3351666087/solar-vest/research/toolchain-survey.md

# Survey of 3D Model Sources and Command-Line PCB Toolchains

> **Date** 2026-10-08 · **Based on** the delivered-items list (CSV) + architecture v3 (6 V / 6 W rigid panel)
> **Markers** ✅ = I actually downloaded or ran it on this machine; 🔎 = documentation found only, not tested; 📏 = needs a dimension from you (calipers or nameplate)

---

## 0. Conclusions

| Question | Conclusion |
|---|---|
| Which 3D models can be found online directly? | **All chips and connectors can be found**, e.g. CN3791, INA226, LM66100, LM74700, AO3401, YJL3404A, SS34, JST-PH/XH. **The XIAO nRF52840 Sense has an official Seeed STEP** ✅. The AEM10941 chip has manufacturer CAD ✅ |
| Which must be built ourselves? | **None of the "module boards" or "complete items" have reliable official models**: panel, battery, supercapacitors, CN3791 module, INA226 module, EVK10941, the BITalino and its enclosure, electrodes, plus the backplate, enclosures and vest. Their shapes are simple; **given dimensions, they can be built in code**, and I have already verified this route on this machine ✅ |
| Can the PCB be developed on a command-line platform? | **Yes.** Recommended: **KiCad 10 + code-described circuit + Freerouting autorouting + kicad-cli to output every file**. Apart from "installing KiCad" and "sending the files for fabrication", everything else can be done by me from the command line |
| Can we get 3D of the PCB? | **Yes, and automatically.** `kicad-cli pcb export step/glb` exports the board together with the 3D of every component on it; the component models come from the two categories above |

**4 things you need to do** (details in Section 9):

1. Install KiCad 10 once (the sandbox blocks brew; you need to run it in a terminal).
2. Tell me the model of the lab's PCB-making machine.
3. Measure a few things with calipers (list in Section 2).
4. Choose a PCB toolchain.

---

## 1. Item-by-item list: where the 3D models come from

### 1.1 Delivered

| Item | Role in the system | 3D source | Status |
|---|---|---|---|
| **6 V / 6 W rigid solar panel** | Main energy source (back) | No generic model; outlines vary widely, so it must be built from the physical item | 📏 Nameplate and outline dimensions, thickness, junction box position, weight. Reference: the Voltaic/Adafruit 6 W panel is 220×175×5 mm, 225 g |
| 395×460 mm 18 V 30 W panel | Not used (bench spare) | Not modelled | — |
| **EVK10941** (AEM10941 evaluation board) | Low-light comparison branch | No 3D for the board; **the AEM10941 chip has manufacturer CAD** (Altium library + Eagle library + schematic snippets) ✅ downloaded. Evaluation board size 76×50 mm (e-peas/Mouser documentation); screw terminals from the official KiCad library | Can be built semi-automatically: board outline + terminals + chip |
| **523450 1000 mAh Li-ion battery** | Main energy storage | No official models for pouch cells | ✅ Built in code (5.2×34×50 mm + protection board), 📏 confirm against the physical item |
| **YJL3404A** | **Confirmed to be an N-channel MOSFET**: 30 V, 5.6 A, SOT-23 (Yangjie). Suitable as the level-shifting transistor for the P-MOS gate | Official KiCad SOT-23 model; LCSC has the same-series YJL3404AQ (C2942683) | 🔎 |
| **2.7 V 10 F supercapacitor ×3** | Hold-up during power loss in the chest unit | Radial electrolytic-capacitor outline, commonly 10×30 or 12.5×20 mm | ✅ Built in code, 📏 measure diameter, height, lead pitch |
| **BITalino ×2 + HeartBIT kit** | ECG acquisition / reference instrument | **No official 3D of the (r)evolution.** PLUX only gives outlines: (r)evolution Plugged about 100×65×6 mm, 3D-printed enclosure 111×69×18 mm. **The Eagle board layout and schematics of the older BITalino V3 are open source** ✅ (PIA-Group/schematics-bitalino); KiCad can import them, but it is not the (r)evolution you have | **Update (same day)**: BITalino officially published the (r)evolution Plugged enclosure STL on Thingiverse; I have built an LOD1 model of the Core board from Figure 8 of the manual. See [modeling/component-modeling-tutorial.md](../modeling/component-modeling-tutorial.md) |
| ECG sensor, PulseSensor and 700 mAh battery in the HeartBIT kit | Included with the kit | Simple geometry | 📏 |
| Disposable ECG electrodes | Attached to the chest | Disc + snap | 📏 Diameter |
| **TEUCER HP600 thermal silicone pad** | Thermal interface between the panel and the electronics (must not go between the panel and the skin) | A thin sheet | 📏 Thickness |
| K-type surface thermocouple ×2 | Thermal safety testing | Small probe; can be simplified to a small block | Optional |
| PH2.0 cables, Dupont wires, heat-shrink tubing and other consumables | Wiring | Cables generated by sweeping along the routing path | Not needed |
| Soldering station, multimeter, thermometer, wire strippers, USB tester, breadboard, board clamp | Tools | Not part of the system model | Not needed |

### 1.2 To be purchased (v3 §7)

| Item | 3D source | Status |
|---|---|---|
| **XIAO nRF52840 Sense ×3** | **Official Seeed STEP** ✅ downloaded (8.8 MB archive, `XIAO-nRF52840 v15.step`). KiCad symbol and footprint in Seeed's official GitHub library ✅. ⚠ The official STEP is Y-up and must be rotated 90° for assembly; I have handled this in the sample | Use directly |
| **CN3791 "6 V version" module ×3** | No reliable model for the module. **The CN3791 chip** (LCSC C154992, SSOP-10) has 3D on EasyEDA | Board outline from measurement, real model for the chip, 📏 measure the module. The 9 V version found online is 45×20×9.5 mm; the 6 V version may differ |
| **INA226 module ×4** | No reliable model for the module. **INA226 chip** (LCSC C49851) ✅ STEP downloaded | Same as above, 📏 |
| 1S 2500 mAh Li-ion battery | Build from the model's dimensions | 📏 Measure once bought |
| AO3401 / AO3400 | Official KiCad SOT-23; LCSC C15127 etc. | 🔎 |
| LM66100 (battery side) | LCSC C2869734, SC-70-6 | 🔎 |
| SS34, SMAJ8.5A | Official KiCad SMA footprint | 🔎 |
| LM74700 + N-MOS (Rev B) | LCSC C2941042, SOT-23-6 | 🔎 |
| PPTC / fuse, NTC | Official KiCad library | 🔎 |
| JST-XH / JST-PH connectors | Official KiCad library; JST-XH 2P (LCSC C158012) ✅ downloaded | Use directly |
| Reference cell ×2 | Small cells, build from dimensions | 📏 |
| Magnetic connector (J6 pull-out protection) | Find manufacturer CAD once the part number is chosen; major manufacturers usually provide STEP | Part number not yet chosen |
| ADS1292R / MAX86150 evaluation boards | 🔎 No downloadable 3D found (TI/ADI usually only provide schematics and Gerbers); build an envelope from the user guide's dimensions | 📏 |
| Vest, backplate, standoff feet, two enclosures | **Custom parts; must be designed ourselves.** Your body scan can be used as a dress form to fit the curved surface (last time we measured a panel bow height of 42 mm and standoffs of 18–28 mm) | Modelled in code by me |

### 1.3 Already verified for you

| Item verified | Result |
|---|---|
| Downloading the official Seeed XIAO STEP | ✅ Succeeded, imported into the assembly |
| `easyeda2kicad` fetching models by LCSC part number | ✅ INA226 (C49851) and JST-XH (C158012) succeeded. Downloads for the other part numbers were cut off by the sandbox network (IncompleteRead) and later rate-limited by the API (403). **The tool itself works**; it will not have this problem on your own computer |
| e-peas AEM10941 CAD package | ✅ Downloaded: Altium integrated library, PcbLib, Eagle library, schematic snippets, BOM |
| Building parametric models in code | ✅ Generated STEP files for the battery, supercapacitor, panel and the two modules with build123d 0.13 |
| Combining official and self-built models into an assembly | ✅ The "panel + battery + CN3791 module + XIAO" assembly exported to STEP and GLB (GLB can go straight into a web 3D viewer) |

Sample files are in [toolchain-samples/](toolchain-samples/). Every dimension in `parametric-models/parts.py` is a named parameter; once the physical item is measured, change one number.

---

## 2. Things we model ourselves: please measure these dimensions

| Item | Dimensions needed |
|---|---|
| 6 V 6 W panel | Length, width, thickness; whether it has a frame; junction box position and size; mounting holes; weight |
| 523450 battery (and later the 2500 mAh) | Length, width, thickness; length of the protection-board section; lead exit position |
| Supercapacitor | Diameter, height, lead pitch |
| CN3791 module, INA226 module | Board length and width; height of the tallest component; hole and terminal positions (one top-down photo with a ruler is enough) |
| EVK10941 | Check 76×50 mm, terminal orientation |
| BITalino (with enclosure) | Enclosure length, width, height; connector cut-out positions |
| Electrodes, reference cells, thermal pad | Diameter / length and width, thickness |

> For dimensions I am unsure of, I will use documented values first and flag them in the model; they will be replaced once the physical items are measured.

---

## 3. Which PCBs to make

Following the v3 split topology (ADR-007), there are 2 boards, plus 1 optional small board:

| Board | Location | Function | Complexity |
|---|---|---|---|
| **PMB-H** | Back | Panel input protection (fuse, TVS, diode) → CN3791 module; dual-battery switching; 4× INA226 (addresses 0x40 panel, 0x41 battery, 0x42 load, 0x44 reference cell); XIAO Sense; Q0 charge switch (on by default, to avoid a cold-start deadlock); NTC; J6 cable port | Moderate. **Rev A is built as a "module carrier board"**: CN3791, INA226 and XIAO all plug in as off-the-shelf modules, and the board itself only has connectors, MOSFETs and a few resistors and capacitors |
| **LIB** | Chest | Supercapacitor hold-up, load switch, sync-pulse injection into BITalino I1, ESD, JST-PH to the BITalino | Simple, about 25×20 mm |
| REF (optional) | Panel frame | Sense resistor and wiring for the reference cell | Minimal; can also be merged directly into the PMB-H |

All are 2-layer boards with low-speed signals; the finest parts are SOT-23 and 0603 passives, so **both the lab's PCB machine and JLCPCB can make them**.

---

## 4. Command-line PCB toolchains: findings

| Tool | What it does | Fully command-line? | Tested on this machine | Caveats |
|---|---|---|---|---|
| **KiCad 10** (released 2026-03-20) + `kicad-cli` | Industry-standard open-source EDA | **Output generation is fully command-line**: ERC, DRC, Gerber, drill, placement, BOM, plus **STEP / GLB / STL / VRML 3D export**, ray-traced rendering, jobset batch processing | ❌ Not installed on this machine | `kicad-cli` has **no** "update PCB from netlist" and **no** "export DSN / autoroute". These two steps need KiCad's built-in Python interface: the SWIG interface still works in 10 and will be removed in 11; the new IPC interface uses `kicad-python` 0.8 |
| **SKiDL** 2.3 | Write circuits in Python; generates the netlist and initial PCB | ✅ | Not tested | Fully offline, no account needed; auto-generated schematic layout is mediocre |
| **atopile** 0.15.9 | Declarative circuit language with automatic part selection; compiles to a KiCad PCB | ✅ `ato build` | ✅ **Compiled successfully and produced a `.kicad_pcb`**; but **automatic part selection requires login** (`ato auth login`), and newer versions are moving to app.atopile.io | Requires registering an account; **I cannot register for you** |
| **tscircuit** | Write circuits in TypeScript/React; **built-in autorouting**; exports Gerber, BOM, pick-and-place, GLB/STEP and KiCad files; can import parts by JLCPCB part number | ✅ `tsci` | ❌ **Could not be installed on this machine**: it requires **Node 24** (this machine has 22), and its image library dependency sharp downloads a binary from GitHub during installation, which the sandbox network blocks. It should work once Node 24 is installed on your own computer, but this is untested | Still at version 0.x and evolving quickly; risky for a switch-mode power board; well suited to a small board like the LIB |
| **Freerouting** v2.5.0 (2026-10-05) | Autorouter | ✅ `java -jar freerouting.jar -de x.dsn -do x.ses`; there is also an MCP server | Not tested | Java on this machine is 17; if that is not enough, use its macOS installer with the bundled runtime |
| **KiBot** 1.9 | Describes all outputs (Gerber, 3D, BOM, interactive BOM, renders) in a single config and rebuilds them with one command | ✅ | Not tested | Well suited to GitHub Actions, generating the full set of files on every commit |
| **easyeda2kicad** 1.0.1 / **JLC2KiCadLib** | Download symbols, footprints and **STEP/WRL 3D** by LCSC part number | ✅ | ✅ Downloaded successfully | The API is occasionally rate-limited |
| **KiCad MCP servers** (e.g. mixelpixx/KiCAD-MCP-Server) | Wrap KiCad as 100+ AI tools: place parts, route, DRC, export | ✅ | Not tested | Community projects of mixed quality; usable as a fallback, not required |
| **build123d** 0.13 / CadQuery | Write mechanical 3D in Python: panel, enclosures, backplate | ✅ | ✅ Generated STEP/GLB | — |
| JLCPCB EDA (EasyEDA), Flux.ai, Altium | GUI or browser tools | ❌ No command line | — | Not suitable for me to drive |
| JLCPCB ordering API | Upload Gerbers, get quotes, place orders | Has an API, but **only available to approved business customers** | — | Individuals still upload Gerbers on the website; you click this step |

---

## 5. Recommended pipeline

```
Circuit description (code, under Git)
   │  SKiDL (offline) or atopile (needs an account)
   ▼
Netlist + initial .kicad_pcb (all parts off-board, ratsnest only)
   │  Python placement script: mechanical constraints (board outline, holes, connector orientation) written as coordinates
   │  Switching loops (CN3791 periphery, shunt-resistor Kelvin traces) routed precisely by hand / script
   ▼
Freerouting autoroutes the remaining signal traces (DSN → SES)
   ▼
kicad-cli: if ERC / DRC fails, go back one step
   ▼
kicad-cli / KiBot outputs the full set:
   ├─ Gerber + drill → lab PCB machine or JLCPCB
   ├─ BOM + pick-and-place (if using contract assembly)
   ├─ PDF schematics, assembly drawings (for the supervisor and the lab)
   ├─ Rendered PNGs (which I use to self-check the layout)
   └─ STEP / GLB 3D (component models from Section 1)
   ▼
build123d final assembly: panel + backplate + PMB-H enclosure + cables + LIB enclosure + BITalino
   ▼
GLB → the existing 3D vest web page (replacing the current placeholder blocks)
```

**What I can and cannot do:**

- ✅ **I can**: write the circuit code; write placement and routing scripts; run autorouting and ERC/DRC; export all manufacturing files and 3D; produce renders for self-checking; do 3D modelling of all custom parts; do the final assembly and the web 3D.
- ❌ **You need to**: install KiCad; register an account (if choosing atopile); operate the lab's PCB machine; place and pay for the JLCPCB order; solder.
- ⚠ **Where quality will suffer**: the autorouter does not understand switch-mode power supplies. So the CN3791 power loop and the shunt-resistor Kelvin traces **must be routed precisely by script according to rules**, not left to Freerouting. After generating outputs I will attach renders, and you or the lab supervisor can take another look in the KiCad GUI.

---

## 6. Fabrication: lab machine vs. JLCPCB

| | Lab PCB machine | JLCPCB |
|---|---|---|
| Input | Depends on the machine type: a **CNC engraver** needs Gerber converted to G-code (pcb2gcode / FlatCAM, open source, not tested this time); **exposure / laser** needs a mirrored PDF or SVG (`kicad-cli pcb export pdf/svg` produces it directly) | Gerber zip archive, uploaded on the website |
| Capability | Unknown ❓. Without plated through-holes or solder mask, rules must be relaxed (trace width and clearance ≥ 0.3 mm, rivets for vias) | 2-layer / 4-layer, ENIG, solder mask all available; assembly service available |
| Lead time | Same day | 3–7 days |
| Recommendation | **Make the Rev A carrier board in the lab**: all large pads, quick to modify | **Send Rev B and the small LIB board to JLCPCB**: the small board needs higher precision, and since it is worn against the body it also needs solder mask and ENIG to resist sweat |

> **Please confirm: the brand and model of the lab's PCB machine.** A CNC engraver and an exposure/etching line need completely different design rules; I will set trace width, clearance and via method according to the machine's capability.

---

## 7. Combining into a full-system 3D model

1. Each part becomes one STEP: official models (Section 1 ✅), self-built models (Section 2), PCB exports (Section 5).
2. Assemble with build123d at the measured positions: panel upper and lower edges at 156.5 / 139.5 cm, standoffs 18–28 mm, J6 cable route.
3. Export GLB to replace the placeholder blocks in the existing 3D vest web page.

⚠ **Body model**: your scan or an inferred body can be used to fit the curved surface of the backplate, but that is your body-shape data. **I will ask you before publishing it to a web page**; a generic dress form is used by default.

---

## 8. Things verified or corrected along the way in this survey

| Item | Before | Now | Source |
|---|---|---|---|
| AEM10941 input limit | ⚠ "about ≤ 5 V, from memory" | ✅ **Open-circuit voltage up to 5.0 V**, cold start at 3 µW / 380 mV. Limitation 5 in v3 can be closed | e-peas website |
| AEM10941 package | v1 said QFN-40 | **QFN28 5×5 mm** (does not change the conclusion: it still cannot be hand-soldered) | e-peas website |
| YJL3404A | ❓ only known to be a MOSFET | **N-channel, 30 V / 5.6 A, SOT-23**, R<sub>DS(on)</sub> < 40 mΩ @ 4.5 V | Datasheet |
| HeartBIT kit | Contents unverified | Core BT/BLE, ECG sensor (30 cm leads), PulseSensor, (r)evolution enclosure, **700 mAh Li-ion battery**, 25 electrodes, USB cable, Bluetooth adapter | PLUX website |
| Armpit height → J6 cable length | 117 / 83 cm | 102 / 64 cm (corrected last time); the conclusion to buy 1.2 m is unchanged | Body scan |

---

## 9. Next steps: decisions needed from you

| # | Question | My recommendation |
|---|---|---|
| 1 | Which circuit-description tool? | **KiCad 10 + SKiDL**: fully offline, no account, and the resulting standard KiCad project can be opened in the GUI by both the lab and the supervisor. tscircuit needs Node 24 installed first; once installed I will try it on the small LIB board and roll it out if it works well. Choose atopile only if you are willing to register an account |
| 2 | Install KiCad 10 | Run `brew install --cask kicad` in a terminal (the sandbox won't let me install it). Once installed I will first run `kicad-cli version` to confirm |
| 3 | Model of the lab's PCB machine | Take a photo of the machine's nameplate or model number |
| 4 | Dimensions from Section 2 | Measure whatever you can; for anything not measured I will use documented values and flag them |

---

## References

- Seeed XIAO nRF52840 wiki page (including 3D model, KiCad project): https://wiki.seeedstudio.com/XIAO_BLE/
- Seeed official KiCad library: https://github.com/Seeed-Studio/OPL_Kicad_Library
- e-peas AEM10941 (datasheet, EVK manual, CAD package): https://e-peas.com/product/aem10941/
- PLUX HeartBIT: https://www.pluxbiosignals.com/products/heartbit
- PLUX (r)evolution 3D-printed enclosure: https://pluxbiosignals.com/products/3d-printed-casing-for-revolution-board
- BITalino V3 open-source board files: https://github.com/PIA-Group/schematics-bitalino
- LCSC: CN3791 C154992 https://www.lcsc.com/product-image/C154992.html ; INA226AIDGSR C49851 https://www.lcsc.com/product-image/C49851.html ; LM66100DCKR C2869734 https://fat.lcsc.com/product-image/C2869734.html ; LM74700QDBVRQ1 C2941042 https://fat.lcsc.com/product-detail/C2941042.html
- YJL3404AQ (JLCPCB C2942683): https://jlcpcb.com/partdetail/3323357-YJL3404AQ/C2942683 ; YJL3404A datasheet: https://static.chipdip.ru/lib/076/DOC013076228.pdf
- Adafruit 6 V 6 W panel (dimension reference): https://www.adafruit.com/products/1525
- KiCad 10 release: https://www.kicad.org/blog/2026/03/Version-10.0.0-Released/
- kicad-cli documentation: https://docs.kicad.org/10.0/en/cli/cli.html
- KiCad Python / IPC interfaces: https://dev-docs.kicad.org/en/apis-and-binding/pcbnew/
- KiBot 3D export: https://kibot.readthedocs.io/en/latest/configuration/outputs/export_3d.html
- atopile: https://pypi.org/p/atopile
- tscircuit: https://github.com/tscircuit/tscircuit
- easyeda2kicad: https://github.com/uPesy/easyeda2kicad.py
- Freerouting: https://github.com/freerouting/freerouting
- KiCad MCP Server: https://github.com/MJP-Sys/kicad-mcp-server , https://mcpservers.org/ja/servers/mixelpixx/kicad-mcp-server
- JLCPCB API documentation: https://api.jlcpcb.com/help/article/jlcpcb-online-api-available-now
