3351666087/solar-vest/hardware/vest/pattern_accessories_A4-tiled.pdf

## P1 胸前仓口袋（B）袋面+风琴边

500D ×1（四角剪口后折成立体袋），附件：口袋 / 内袋 / 面板遮挡罩

布纹线与布边平行，实线=裁剪线，蓝虚线=净缝线，包边处无缝份

P1 胸前仓口袋（B）袋面+风琴边 第 A1 页 / 共 1×1 ，灰虚线内 10 mm 为重叠区，对齐后粘贴，附件：口袋 / 内袋 / 面板遮挡罩

校验 50 × 50 mm（打印时选'实际大小'）

## P1 袋盖

500D ×2（正反合缝）+ 魔术贴 75×20，附件：口袋 / 内袋 / 面板遮挡罩

布纹线与布边平行，实线=裁剪线，蓝虚线=净缝线，包边处无缝份

P1 袋盖 第 A1 页 / 共 1×1 ，灰虚线内 10 mm 为重叠区，对齐后粘贴，附件：口袋 / 内袋 / 面板遮挡罩

校验 50 × 50 mm（打印时选'实际大小'）

## P2 HeartBIT 袋（A）袋面+风琴边

500D ×1，附件：口袋 / 内袋 / 面板遮挡罩

布纹线与布边平行，实线=裁剪线，蓝虚线=净缝线，包边处无缝份

P2 HeartBIT 袋（A）袋面+风琴边 第 A1 页 / 共 1×1 ，灰虚线内 10 mm 为重叠区，对齐后粘贴，附件：口袋 / 内袋 / 面板遮挡罩

校验 50 × 50 mm（打印时选'实际大小'）

## P2 袋盖

500D ×2 + 魔术贴，附件：口袋 / 内袋 / 面板遮挡罩

布纹线与布边平行，实线=裁剪线，蓝虚线=净缝线，包边处无缝份

P2 袋盖 第 A1 页 / 共 1×1 ，灰虚线内 10 mm 为重叠区，对齐后粘贴，附件：口袋 / 内袋 / 面板遮挡罩

校验 50 × 50 mm（打印时选'实际大小'）

## P3 Board 袋（C）袋面+风琴边

500D ×1，附件：口袋 / 内袋 / 面板遮挡罩

布纹线与布边平行，实线=裁剪线，蓝虚线=净缝线，包边处无缝份

P3 Board 袋（C）袋面+风琴边 第 A1 页 / 共 2×1 ，灰虚线内 10 mm 为重叠区，对齐后粘贴，附件：口袋 / 内袋 / 面板遮挡罩

校验 50 × 50 mm（打印时选'实际大小'）

布纹线与布边平行，实线=裁剪线，蓝虚线=净缝线，包边处无缝份

P3 Board 袋（C）袋面+风琴边 第 A2 页 / 共 2×1 ，灰虚线内 10 mm 为重叠区，对齐后粘贴，附件：口袋 / 内袋 / 面板遮挡罩

## P3 袋盖

500D ×2 + 魔术贴，附件：口袋 / 内袋 / 面板遮挡罩

布纹线与布边平行，实线=裁剪线，蓝虚线=净缝线，包边处无缝份

P3 袋盖 第 A1 页 / 共 1×1 ，灰虚线内 10 mm 为重叠区，对齐后粘贴，附件：口袋 / 内袋 / 面板遮挡罩

校验 50 × 50 mm（打印时选'实际大小'）

## P4 手机袋 袋面+风琴边

500D ×1，附件：口袋 / 内袋 / 面板遮挡罩

布纹线与布边平行，实线=裁剪线，蓝虚线=净缝线，包边处无缝份

P4 手机袋 袋面+风琴边 第 A1 页 / 共 1×1 ，灰虚线内 10 mm 为重叠区，对齐后粘贴，附件：口袋 / 内袋 / 面板遮挡罩

校验 50 × 50 mm（打印时选'实际大小'）

## P4 袋盖

500D ×2 + 魔术贴，附件：口袋 / 内袋 / 面板遮挡罩

布纹线与布边平行，实线=裁剪线，蓝虚线=净缝线，包边处无缝份

P4 袋盖 第 A1 页 / 共 1×1 ，灰虚线内 10 mm 为重叠区，对齐后粘贴，附件：口袋 / 内袋 / 面板遮挡罩

校验 50 × 50 mm（打印时选'实际大小'）

## P5 热电偶插头袋

500D ×1，附件：口袋 / 内袋 / 面板遮挡罩

布纹线与布边平行，实线=裁剪线，蓝虚线=净缝线，包边处无缝份

P5 热电偶插头袋 第 A1 页 / 共 1×1 ，灰虚线内 10 mm 为重叠区，对齐后粘贴，附件：口袋 / 内袋 / 面板遮挡罩

校验 50 × 50 mm（打印时选'实际大小'）

## P5 袋盖

500D ×2 + 魔术贴，附件：口袋 / 内袋 / 面板遮挡罩

布纹线与布边平行，实线=裁剪线，蓝虚线=净缝线，包边处无缝份

P5 袋盖 第 A1 页 / 共 1×1 ，灰虚线内 10 mm 为重叠区，对齐后粘贴，附件：口袋 / 内袋 / 面板遮挡罩

校验 50 × 50 mm（打印时选'实际大小'）

## P6 ECG 传感器内袋（里布侧）

弹力网布 ×1，三边车缝，开口朝上，附件：口袋 / 内袋 / 面板遮挡罩

布纹线与布边平行，实线=裁剪线，蓝虚线=净缝线，包边处无缝份

P6 ECG 传感器内袋（里布侧） 第 A1 页 / 共 1×1 ，灰虚线内 10 mm 为重叠区，对齐后粘贴，附件：口袋 / 内袋 / 面板遮挡罩

校验 50 × 50 mm（打印时选'实际大小'）

## 面板遮挡罩（TC-24 遮光 / TC-03b ND 网 / TC-21 面料）

每种面料各 ×1；四角车成盒角，边缘穿 3 mm 松紧绳，附件：口袋 / 内袋 / 面板遮挡罩

布纹线与布边平行，实线=裁剪线，蓝虚线=净缝线，包边处无缝份

面板遮挡罩（TC-24 遮光 / TC-03b ND 网 / TC-21 面料） 第 A1 页 / 共 3×2 ，灰虚线内 10 mm 为重叠区，对齐后粘贴，附件：口袋 / 内袋 / 面板遮挡罩

校验 50 × 50 mm（打印时选'实际大小'）

## 面板遮挡罩（TC-24 遮光 / TC-03b ND 网 / TC-21 面料）

每种面料各 ×1；四角车成盒角，边缘穿 3 mm 松紧绳，附件：口袋 / 内袋 / 面板遮挡罩

布纹线与布边平行，实线=裁剪线，蓝虚线=净缝线，包边处无缝份

面板遮挡罩（TC-24 遮光 / TC-03b ND 网 / TC-21 面料） 第 A2 页 / 共 3×2 ，灰虚线内 10 mm 为重叠区，对齐后粘贴，附件：口袋 / 内袋 / 面板遮挡罩

面板遮挡罩（TC-24 遮光 / TC-03b ND 网 / TC-21 面料） 第 A3 页 / 共 3×2 ，灰虚线内 10 mm 为重叠区，对齐后粘贴，附件：口袋 / 内袋 / 面板遮挡罩

面板遮挡罩（TC-24 遮光 / TC-03b ND 网 / TC-21 面料） 第 B1 页 / 共 3×2 ，灰虚线内 10 mm 为重叠区，对齐后粘贴，附件：口袋 / 内袋 / 面板遮挡罩

面板遮挡罩（TC-24 遮光 / TC-03b ND 网 / TC-21 面料） 第 B2 页 / 共 3×2 ，灰虚线内 10 mm 为重叠区，对齐后粘贴，附件：口袋 / 内袋 / 面板遮挡罩

面板遮挡罩（TC-24 遮光 / TC-03b ND 网 / TC-21 面料） 第 B3 页 / 共 3×2 ，灰虚线内 10 mm 为重叠区，对齐后粘贴，附件：口袋 / 内袋 / 面板遮挡罩
