3351666087/solar-vest/body/cross-sections_122_113_95.png

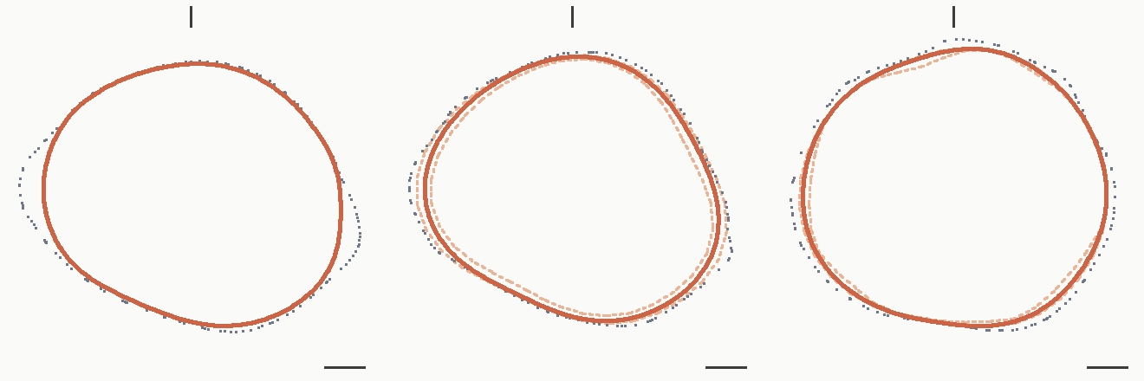
body/cross-sections_122_113_95.png
