3351666087/solar-vest/body/dressed-vs-bare_three-views.png

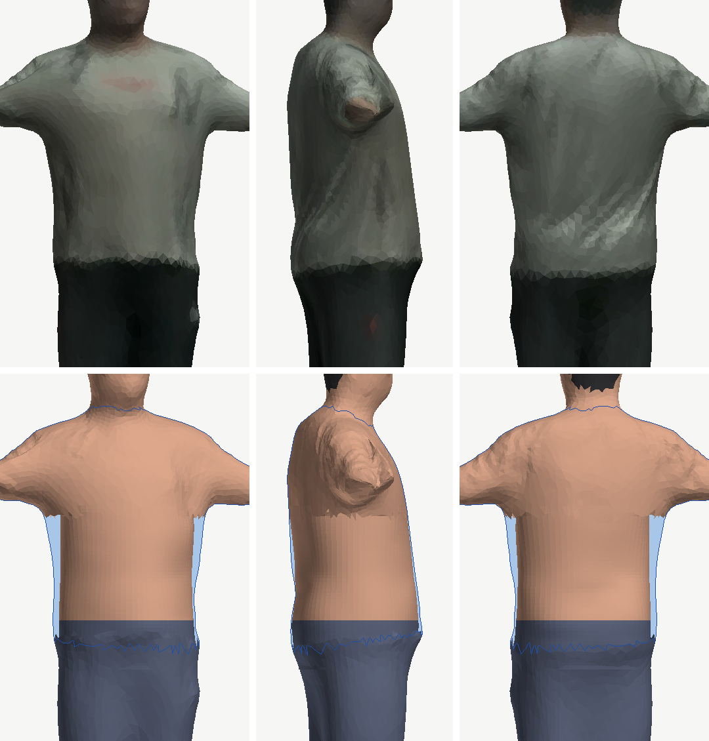
body/dressed-vs-bare_three-views.png
