3351666087/solar-vest/hardware/pcb/LIB_JLCPCB-final-placement_SMT2610130082.jpg

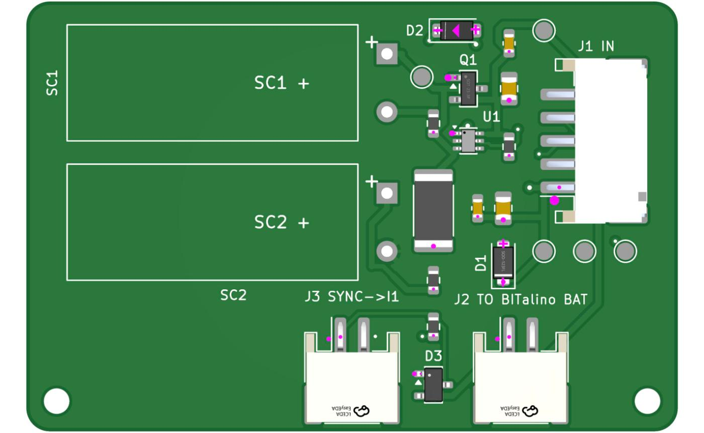
hardware/pcb/LIB_JLCPCB-final-placement_SMT2610130082.jpg
