3351666087/solar-vest/hardware/pcb/libb/libb_render_iso.png

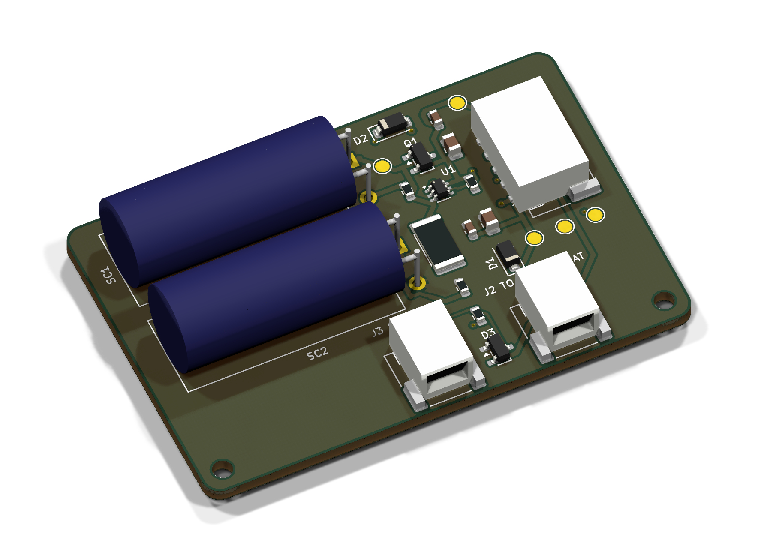
hardware/pcb/libb/libb_render_iso.png
