3351666087/solar-vest/hardware/pcb/libb/libb_render_top.png

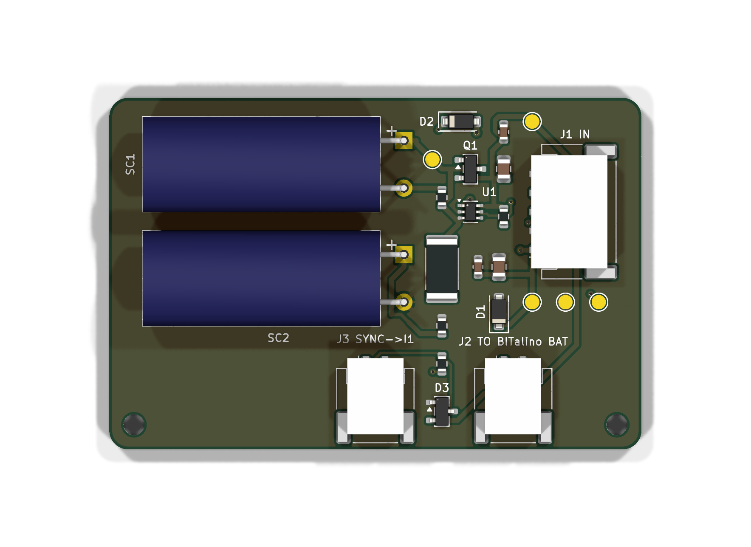
hardware/pcb/libb/libb_render_top.png
