3351666087/solar-vest/hardware/pcb/PMB-H_JLCPCB-final-placement_SMT2610130032.jpg

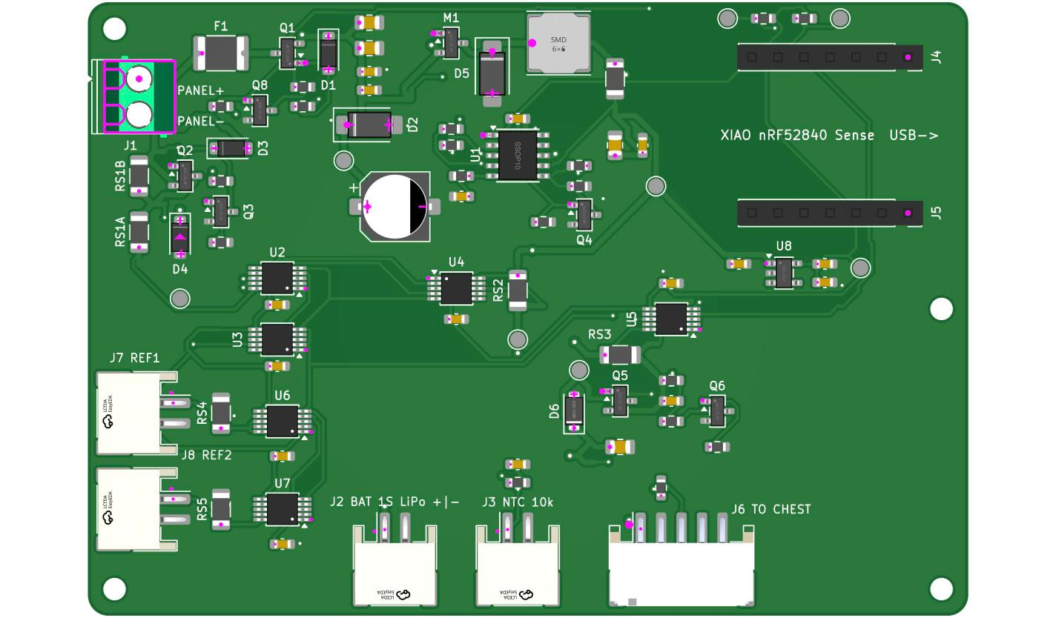
hardware/pcb/PMB-H_JLCPCB-final-placement_SMT2610130032.jpg
