3351666087/solar-vest/hardware/pcb/pmbh/pmbh_render_bottom.png

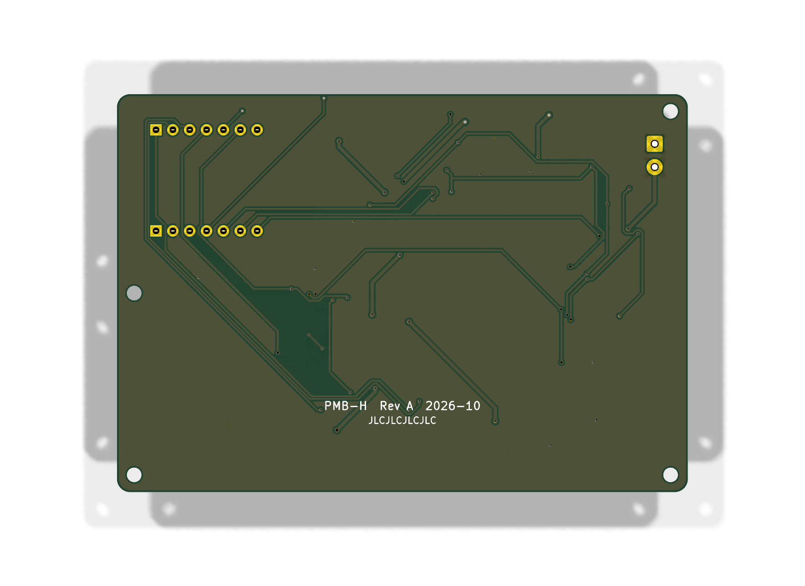
hardware/pcb/pmbh/pmbh_render_bottom.png
