3351666087/solar-vest/hardware/pcb/libb/libb_BOM_JLC.csv

Comment | Designator | Footprint | LCSC Part # | Qty | JLC library
22u 25V | C1,C3 | C_0805_2012Metric | C45783 | 2 | Basic
100n | C2,C4 | C_0603_1608Metric | C14663 | 2 | Basic
SMF5.0A | D1 | D_SOD-123F | C193402 | 1 | Extended
B5819W | D2 | D_SOD-123 | C8598 | 1 | Basic
BAT54S | D3 | SOT-23 | C47546 | 1 | Extended
PH2.0 5P | J1 | JST_PH_S5B-PH-SM4-TB_1x05-1MP_P2.00mm_Horizontal | C265104 | 1 | Extended
PH2.0 2P | J2,J3 | JST_PH_S2B-PH-SM4-TB_1x02-1MP_P2.00mm_Horizontal | C295747 | 2 | Extended
AO3401A | Q1 | SOT-23 | C15127 | 1 | Basic
100k | R1,R3,R4 | R_0603_1608Metric | C25803 | 3 | Basic
33 1W | R2 | R_2512_6332Metric | C53728 | 1 | Extended
1k | R5 | R_0603_1608Metric | C21190 | 1 | Basic
LM66100DCKR | U1 | SOT-363_SC-70-6 | C2869734 | 1 | Extended
