3351666087/solar-vest/hardware/pcb/pmbh/pmbh_BOM_JLC.csv

Comment | Designator | Footprint | LCSC Part # | Qty | JLC library
22u 25V | C1,C2,C7,C11 | C_0805_2012Metric | C45783 | 4 | Basic
1u 50V | C3,C10,C12,C13 | C_0603_1608Metric | C15849 | 4 | Basic
100n | C4,C5,C8,C9,C20,C30,C40,C50,C60,C70 | C_0603_1608Metric | C14663 | 10 | Basic
220n | C6 | C_0603_1608Metric | C21120 | 1 | Basic
10u 10V | C14 | C_0603_1608Metric | C19702 | 1 | Basic
100u 35V | C15 | CP_Elec_6.3x7.7 | C2836437 | 1 | Extended
BZT52C10 | D1,D3 | D_SOD-123 | C173431 | 2 | Extended
SMAJ10A | D2 | D_SMA | C134939 | 1 | Extended
B5819W | D4 | D_SOD-123 | C8598 | 1 | Basic
SS34 | D5 | D_SMA | C8678 | 1 | Basic
SMF5.0A | D6 | D_SOD-123F | C193402 | 1 | Extended
1.5A 16V | F1 | Fuse_1812_4532Metric | C883152 | 1 | Extended
KF350-3.5-2P | J1 | TerminalBlock_Phoenix_PT-1,5-2-3.5-H_1x02_P3.50mm_Horizontal | C474892 | 1 | Extended
PH2.0 2P | J2,J3,J7,J8 | JST_PH_S2B-PH-SM4-TB_1x02-1MP_P2.00mm_Horizontal | C295747 | 4 | Extended
PM254-1-07-Z-8.5 | J4,J5 | PinSocket_1x07_P2.54mm_Vertical | C2897370 | 2 | Extended
PH2.0 5P | J6 | JST_PH_S5B-PH-SM4-TB_1x05-1MP_P2.00mm_Horizontal | C265104 | 1 | Extended
22uH 1.8A | L1 | L_Sunlord_SWPA6045S | C83454 | 1 | Extended
AO3401A | M1,Q1,Q5 | SOT-23 | C15127 | 3 | Basic
AO3400A | Q2,Q3,Q4,Q6,Q8 | SOT-23 | C20917 | 5 | Basic
22k | R1 | R_0603_1608Metric | C31850 | 1 | Basic
100k | R2,R3,R7,R9,R10,R12,R14,R20 | R_0603_1608Metric | C25803 | 8 | Basic
120 | R4 | R_0603_1608Metric | C22787 | 1 | Basic
200k | R5 | R_0603_1608Metric | C25811 | 1 | Basic
51k | R6 | R_0603_1608Metric | C23196 | 1 | Basic
0.1 1W 1% | R8,RS3 | R_1206_3216Metric | C2903496 | 2 | Extended
10k | R11,R13 | R_0603_1608Metric | C25804 | 2 | Basic
1k | R15 | R_0603_1608Metric | C21190 | 1 | Basic
4.7k | R17,R18 | R_0603_1608Metric | C23162 | 2 | Basic
1M | R19 | R_0603_1608Metric | C22935 | 1 | Basic
0.05 1W 1% | RS2,RS1A | R_1206_3216Metric | C2904224 | 2 | Extended
0.47 1% | RS4,RS5 | R_1206_3216Metric | C28320 | 2 | Extended
0.22 1W 1% | RS1B | R_1206_3216Metric | C6627428 | 1 | Extended
CN3791 | U1 | SSOP-10_3.9x4.9mm_P1.00mm | C154992 | 1 | Extended
INA226AIDGSR | U2,U3,U4,U5,U6,U7 | MSOP-10_3x3mm_P0.5mm | C49851 | 6 | Extended
ME6211C33M5G-N | U8 | SOT-23-5 | C82942 | 1 | Extended
