3351666087/solar-vest/pdf/parts-en.txt

en-cover.xhtml en-part0P.xhtml en-part1L.xhtml en-part2P.xhtml
