3351666087/solar-vest/hardware/enclosures/c_case_base.step

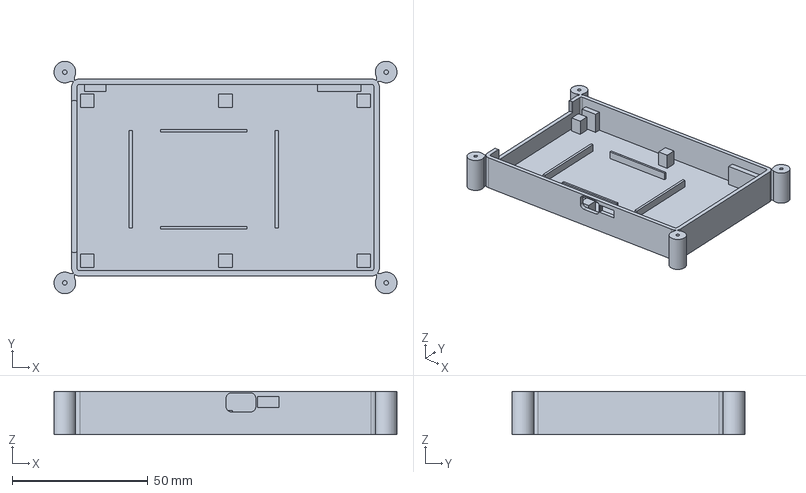
[picture p21: CAD file, 2026-10-21]
hardware/enclosures/c_case_base.step
126.5 x 85.7 x 16.0 mm
