3351666087/solar-vest/hardware/pcb/libb/libb.step

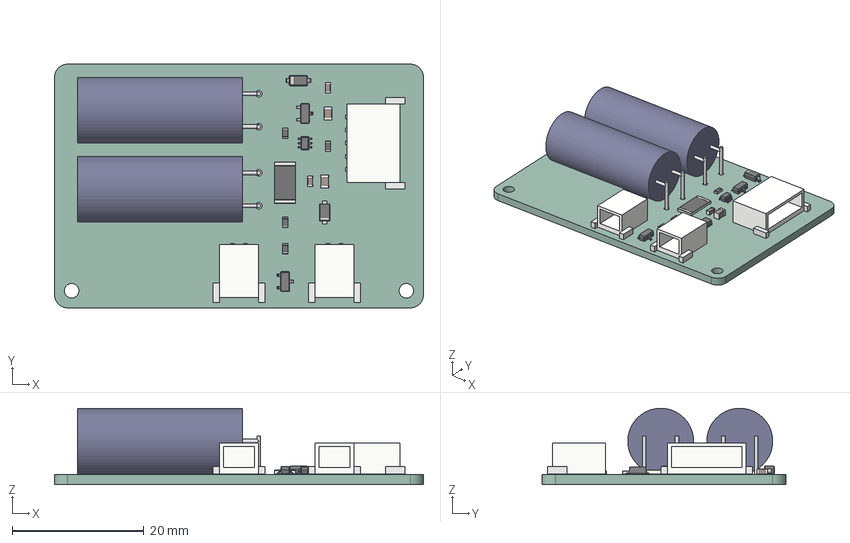
[picture p22: CAD file, 2026-10-21]
hardware/pcb/libb/libb.step
56.0 x 37.0 x 11.6 mm
C_0805_2012Metric x 2
R_0603_1608Metric x 4
C_0603_1608Metric x 2
SOT-23 x 2
D_SOD-123
R_2512_6332Metric
SOT-363_SC-70-6
D_SOD_123F
libb_PCB
