3351666087/solar-vest/hardware/pcb/pmbh/pmbh.step

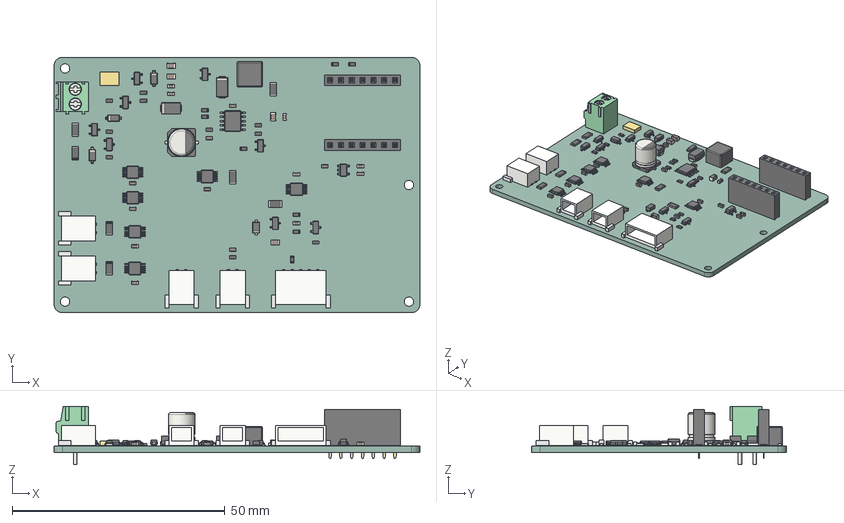
[picture p23: CAD file, 2026-10-21]
hardware/pcb/pmbh/pmbh.step
86.0 x 60.0 x 13.7 mm
R_0603_1608Metric x 18
C_0603_1608Metric x 16
D_SOD_123F
R_1206_3216Metric x 7
MSOP-10_3x3mm_P0.5mm x 6
D_SMA x 2
C_0805_2012Metric x 4
SOT-23 x 8
SSOP-10_3.9x4.9mm_P1.00mm
D_SOD-123 x 3
PinSocket_1x07_P2.54mm_Vertical x 2
CP_Elec_63x77
a6c163e6-8551-11ed-a139-00155d22e2d7_part
a6c16512-8551-11ed-a139-00155d22e2d7_part
a6c16594-8551-11ed-a139-00155d22e2d7_part
TerminalBlock_Phoenix_PT-1,5-2-3.5-H_1x02_P3.50mm_Horizontal
SOT-23-5
pmbh_PCB
