3351666087/solar-vest/hardware/vest/pattern_lining.dxf

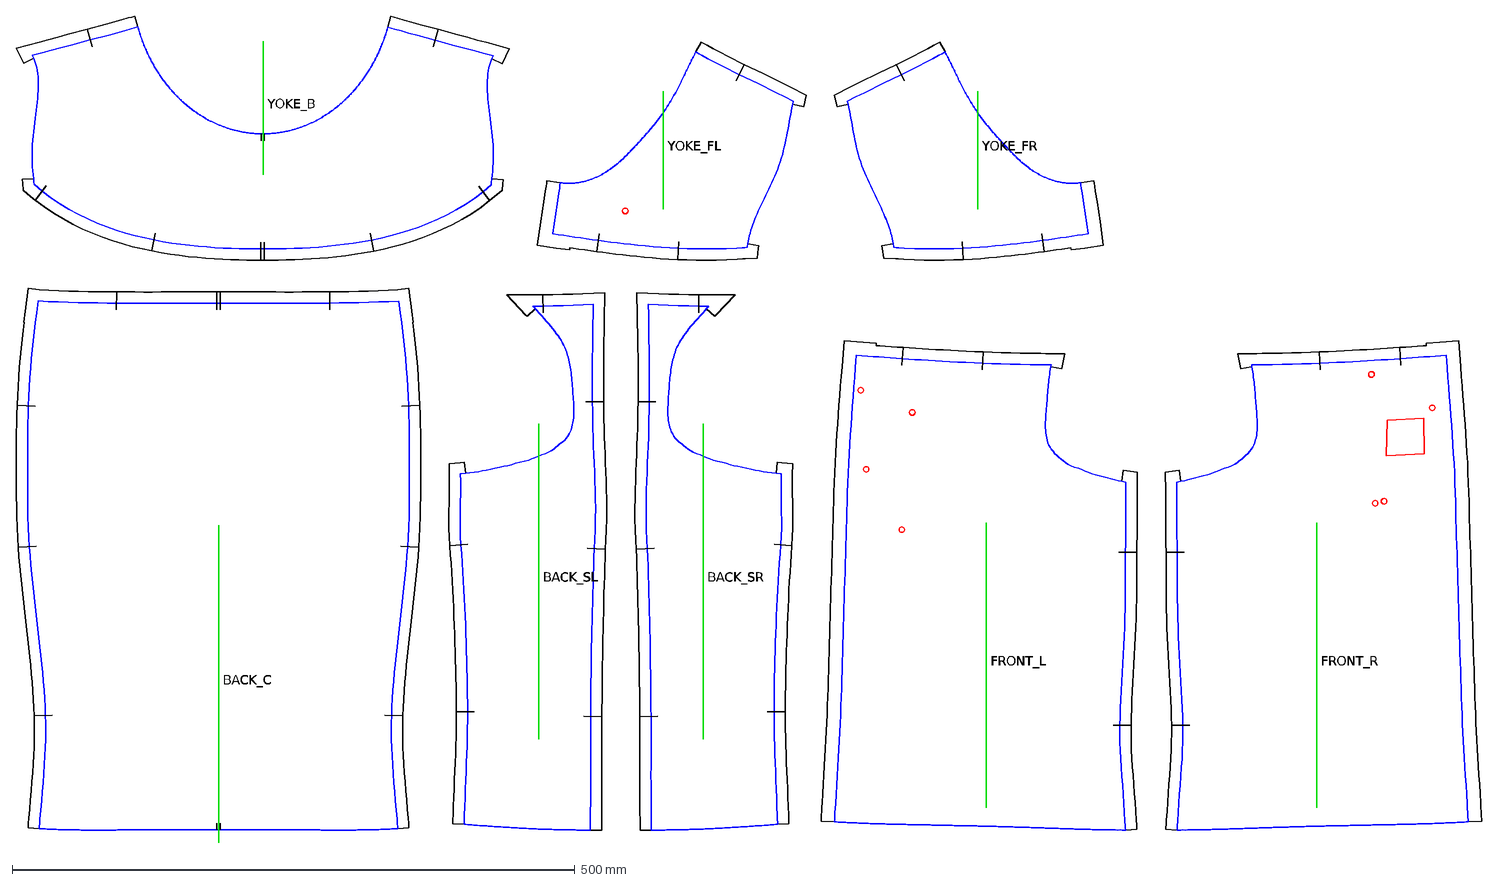
[picture p24: CAD file, 2026-10-21]
hardware/vest/pattern_lining.dxf
YOKE_B
BACK_C
BACK_SL
FRONT_L
YOKE_FL
BACK_SR
FRONT_R
YOKE_FR
