3351666087/solar-vest/modeling/bitalino-case_thingiverse-2286560/2_Plugged_Top_v1.2.stl

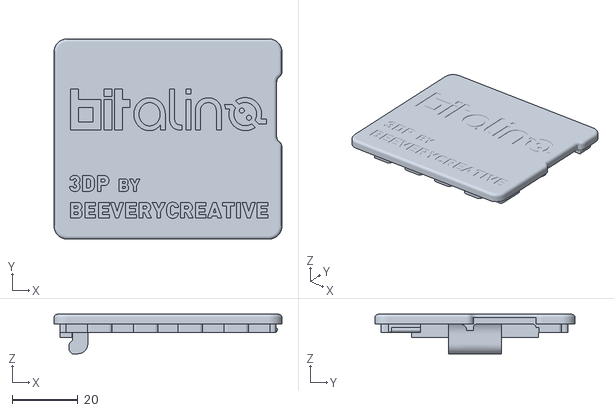
[picture p25: CAD file, 2026-10-21]
modeling/bitalino-case_thingiverse-2286560/2_Plugged_Top_v1.2.stl
69.2 x 60.8 x 12.0
