3351666087/solar-vest/modeling/heartbit-kit-models/official-stl/ecg_sensor_bot.stl

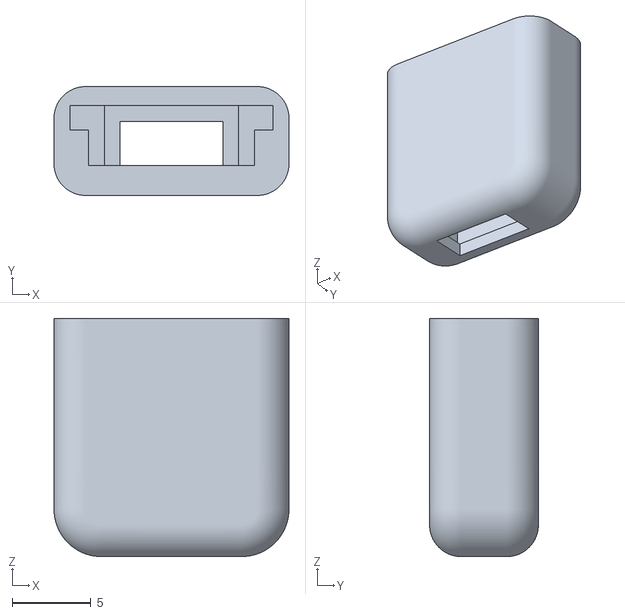
[picture p26: CAD file, 2026-10-21]
modeling/heartbit-kit-models/official-stl/ecg_sensor_bot.stl
14.9 x 6.90 x 15.1
