3351666087/solar-vest/modeling/panel_6V6W_photo.step

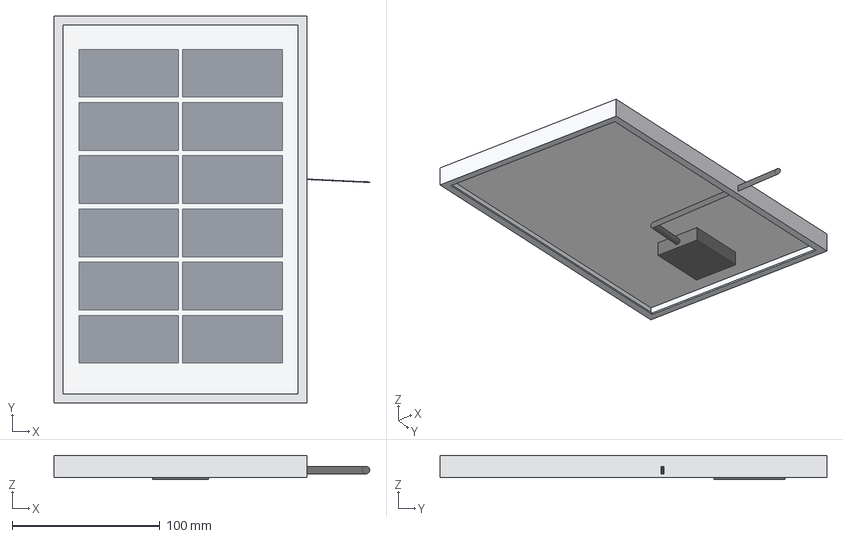
[picture p27: CAD file, 2026-10-21]
modeling/panel_6V6W_photo.step
213.5 x 261.8 x 16.4 mm
frame
backsheet
glass
junction_box
cable
