3351666087/solar-vest/research/toolchain-samples/parametric-models/panel_6V6W.step

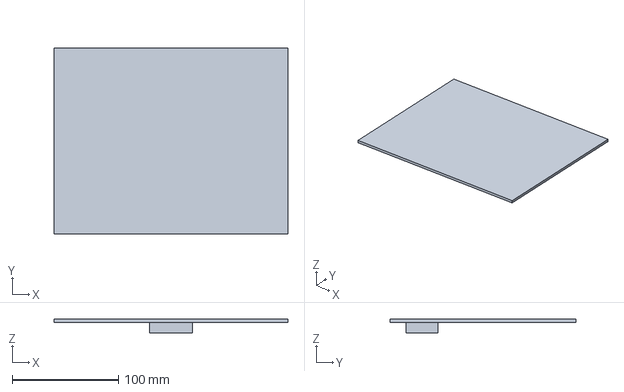
[picture p28: CAD file, 2026-10-21]
research/toolchain-samples/parametric-models/panel_6V6W.step
220.0 x 175.0 x 13.0 mm
