3351666087/solar-vest/hardware/enclosures/webbing_hook.step

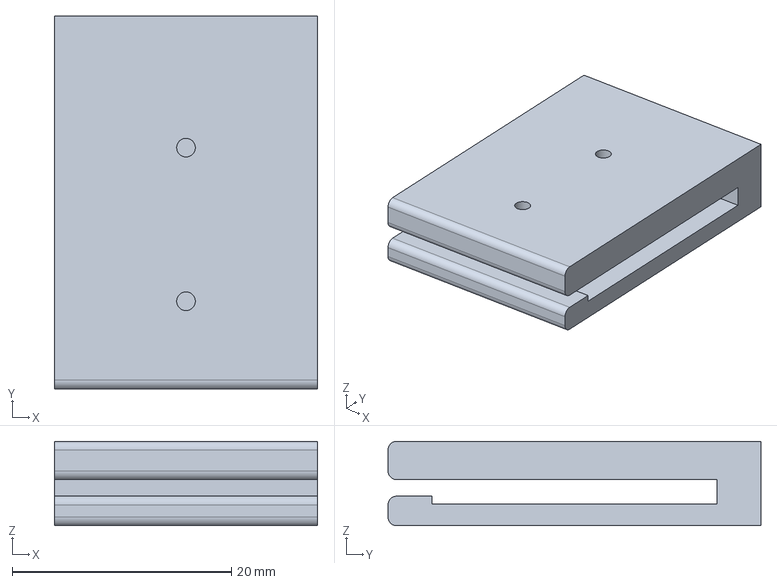
[picture p29: CAD file, 2026-10-21]
hardware/enclosures/webbing_hook.step
24.0 x 34.0 x 7.70 mm
