3351666087/solar-vest/hardware/vest/pattern_accessories.dxf

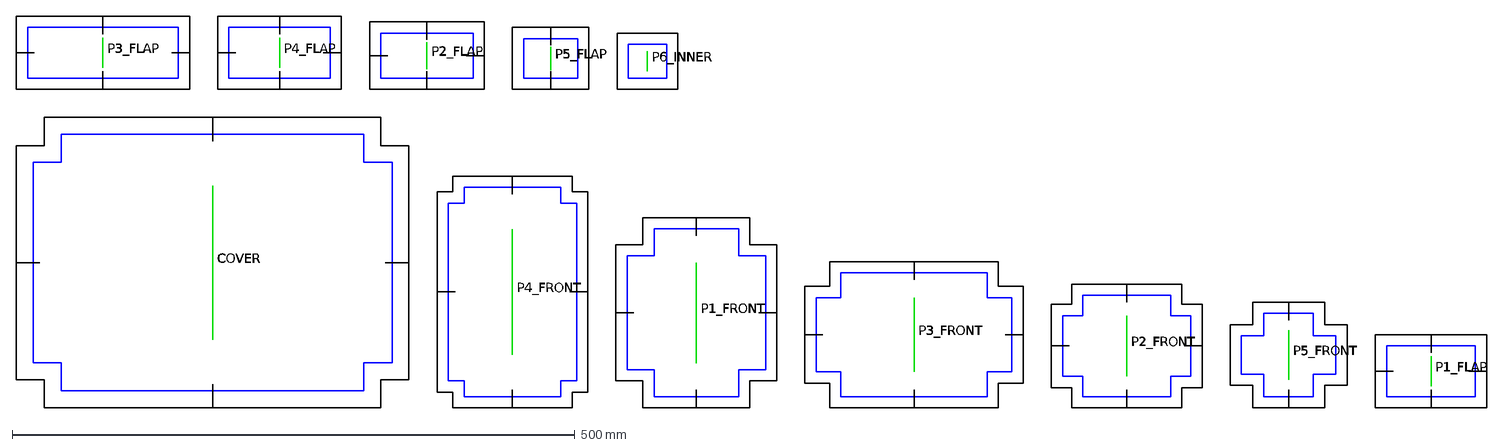
[picture p30: CAD file, 2026-10-21]
hardware/vest/pattern_accessories.dxf
P1_FRONT
P1_FLAP
P2_FRONT
P2_FLAP
P3_FRONT
P3_FLAP
P4_FRONT
P4_FLAP
P5_FRONT
P5_FLAP
P6_INNER
COVER
