3351666087/solar-vest/modeling/bitalino-case_thingiverse-2286560/1_Plugged_Bot_4.0.stl

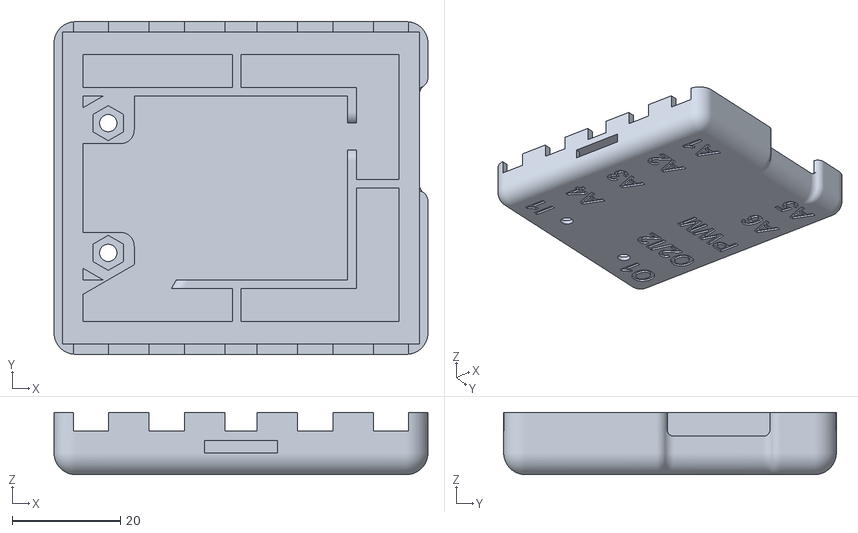
[picture p31: CAD file, 2026-10-21]
modeling/bitalino-case_thingiverse-2286560/1_Plugged_Bot_4.0.stl
69.2 x 61.6 x 11.5
