3351666087/solar-vest/modeling/heartbit-kit-models/official-stl/PulseSensor_Housing.stl

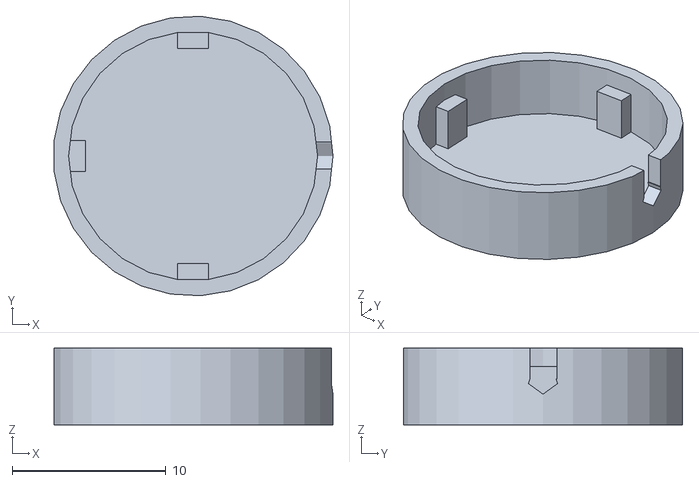
[picture p32: CAD file, 2026-10-21]
modeling/heartbit-kit-models/official-stl/PulseSensor_Housing.stl
18.1 x 18.2 x 5.00
