3351666087/solar-vest/modeling/supercap_10F_10x25.step

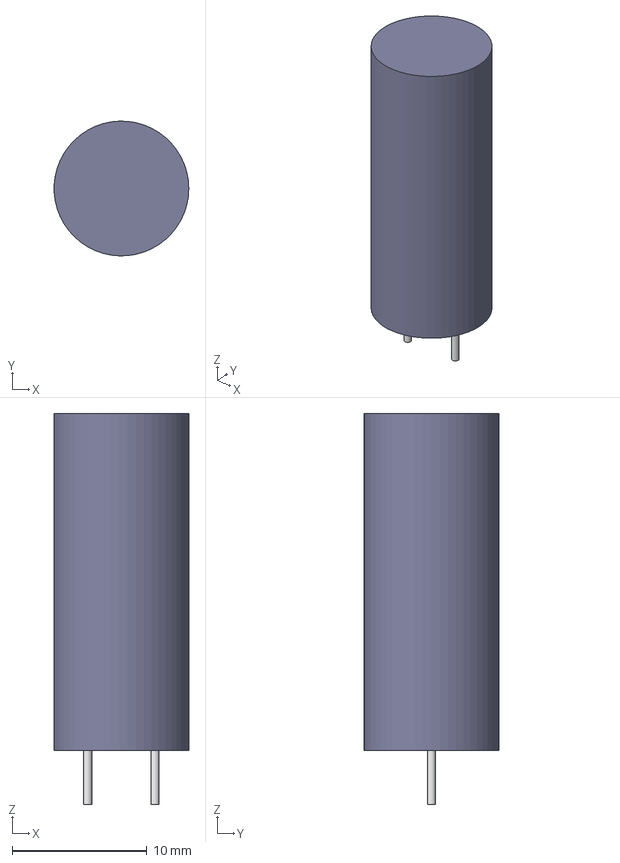
[picture p33: CAD file, 2026-10-21]
modeling/supercap_10F_10x25.step
9.99 x 10.00 x 29.0 mm
supercap_body
lead_neg
lead_pos
