3351666087/solar-vest/research/toolchain-samples/parametric-models/ina226_module.step

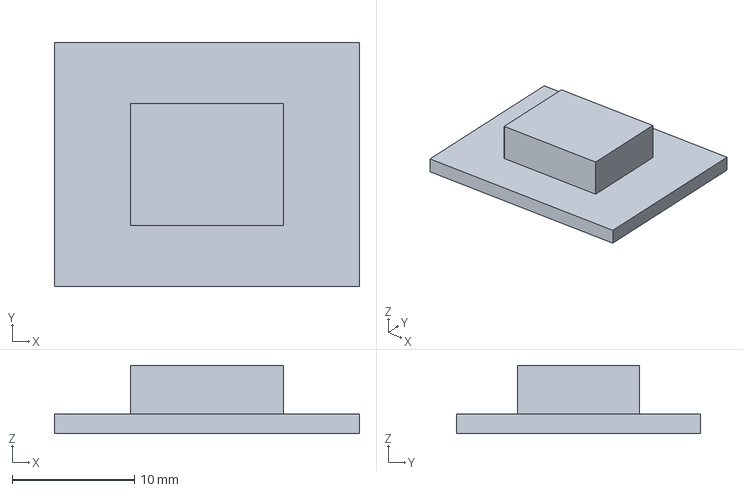
[picture p34: CAD file, 2026-10-21]
research/toolchain-samples/parametric-models/ina226_module.step
25.0 x 20.0 x 5.60 mm
