3351666087/solar-vest/hardware/enclosures/c_case_lid.step

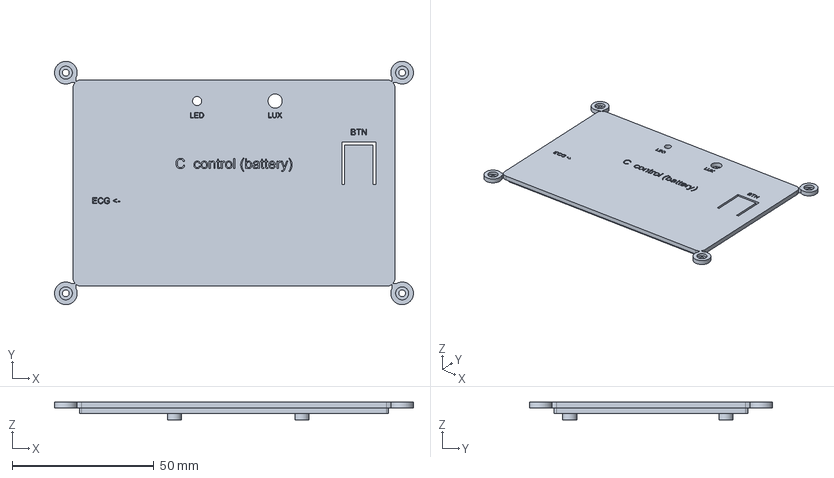
[picture p35: CAD file, 2026-10-21]
hardware/enclosures/c_case_lid.step
126.5 x 85.7 x 6.20 mm
