3351666087/solar-vest/hardware/vest/pattern_shell.dxf

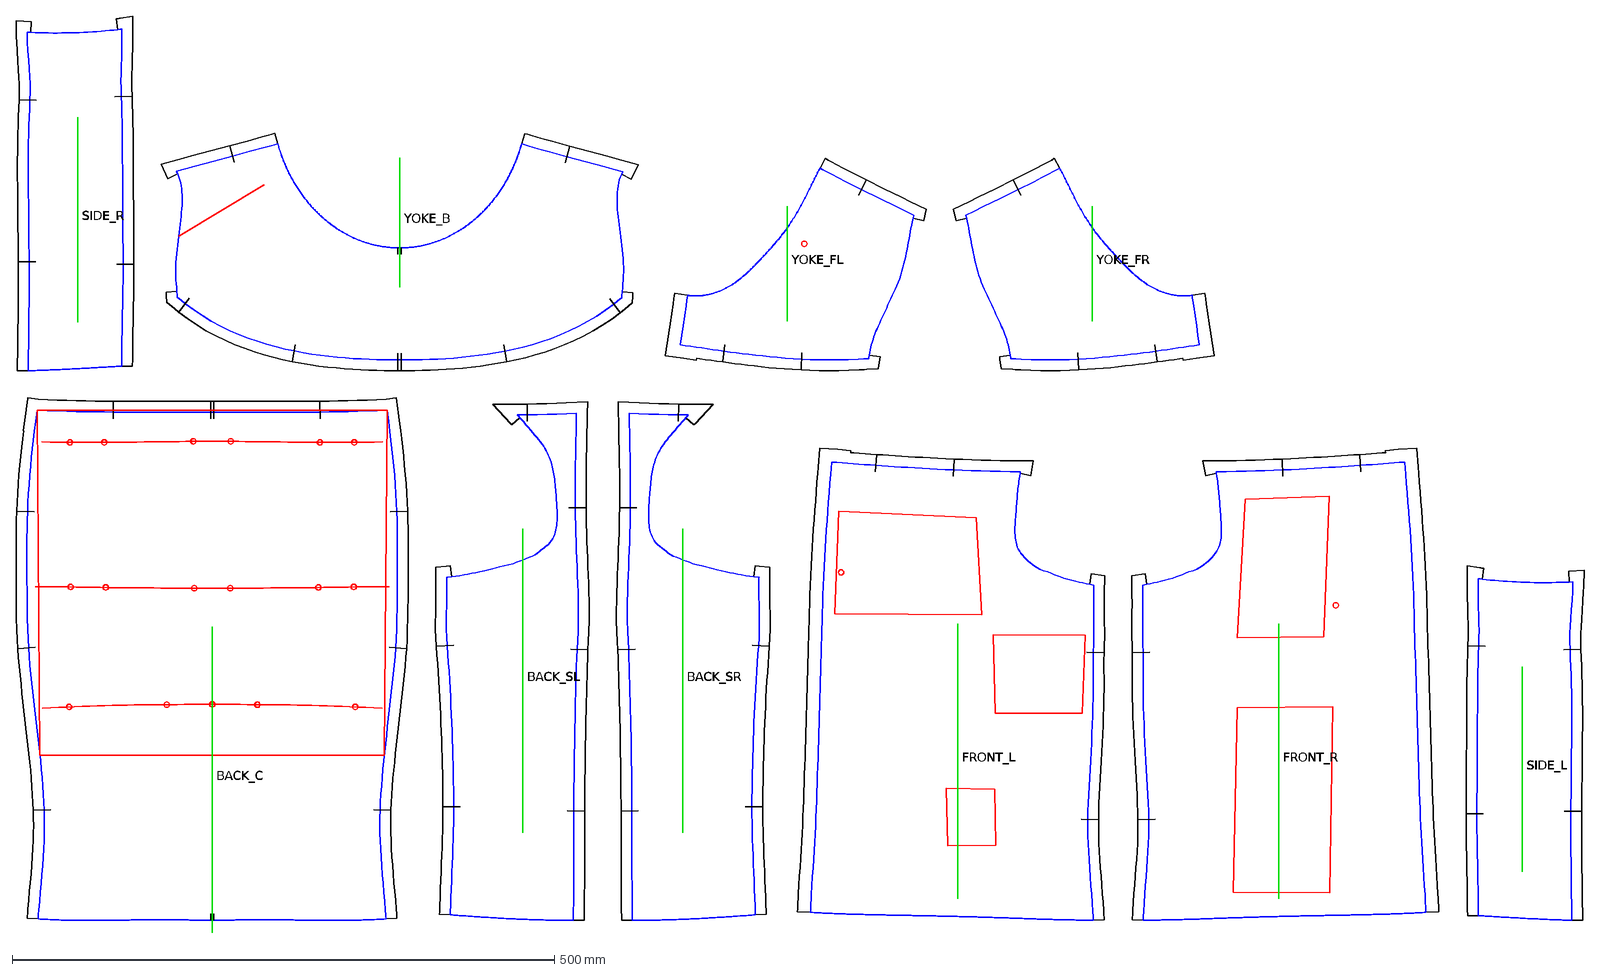
[picture p36: CAD file, 2026-10-21]
hardware/vest/pattern_shell.dxf
YOKE_B
BACK_C
BACK_SL
FRONT_L
YOKE_FL
SIDE_L
BACK_SR
FRONT_R
YOKE_FR
SIDE_R
