3351666087/solar-vest/modeling/bitalino-case_thingiverse-2286560/1_Plugged_Bot_v1.0_offset_0375.stl

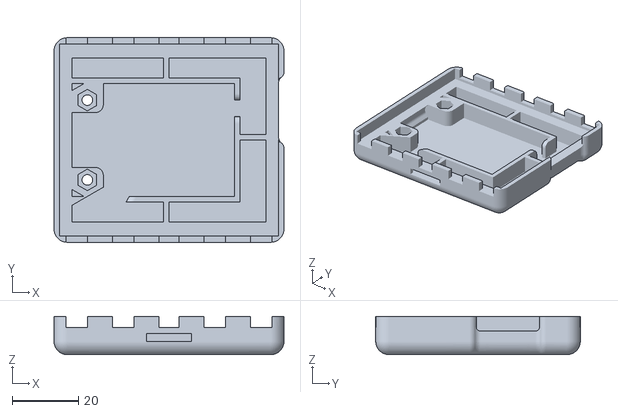
[picture p37: CAD file, 2026-10-21]
modeling/bitalino-case_thingiverse-2286560/1_Plugged_Bot_v1.0_offset_0375.stl
69.2 x 61.6 x 11.5
