3351666087/solar-vest/modeling/bitalino_core_LOD1.step

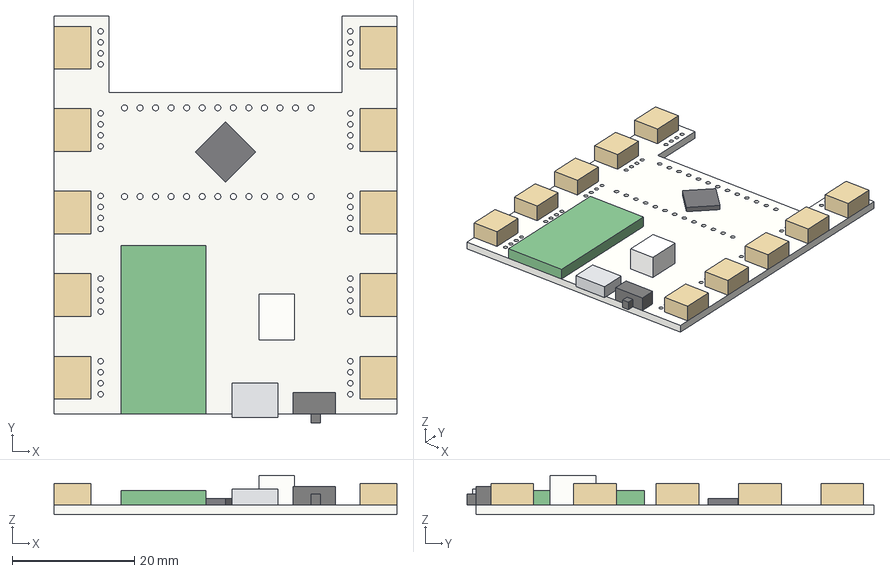
[picture p38: CAD file, 2026-10-21]
modeling/bitalino_core_LOD1.step
56.0 x 66.5 x 6.40 mm
pcb
bt_module
mcu
micro_usb
switch
bat_jst
