3351666087/solar-vest/research/toolchain-samples/parametric-models/cn3791_module.step

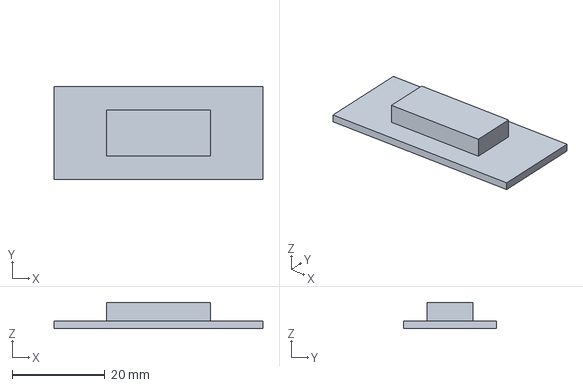
[picture p39: CAD file, 2026-10-21]
research/toolchain-samples/parametric-models/cn3791_module.step
45.0 x 20.0 x 5.60 mm
