3351666087/solar-vest/hardware/enclosures/chest_pod_lid.step

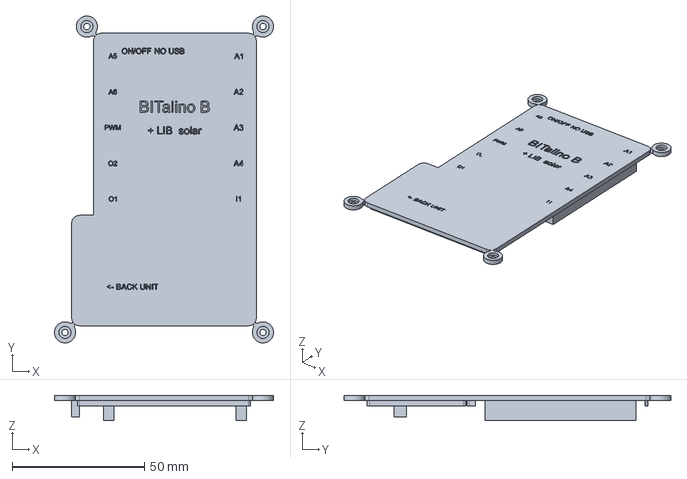
[picture p40: CAD file, 2026-10-21]
hardware/enclosures/chest_pod_lid.step
82.7 x 123.5 x 9.50 mm
