3351666087/solar-vest/research/toolchain-samples/parametric-models/supercap_10F.step

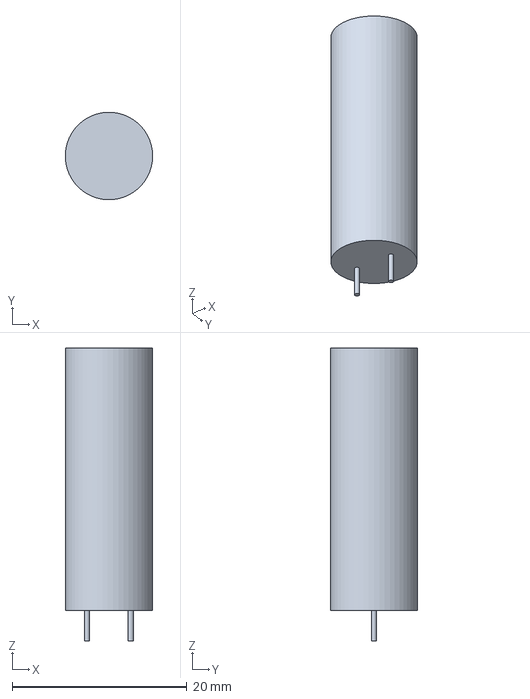
[picture p41: CAD file, 2026-10-21]
research/toolchain-samples/parametric-models/supercap_10F.step
9.99 x 10.00 x 33.5 mm
