3351666087/solar-vest/hardware/enclosures/back_pod_lid.step

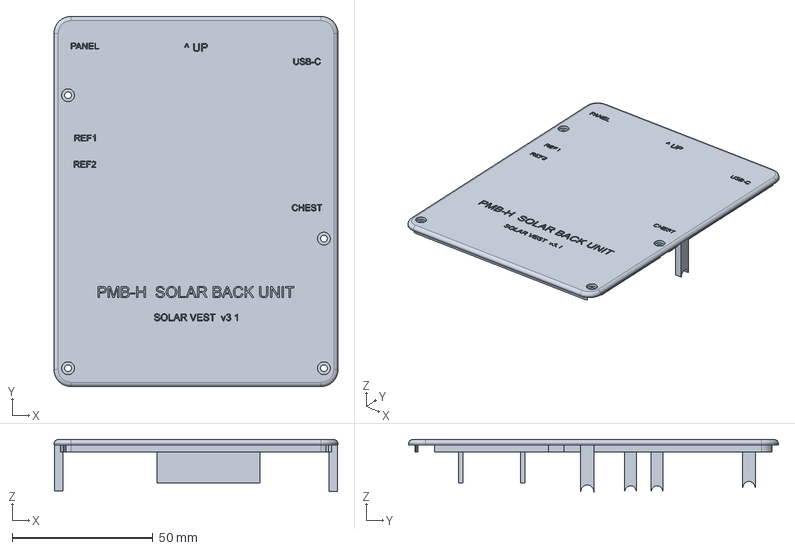
[picture p42: CAD file, 2026-10-21]
hardware/enclosures/back_pod_lid.step
101.0 x 131.6 x 18.5 mm
