3351666087/solar-vest/research/toolchain-samples/parametric-models/lipo_523450.step

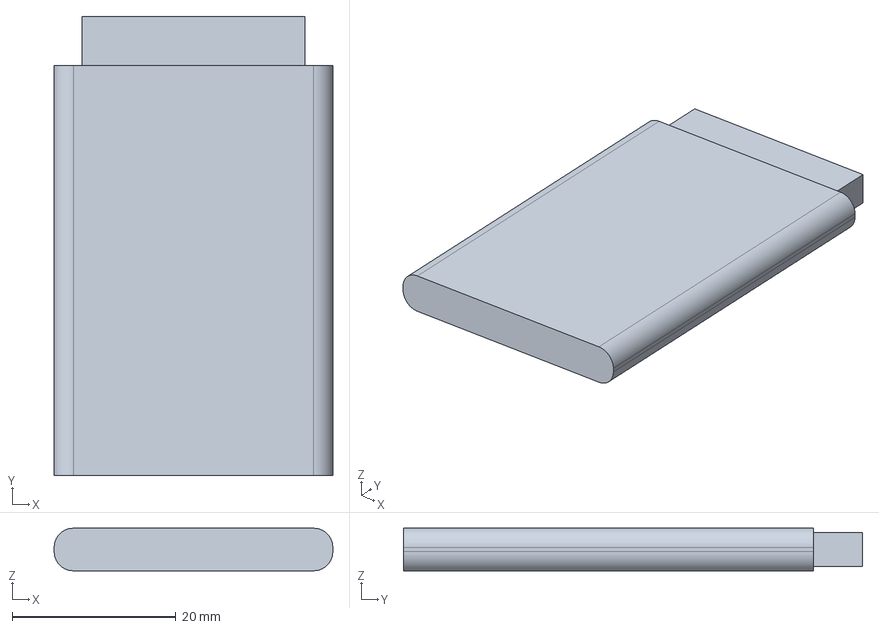
[picture p43: CAD file, 2026-10-21]
research/toolchain-samples/parametric-models/lipo_523450.step
34.0 x 56.0 x 5.20 mm
