3351666087/solar-vest/hardware/enclosures/panel_shoe_TL.step

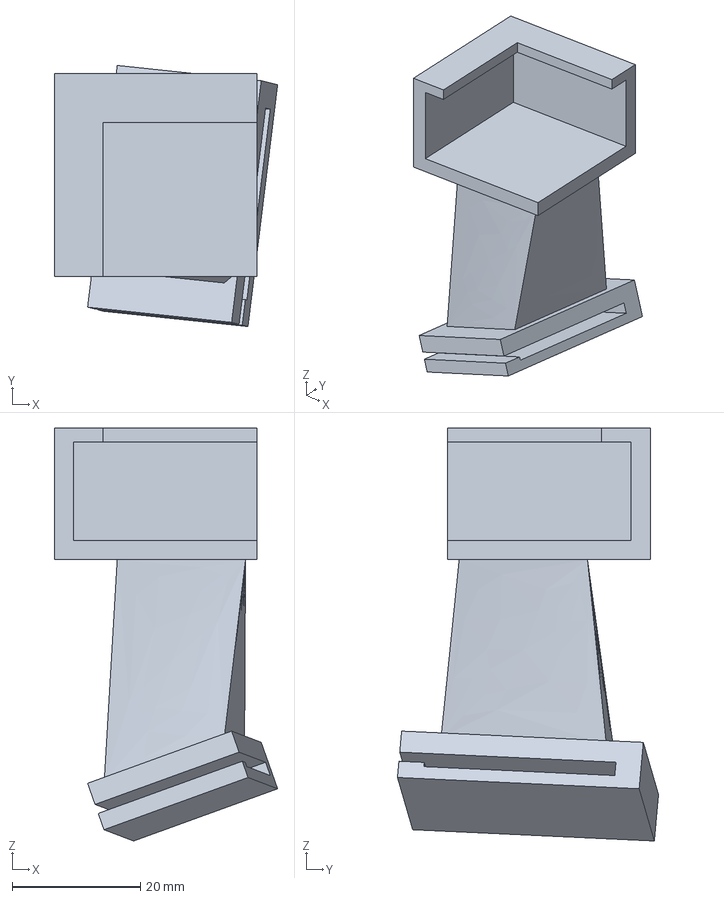
[picture p44: CAD file, 2026-10-21]
hardware/enclosures/panel_shoe_TL.step
34.8 x 40.7 x 64.4 mm
