3351666087/solar-vest/hardware/enclosures/stand_cradle.step

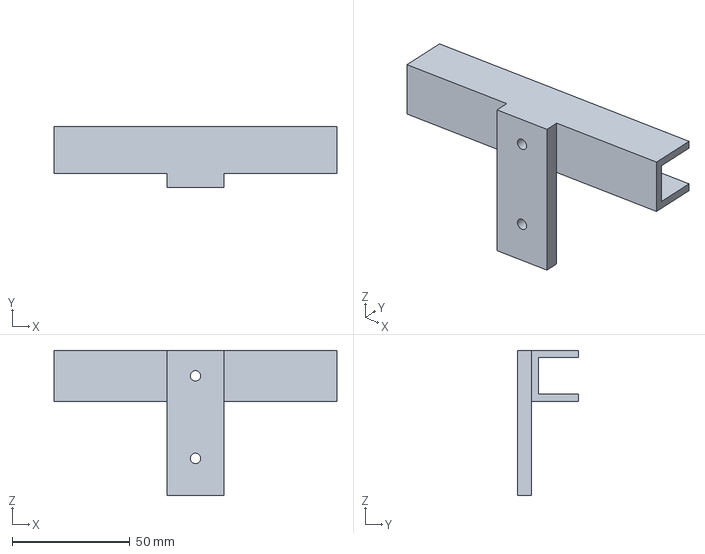
[picture p45: CAD file, 2026-10-21]
hardware/enclosures/stand_cradle.step
120.0 x 26.0 x 61.6 mm
