3351666087/solar-vest/hardware/enclosures/stand_base.step

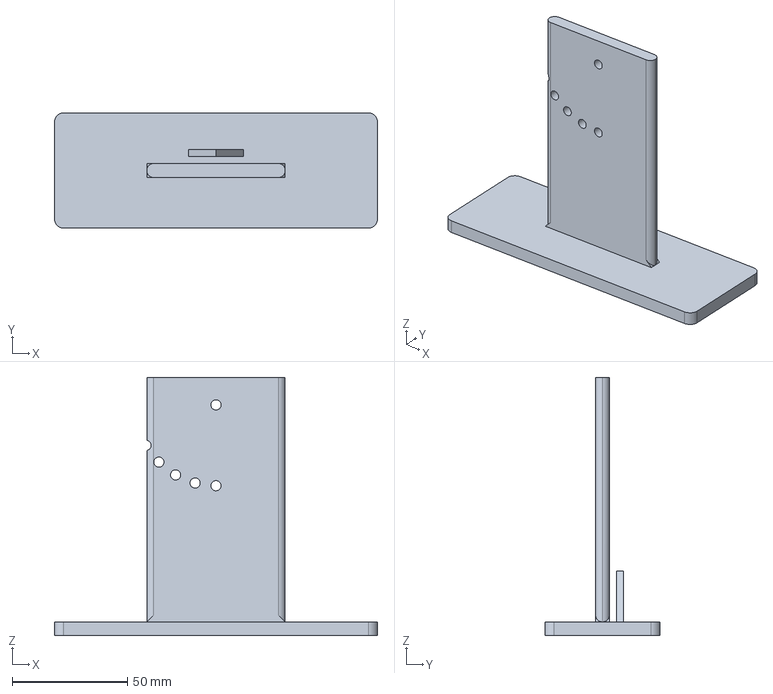
[picture p46: CAD file, 2026-10-21]
hardware/enclosures/stand_base.step
140.0 x 50.0 x 112.0 mm
