3351666087/solar-vest/hardware/enclosures/chest_pod_base.step

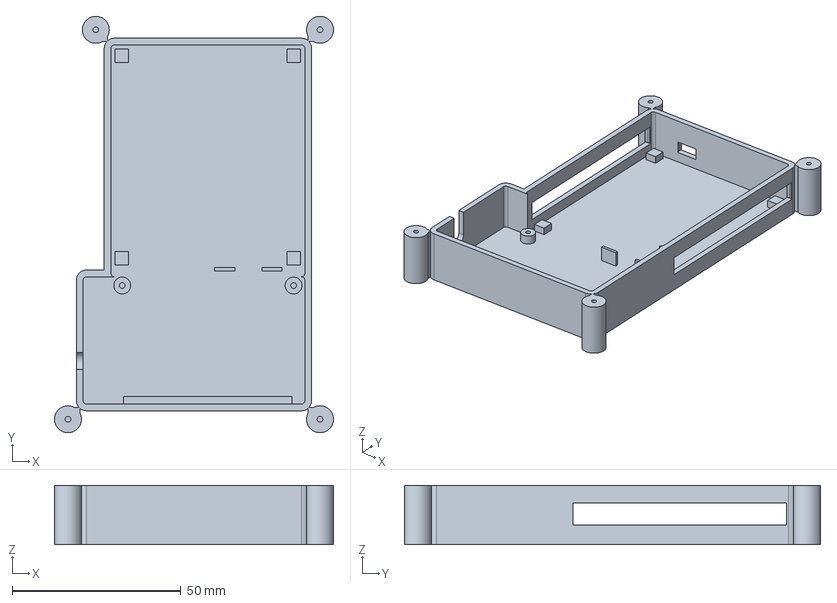
[picture p47: CAD file, 2026-10-21]
hardware/enclosures/chest_pod_base.step
82.7 x 123.5 x 17.6 mm
