3351666087/solar-vest/hardware/enclosures/back_pod_base.step

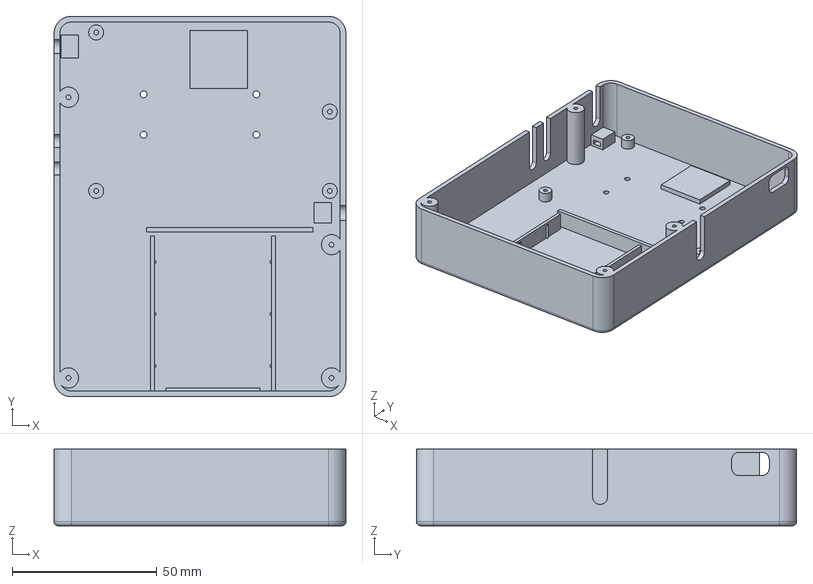
[picture p48: CAD file, 2026-10-21]
hardware/enclosures/back_pod_base.step
101.0 x 131.6 x 26.5 mm
