3351666087/solar-vest/hardware/enclosures/ref1_holder.step

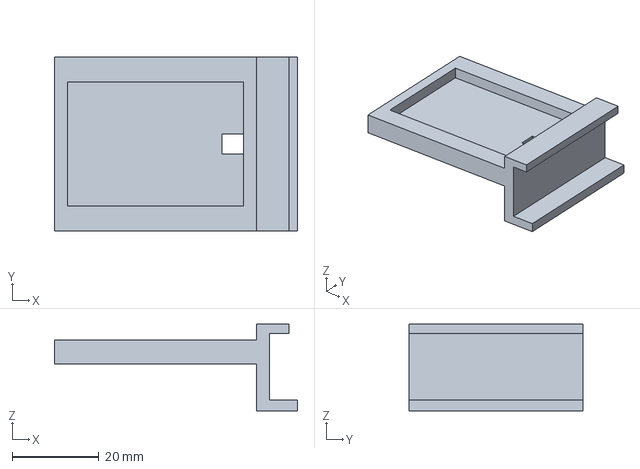
[picture p49: CAD file, 2026-10-21]
hardware/enclosures/ref1_holder.step
56.0 x 40.0 x 20.0 mm
