3351666087/solar-vest/hardware/enclosures/ref2_holder.step

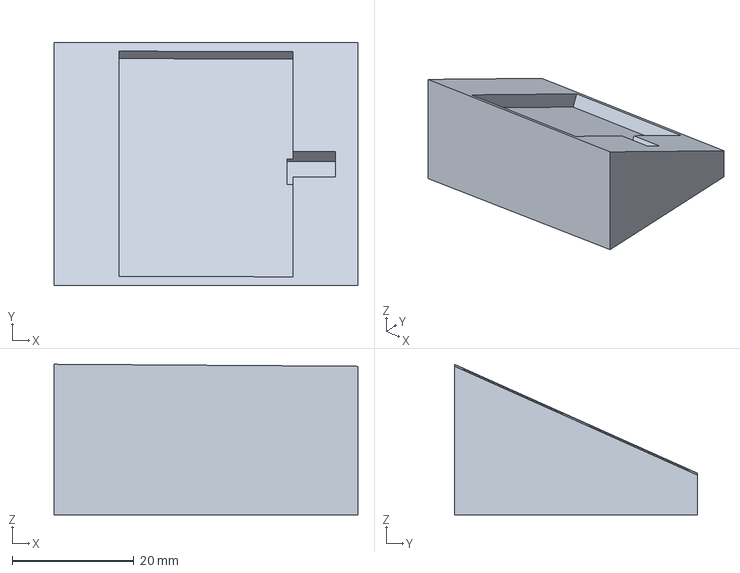
[picture p50: CAD file, 2026-10-21]
hardware/enclosures/ref2_holder.step
50.0 x 40.0 x 24.8 mm
