3351666087/solar-vest/hardware/enclosures/panel_shoe_BL.step

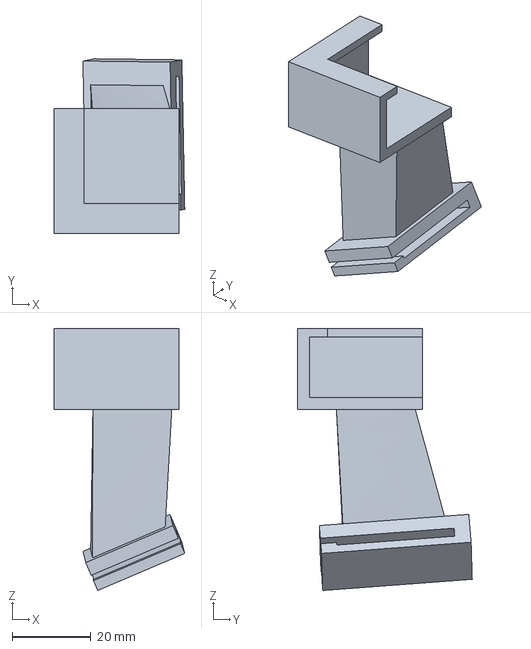
[picture p51: CAD file, 2026-10-21]
hardware/enclosures/panel_shoe_BL.step
33.1 x 44.2 x 66.4 mm
