3351666087/solar-vest/hardware/enclosures/ear_clip_pulsesensor.step

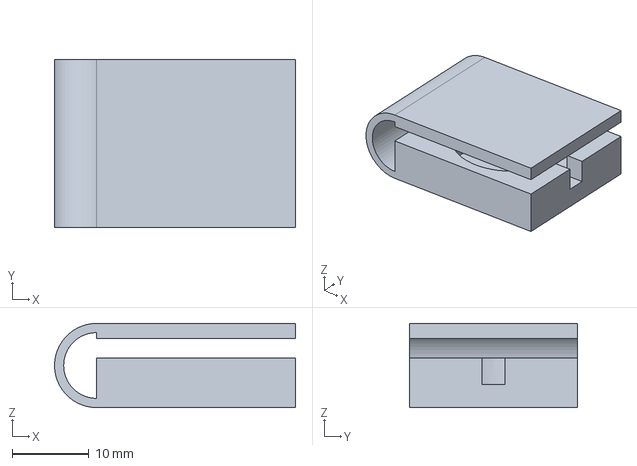
[picture p52: CAD file, 2026-10-21]
hardware/enclosures/ear_clip_pulsesensor.step
31.5 x 22.0 x 11.0 mm
