3351666087/solar-vest/hardware/enclosures/panel_shoe_TM.step

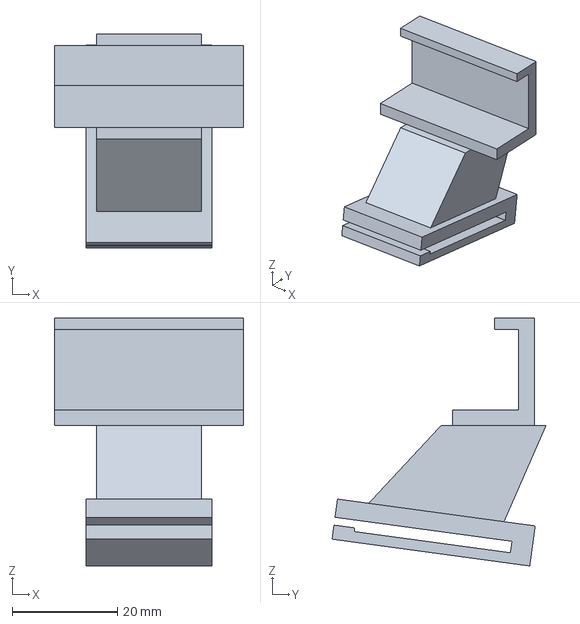
[picture p53: CAD file, 2026-10-21]
hardware/enclosures/panel_shoe_TM.step
36.0 x 40.7 x 47.2 mm
