3351666087/solar-vest/hardware/enclosures/panel_shoe_BM.step

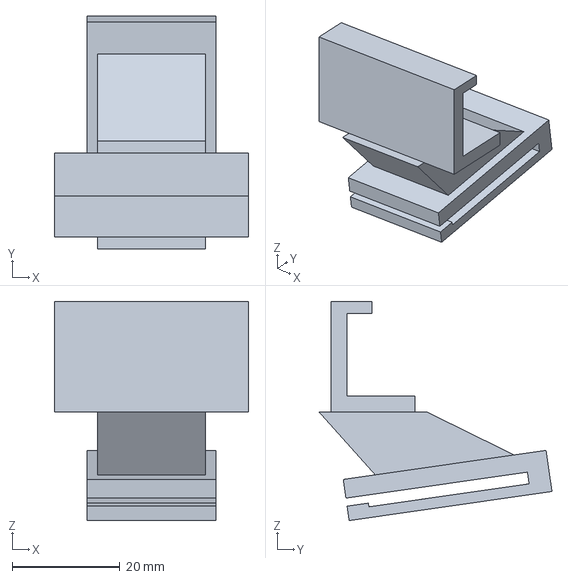
[picture p54: CAD file, 2026-10-21]
hardware/enclosures/panel_shoe_BM.step
36.0 x 43.2 x 40.6 mm
