3351666087/solar-vest/(list of files, cad)

Other CAD files:
modeling/heartbit-kit-models/official-stl/ecg_top.stl
hardware/enclosures/panel_shoe_TR.step
hardware/enclosures/panel_shoe_BR.step
hardware/enclosures/back_pod_base.3mf
hardware/enclosures/back_pod_base.stl
hardware/enclosures/back_pod_lid.3mf
hardware/enclosures/back_pod_lid.stl
hardware/enclosures/c_case_base.3mf
hardware/enclosures/c_case_base.stl
hardware/enclosures/c_case_lid.3mf
hardware/enclosures/c_case_lid.stl
hardware/enclosures/chest_pod_base.3mf
hardware/enclosures/chest_pod_base.stl
hardware/enclosures/chest_pod_lid.3mf
hardware/enclosures/chest_pod_lid.stl
hardware/enclosures/ear_clip_pulsesensor.3mf
hardware/enclosures/ear_clip_pulsesensor.stl
hardware/enclosures/panel_shoe_BL.3mf
hardware/enclosures/panel_shoe_BL.stl
hardware/enclosures/panel_shoe_BM.3mf
hardware/enclosures/panel_shoe_BM.stl
hardware/enclosures/panel_shoe_BR.3mf
hardware/enclosures/panel_shoe_BR.stl
hardware/enclosures/panel_shoe_TL.3mf
hardware/enclosures/panel_shoe_TL.stl
hardware/enclosures/panel_shoe_TM.3mf
hardware/enclosures/panel_shoe_TM.stl
hardware/enclosures/panel_shoe_TR.3mf
hardware/enclosures/panel_shoe_TR.stl
hardware/enclosures/ref1_holder.3mf
hardware/enclosures/ref1_holder.stl
hardware/enclosures/ref2_holder.3mf
hardware/enclosures/ref2_holder.stl
hardware/enclosures/stand_base.3mf
hardware/enclosures/stand_base.stl
hardware/enclosures/stand_cradle.3mf
hardware/enclosures/stand_cradle.stl
hardware/enclosures/webbing_hook.3mf
hardware/enclosures/webbing_hook.stl
