3351666087/solar-vest/hardware/wiring/wiring-guide.html

# SolarVest Wiring Guide

For bench bring-up: without wearing the vest, connect the back pod, chest pod, C and A together on the desk. Every wire is specified down to the pin. Socket positions and pin numbers on PMB-H and LIB are taken from the two boards’ KiCad files, positions inside the enclosures from the printed-part source code, and wire colours from the wiring table. Click any wire in the diagram and the panel on the right shows how to connect it.

1Three polarised connections have no reverse-polarity protection: battery into J2, W07 into Core B, W12 into C. Before plugging in, confirm polarity using the method on the wire’s card.

2The W06 5-core cable must be pin 1 to pin 1. Check it once with the continuity (beep) range before powering up; a reversed cable shorts the load output straight to ground.

3While electrodes are on a person, do not plug USB into the XIAO. With the Mac on its charger, the body would be connected to mains earth through USB.

## Overview

The system has 4 units and 14 wire groups (the W08 sync wire has been dropped in favour of software synchronisation). This diagram only shows what connects to what; block positions are schematic. For the real socket positions on the boards, see the three millimetre-scale drawings that follow.

## Back pod: PMB-H and battery

Top view with the lid removed — what you see when you open the grey box (PMB-H is not rotated in the pod, so the silkscreen reads upright). Scale 1 unit = 1 mm. Pads outlined in red are pin 1.

### PMB-H connector pinout

Connector | 1 | 2 | 3 | 4 | 5 | Wire
J1 screw terminal | PV_IN+ | PV_IN− | | | | W01
J2 PH2.0 | BAT+ | GND | | | | W02
J3 PH2.0 | NTC_ADC | GND | | | | W03
J7 PH2.0 | REF1+ | GND | | | | W04
J8 PH2.0 | REF2+ | GND | | | | W05
J6 PH2.0 5P | VLOAD | GND | SYNC | NC | GND | W06

### XIAO socket (plug-in, no wiring needed)

XIAO pin | Net | Function / power-up default
D0 / A0 | NTC_ADC | Battery temperature
D1 | NTC_EN | High powers the NTC divider
D2 | SYNC_OUT | Sync pulse, via 1 kΩ to J6-3
D3 | LOAD_EN | High = power the chest unit; default off (pull-down)
D4 / D5 | SDA / SCL | 6 × INA226
D6 | CHG_INH | High = inhibit charging; default charging
D7 | RANGE_LO | High = indoor range for panel current; default high range
D8 / D9 | CHRG_N / DONE_N | Low = charging / fully charged
D10 | PV_EN | Low = disconnect panel at night; default on (pull-up)
3V3 / GND | 3V3 / GND | Supplied by on-board ME6211
5V | Not connected

### Test points

TP1 VPV · TP2 VSYS · TP3 BAT+ · TP4 VLOAD · TP5 3V3 · TP6 GND · TP7 SDA · TP8 SCL. When measuring voltages, always clip the black probe to TP6.

## Chest pod: LIB and Core B

Top view with the lid removed. LIB is rotated 180° in the pod, so its silkscreen reads upside down, and the drawing shows it upside down as well. Core B’s port positions match the lid engraving: right side, bottom to top, I1 / A4 / A3 / A2 / A1. It is fitted correctly when the switch and micro-USB are at the end away from LIB, next to the O1–A5 row (PLUX manual Fig. 12).

### LIB connector pinout

Connector | 1 | 2 | 3 | 4 | 5 | Wire
J1 ← back | VLOAD | GND | SYNC_IN | spare | GND | W06
J2 → Core battery socket | VBIT | GND | | | | W07
J3 | SYNC_OUT | GND | | | | unused

### Test points

TP1 VLOAD · TP2 VBIT · TP3 VSC (supercap top) · TP4 GND · TP5 spare. When measuring voltages, clip the black probe to TP4.

### Core B ports used

Battery socket | W07, from LIB J2. B does not use its own LiPo and is not plugged into USB
I1 | Not connected (software sync instead)
A2 | W09, HeartBIT ECG sensor
Others | Not connected

Core B’s battery socket is at the PWR end (the white 2P socket next to the switch and micro-USB), the farthest point from LIB, so W07 has to cross over the top of the Core. The socket position in the drawing is estimated from your photo, accurate to a few millimetres.

## C and A

C is the Board Kit with its own battery, serving as the control for B. A is an unmodified stock HeartBIT with only the PulseSensor connected. Neither goes through PMB-H.

### C (Board Kit)

W12 | 523450 battery → battery socket on the Board power block. Red = +. Check polarity once per the W12 card before plugging in
W11 | 3-lead electrode cable → left-hand ECG port (lid engraved ECG ←). Red C_IN+, black C_IN−, white C_REF
Others | EEG / EDA / EMG not connected

### A (HeartBIT Core BT)

W13 | Original PulseSensor cable → A3, ear clip on the left earlobe
Power | Own 700 mAh battery, unchanged
Data | Classic Bluetooth, paired with an Android phone or the Mac

### Temperature (W14 / W15)

The plugs of the two type-K thermocouples go only into the thermometer, never into any circuit board. TC1 is taped with aluminium-foil tape to the centre of the panel backsheet; TC2 goes on the vest surface under the panel (during bench work, on the desk or on clothing).

## Electrode positions

Subject viewed from the front: the subject’s left is on the right of the drawing. During bench work there is no vest; disposable electrodes go directly on these 6 positions. B and C are both lead I, offset vertically by 5 cm, with left/right-symmetric reference electrodes.

Electrode | Position | Lead | Connects to
B_IN+ | On left clavicle, 8.5 cm from midline | red | B’s ECG sensor
B_IN− | On right clavicle, 8.5 cm from midline | black | Same as above
B_REF | Right lower ribs (lower costal margin), 10 cm from midline | white | Same as above
C_IN+ | 5 cm directly below B_IN+ | red | C’s 3-lead cable
C_IN− | 5 cm directly below B_IN− | black | Same as above
C_REF | Left lower ribs, mirror of B_REF | white | Same as above

Clean the skin with an alcohol swab and let it dry before applying. Lead colours are fixed: red = IN+, black = IN−, white = REF (PLUX manual Table 2).

## Wire by wire

Wires marked “Bench: required” are connected for this bring-up; “optional” wires can be left off and bring-up still completes; “On-body only” wires are connected once the vest is made.

## Bench bring-up: 11 steps

Work in order; move on only when the readings of each step are correct. Ticks are stored only in this device’s browser. The green text on the right is the expected reading. You need: multimeter, breadboard plus 1 PH2.0 straight-pin header, soldering station and heat-shrink, a Mac with Arduino IDE installed, an Android phone, disposable ECG electrodes.

0 / 0Clear ticks

## Test sketch

Used in step 5. It is for bring-up only: it scans the 6 INA226s, prints voltage, current and NTC temperature every second, and lets you toggle the load, panel, charging and sync pulse with serial commands. The load is off at power-up, matching the board’s hardware default. This is not the production firmware: no BLE and no thermal-protection logic.

Arduino IDE · board Seeed XIAO nRF52840 Sense · serial 115200Copy code

## Bench extra wiring (not on body)

These are temporary connections for experiments only; remove them afterwards.

ID | Purpose | How to connect | Notes
B01 | Lab supply replaces the panel | Red → J1-1 PV_IN+, black → J1-2 PV_IN− | 7.0 V, 1.0 A current limit, never above 9 V. Allows charging and firmware bring-up on cloudy days
B02 | TC-01 power consumption (A or C) | Battery + → breadboard → multimeter mA range in series → breadboard → device +; − straight through | Use 2 PH2mm straight-pin pre-wired leads + a straight-pin header. B need not be measured: INA226 0x42 measures it continuously
B03 | TC-02 panel I-V curve | Panel + → cement resistor → panel −; multimeter across the resistor reads voltage, I = V / R | Open circuit gives Voc; short circuit on the multimeter’s 10 A range gives Isc. Place REF1 coplanar with the panel to record irradiance
B04 | Charging and capacity | USB tester inserted in the A and C charging cables and the XIAO flashing cable | A and C are charged only when not worn

### How to make up the B03 resistances

What was bought is 10 each of 1 / 2.2 / 5 / 10 / 20 Ω (5 W); combine them in series to make the 9 planned steps:

Planned | Series | Actual
3.3 Ω | 1 + 2.2 | 3.2 Ω
4.7 Ω | 2.2 + 2.2 | 4.4 Ω
6.8 Ω | 2.2 + 2.2 + 2.2 | 6.6 Ω
10 Ω | 10 | 10 Ω
15 Ω | 10 + 5 | 15 Ω
22 Ω | 20 + 2.2 | 22.2 Ω
33 Ω | 20 + 10 + 2.2 + 1 | 33.2 Ω
68 Ω | 3 × 20 + 5 + 2.2 + 1 | 68.2 Ω
150 Ω | 7 × 20 + 10 | 150 Ω

When calculating current, use the series resistance measured with the multimeter, not the nominal value.

Data sources: hardware/wiring/wiring-table.md, harness.json; hardware/pcb/pmbh/pmbh.kicad_pcb, hardware/pcb/libb/libb.kicad_pcb; tools/cad/pmbh.py, libb.py, enclosures.py. The millimetre-scale parts of the drawings use board-file coordinates; for the Core B battery socket, the position of C’s power block and the actual wire colours, the physical hardware takes precedence.
