3351666087/solar-vest/hardware/vest/pattern_lining_A4-tiled.pdf

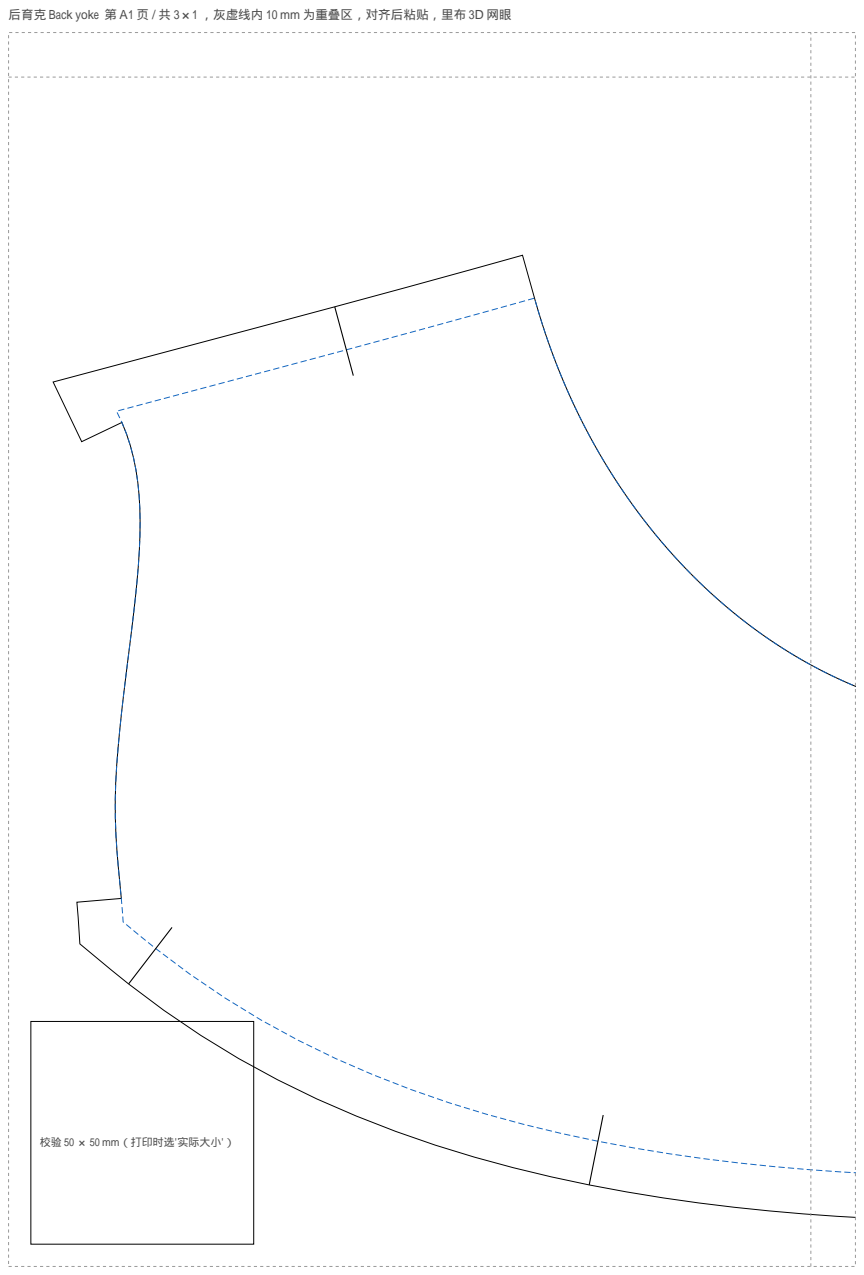
[picture p59: page 1]

后育克 Back yoke 第 A1 页 / 共 3×1 ，灰虚线内 10 mm 为重叠区，对齐后粘贴，里布 3D 网眼

校验 50 × 50 mm（打印时选'实际大小'）

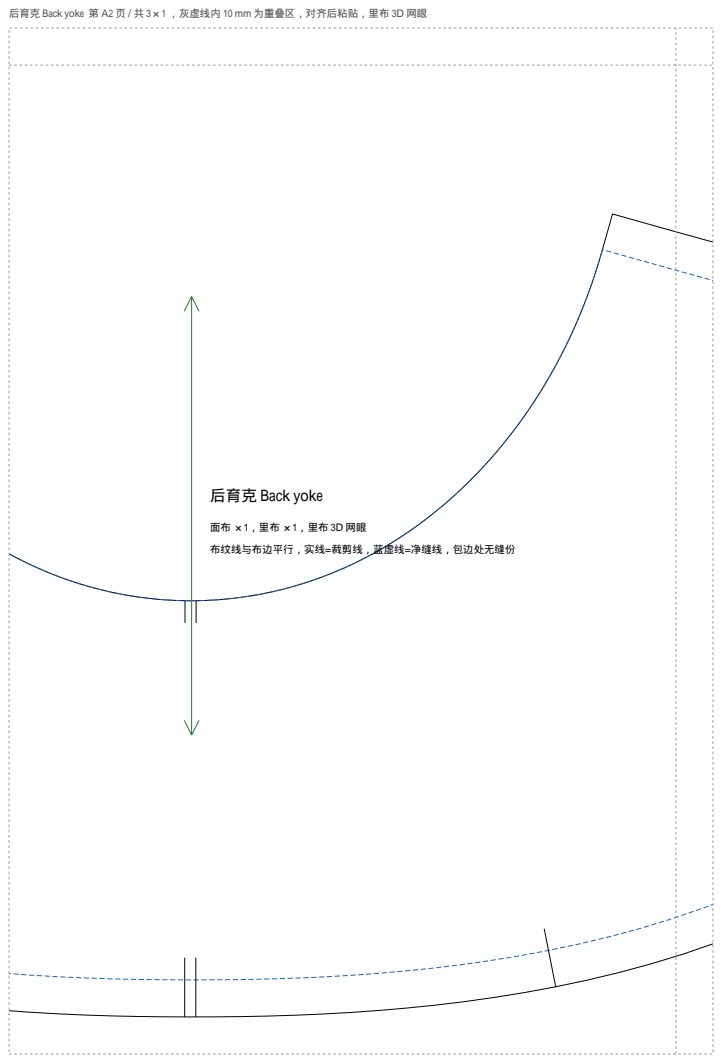
[picture p60: page 2]

后育克 Back yoke 第 A2 页 / 共 3×1 ，灰虚线内 10 mm 为重叠区，对齐后粘贴，里布 3D 网眼

后育克 Back yoke

布纹线与布边平行，实线=裁剪线，蓝虚线=净缝线，包边处无缝份

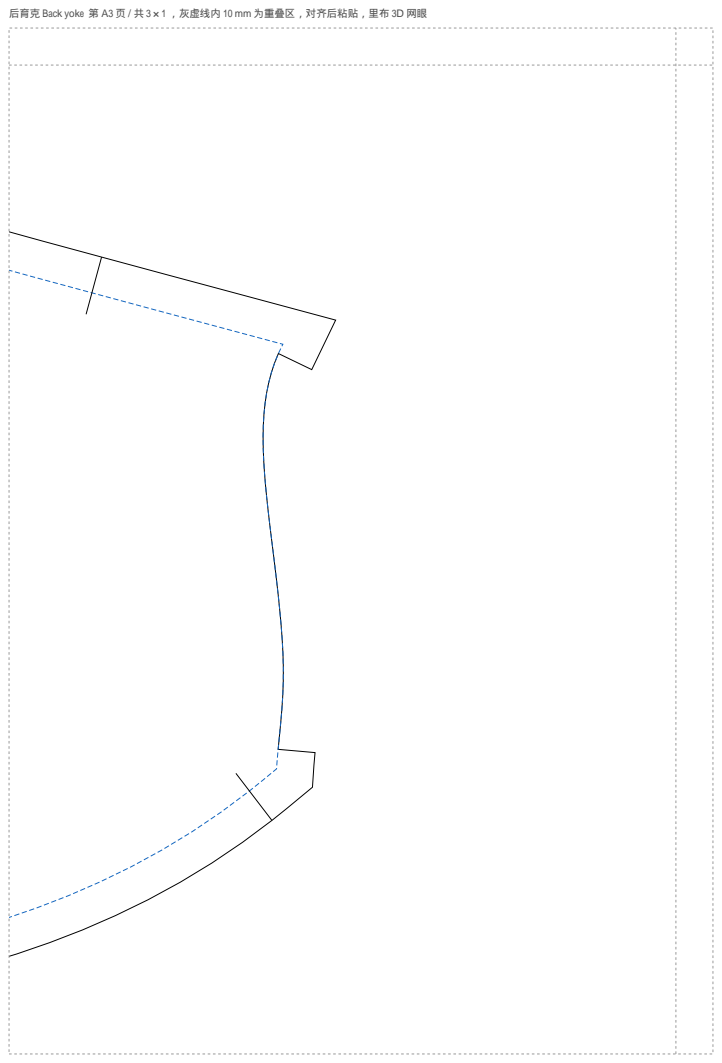
[picture p61: page 3]

后育克 Back yoke 第 A3 页 / 共 3×1 ，灰虚线内 10 mm 为重叠区，对齐后粘贴，里布 3D 网眼

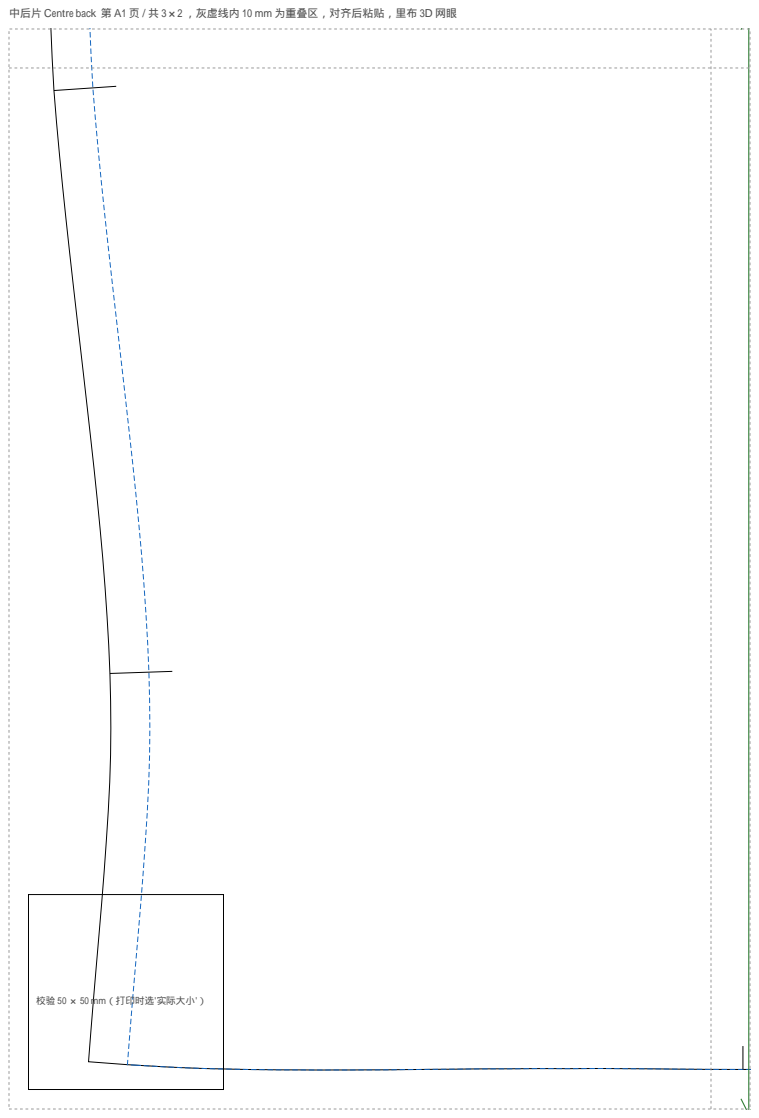
[picture p62: page 4]

中后片 Centre back 第 A1 页 / 共 3×2 ，灰虚线内 10 mm 为重叠区，对齐后粘贴，里布 3D 网眼

中后片 Centre back

布纹线与布边平行，实线=裁剪线，蓝虚线=净缝线，包边处无缝份

校验 50 × 50 mm（打印时选'实际大小'）

## 中后片 Centre back

面布 ×1，里布 ×1，里布 3D 网眼

布纹线与布边平行，实线=裁剪线，蓝虚线=净缝线，包边处无缝份

中后片 Centre back 第 A2 页 / 共 3×2 ，灰虚线内 10 mm 为重叠区，对齐后粘贴，里布 3D 网眼

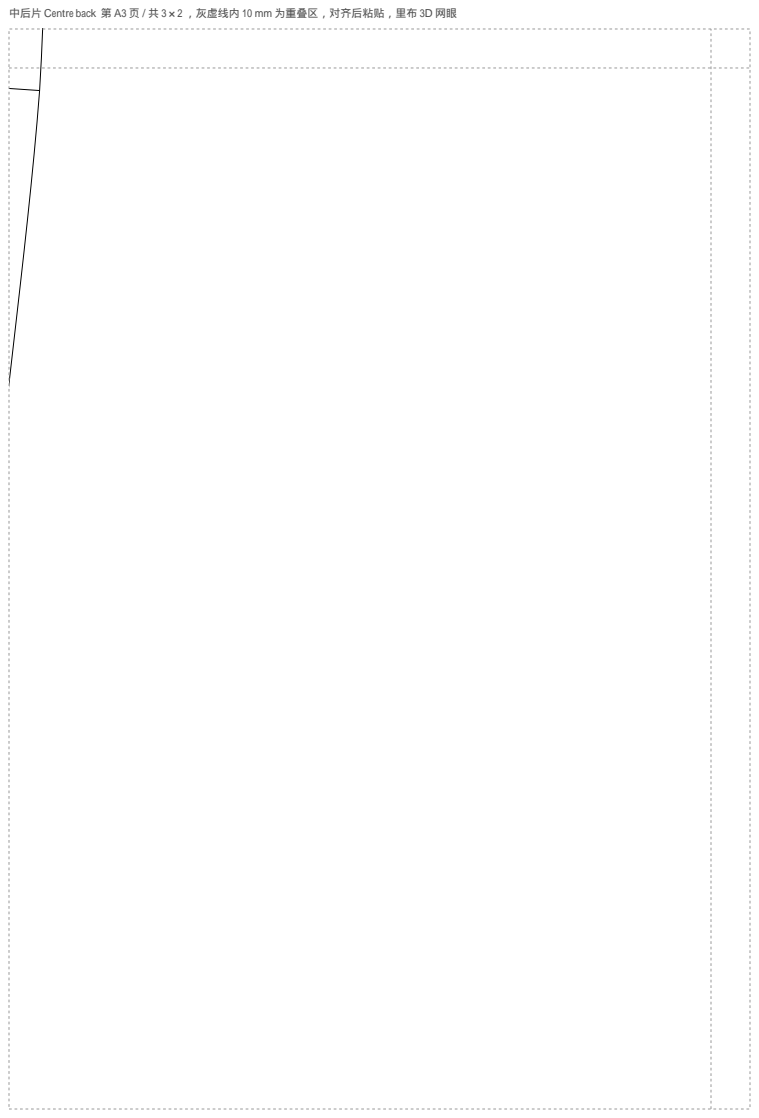
[picture p63: page 6]

中后片 Centre back 第 A3 页 / 共 3×2 ，灰虚线内 10 mm 为重叠区，对齐后粘贴，里布 3D 网眼

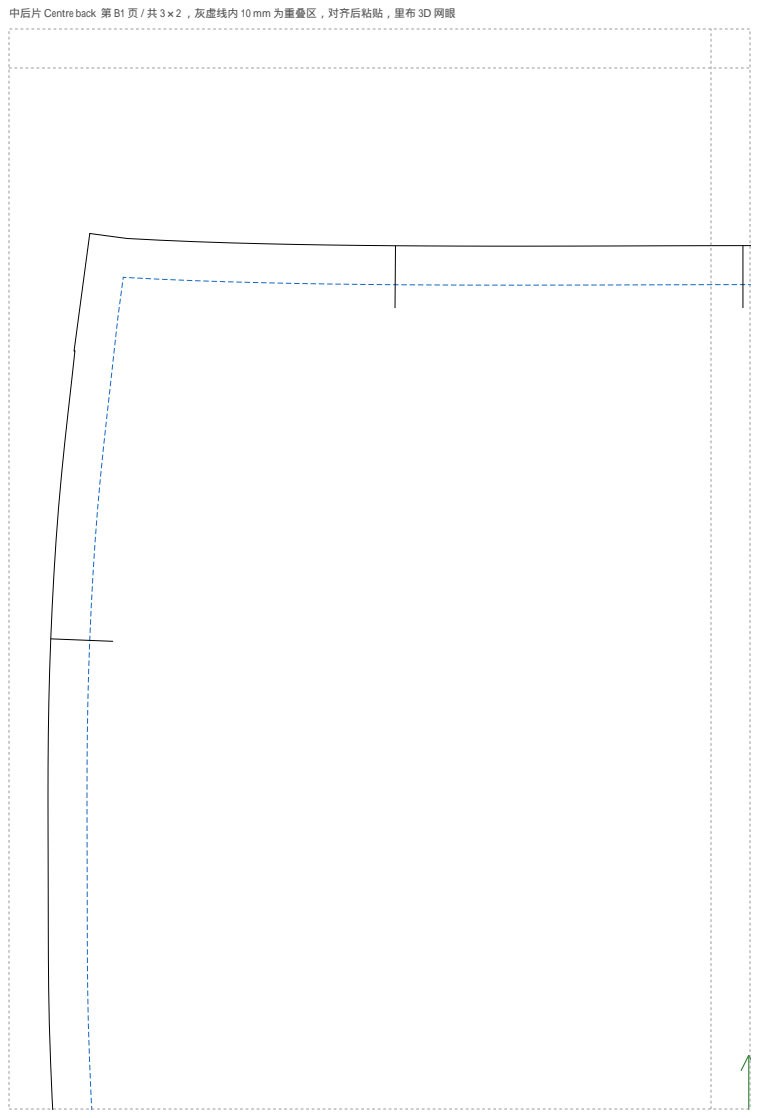
[picture p64: page 7]

中后片 Centre back 第 B1 页 / 共 3×2 ，灰虚线内 10 mm 为重叠区，对齐后粘贴，里布 3D 网眼

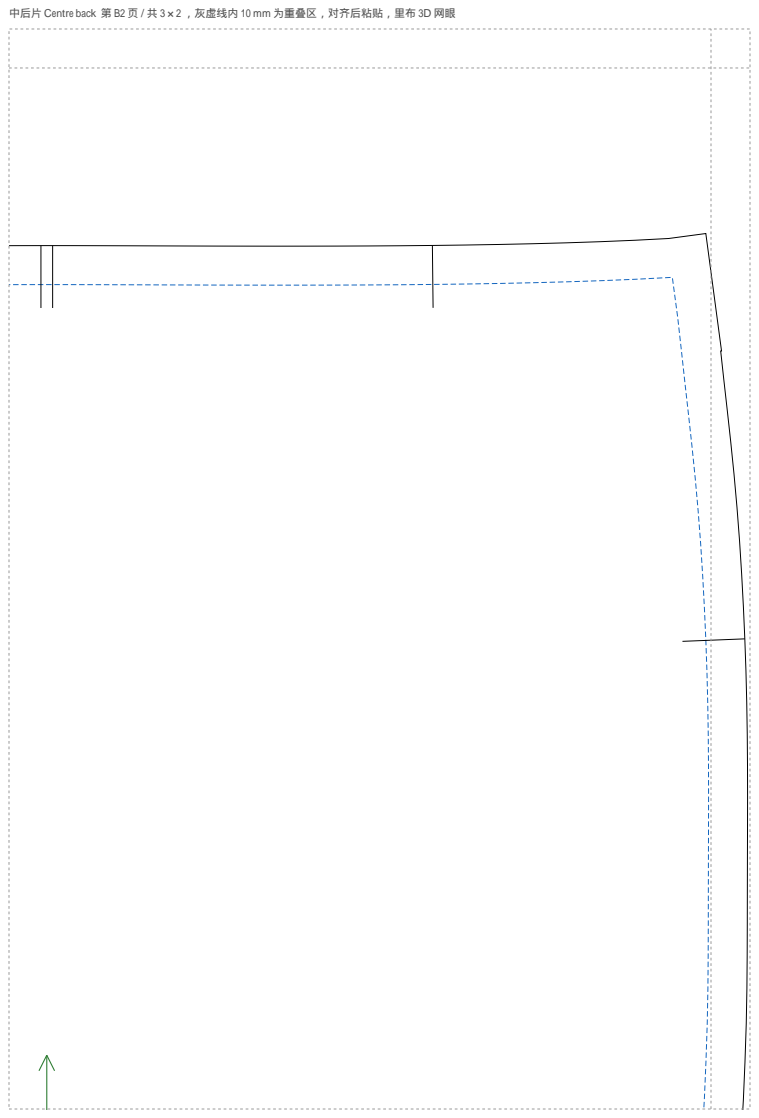
[picture p65: page 8]

中后片 Centre back 第 B2 页 / 共 3×2 ，灰虚线内 10 mm 为重叠区，对齐后粘贴，里布 3D 网眼

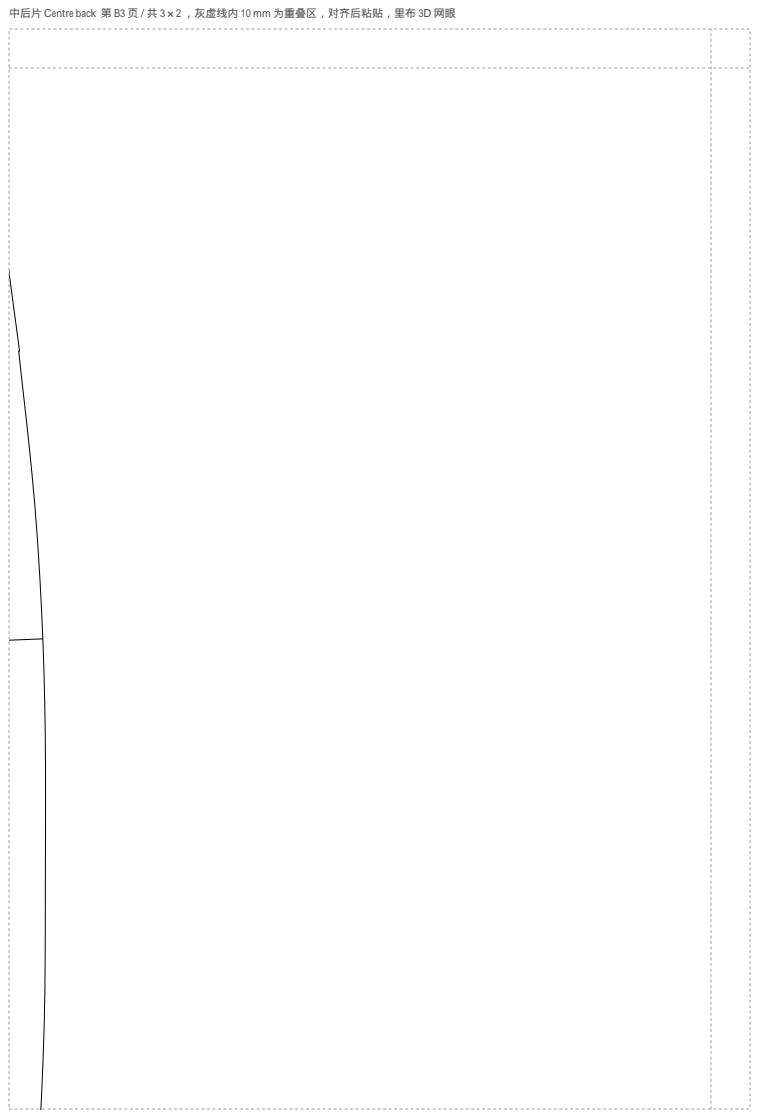
[picture p66: page 9]

中后片 Centre back 第 B3 页 / 共 3×2 ，灰虚线内 10 mm 为重叠区，对齐后粘贴，里布 3D 网眼

## 左侧后片 Side back L

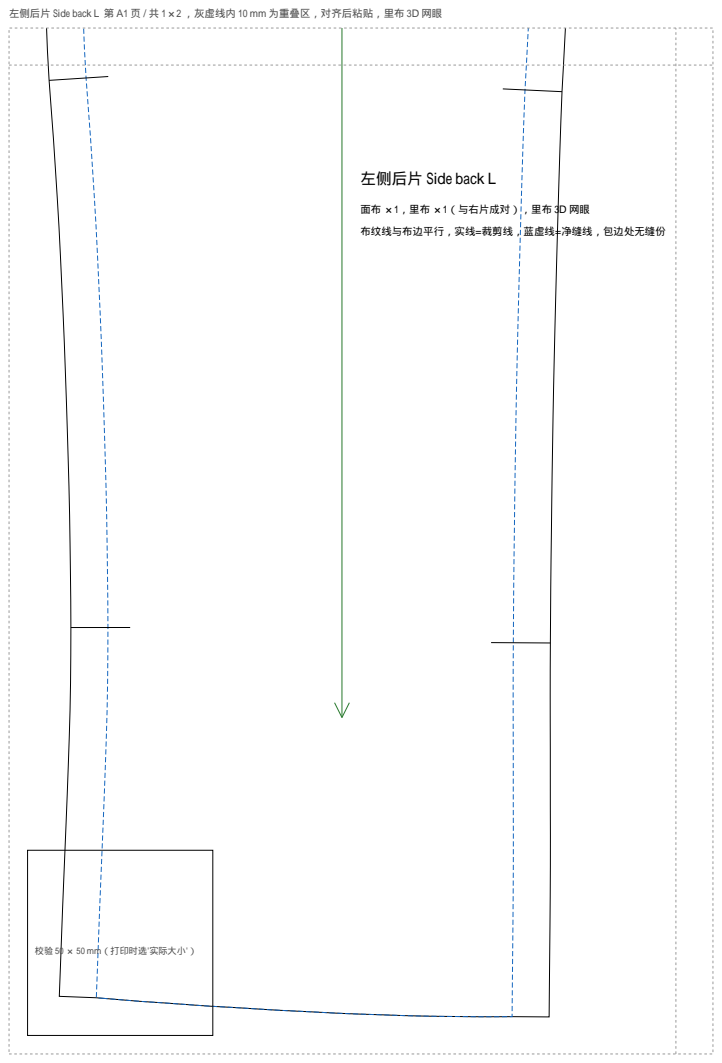
[picture p67: page 10]

左侧后片 Side back L 第 A1 页 / 共 1×2 ，灰虚线内 10 mm 为重叠区，对齐后粘贴，里布 3D 网眼

面布 ×1，里布 ×1（与右片成对），里布 3D 网眼

布纹线与布边平行，实线=裁剪线，蓝虚线=净缝线，包边处无缝份

校验 50 × 50 mm（打印时选'实际大小'）

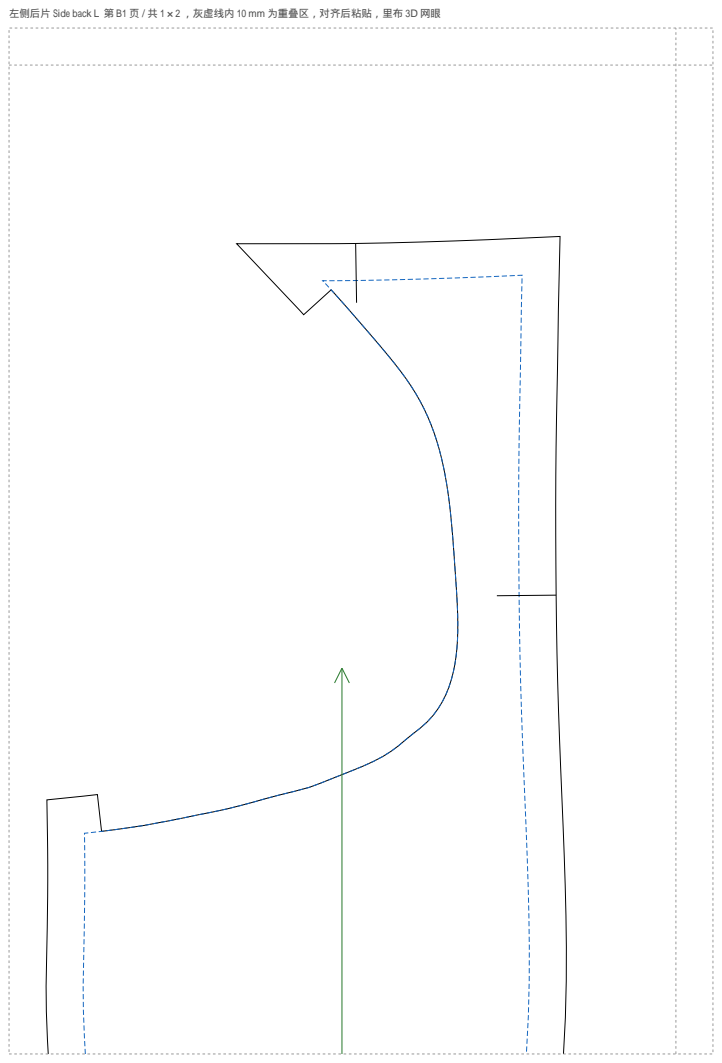
[picture p68: page 11]

左侧后片 Side back L 第 B1 页 / 共 1×2 ，灰虚线内 10 mm 为重叠区，对齐后粘贴，里布 3D 网眼

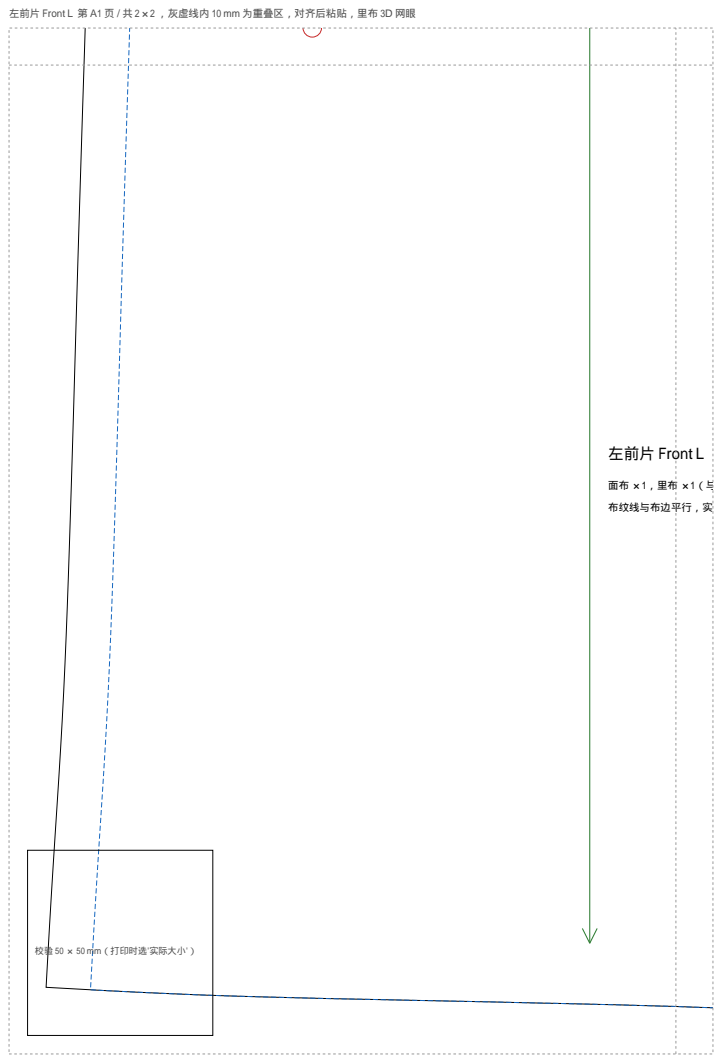
[picture p69: page 12]
左前片 Front L

左前片 Front L 第 A1 页 / 共 2×2 ，灰虚线内 10 mm 为重叠区，对齐后粘贴，里布 3D 网眼

面布 ×1，里布 ×1（与右片成对），里布 3D 网眼

布纹线与布边平行，实线=裁剪线，蓝虚线=净缝线，包边处无缝份

校验 50 × 50 mm（打印时选'实际大小'）

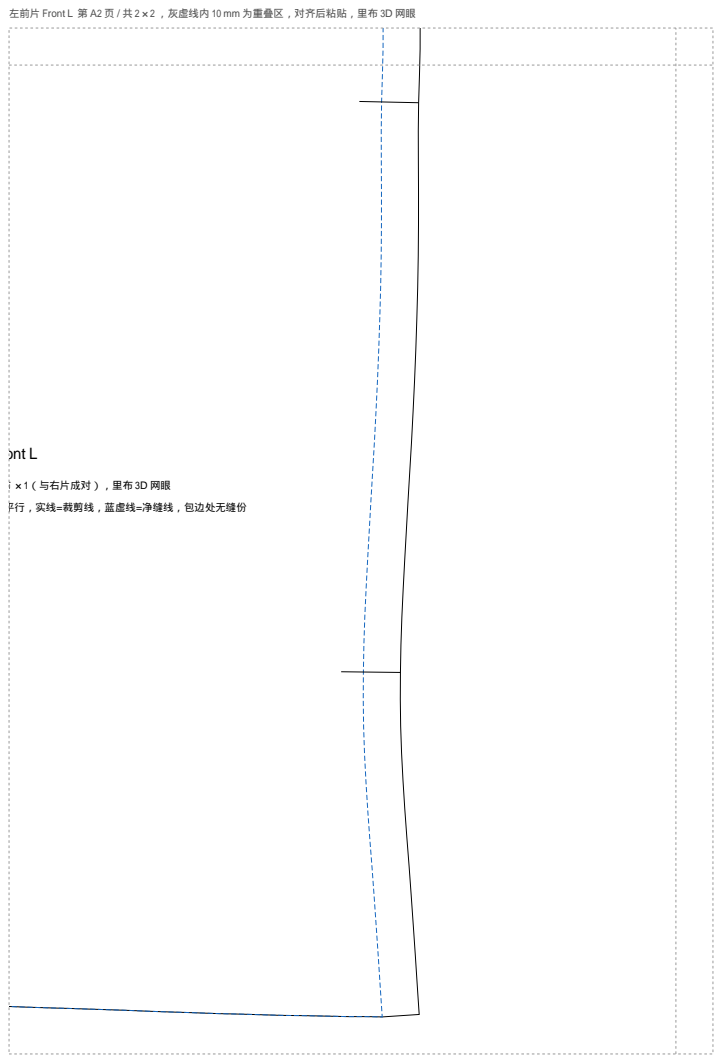
[picture p70: page 13]
左前片 Front L

左前片 Front L 第 A2 页 / 共 2×2 ，灰虚线内 10 mm 为重叠区，对齐后粘贴，里布 3D 网眼

面布 ×1，里布 ×1（与右片成对），里布 3D 网眼

布纹线与布边平行，实线=裁剪线，蓝虚线=净缝线，包边处无缝份

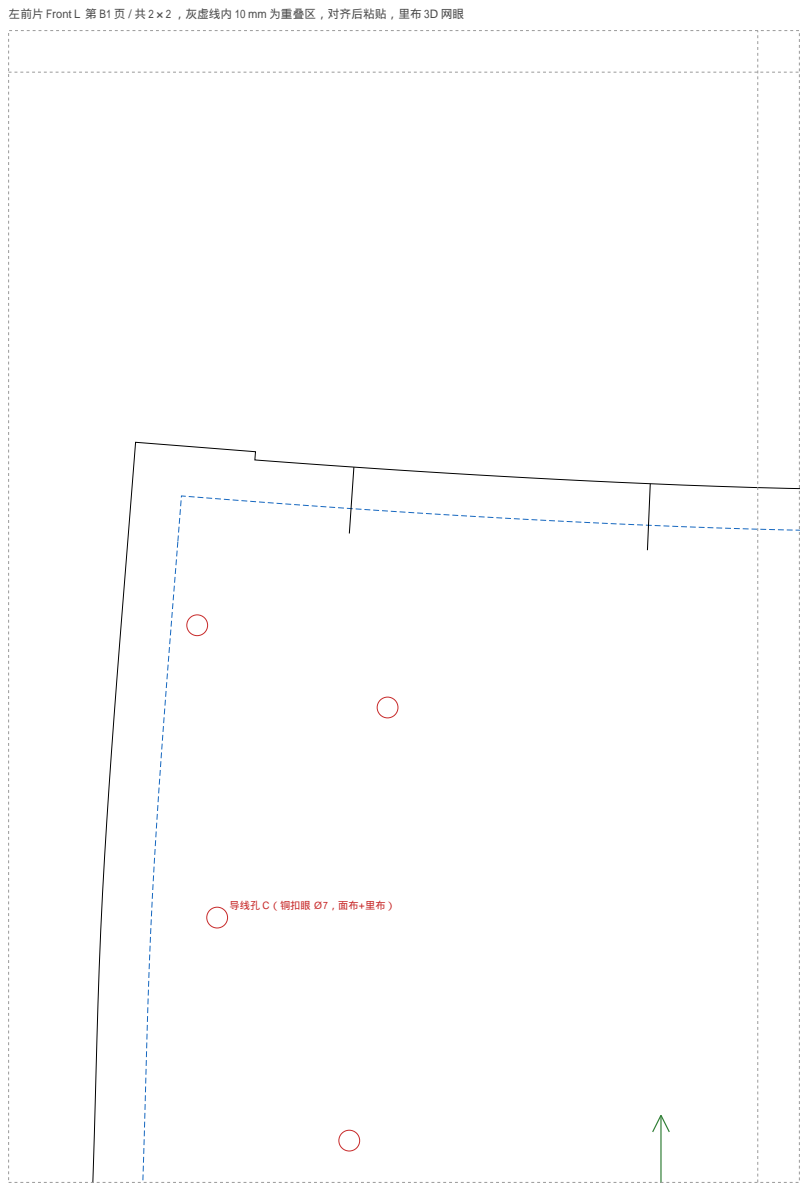
[picture p71: page 14]

左前片 Front L 第 B1 页 / 共 2×2 ，灰虚线内 10 mm 为重叠区，对齐后粘贴，里布 3D 网眼

导线孔 C（铜扣眼 Ø7，面布+里布）

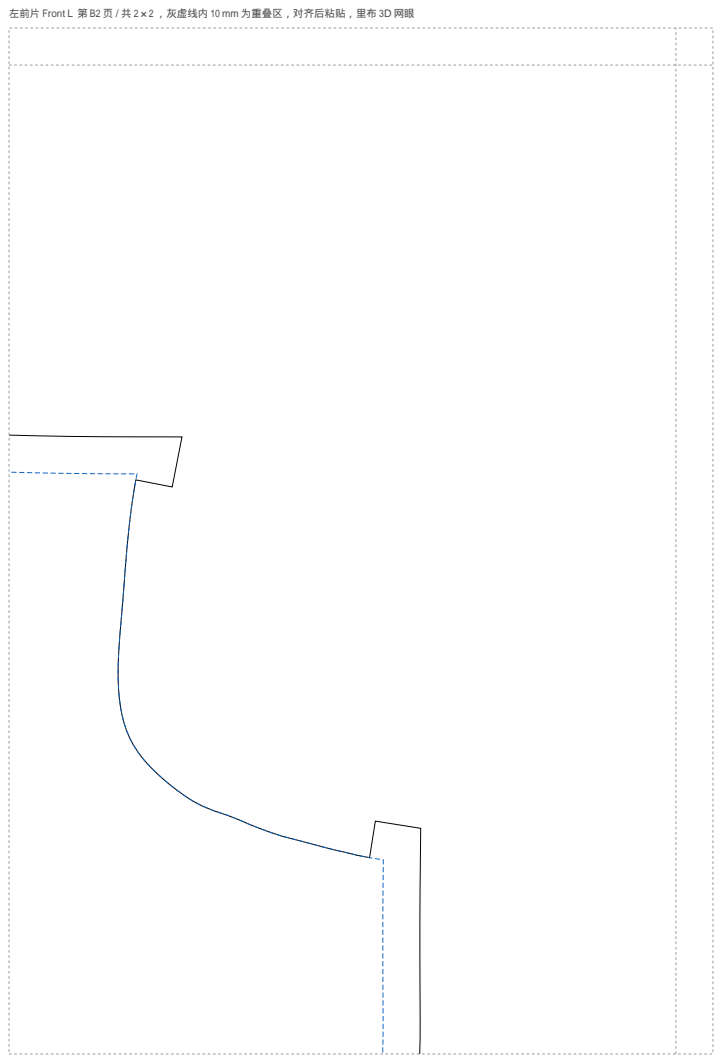
[picture p72: page 15]

左前片 Front L 第 B2 页 / 共 2×2 ，灰虚线内 10 mm 为重叠区，对齐后粘贴，里布 3D 网眼

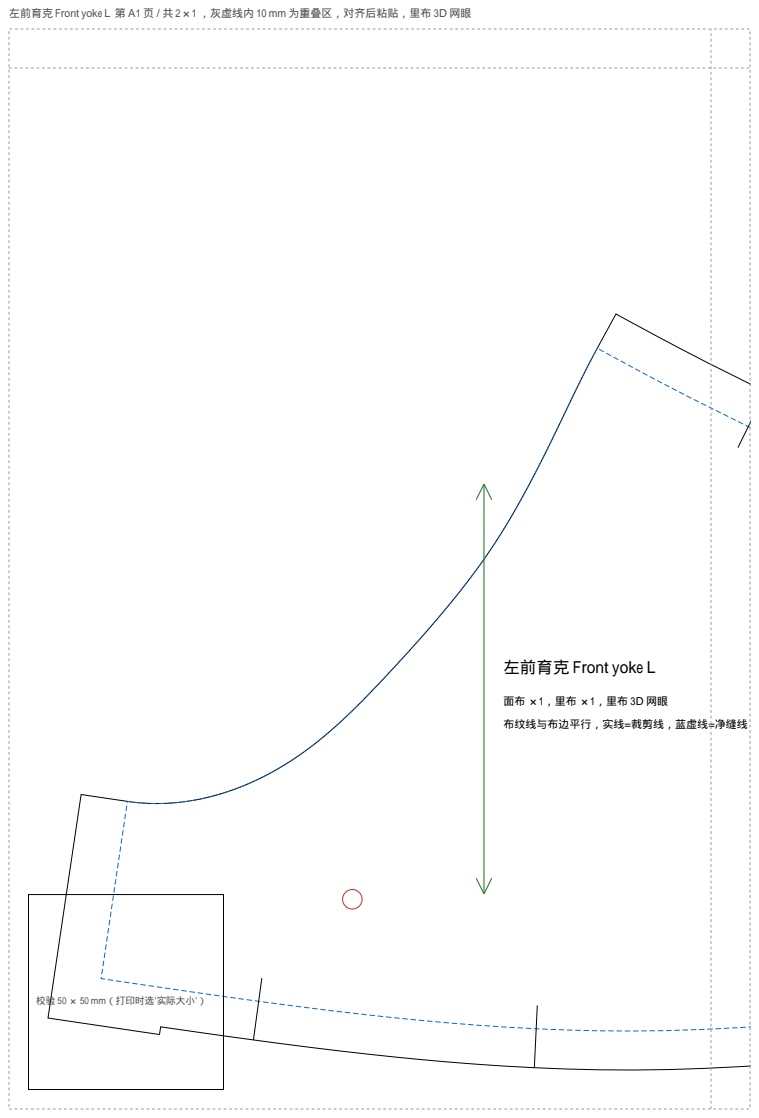
[picture p73: page 16]

左前育克 Front yoke L 第 A1 页 / 共 2×1 ，灰虚线内 10 mm 为重叠区，对齐后粘贴，里布 3D 网眼

左前育克 Front yoke L

布纹线与布边平行，实线=裁剪线，蓝虚线=净缝线，包边处无缝份

校验 50 × 50 mm（打印时选'实际大小'）

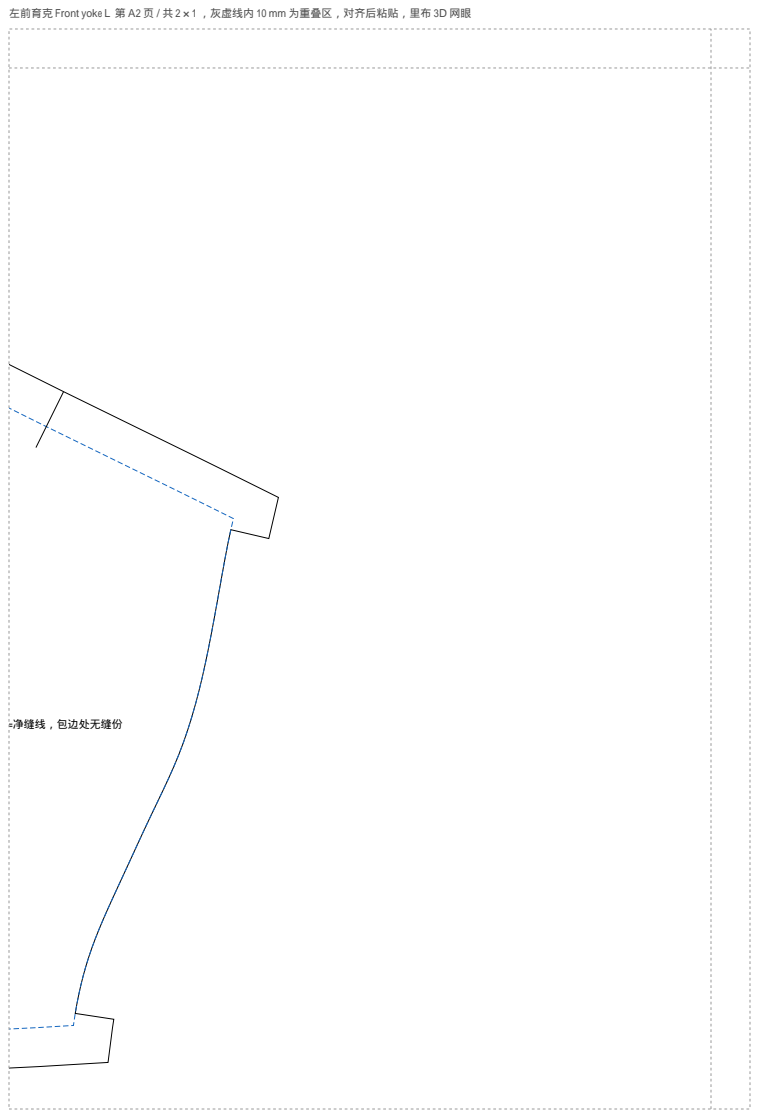
[picture p74: page 17]

左前育克 Front yoke L 第 A2 页 / 共 2×1 ，灰虚线内 10 mm 为重叠区，对齐后粘贴，里布 3D 网眼

布纹线与布边平行，实线=裁剪线，蓝虚线=净缝线，包边处无缝份

## 右侧后片 Side back R

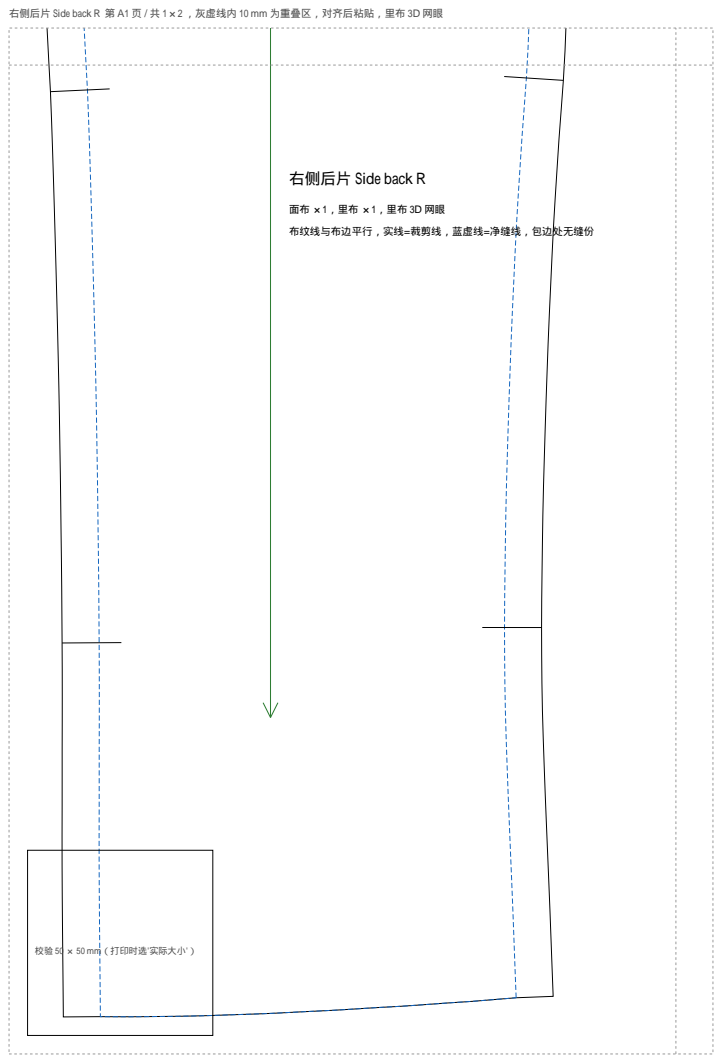
[picture p75: page 18]

右侧后片 Side back R 第 A1 页 / 共 1×2 ，灰虚线内 10 mm 为重叠区，对齐后粘贴，里布 3D 网眼

布纹线与布边平行，实线=裁剪线，蓝虚线=净缝线，包边处无缝份

校验 50 × 50 mm（打印时选'实际大小'）

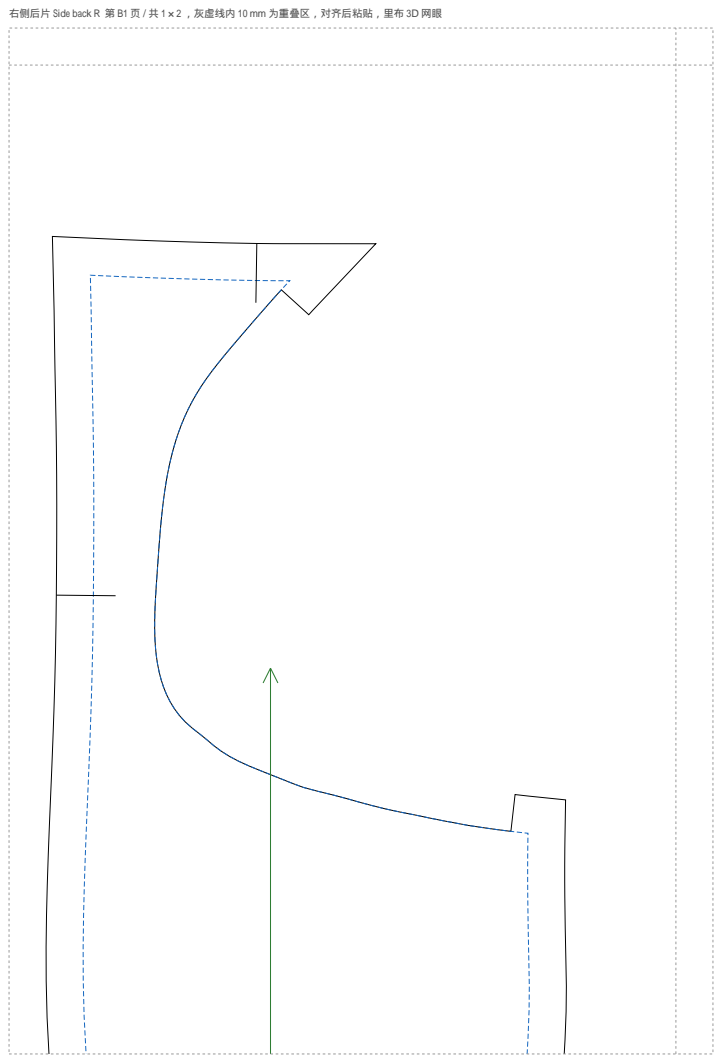
[picture p76: page 19]

右侧后片 Side back R 第 B1 页 / 共 1×2 ，灰虚线内 10 mm 为重叠区，对齐后粘贴，里布 3D 网眼

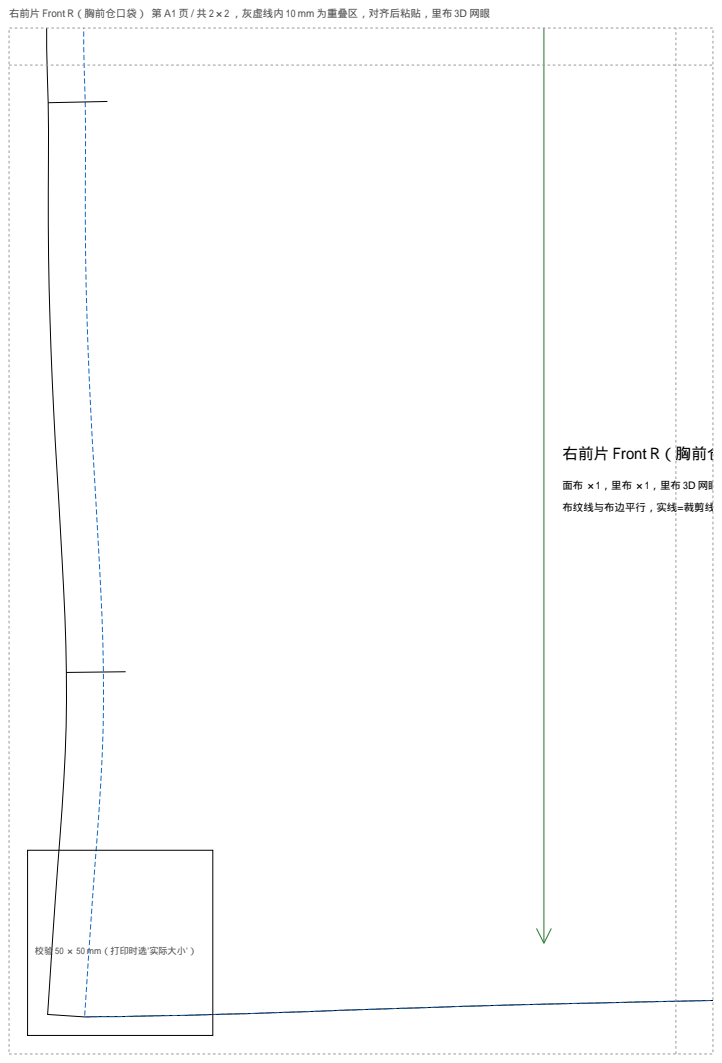
[picture p77: page 20]

右前片 Front R（胸前仓口袋） 第 A1 页 / 共 2×2 ，灰虚线内 10 mm 为重叠区，对齐后粘贴，里布 3D 网眼

右前片 Front R（胸前仓口袋）

布纹线与布边平行，实线=裁剪线，蓝虚线=净缝线，包边处无缝份

校验 50 × 50 mm（打印时选'实际大小'）

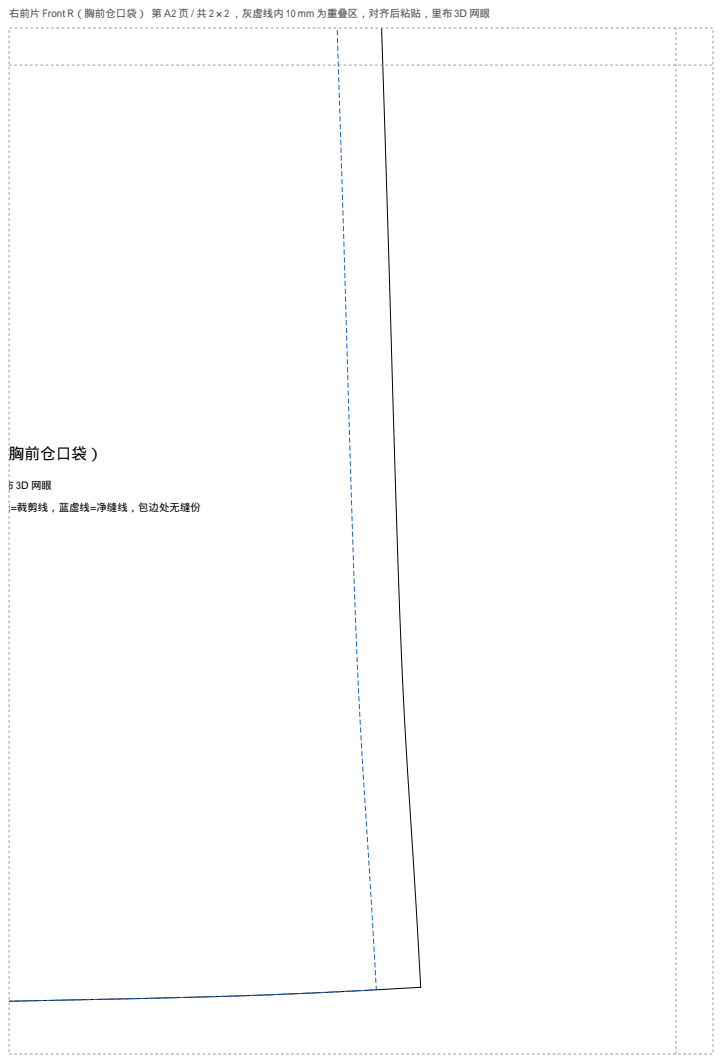
[picture p78: page 21]

右前片 Front R（胸前仓口袋） 第 A2 页 / 共 2×2 ，灰虚线内 10 mm 为重叠区，对齐后粘贴，里布 3D 网眼

右前片 Front R（胸前仓口袋）

布纹线与布边平行，实线=裁剪线，蓝虚线=净缝线，包边处无缝份

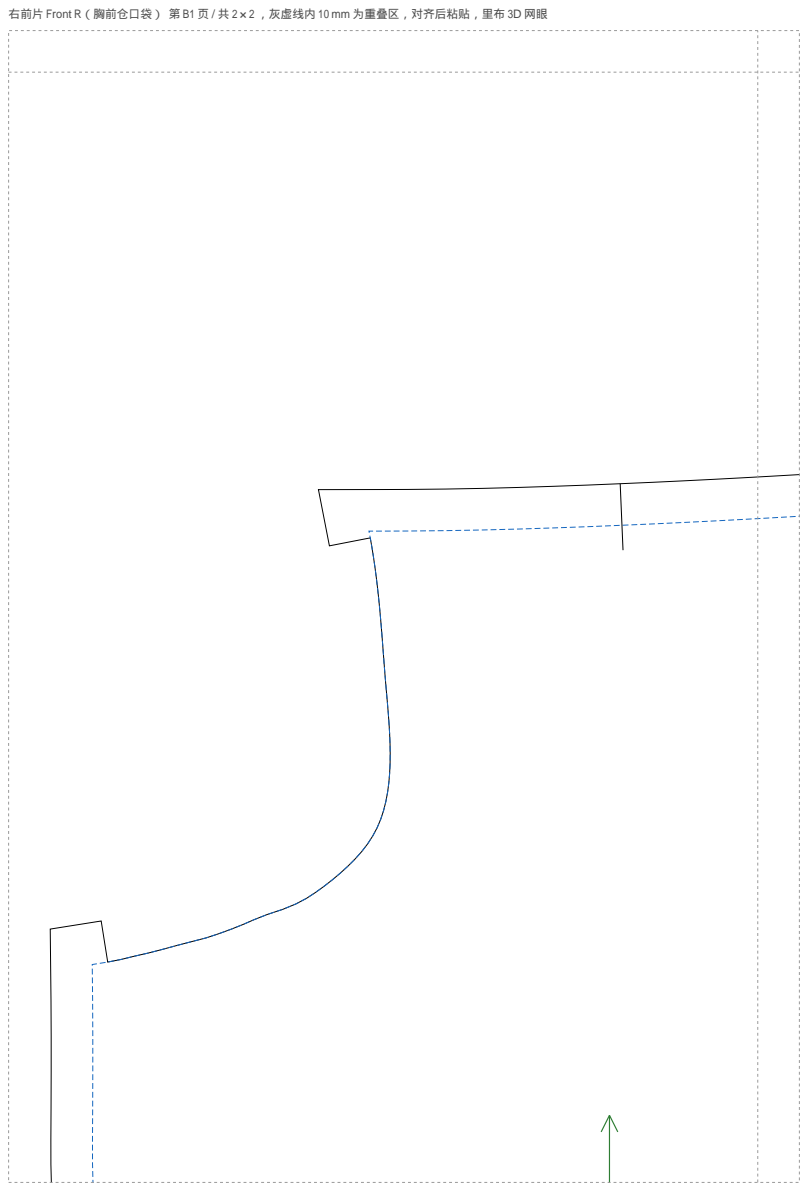
[picture p79: page 22]

右前片 Front R（胸前仓口袋） 第 B1 页 / 共 2×2 ，灰虚线内 10 mm 为重叠区，对齐后粘贴，里布 3D 网眼

导线孔 B（铜扣眼 Ø7，面布+里布）

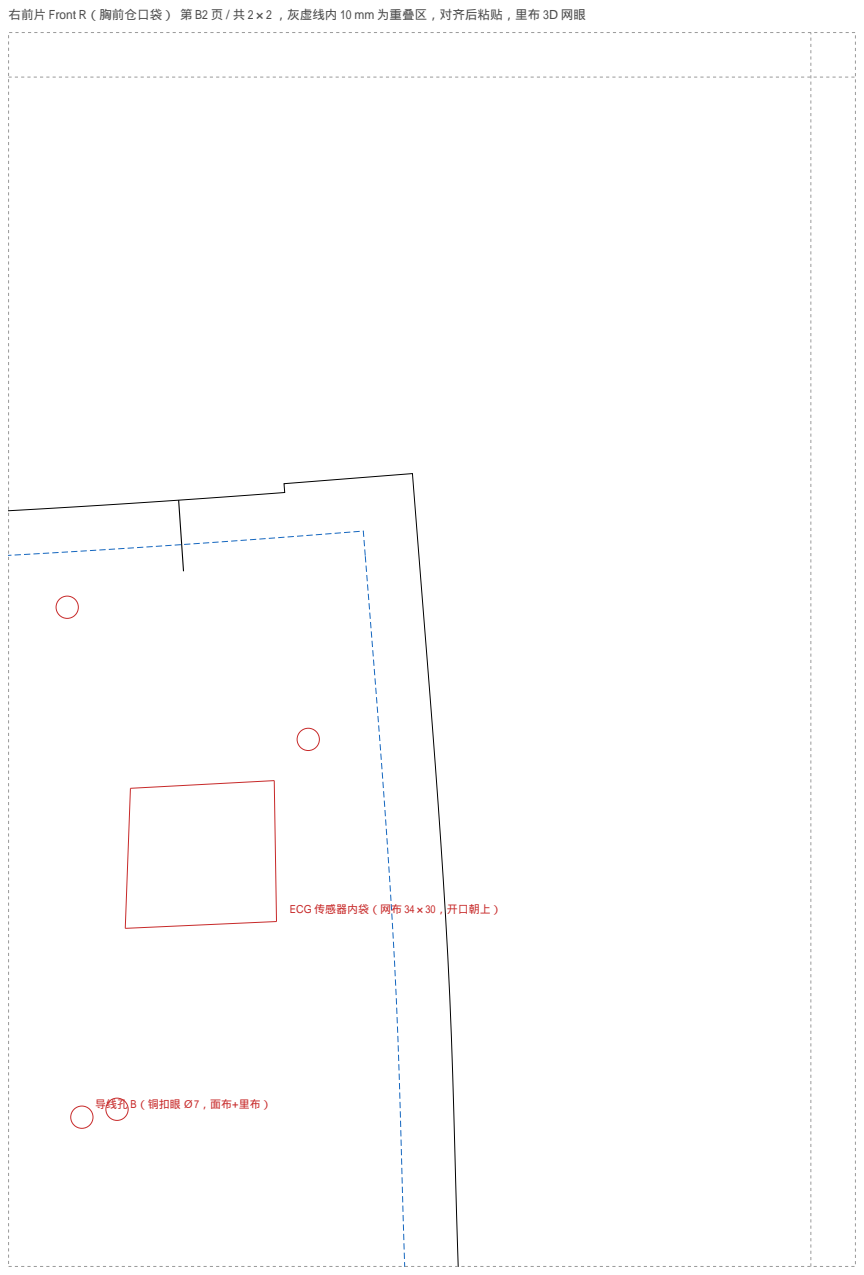
[picture p80: page 23]

右前片 Front R（胸前仓口袋） 第 B2 页 / 共 2×2 ，灰虚线内 10 mm 为重叠区，对齐后粘贴，里布 3D 网眼

ECG 传感器内袋（网布 34×30，开口朝上）

导线孔 B（铜扣眼 Ø7，面布+里布）

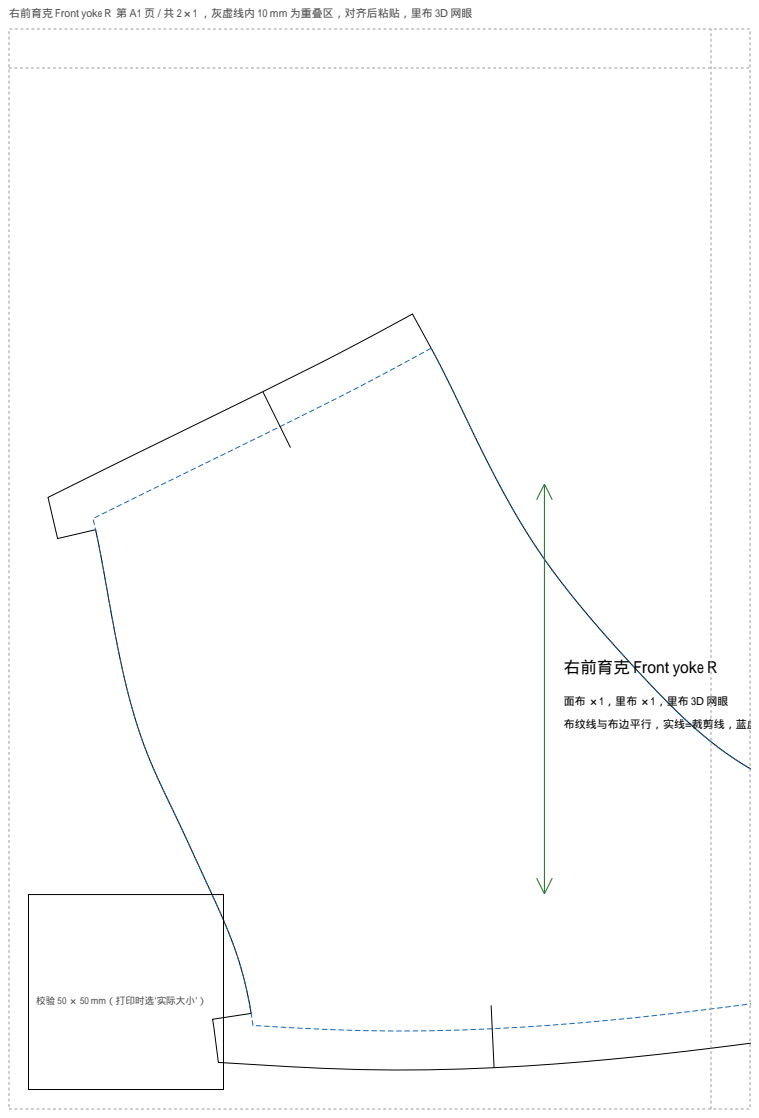
[picture p81: page 24]

右前育克 Front yoke R 第 A1 页 / 共 2×1 ，灰虚线内 10 mm 为重叠区，对齐后粘贴，里布 3D 网眼

右前育克 Front yoke R

布纹线与布边平行，实线=裁剪线，蓝虚线=净缝线，包边处无缝份

校验 50 × 50 mm（打印时选'实际大小'）

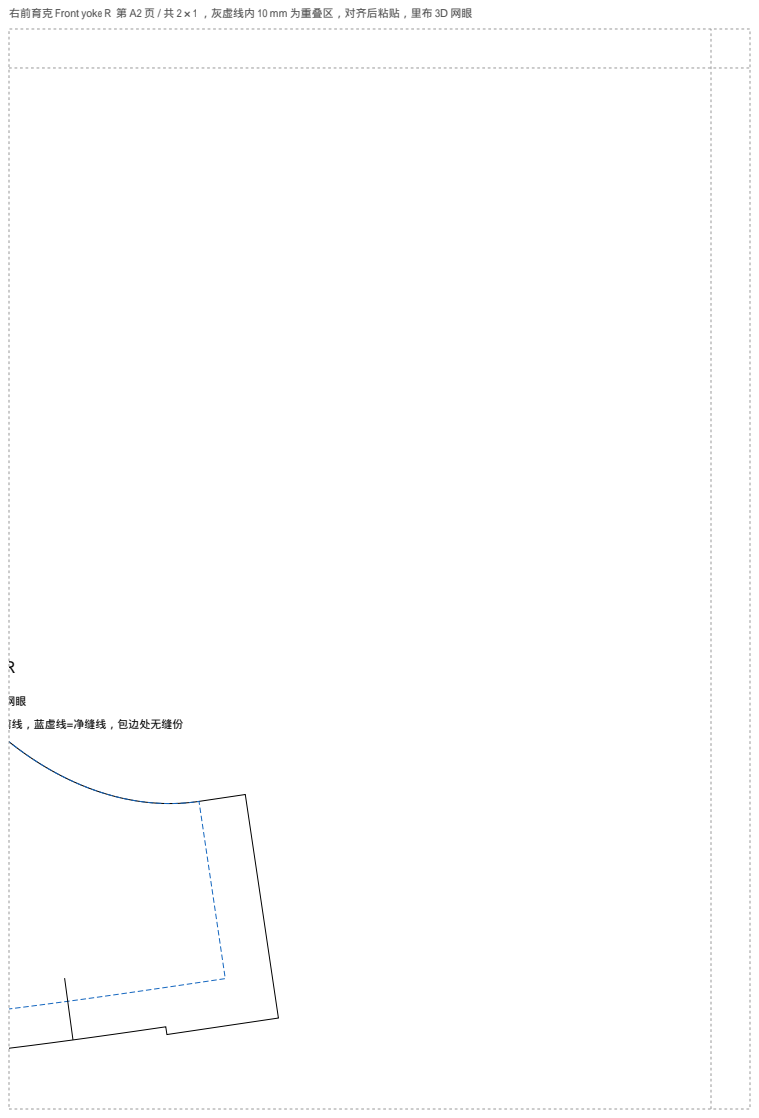
[picture p82: page 25]

右前育克 Front yoke R 第 A2 页 / 共 2×1 ，灰虚线内 10 mm 为重叠区，对齐后粘贴，里布 3D 网眼

右前育克 Front yoke R

布纹线与布边平行，实线=裁剪线，蓝虚线=净缝线，包边处无缝份
