3351666087/solar-vest/hardware/vest/pattern_lining_plotter-1to1.pdf

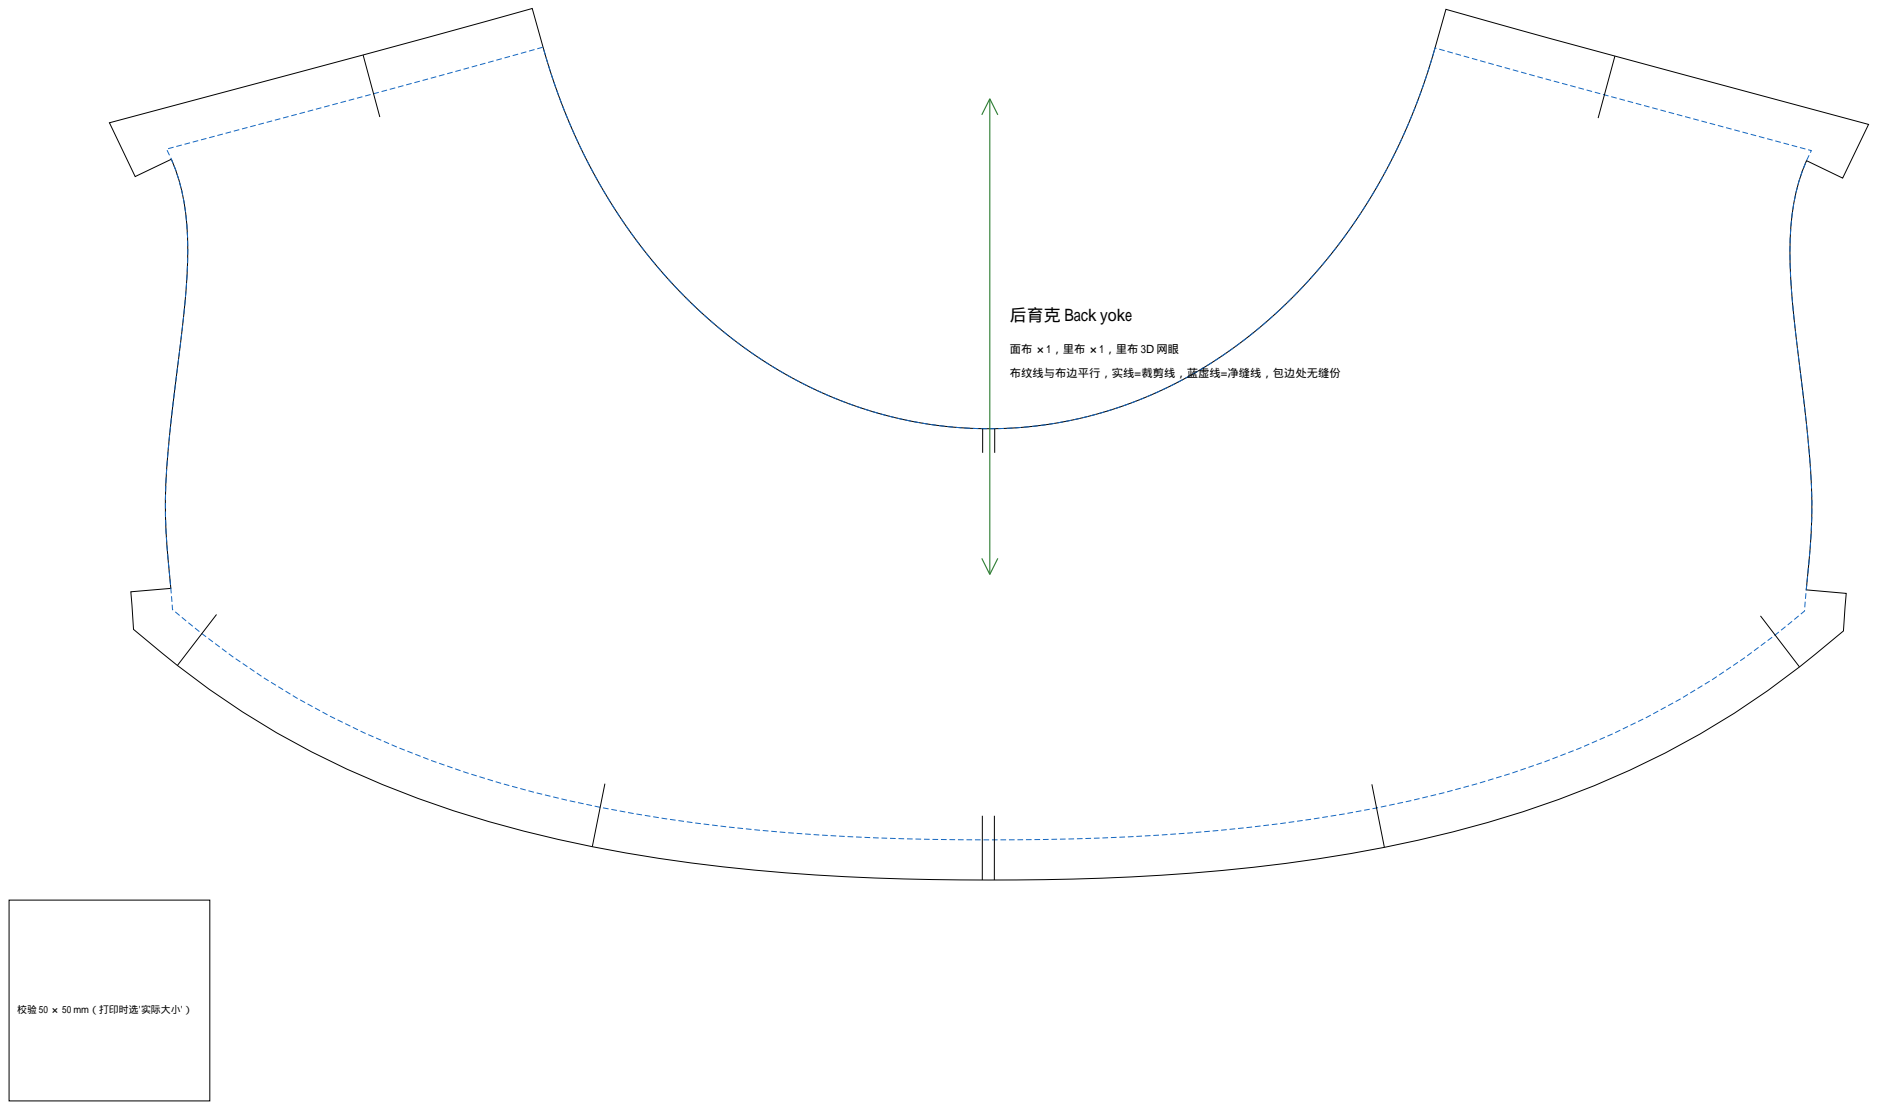
[picture p83: page 1]

后育克 Back yoke

布纹线与布边平行，实线=裁剪线，蓝虚线=净缝线，包边处无缝份

校验 50 × 50 mm（打印时选'实际大小'）

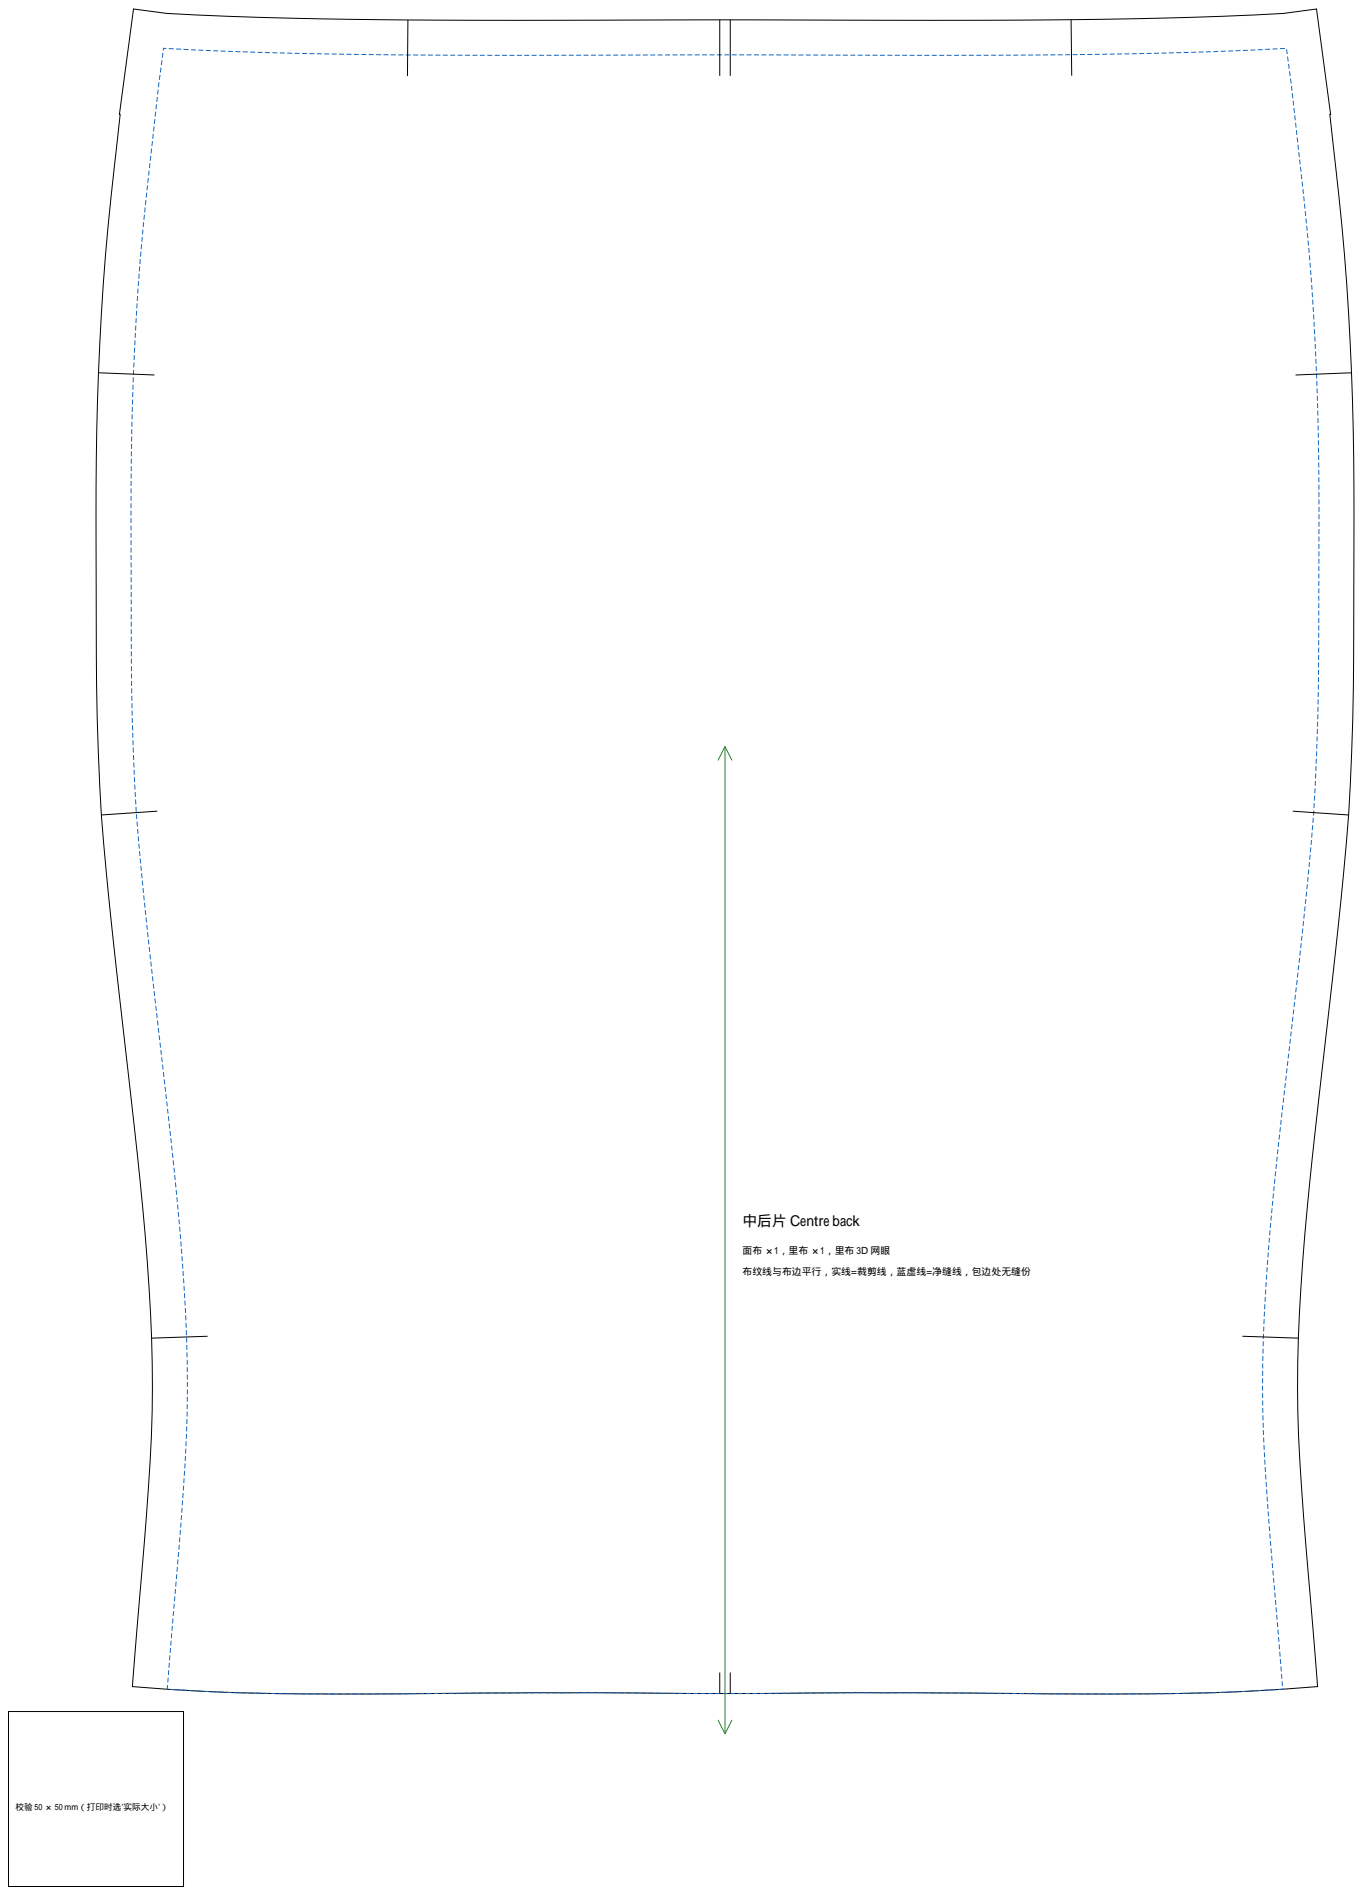
[picture p84: page 2]

中后片 Centre back

布纹线与布边平行，实线=裁剪线，蓝虚线=净缝线，包边处无缝份

校验 50 × 50 mm（打印时选'实际大小'）

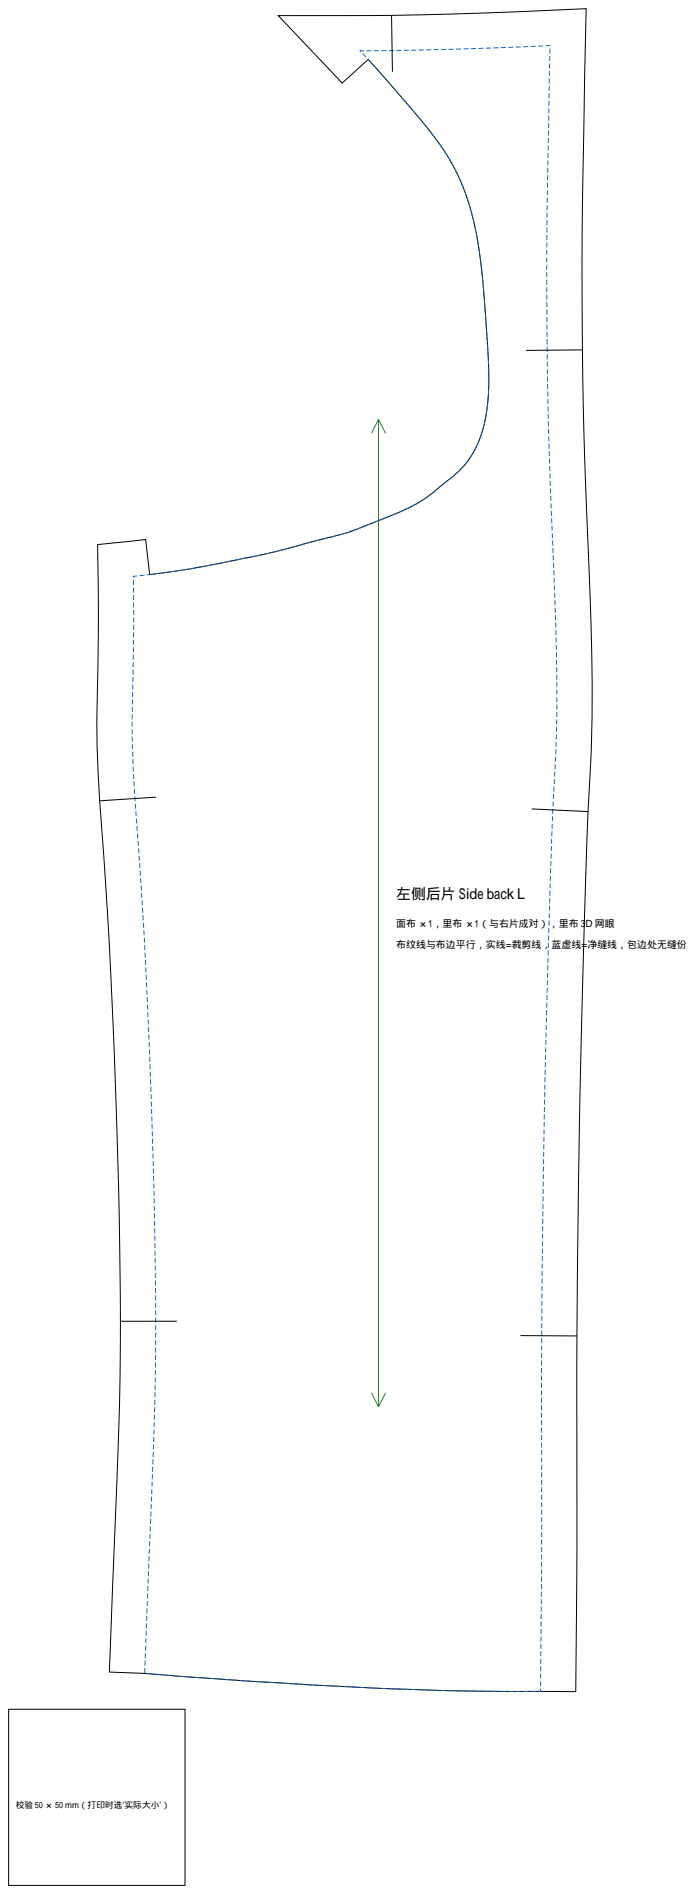
[picture p85: page 3]

左侧后片 Side back L

面布 ×1，里布 ×1（与右片成对），里布 3D 网眼

布纹线与布边平行，实线=裁剪线，蓝虚线=净缝线，包边处无缝份

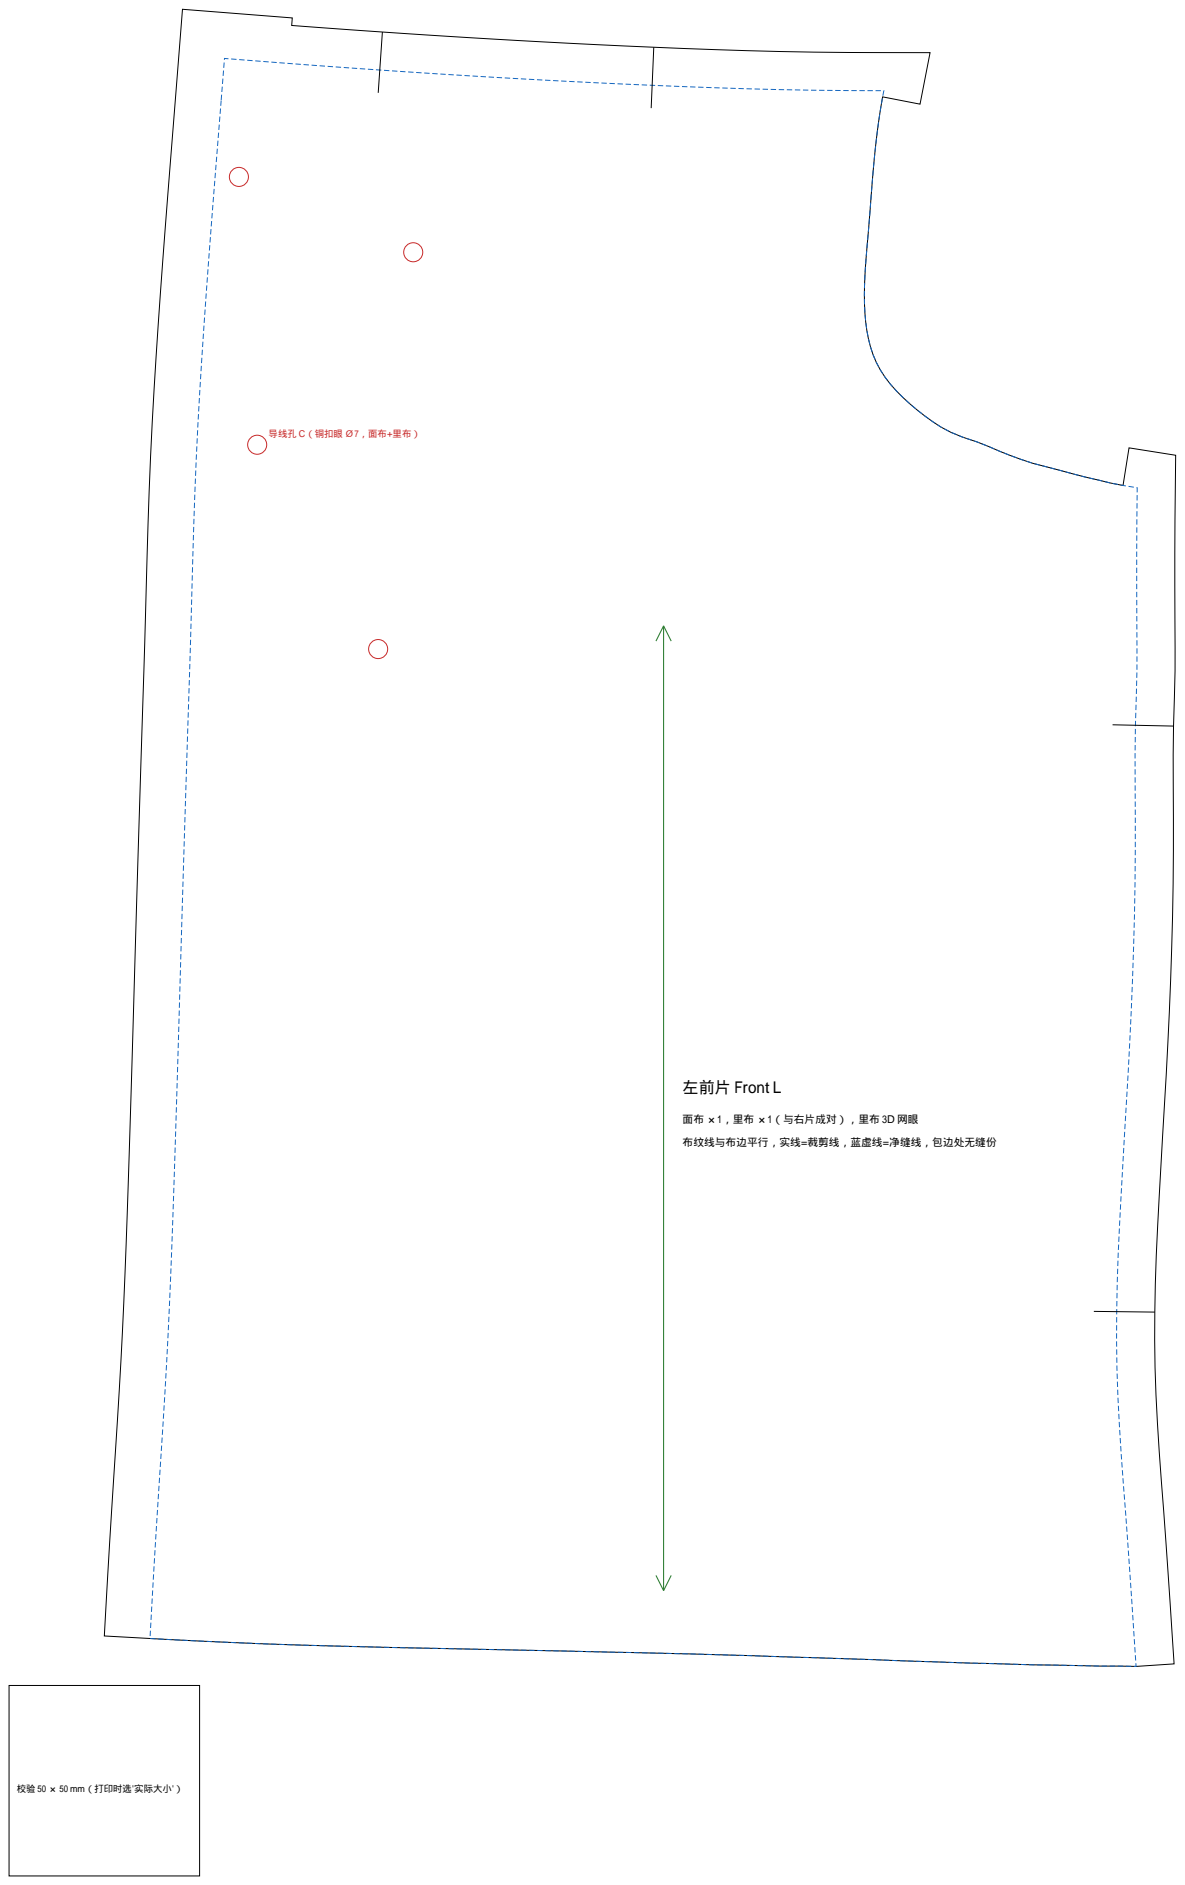
[picture p86: page 4]
左前片 Front L

导线孔 C（铜扣眼 Ø7，面布+里布）

面布 ×1，里布 ×1（与右片成对），里布 3D 网眼

布纹线与布边平行，实线=裁剪线，蓝虚线=净缝线，包边处无缝份

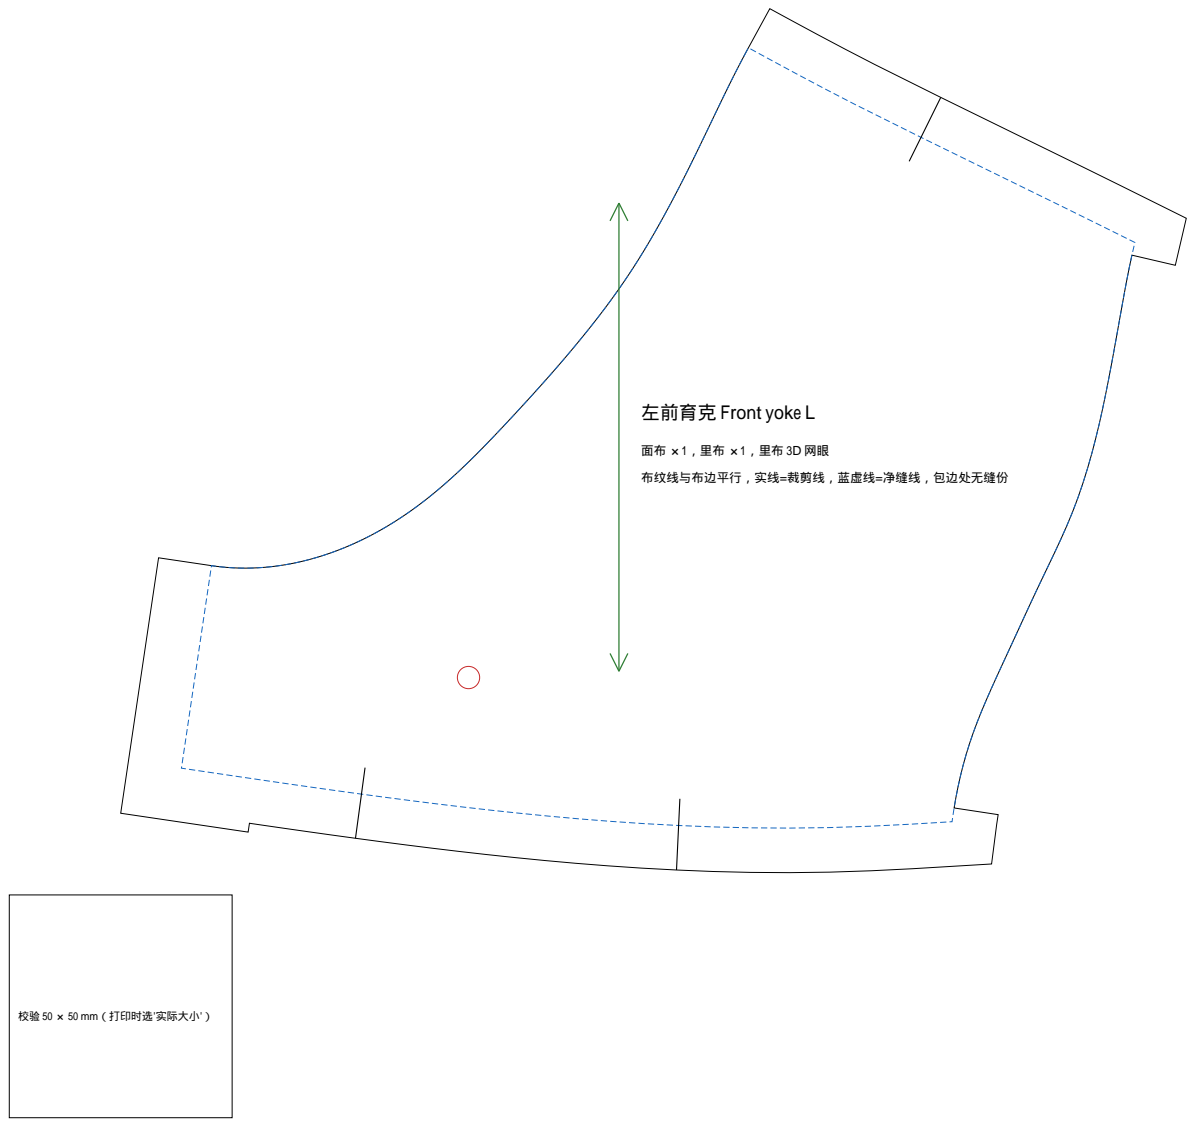
[picture p87: page 5]

左前育克 Front yoke L

布纹线与布边平行，实线=裁剪线，蓝虚线=净缝线，包边处无缝份

校验 50 × 50 mm（打印时选'实际大小'）

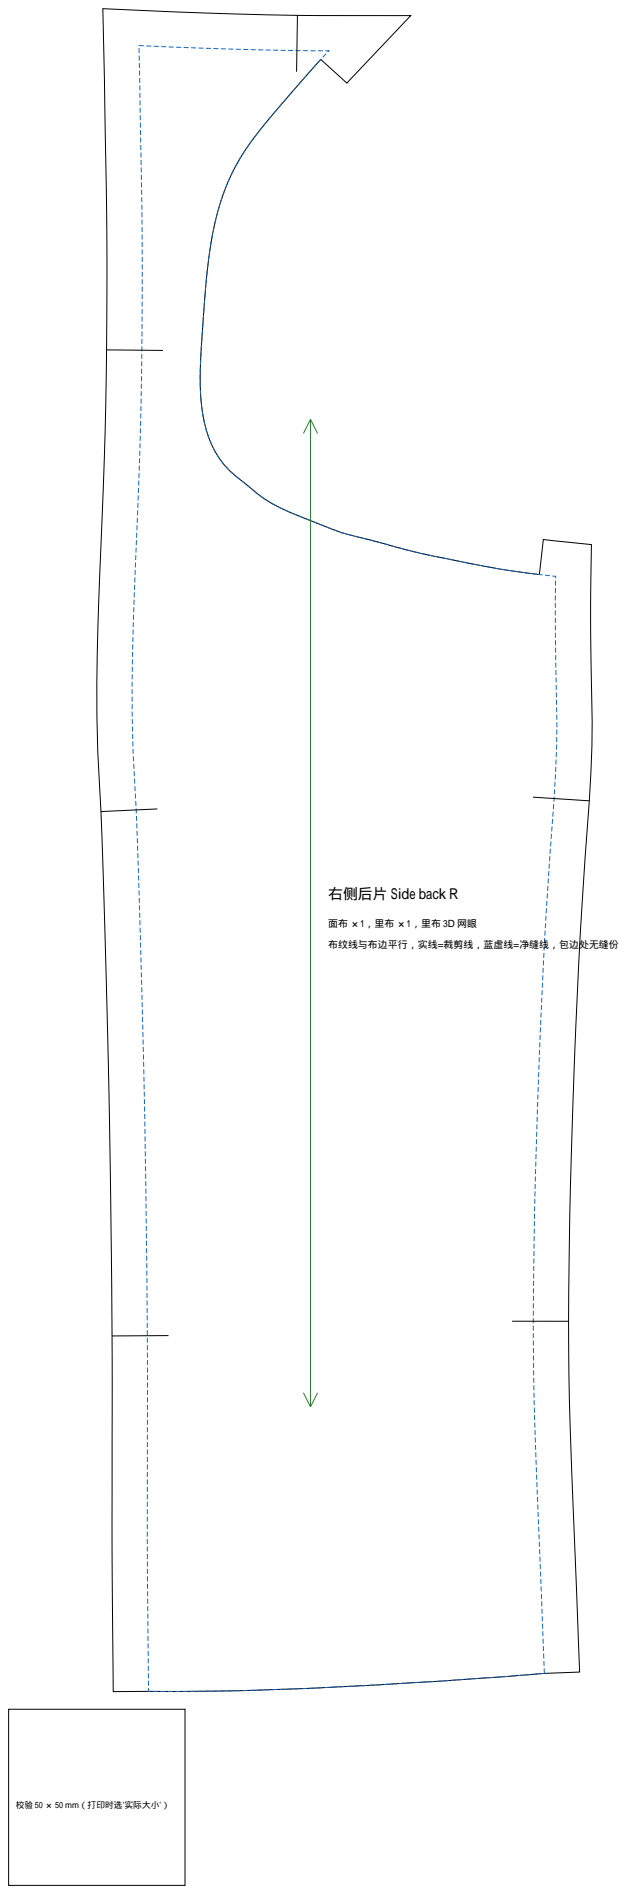
[picture p88: page 6]

右侧后片 Side back R

布纹线与布边平行，实线=裁剪线，蓝虚线=净缝线，包边处无缝份

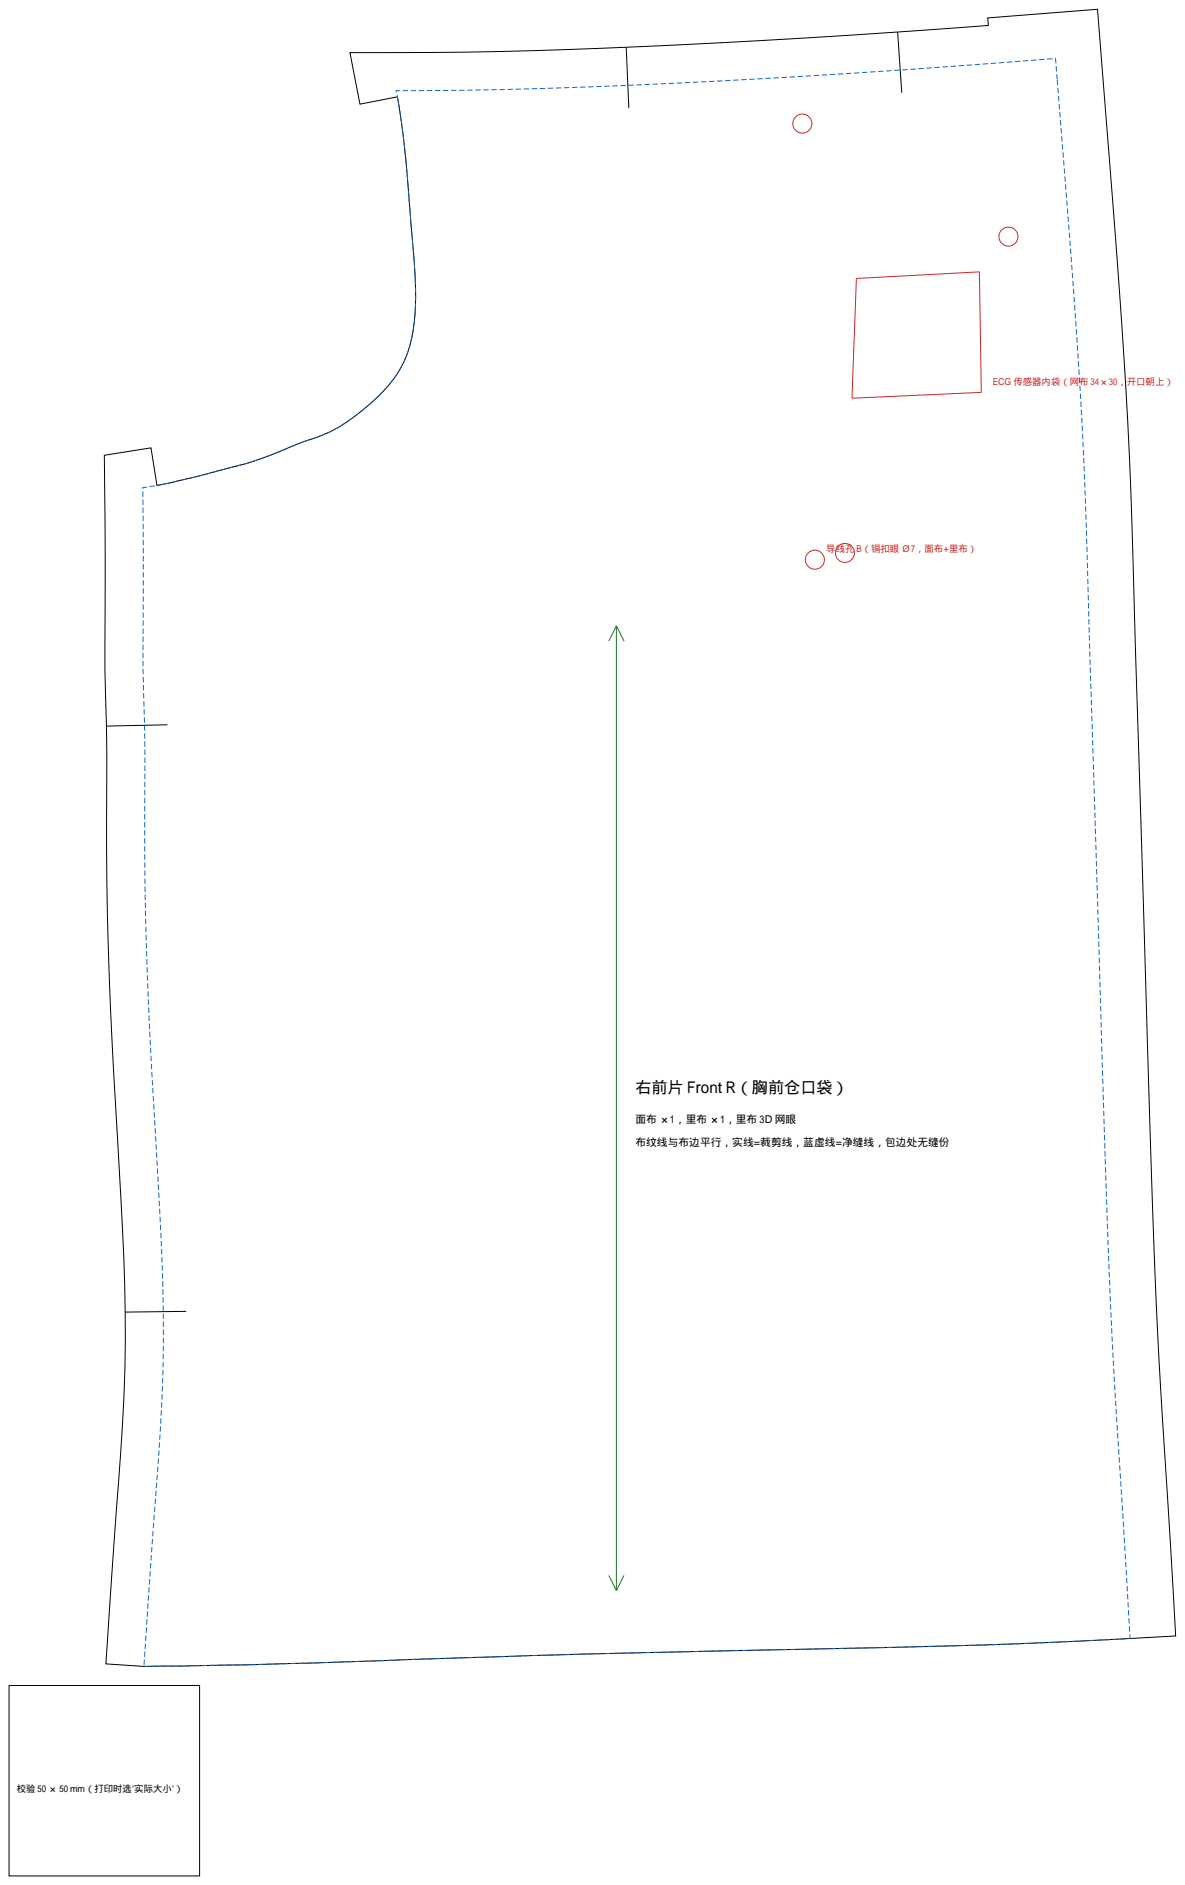
[picture p89: page 7]

ECG 传感器内袋（网布 34×30，开口朝上）

导线孔 B（铜扣眼 Ø7，面布+里布）

右前片 Front R（胸前仓口袋）

布纹线与布边平行，实线=裁剪线，蓝虚线=净缝线，包边处无缝份

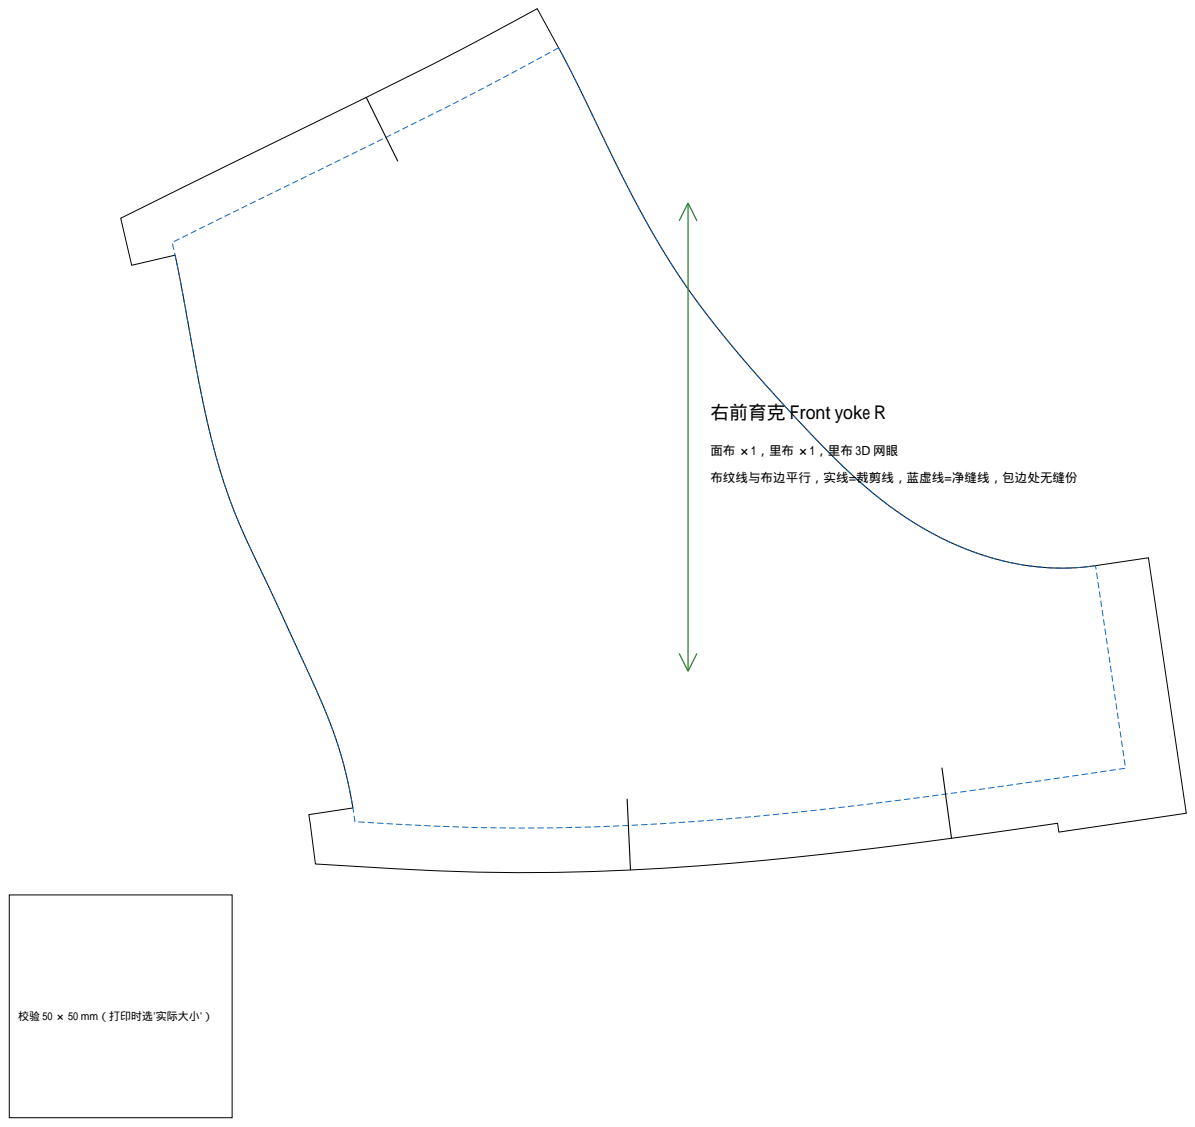
[picture p90: page 8]

右前育克 Front yoke R

布纹线与布边平行，实线=裁剪线，蓝虚线=净缝线，包边处无缝份

校验 50 × 50 mm（打印时选'实际大小'）
