3351666087/solar-vest/hardware/vest/pattern_shell_A4-tiled.pdf

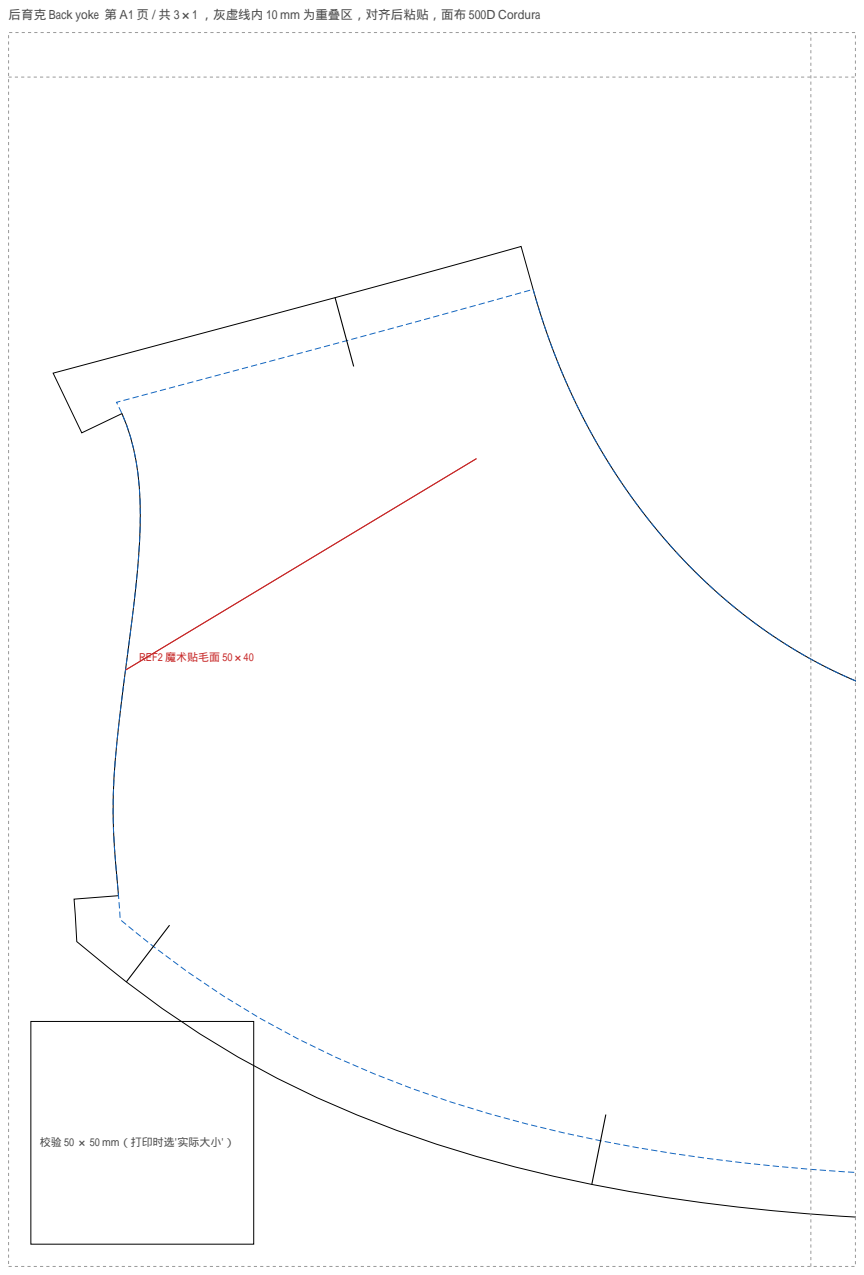
[picture p91: page 1]
REF2 魔术贴毛面 50×40

后育克 Back yoke 第 A1 页 / 共 3×1 ，灰虚线内 10 mm 为重叠区，对齐后粘贴，面布 500D Cordura

校验 50 × 50 mm（打印时选'实际大小'）

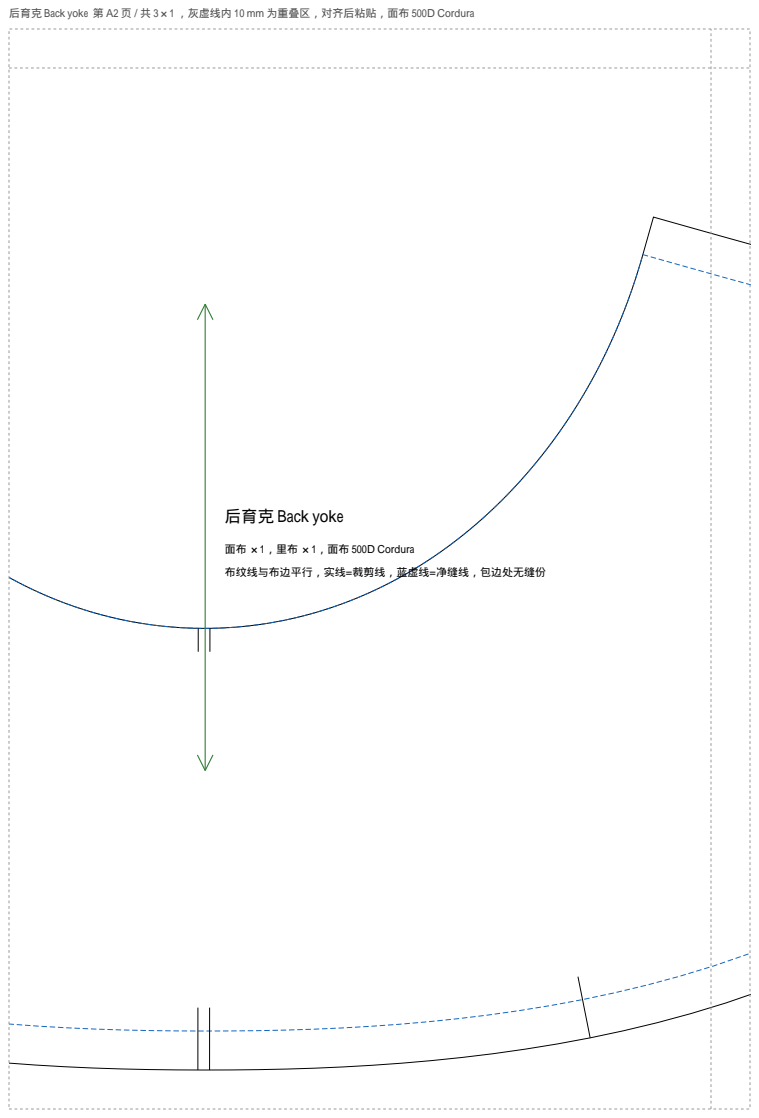
[picture p92: page 2]

后育克 Back yoke 第 A2 页 / 共 3×1 ，灰虚线内 10 mm 为重叠区，对齐后粘贴，面布 500D Cordura

后育克 Back yoke

面布 ×1，里布 ×1，面布 500D Cordura

布纹线与布边平行，实线=裁剪线，蓝虚线=净缝线，包边处无缝份

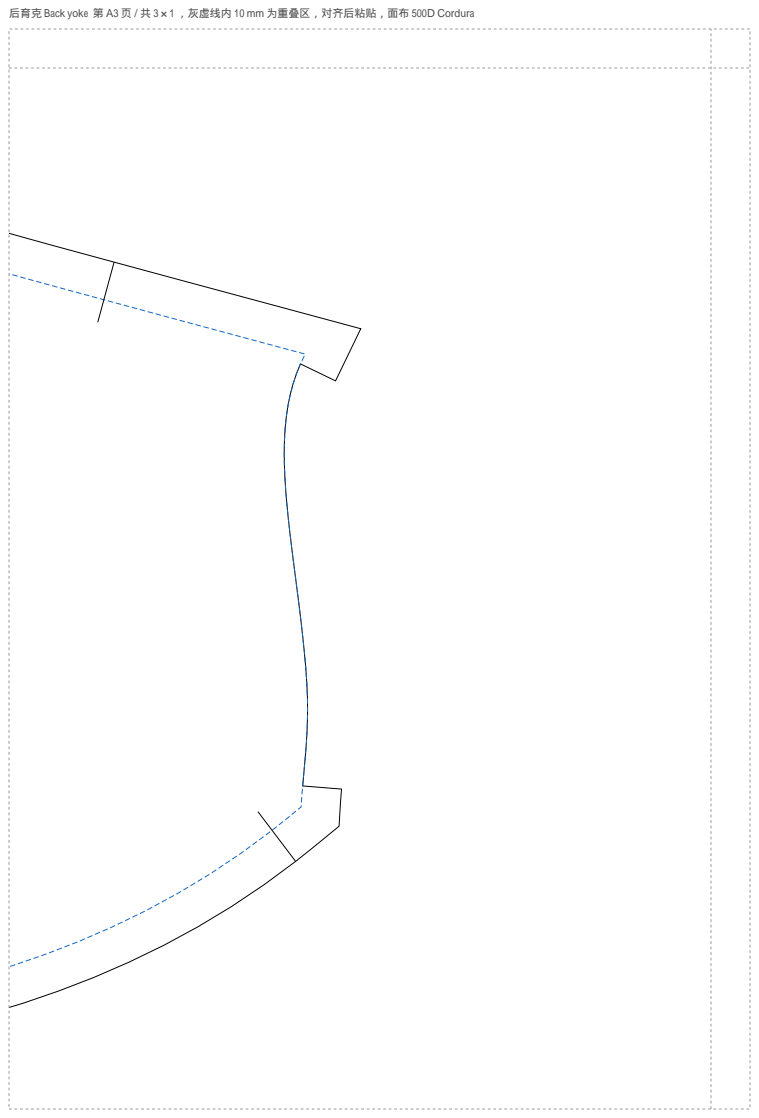
[picture p93: page 3]

后育克 Back yoke 第 A3 页 / 共 3×1 ，灰虚线内 10 mm 为重叠区，对齐后粘贴，面布 500D Cordura

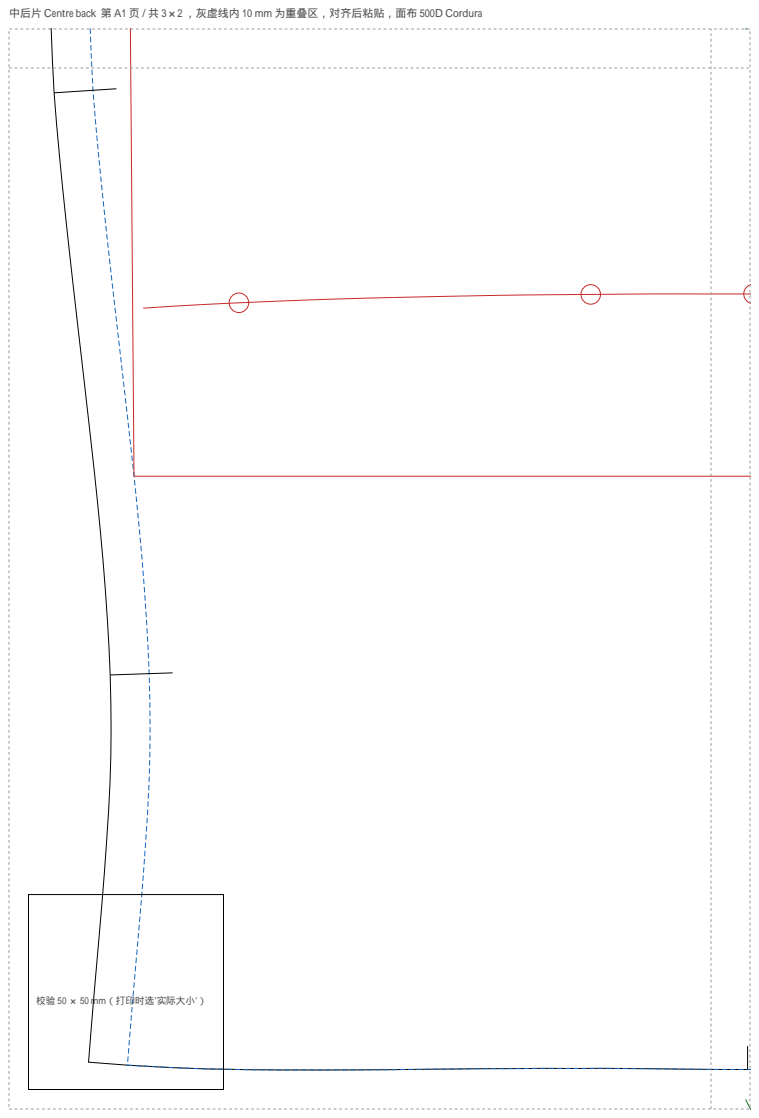
[picture p94: page 4]

中后片 Centre back 第 A1 页 / 共 3×2 ，灰虚线内 10 mm 为重叠区，对齐后粘贴，面布 500D Cordura

中后片 Centre back

面布 ×1，里布 ×1，面布 500D Cordura

布纹线与布边平行，实线=裁剪线，蓝虚线=净缝线，包边处无缝份

校验 50 × 50 mm（打印时选'实际大小'）

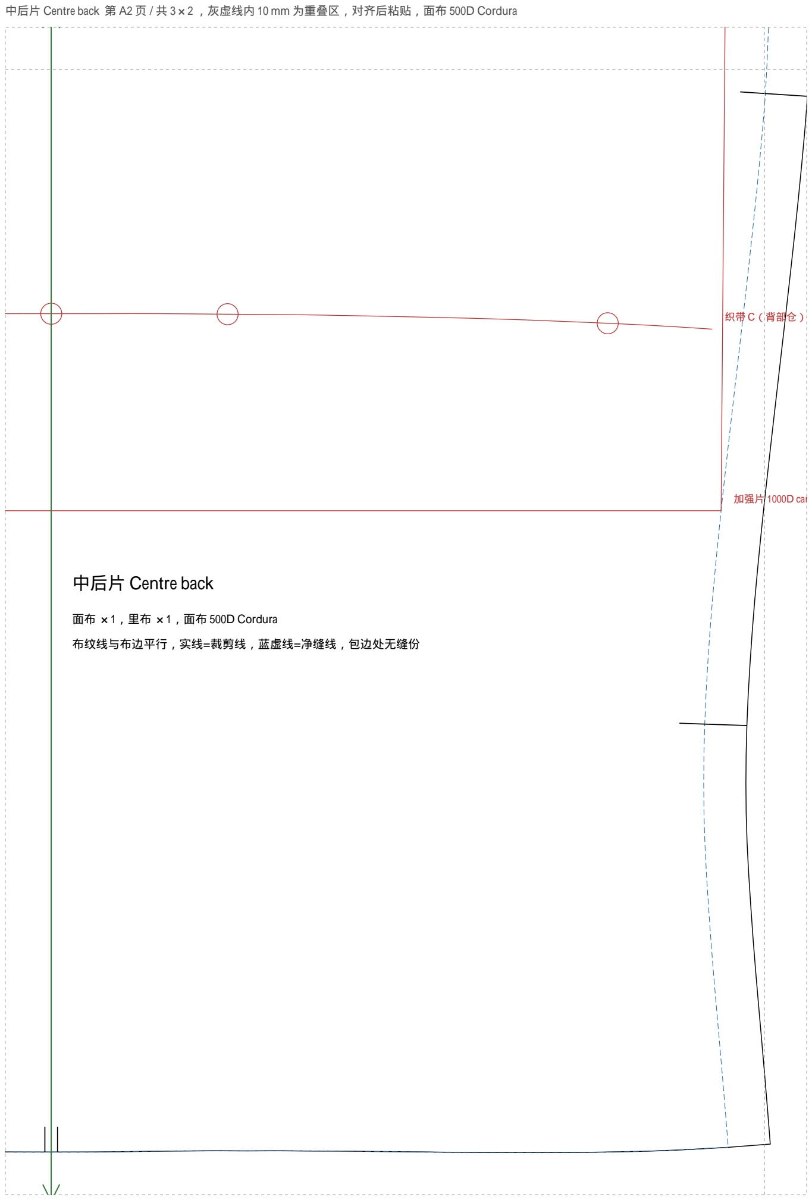
[picture p95: figure]
织带 C（背部仓）/ row C; 加强片 1000D carrier; 中后片 Centre back; 面布 ×1，里布 ×1，面布 500D Cordura; 布纹线与布边平行，实线=裁剪线，蓝虚线=净缝线，包边处无缝份

中后片 Centre back 第 A2 页 / 共 3×2 ，灰虚线内 10 mm 为重叠区，对齐后粘贴，面布 500D Cordura

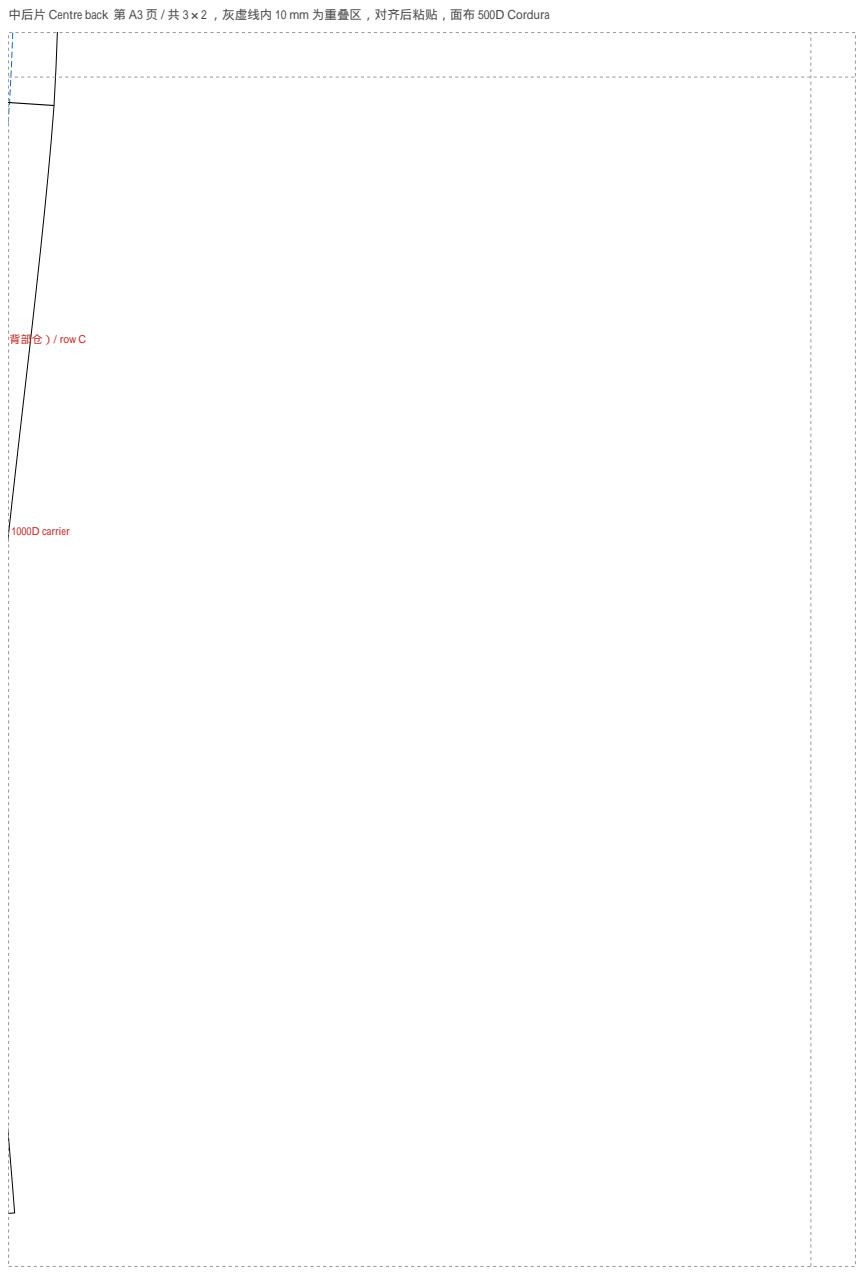
[picture p96: page 6]
加强片 1000D carrier

中后片 Centre back 第 A3 页 / 共 3×2 ，灰虚线内 10 mm 为重叠区，对齐后粘贴，面布 500D Cordura

织带 C（背部仓）/ row C

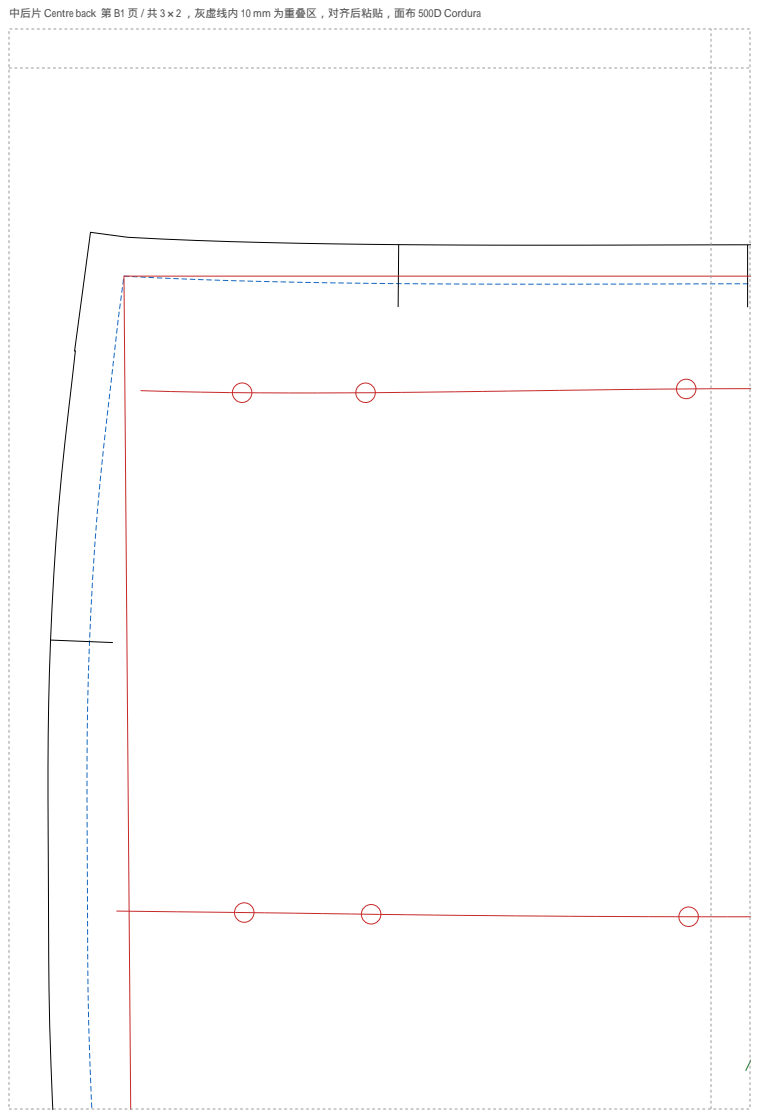
[picture p97: page 7]

中后片 Centre back 第 B1 页 / 共 3×2 ，灰虚线内 10 mm 为重叠区，对齐后粘贴，面布 500D Cordura

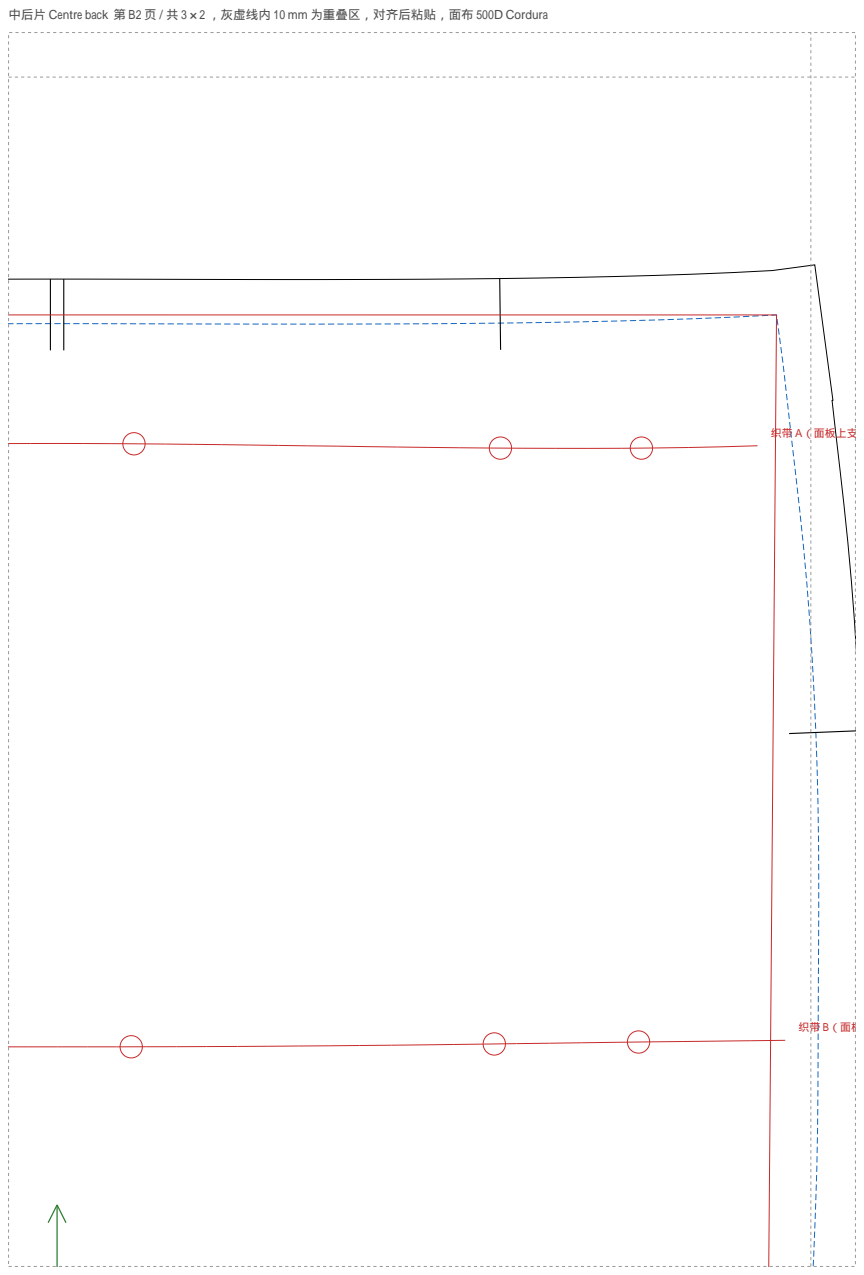
[picture p98: page 8]

中后片 Centre back 第 B2 页 / 共 3×2 ，灰虚线内 10 mm 为重叠区，对齐后粘贴，面布 500D Cordura

织带 A（面板上支脚）/ row A

织带 B（面板下支脚）/ row B

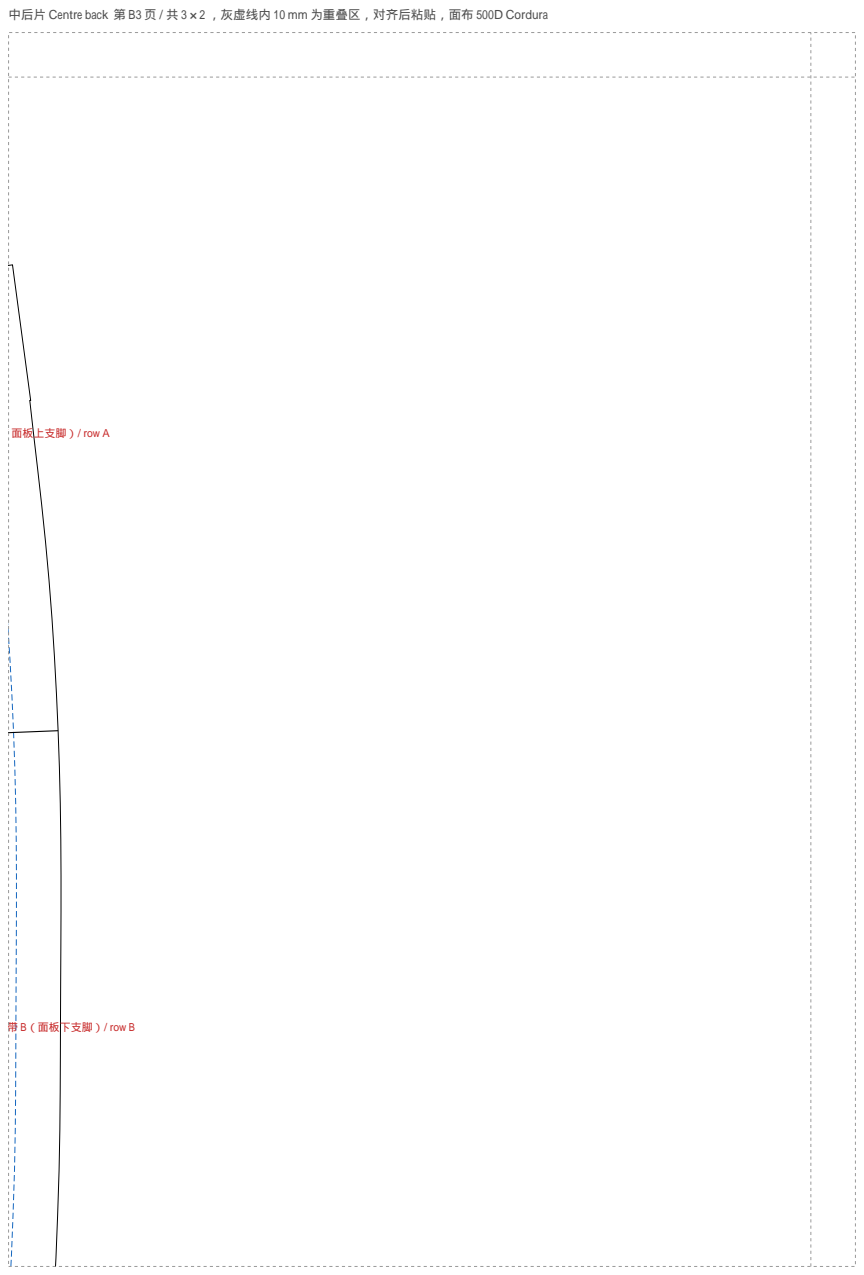
[picture p99: page 9]

中后片 Centre back 第 B3 页 / 共 3×2 ，灰虚线内 10 mm 为重叠区，对齐后粘贴，面布 500D Cordura

织带 A（面板上支脚）/ row A

织带 B（面板下支脚）/ row B

## 左侧后片 Side back L

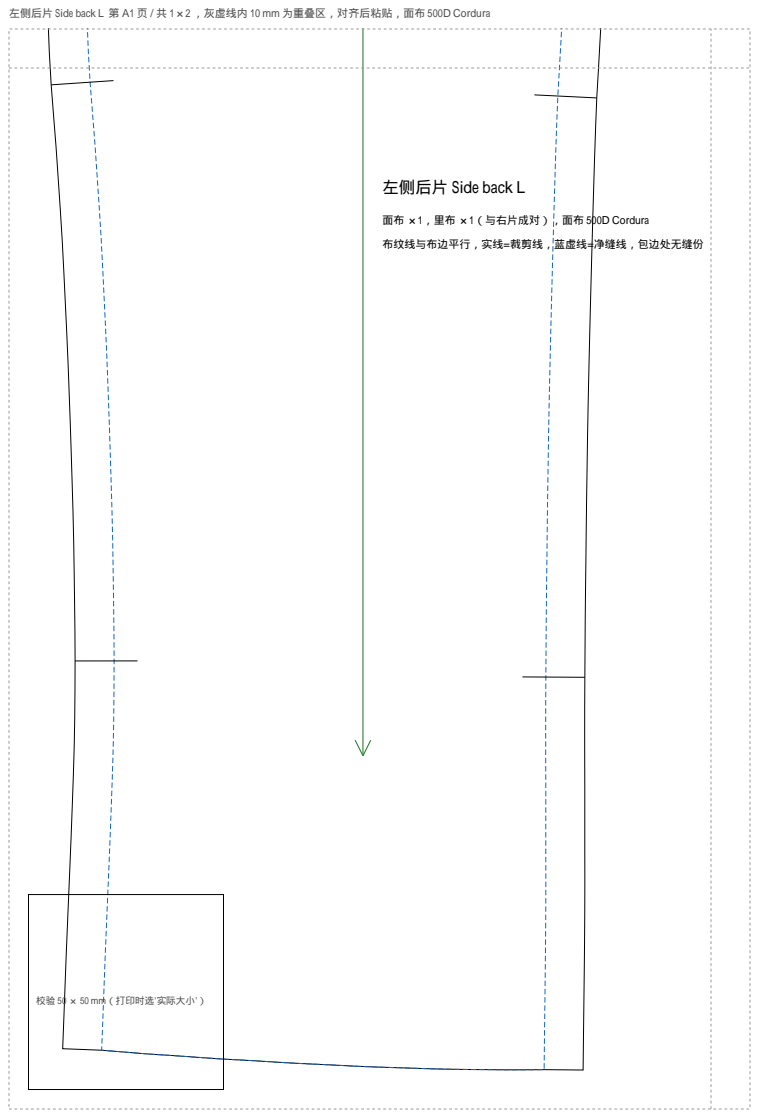
[picture p100: page 10]

左侧后片 Side back L 第 A1 页 / 共 1×2 ，灰虚线内 10 mm 为重叠区，对齐后粘贴，面布 500D Cordura

面布 ×1，里布 ×1（与右片成对），面布 500D Cordura

布纹线与布边平行，实线=裁剪线，蓝虚线=净缝线，包边处无缝份

校验 50 × 50 mm（打印时选'实际大小'）

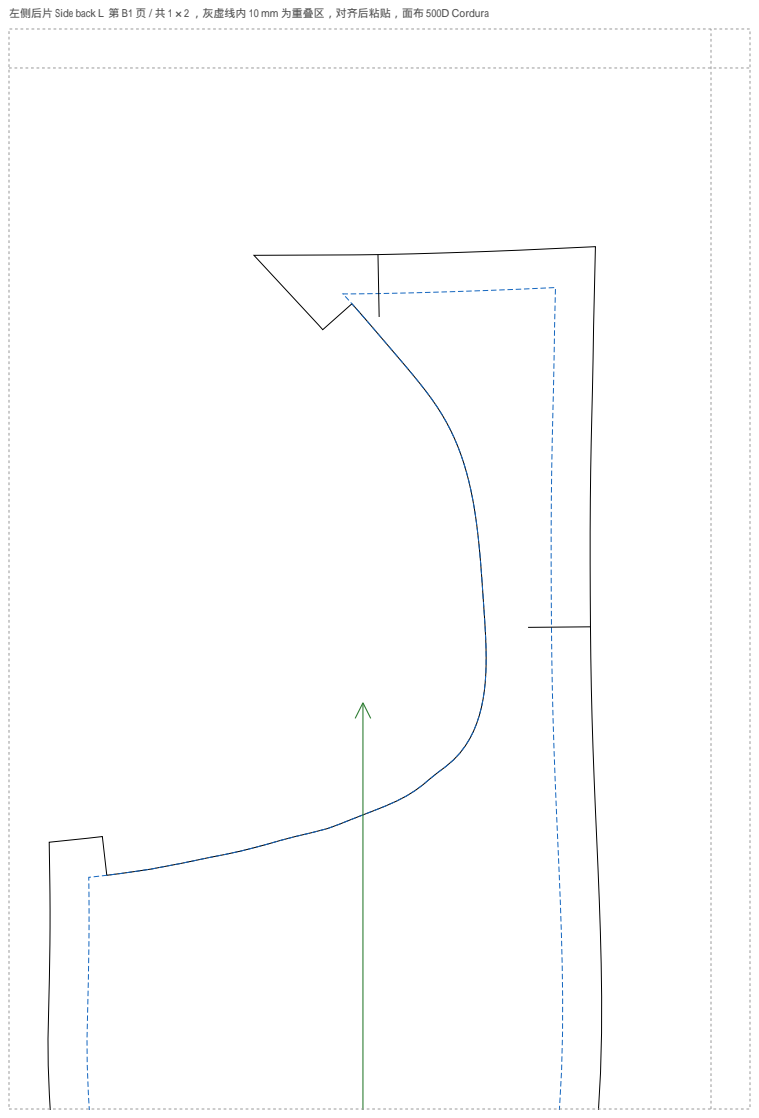
[picture p101: page 11]

左侧后片 Side back L 第 B1 页 / 共 1×2 ，灰虚线内 10 mm 为重叠区，对齐后粘贴，面布 500D Cordura

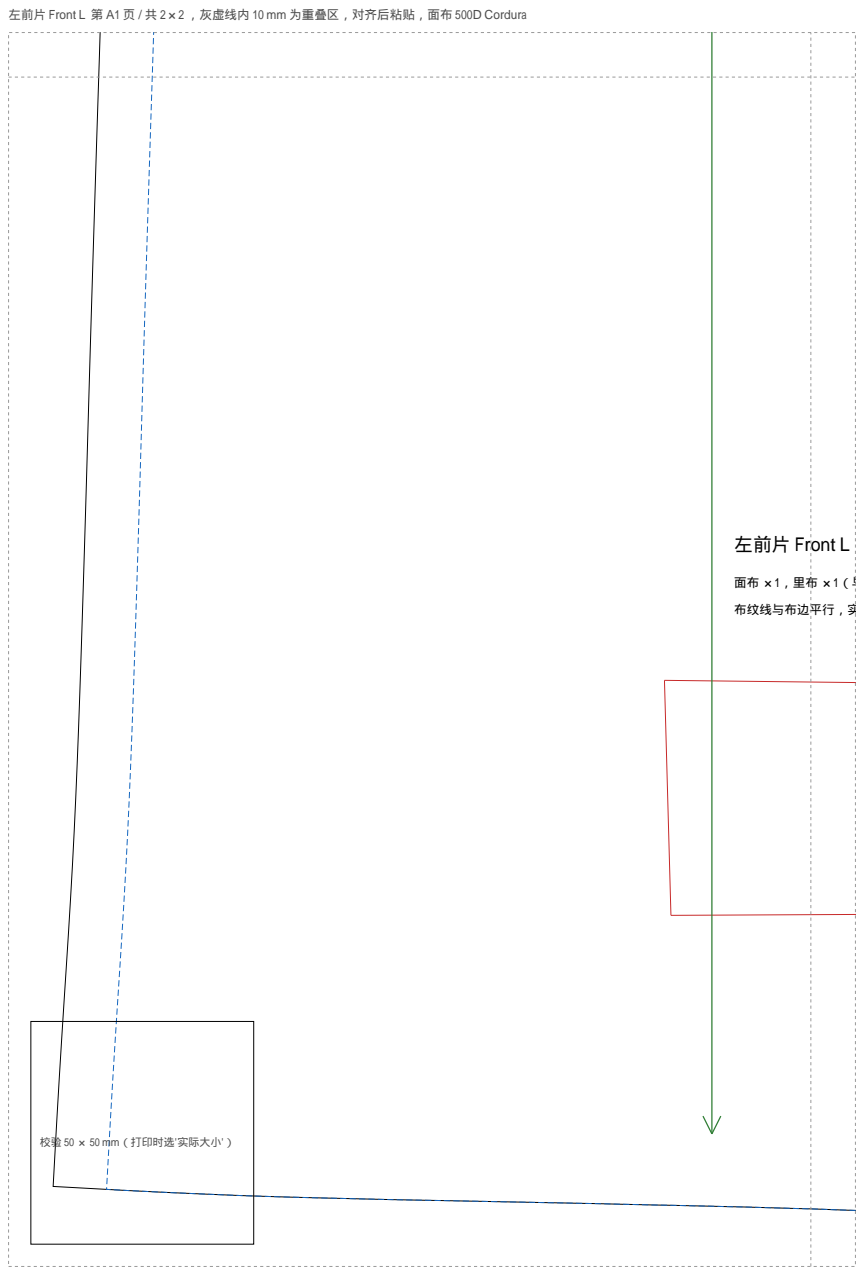
[picture p102: page 12]
热电偶插头袋（P5） 44×54; 左前片 Front L

左前片 Front L 第 A1 页 / 共 2×2 ，灰虚线内 10 mm 为重叠区，对齐后粘贴，面布 500D Cordura

面布 ×1，里布 ×1（与右片成对），面布 500D Cordura

布纹线与布边平行，实线=裁剪线，蓝虚线=净缝线，包边处无缝份

校验 50 × 50 mm（打印时选'实际大小'）

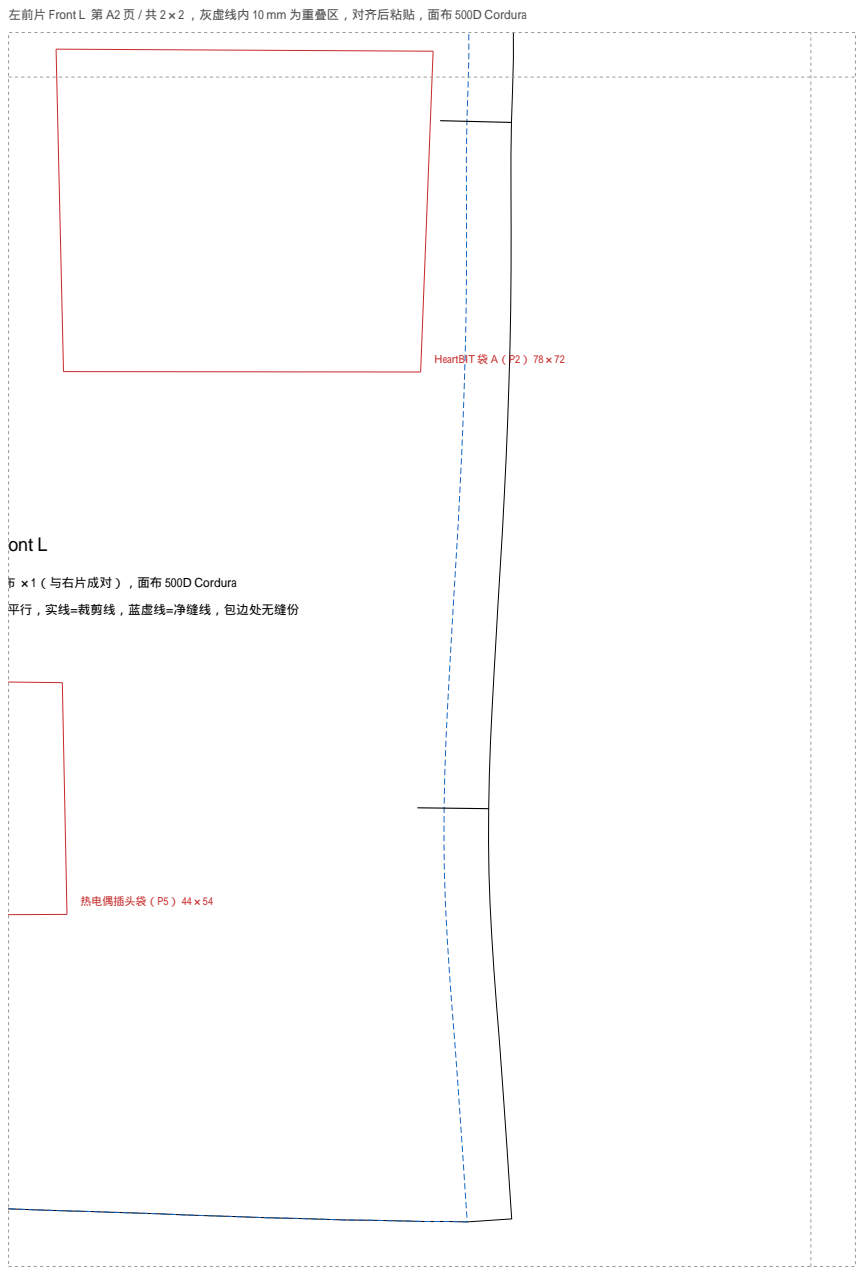
[picture p103: page 13]
HeartBIT 袋 A（P2） 78×72; 热电偶插头袋（P5） 44×54; 左前片 Front L

左前片 Front L 第 A2 页 / 共 2×2 ，灰虚线内 10 mm 为重叠区，对齐后粘贴，面布 500D Cordura

面布 ×1，里布 ×1（与右片成对），面布 500D Cordura

布纹线与布边平行，实线=裁剪线，蓝虚线=净缝线，包边处无缝份

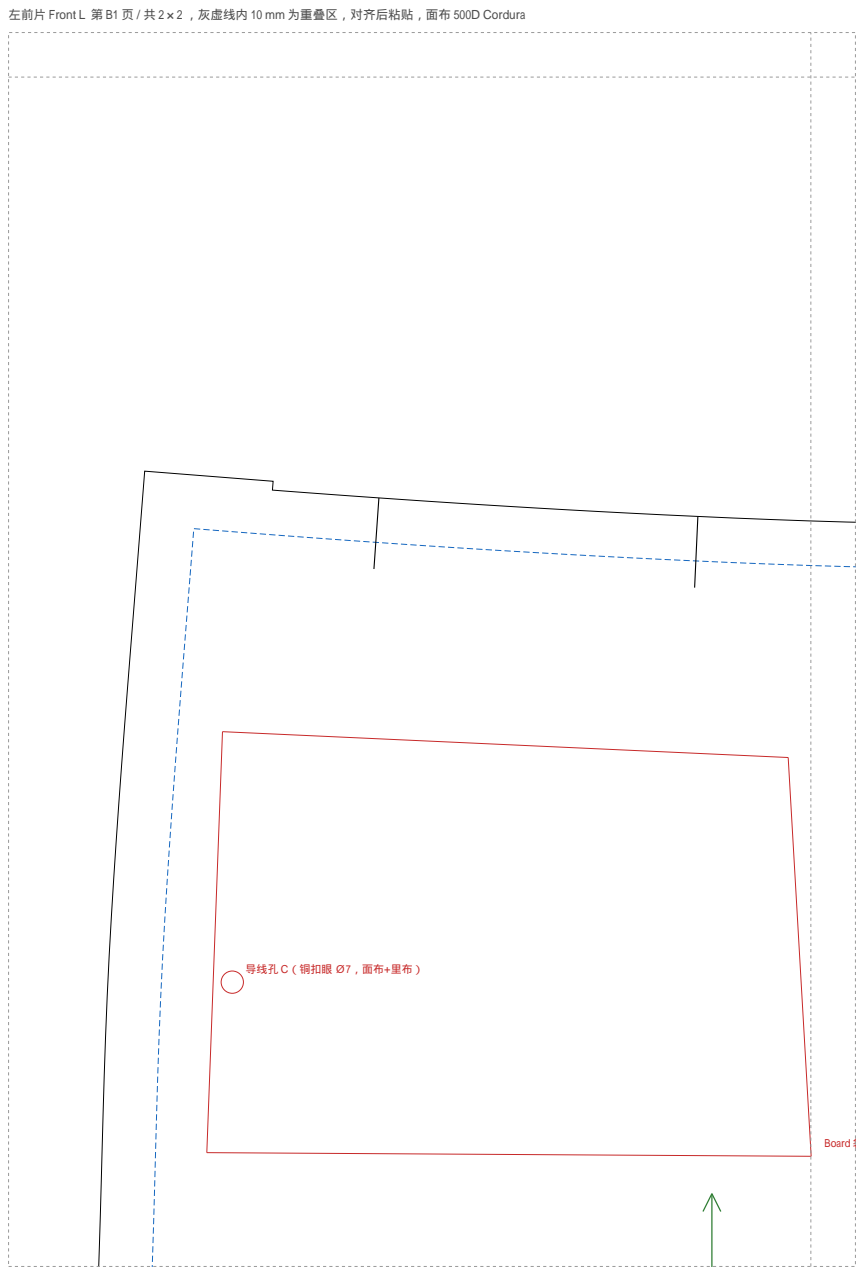
[picture p104: page 14]
Board 袋 C（P3） 130×88

左前片 Front L 第 B1 页 / 共 2×2 ，灰虚线内 10 mm 为重叠区，对齐后粘贴，面布 500D Cordura

导线孔 C（铜扣眼 Ø7，面布+里布）

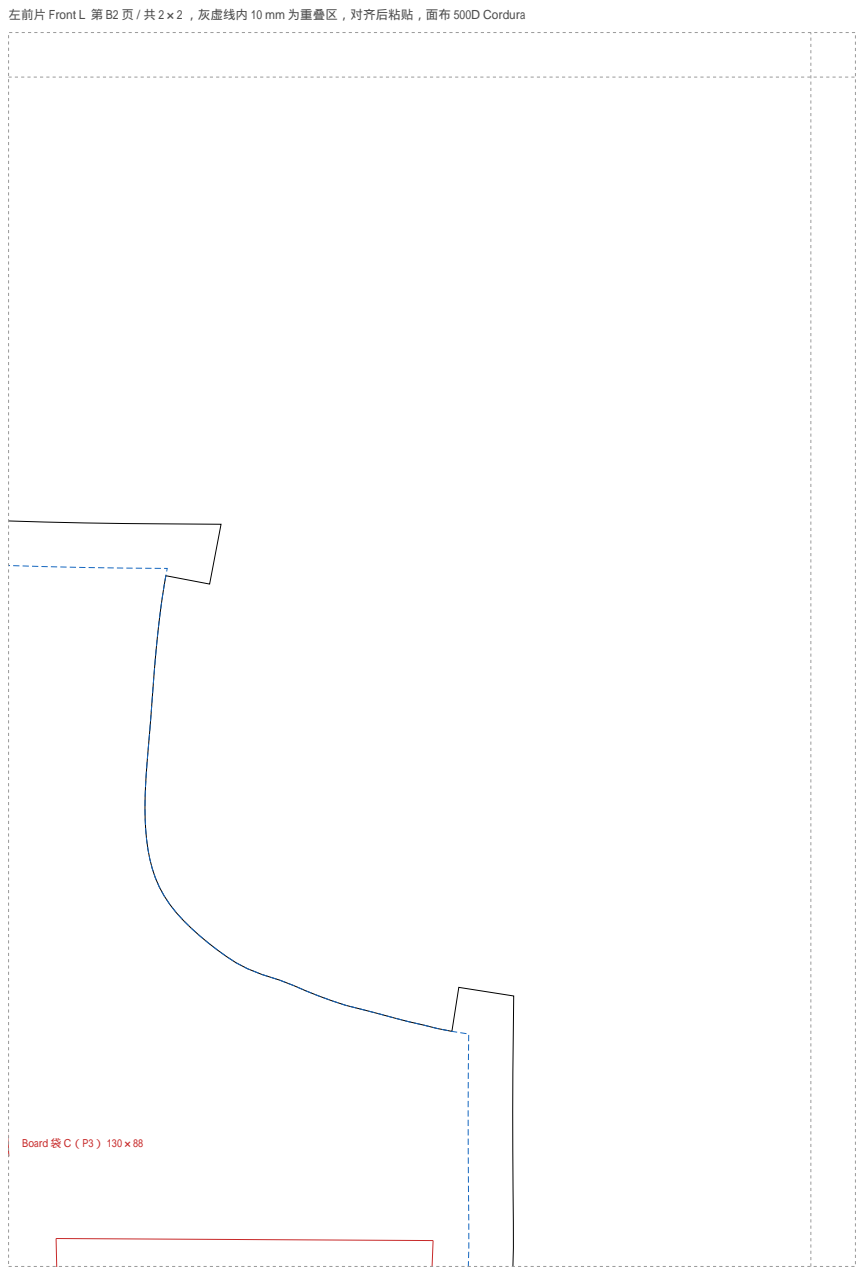
[picture p105: page 15]
Board 袋 C（P3） 130×88

左前片 Front L 第 B2 页 / 共 2×2 ，灰虚线内 10 mm 为重叠区，对齐后粘贴，面布 500D Cordura

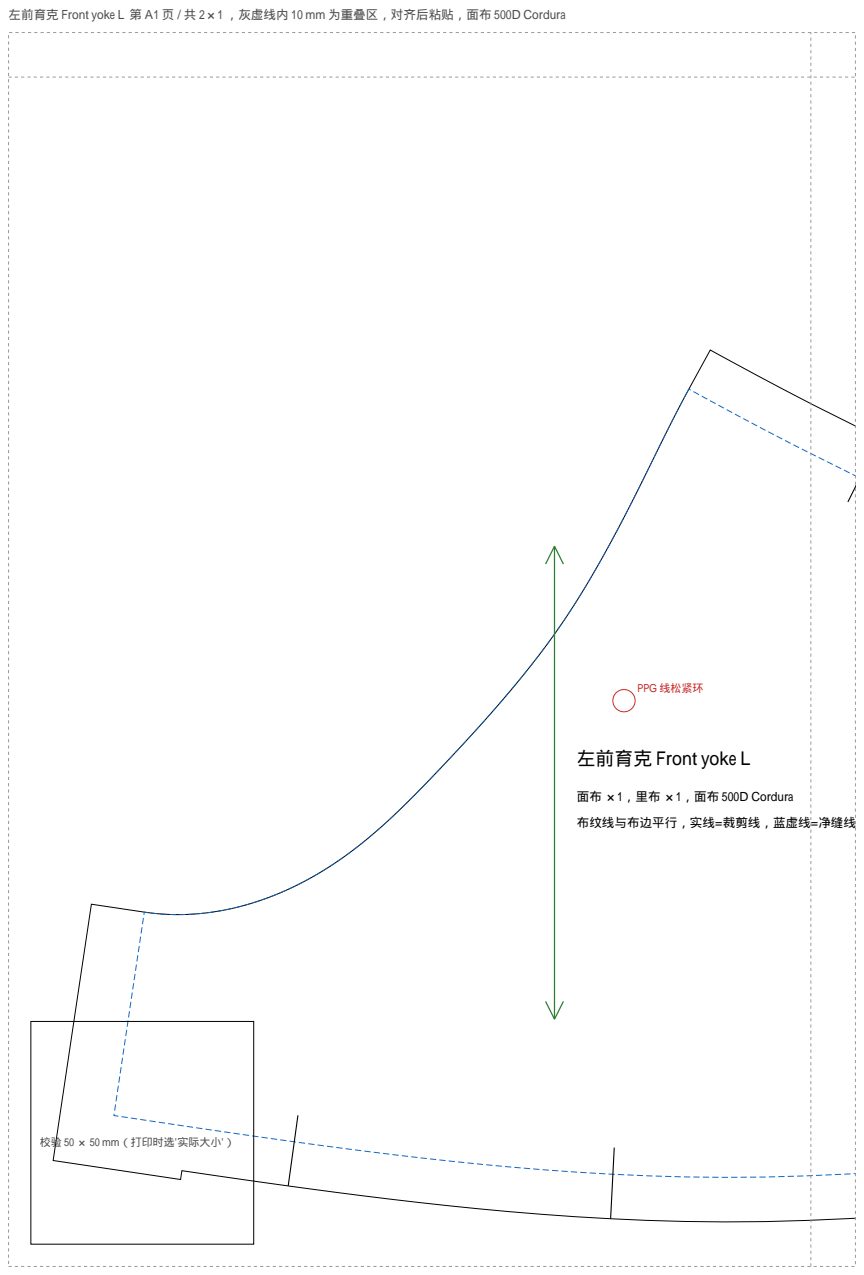
[picture p106: page 16]
PPG 线松紧环

左前育克 Front yoke L 第 A1 页 / 共 2×1 ，灰虚线内 10 mm 为重叠区，对齐后粘贴，面布 500D Cordura

左前育克 Front yoke L

面布 ×1，里布 ×1，面布 500D Cordura

布纹线与布边平行，实线=裁剪线，蓝虚线=净缝线，包边处无缝份

校验 50 × 50 mm（打印时选'实际大小'）

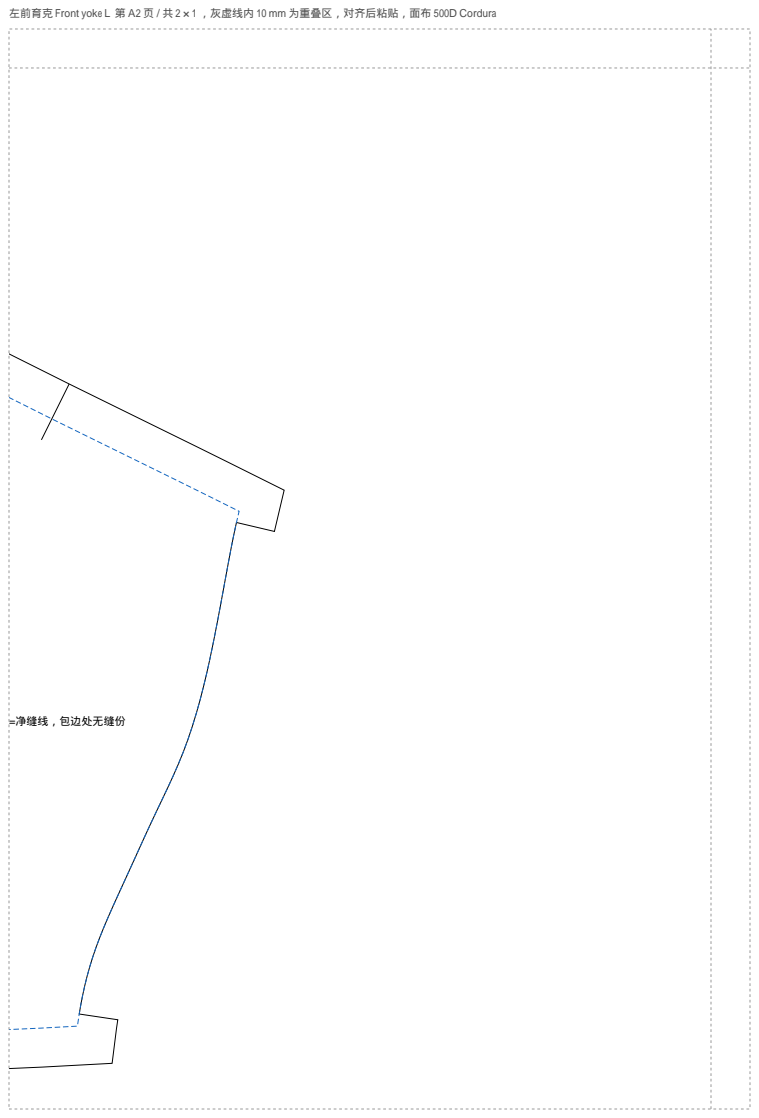
[picture p107: page 17]

左前育克 Front yoke L 第 A2 页 / 共 2×1 ，灰虚线内 10 mm 为重叠区，对齐后粘贴，面布 500D Cordura

面布 ×1，里布 ×1，面布 500D Cordura

布纹线与布边平行，实线=裁剪线，蓝虚线=净缝线，包边处无缝份

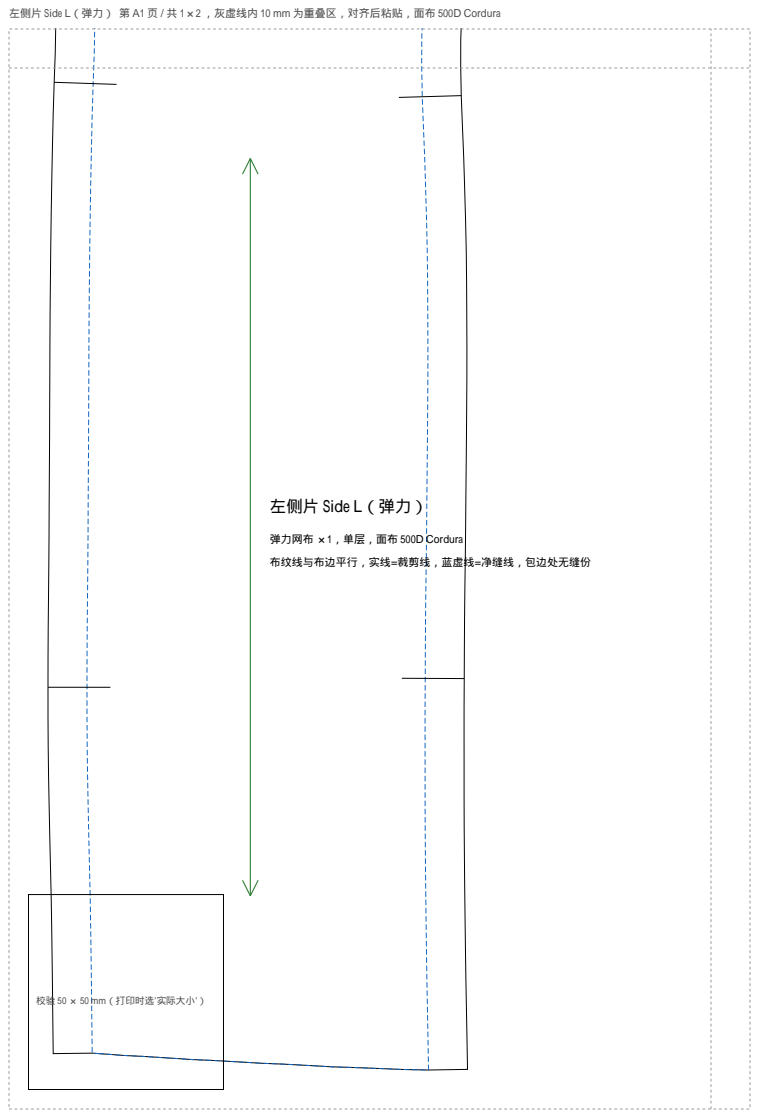
[picture p108: page 18]

左侧片 Side L（弹力） 第 A1 页 / 共 1×2 ，灰虚线内 10 mm 为重叠区，对齐后粘贴，面布 500D Cordura

左侧片 Side L（弹力）

弹力网布 ×1，单层，面布 500D Cordura

布纹线与布边平行，实线=裁剪线，蓝虚线=净缝线，包边处无缝份

校验 50 × 50 mm（打印时选'实际大小'）

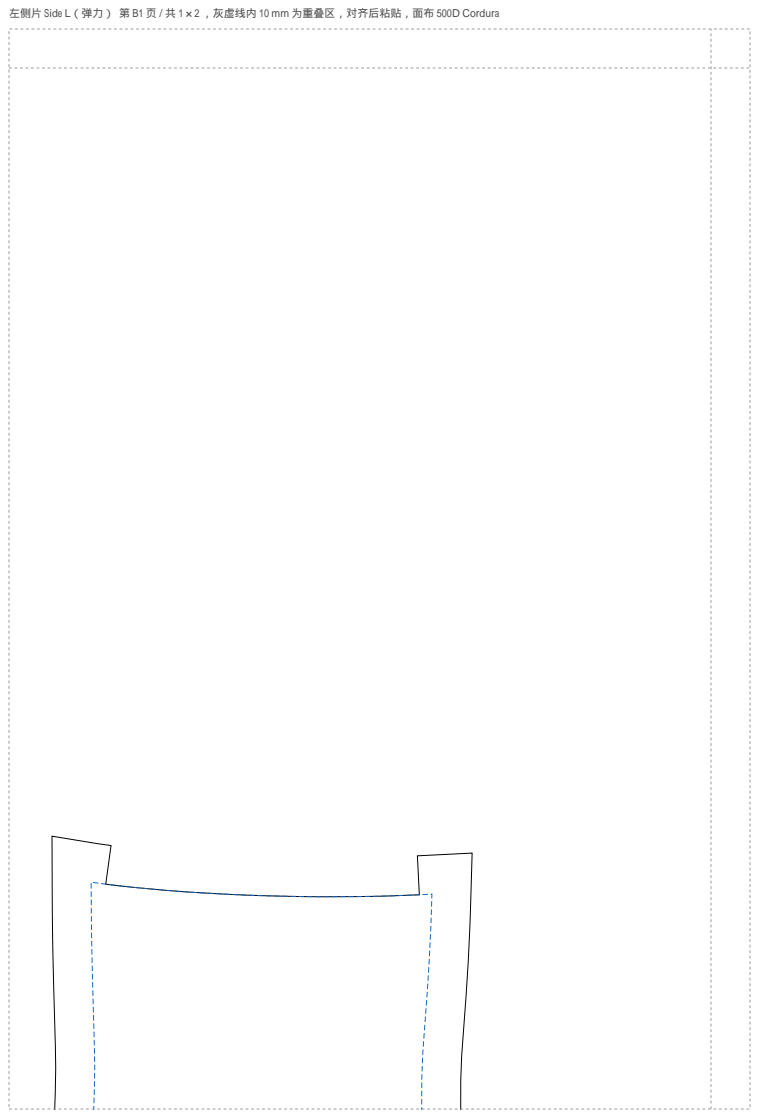
[picture p109: page 19]

左侧片 Side L（弹力） 第 B1 页 / 共 1×2 ，灰虚线内 10 mm 为重叠区，对齐后粘贴，面布 500D Cordura

## 右侧后片 Side back R

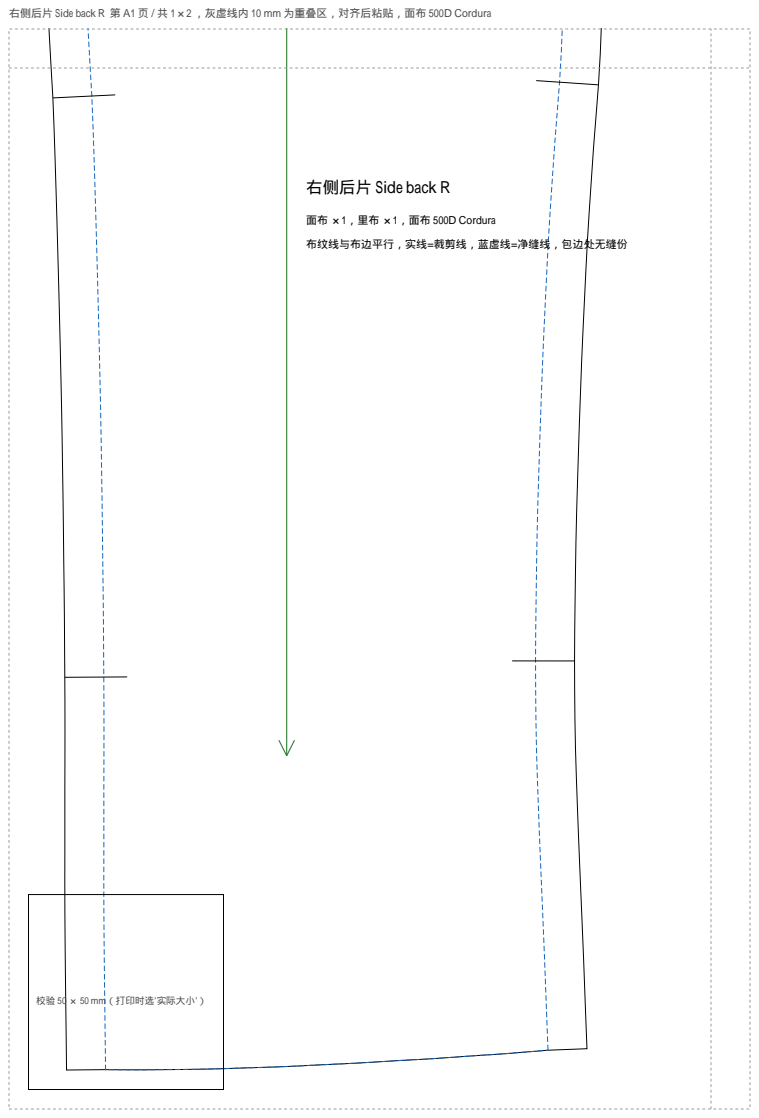
[picture p110: page 20]

右侧后片 Side back R 第 A1 页 / 共 1×2 ，灰虚线内 10 mm 为重叠区，对齐后粘贴，面布 500D Cordura

面布 ×1，里布 ×1，面布 500D Cordura

布纹线与布边平行，实线=裁剪线，蓝虚线=净缝线，包边处无缝份

校验 50 × 50 mm（打印时选'实际大小'）

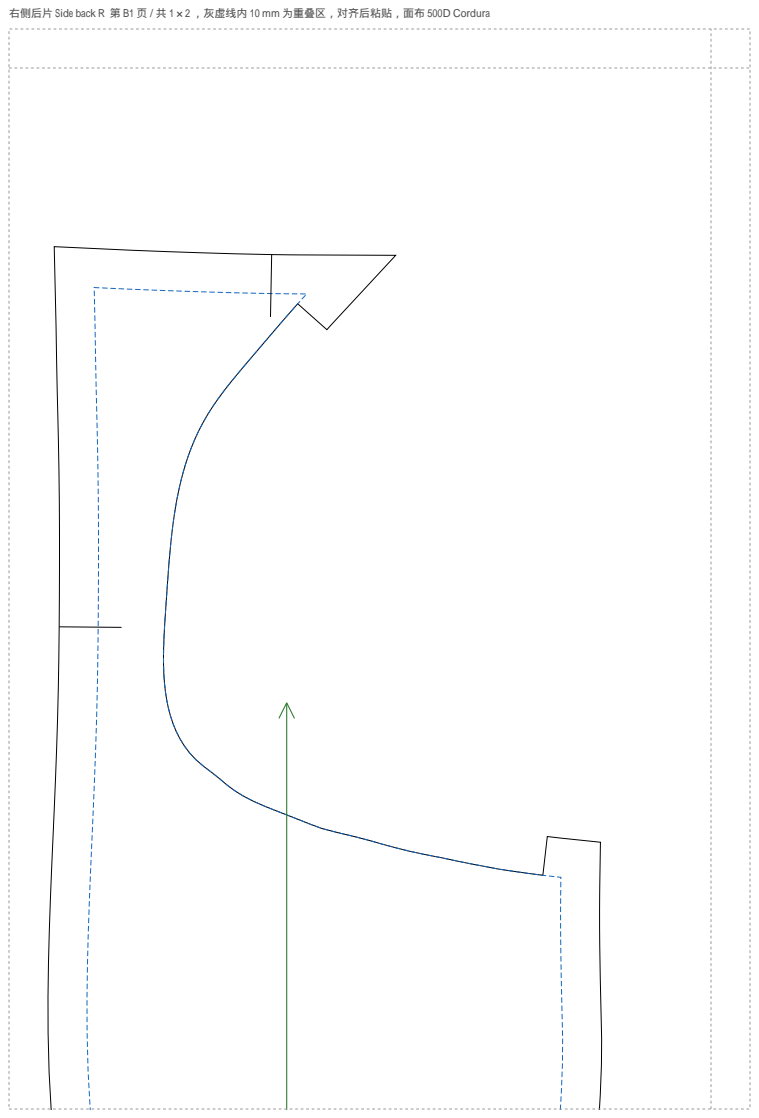
[picture p111: page 21]

右侧后片 Side back R 第 B1 页 / 共 1×2 ，灰虚线内 10 mm 为重叠区，对齐后粘贴，面布 500D Cordura

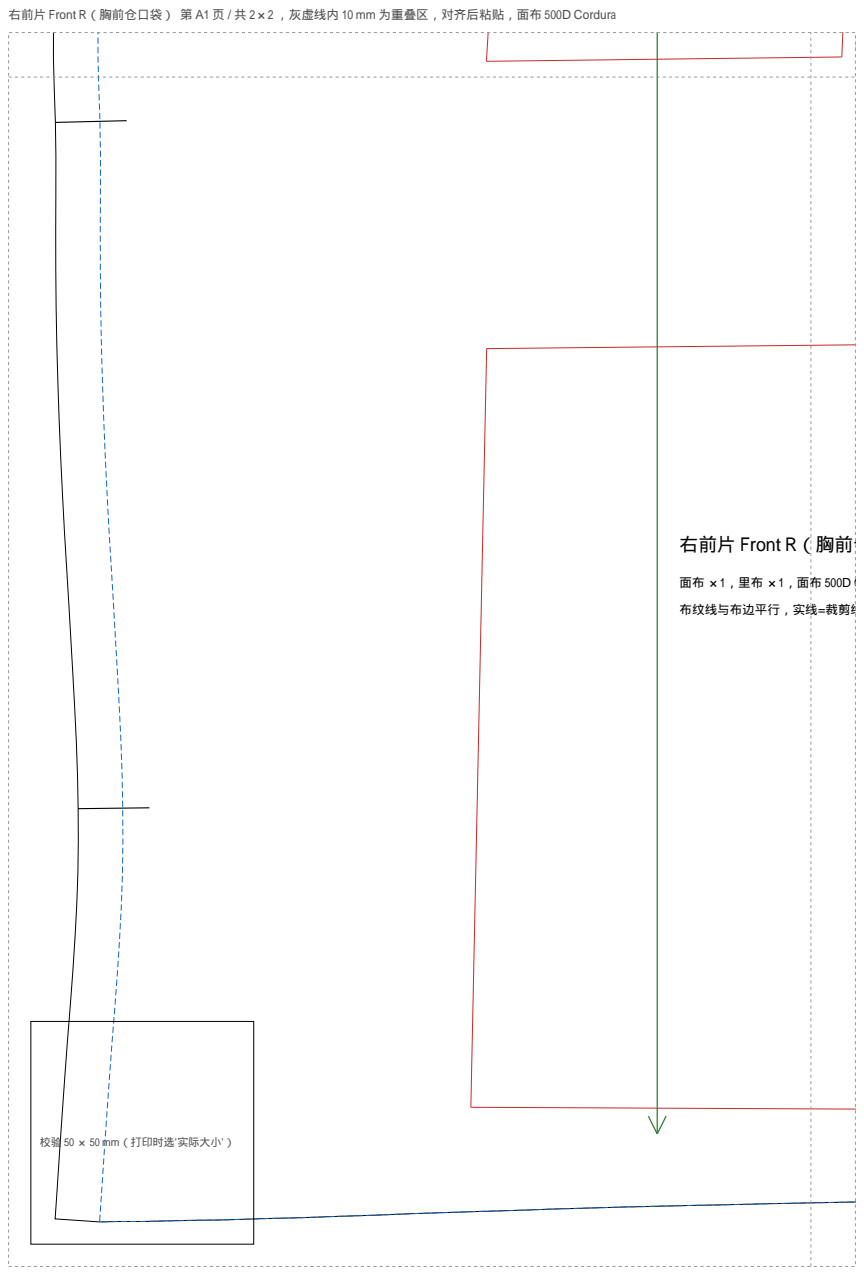
[picture p112: page 22]
胸前仓口袋 B（P1） 75×125; 手机袋（P4） 86×172

右前片 Front R（胸前仓口袋） 第 A1 页 / 共 2×2 ，灰虚线内 10 mm 为重叠区，对齐后粘贴，面布 500D Cordura

右前片 Front R（胸前仓口袋）

面布 ×1，里布 ×1，面布 500D Cordura

布纹线与布边平行，实线=裁剪线，蓝虚线=净缝线，包边处无缝份

校验 50 × 50 mm（打印时选'实际大小'）

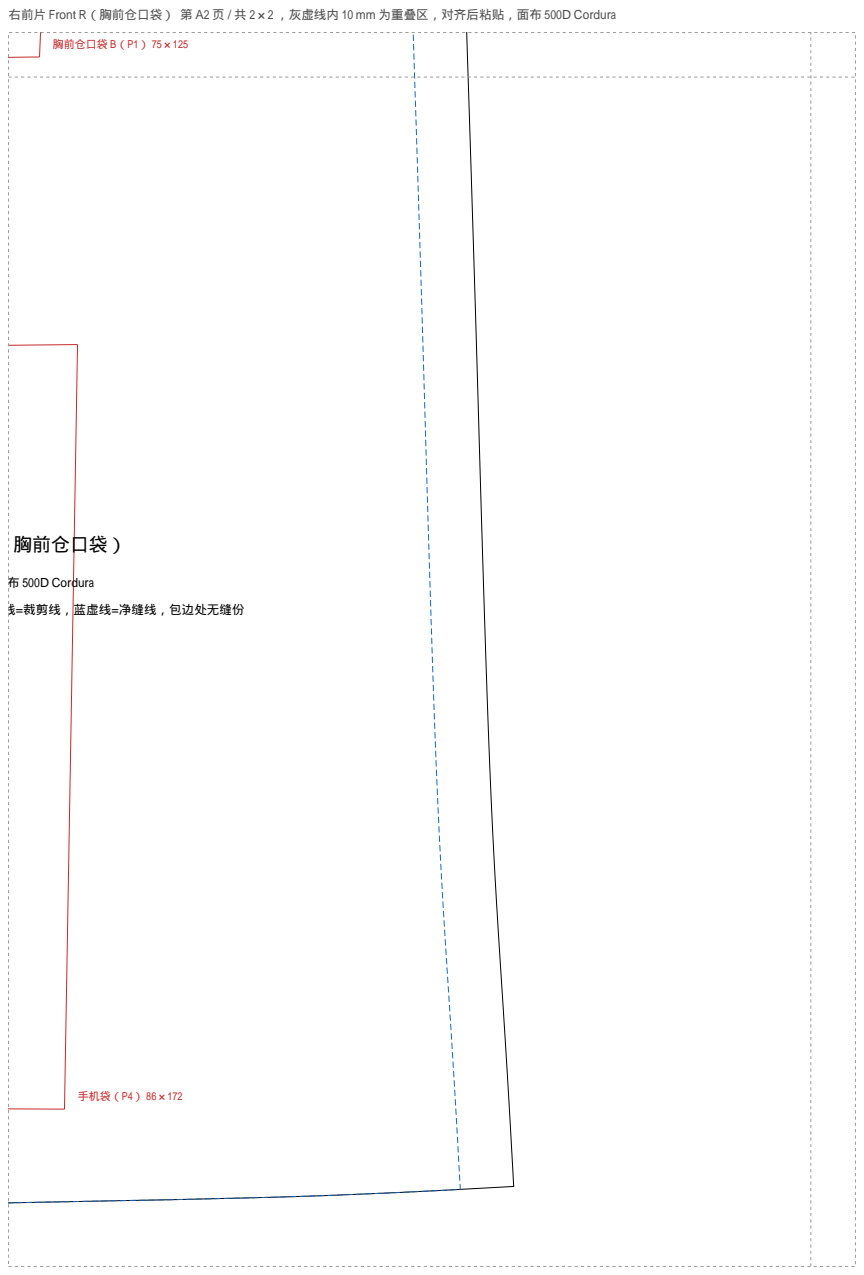
[picture p113: page 23]
胸前仓口袋 B（P1） 75×125; 手机袋（P4） 86×172

右前片 Front R（胸前仓口袋） 第 A2 页 / 共 2×2 ，灰虚线内 10 mm 为重叠区，对齐后粘贴，面布 500D Cordura

右前片 Front R（胸前仓口袋）

面布 ×1，里布 ×1，面布 500D Cordura

布纹线与布边平行，实线=裁剪线，蓝虚线=净缝线，包边处无缝份

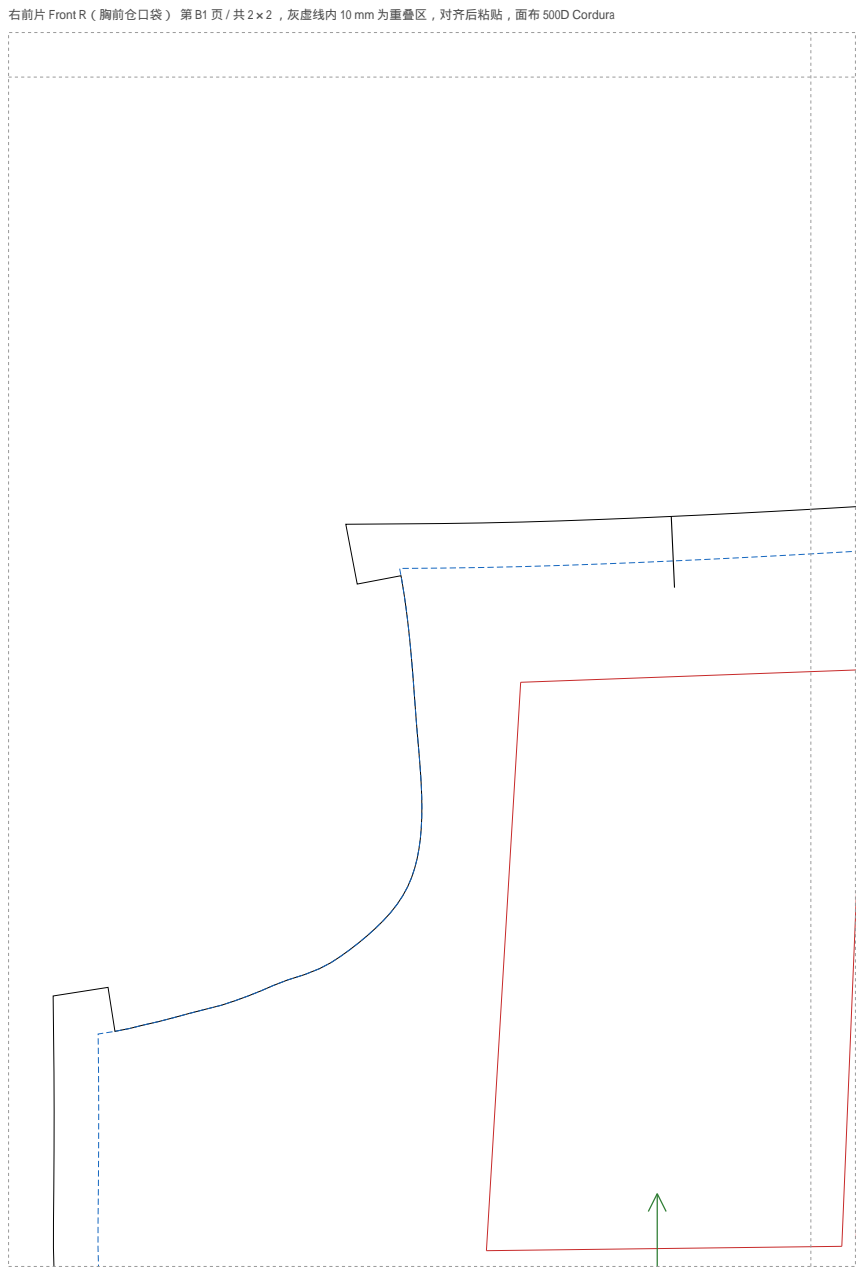
[picture p114: page 24]
胸前仓口袋 B（P1） 75×125

右前片 Front R（胸前仓口袋） 第 B1 页 / 共 2×2 ，灰虚线内 10 mm 为重叠区，对齐后粘贴，面布 500D Cordura

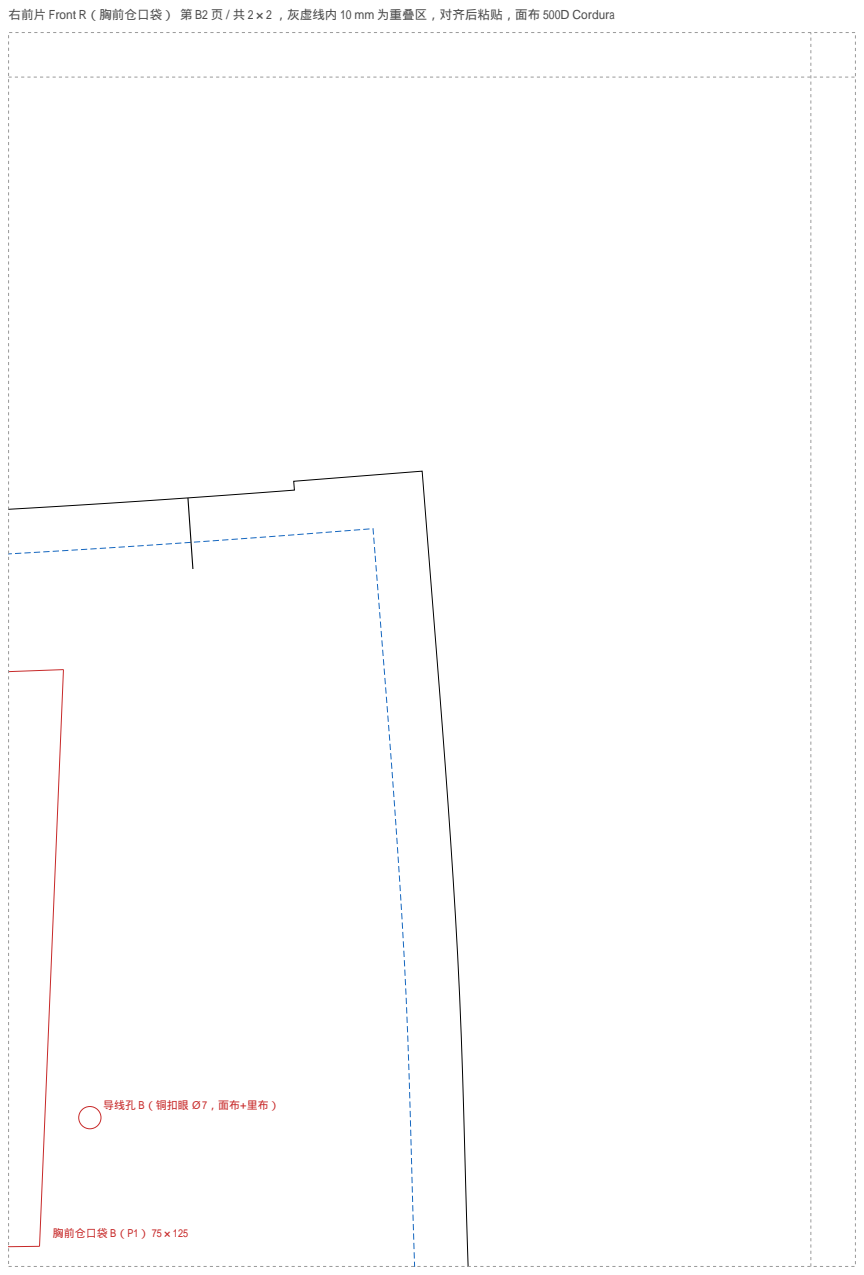
[picture p115: page 25]
胸前仓口袋 B（P1） 75×125

右前片 Front R（胸前仓口袋） 第 B2 页 / 共 2×2 ，灰虚线内 10 mm 为重叠区，对齐后粘贴，面布 500D Cordura

导线孔 B（铜扣眼 Ø7，面布+里布）

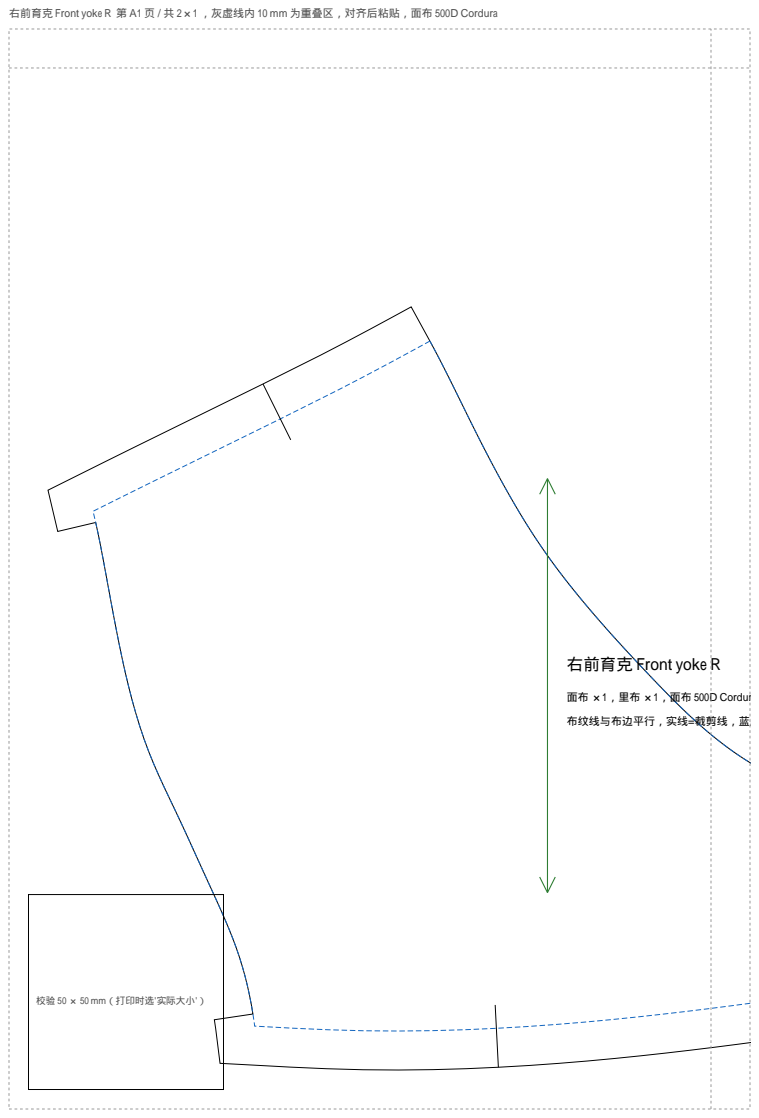
[picture p116: page 26]

右前育克 Front yoke R 第 A1 页 / 共 2×1 ，灰虚线内 10 mm 为重叠区，对齐后粘贴，面布 500D Cordura

右前育克 Front yoke R

面布 ×1，里布 ×1，面布 500D Cordura

布纹线与布边平行，实线=裁剪线，蓝虚线=净缝线，包边处无缝份

校验 50 × 50 mm（打印时选'实际大小'）

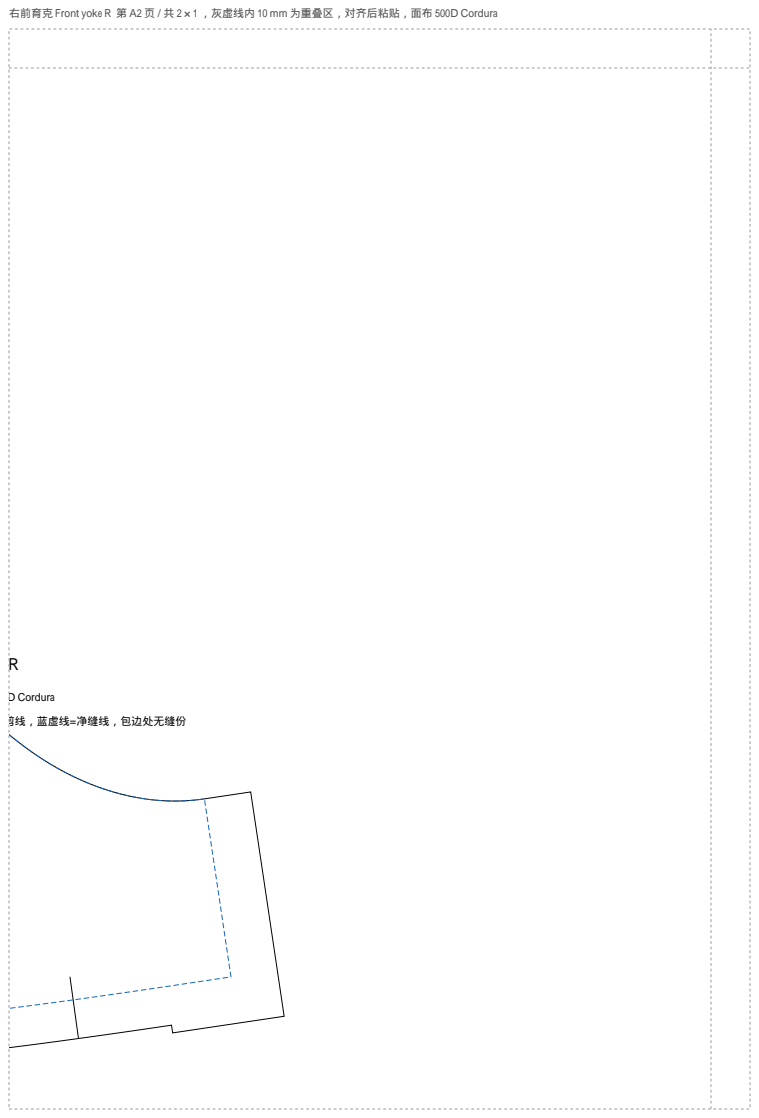
[picture p117: page 27]

右前育克 Front yoke R 第 A2 页 / 共 2×1 ，灰虚线内 10 mm 为重叠区，对齐后粘贴，面布 500D Cordura

右前育克 Front yoke R

面布 ×1，里布 ×1，面布 500D Cordura

布纹线与布边平行，实线=裁剪线，蓝虚线=净缝线，包边处无缝份

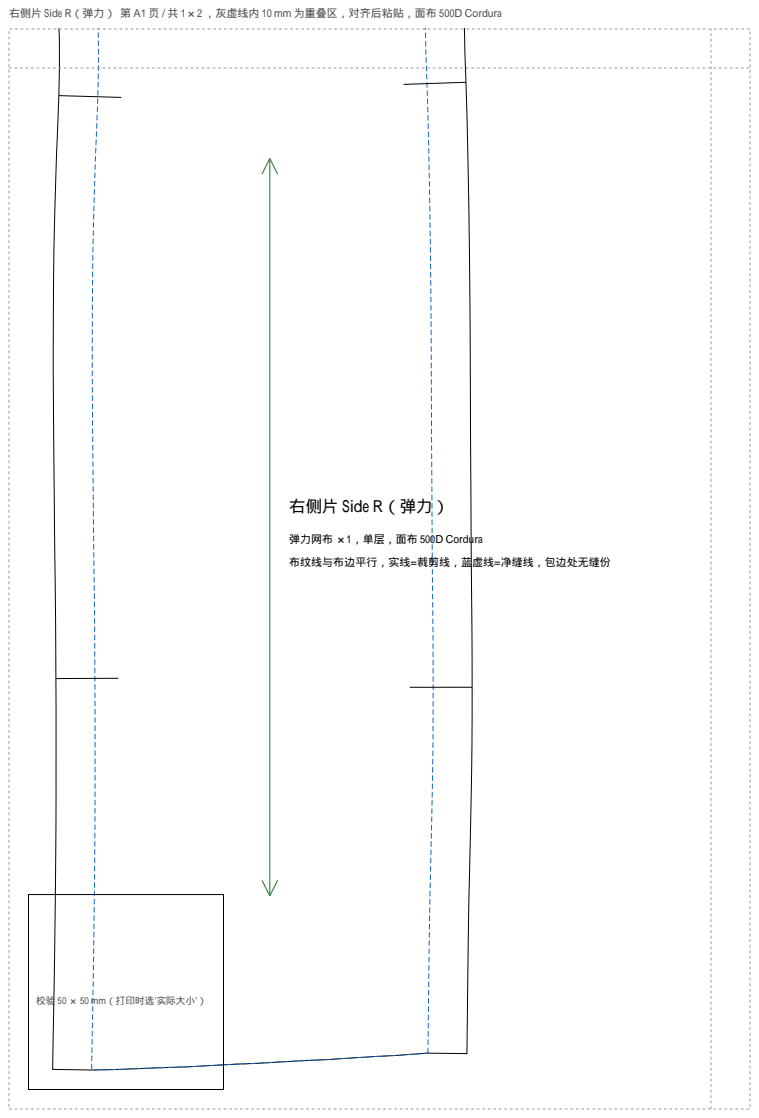
[picture p118: page 28]

右侧片 Side R（弹力） 第 A1 页 / 共 1×2 ，灰虚线内 10 mm 为重叠区，对齐后粘贴，面布 500D Cordura

右侧片 Side R（弹力）

弹力网布 ×1，单层，面布 500D Cordura

布纹线与布边平行，实线=裁剪线，蓝虚线=净缝线，包边处无缝份

校验 50 × 50 mm（打印时选'实际大小'）

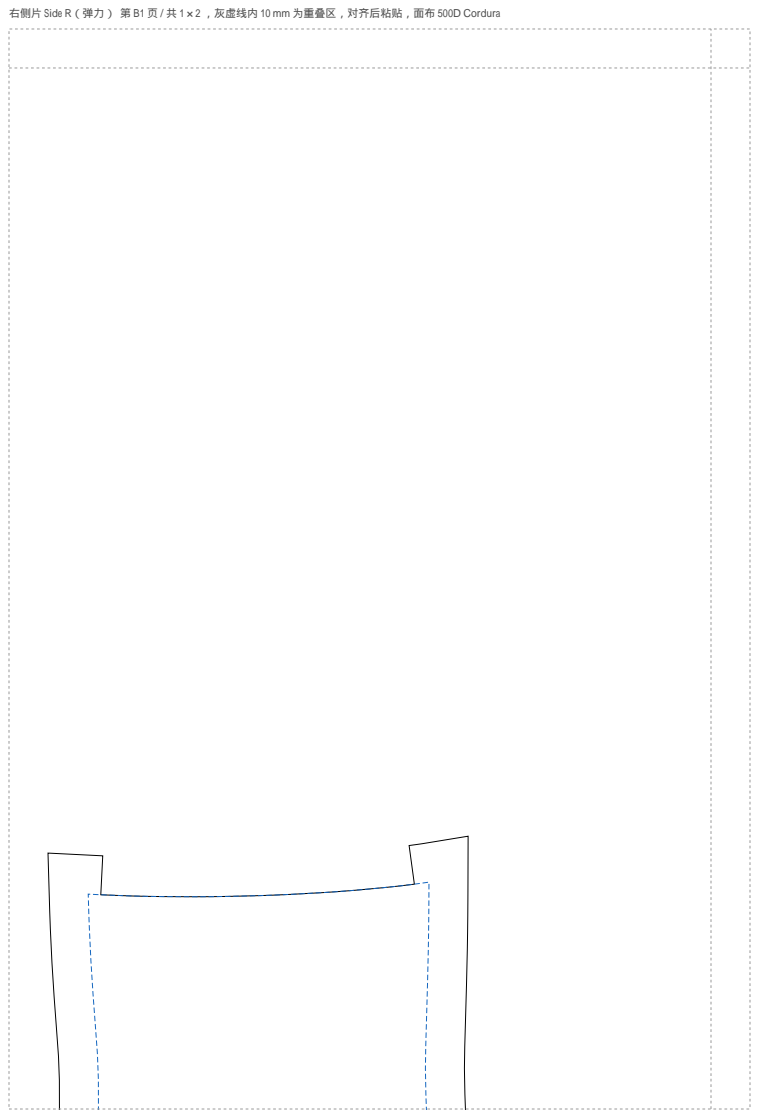
[picture p119: page 29]

右侧片 Side R（弹力） 第 B1 页 / 共 1×2 ，灰虚线内 10 mm 为重叠区，对齐后粘贴，面布 500D Cordura
