3351666087/solar-vest/hardware/vest/pattern_shell_plotter-1to1.pdf

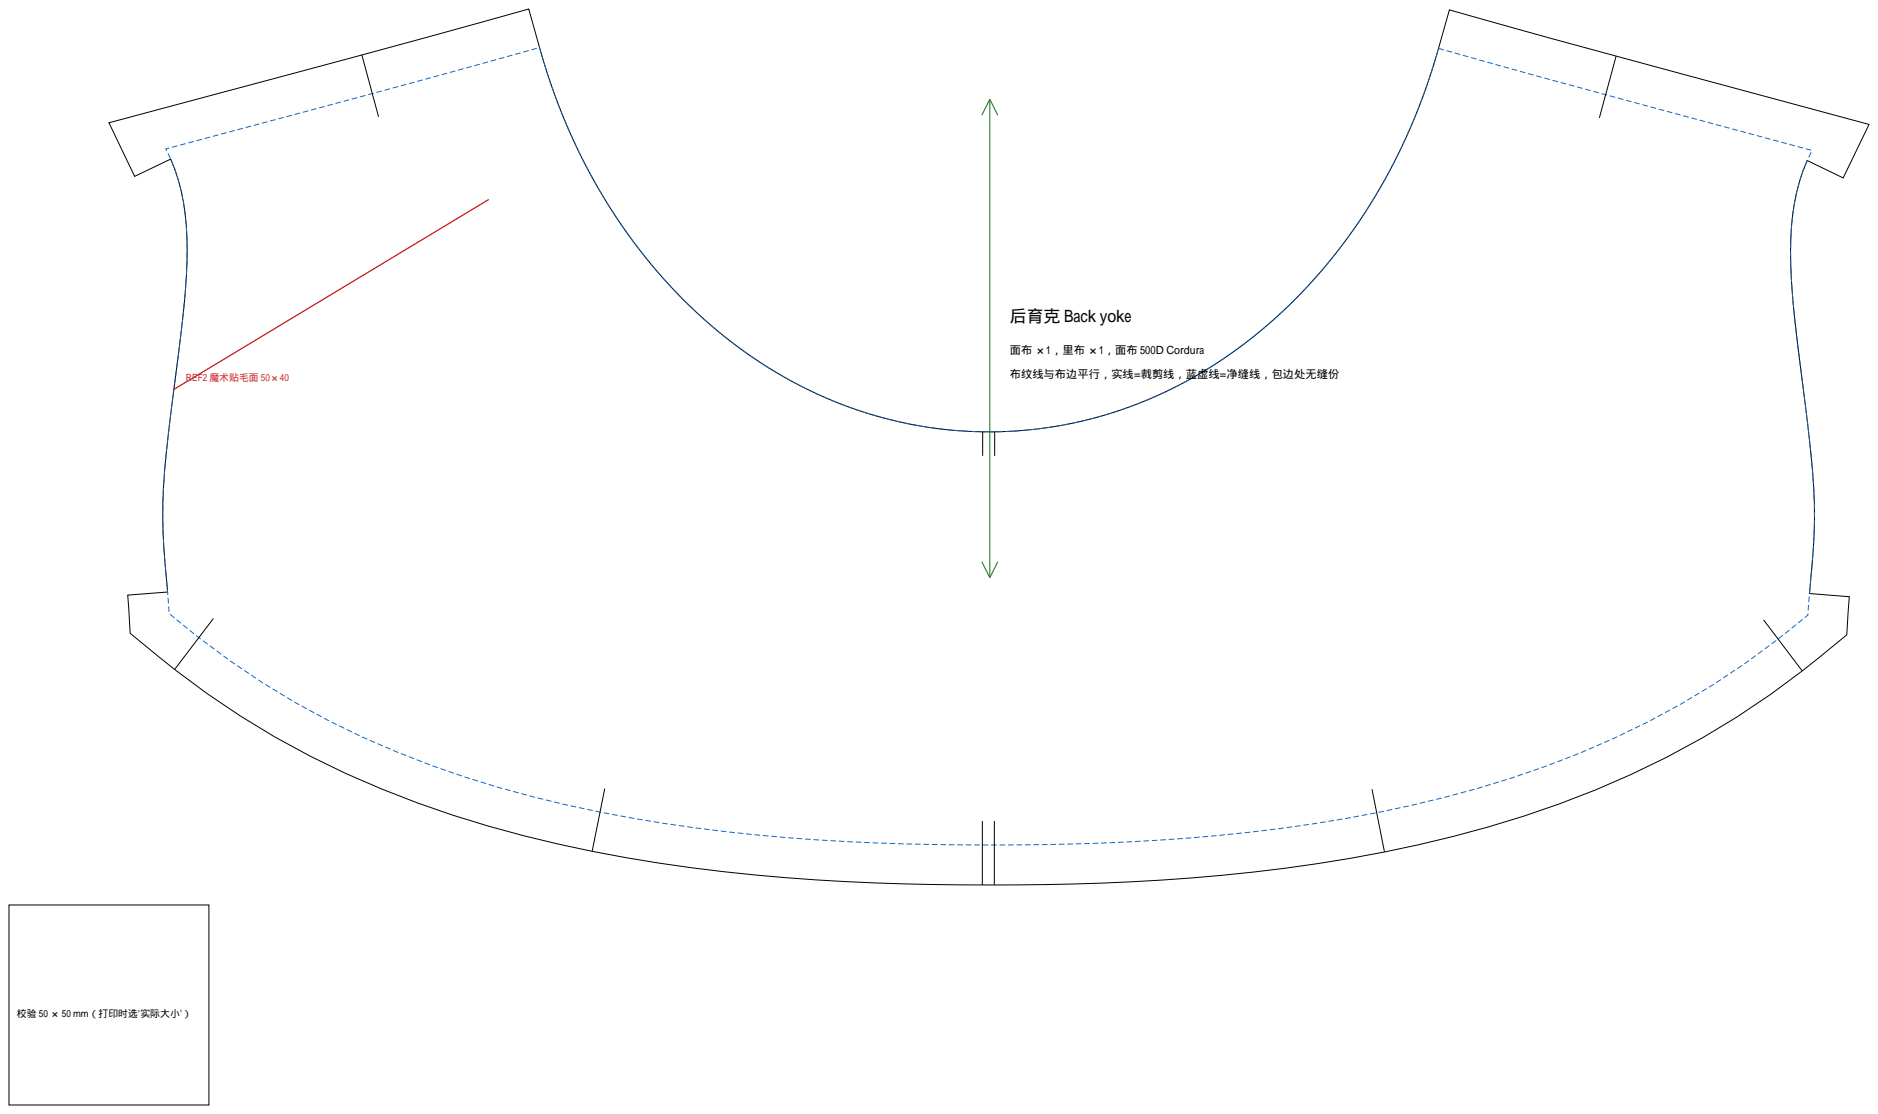
[picture p120: page 1]
REF2 魔术贴毛面 50×40

后育克 Back yoke

面布 ×1，里布 ×1，面布 500D Cordura

布纹线与布边平行，实线=裁剪线，蓝虚线=净缝线，包边处无缝份

校验 50 × 50 mm（打印时选'实际大小'）

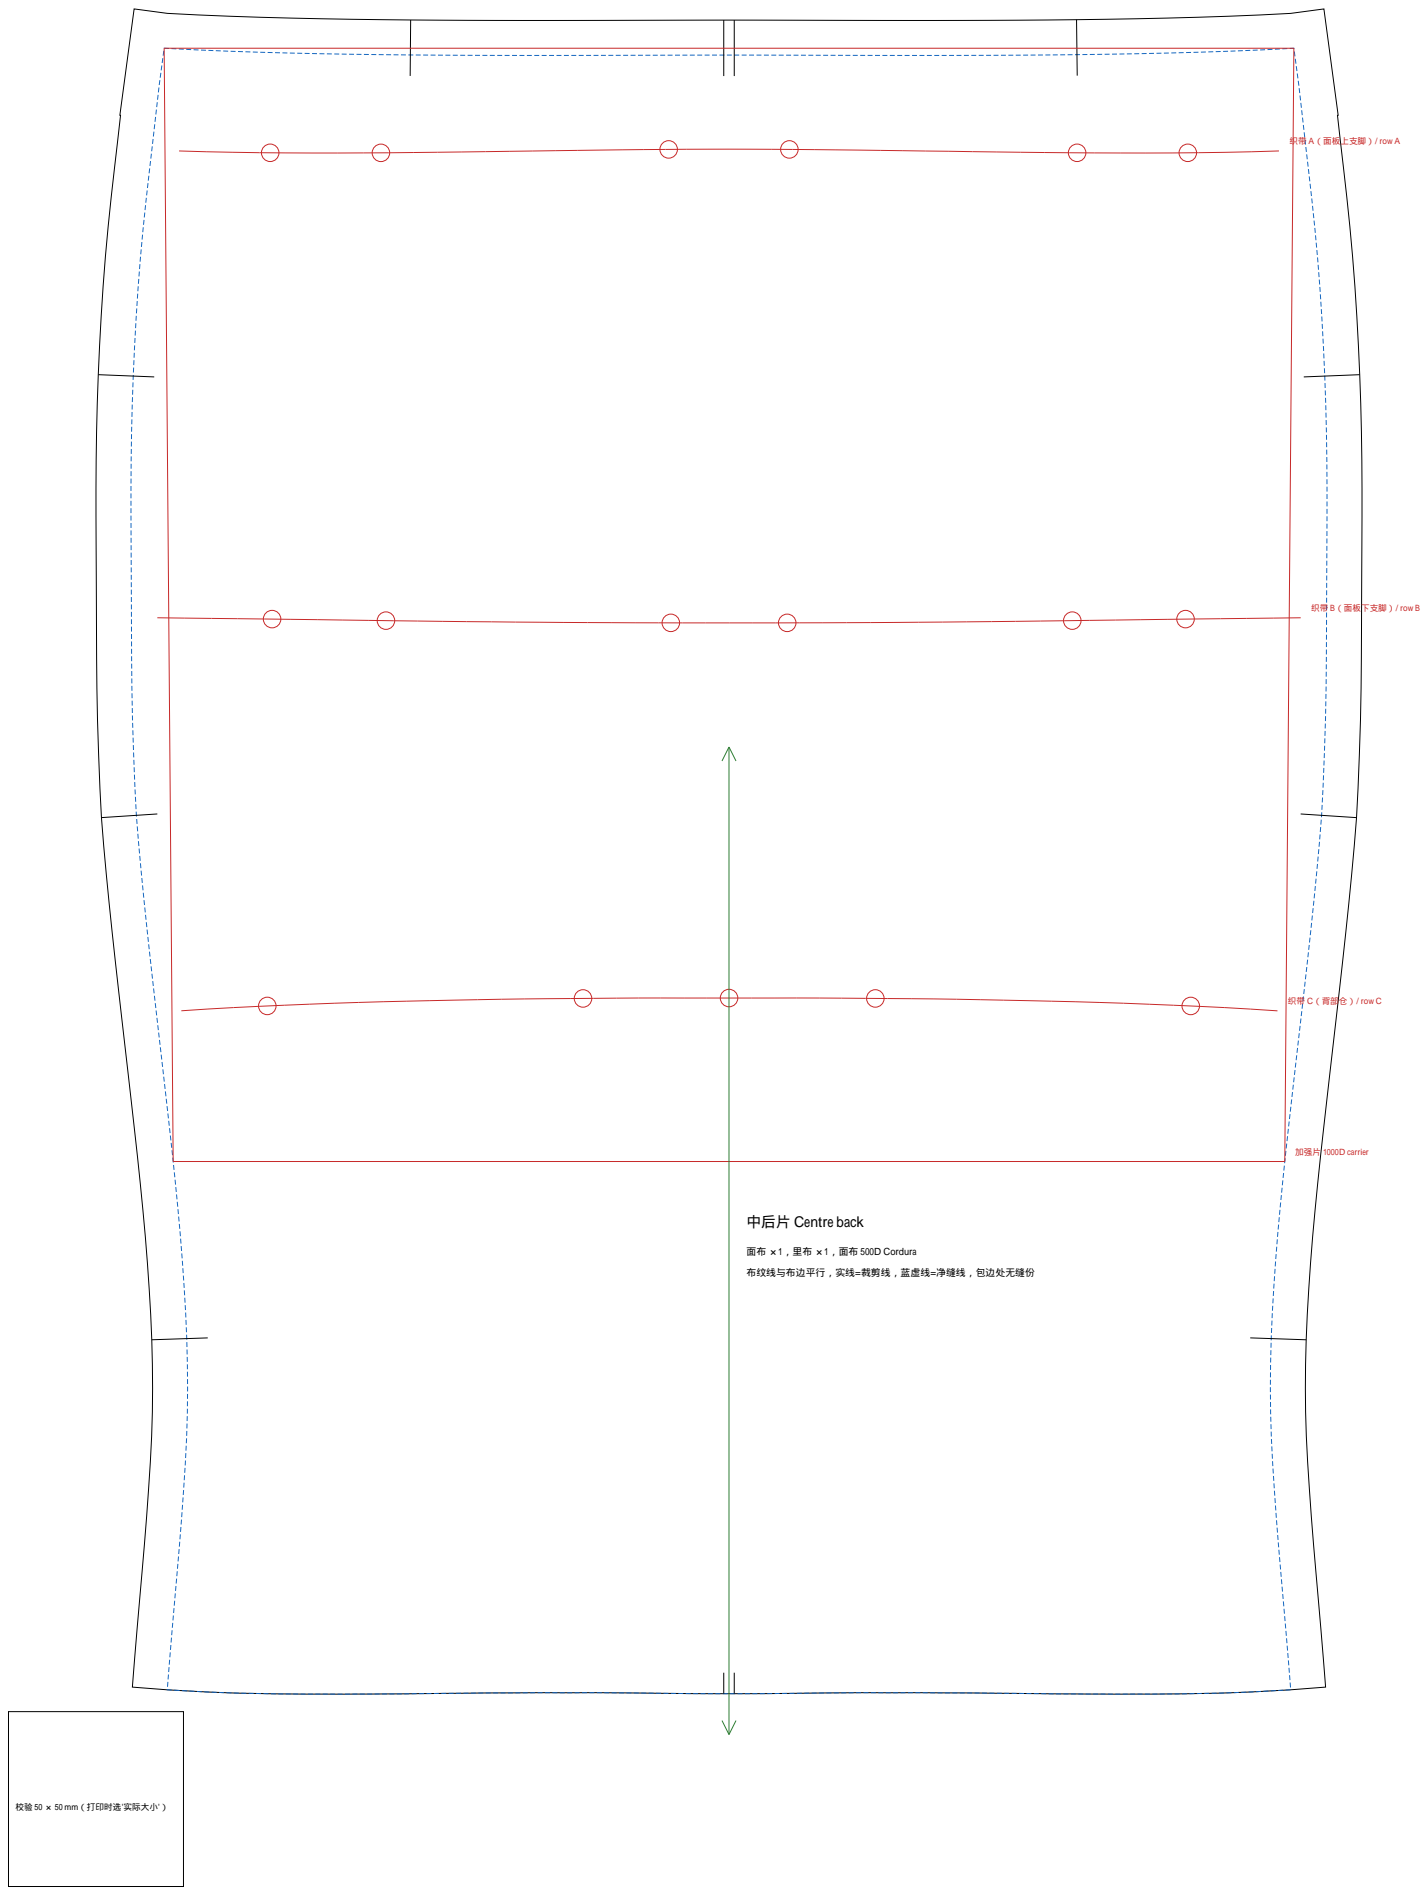
[picture p121: page 2]
加强片 1000D carrier

织带 A（面板上支脚）/ row A

织带 B（面板下支脚）/ row B

织带 C（背部仓）/ row C

中后片 Centre back

面布 ×1，里布 ×1，面布 500D Cordura

布纹线与布边平行，实线=裁剪线，蓝虚线=净缝线，包边处无缝份

校验 50 × 50 mm（打印时选'实际大小'）

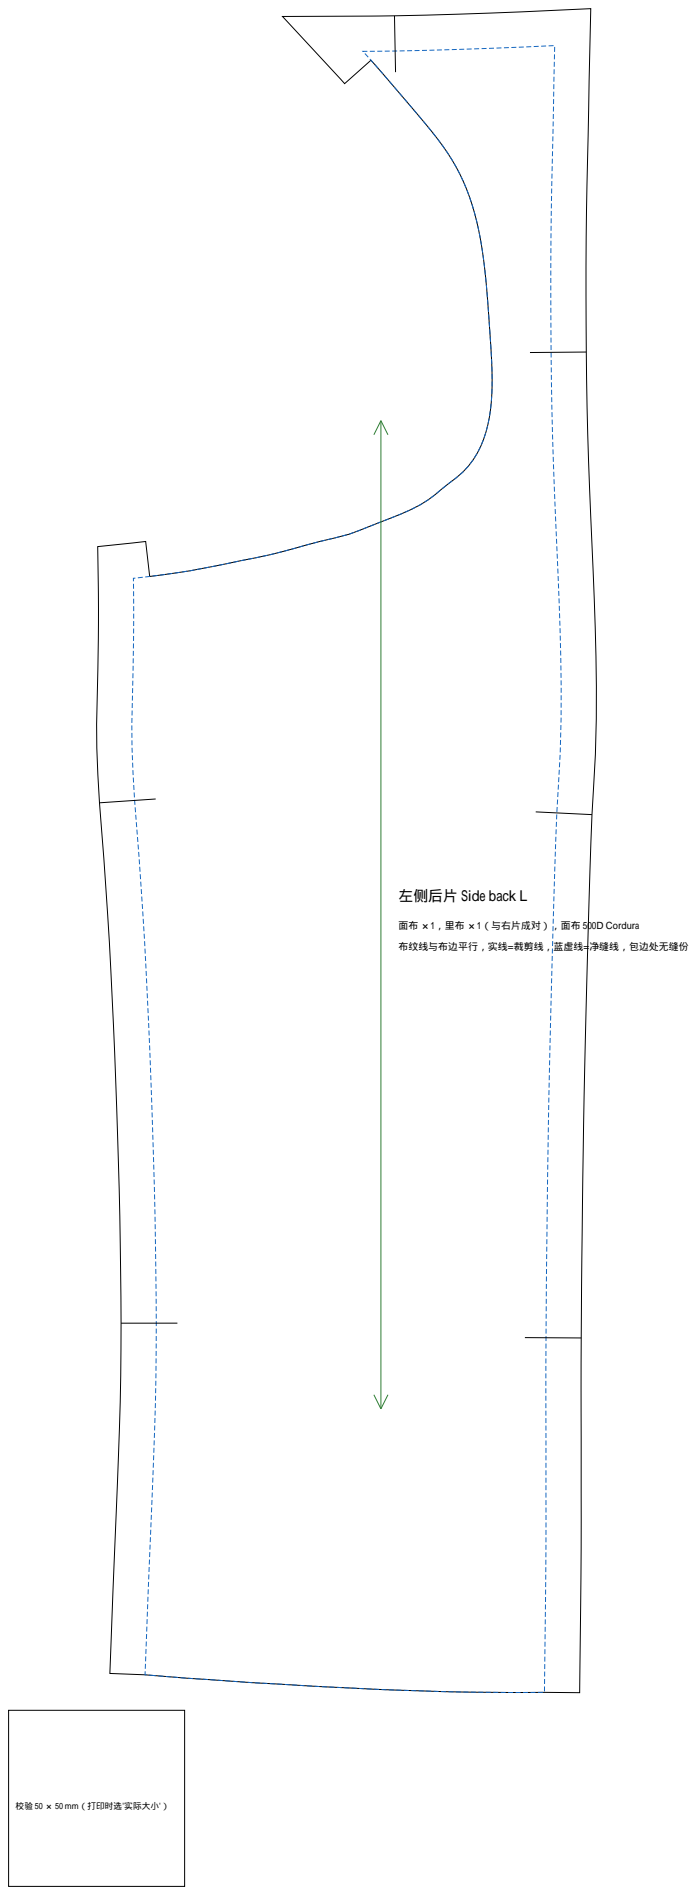
[picture p122: page 3]

左侧后片 Side back L

面布 ×1，里布 ×1（与右片成对），面布 500D Cordura

布纹线与布边平行，实线=裁剪线，蓝虚线=净缝线，包边处无缝份

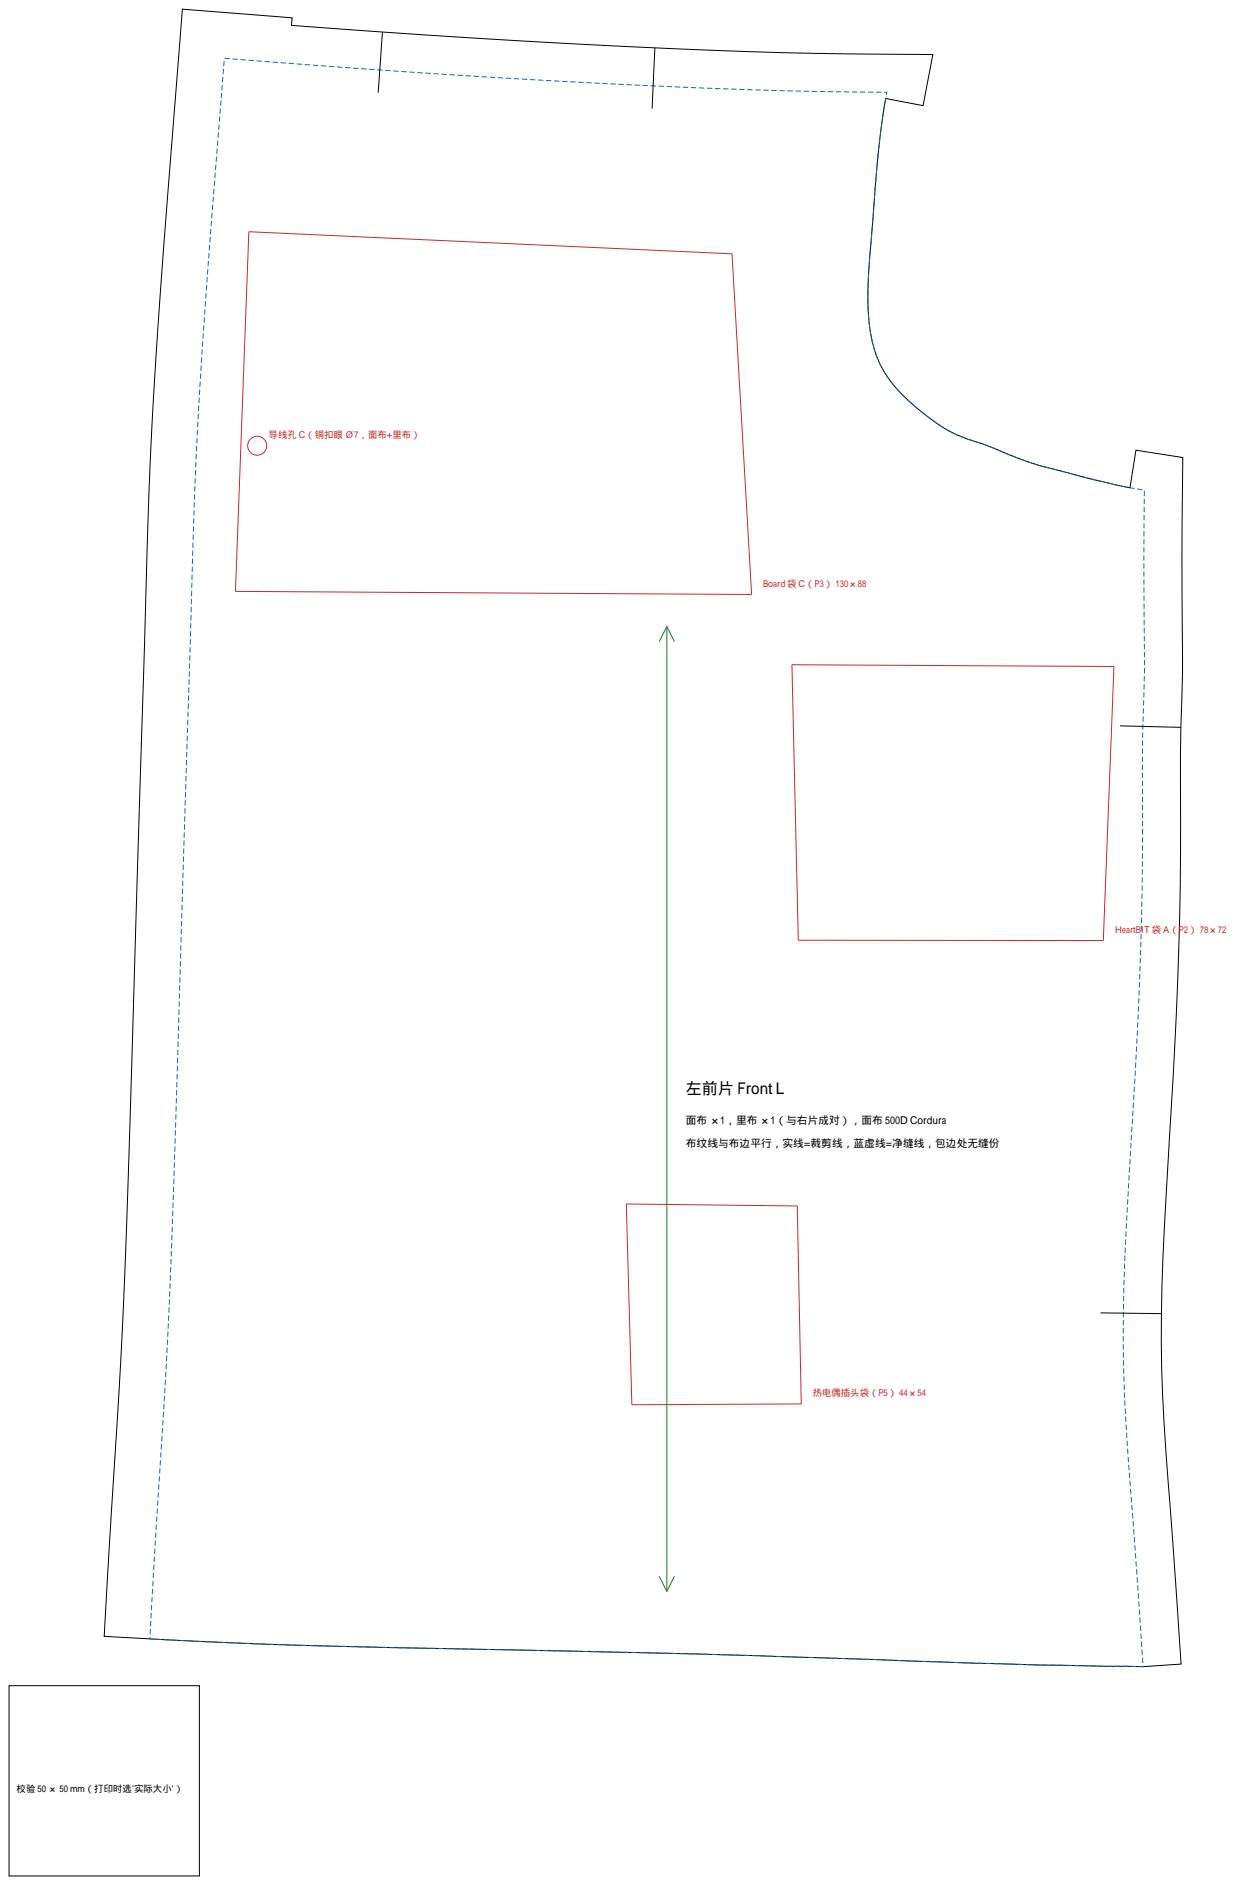
[picture p123: page 4]
HeartBIT 袋 A（P2） 78×72; Board 袋 C（P3） 130×88; 热电偶插头袋（P5） 44×54; 左前片 Front L

导线孔 C（铜扣眼 Ø7，面布+里布）

面布 ×1，里布 ×1（与右片成对），面布 500D Cordura

布纹线与布边平行，实线=裁剪线，蓝虚线=净缝线，包边处无缝份

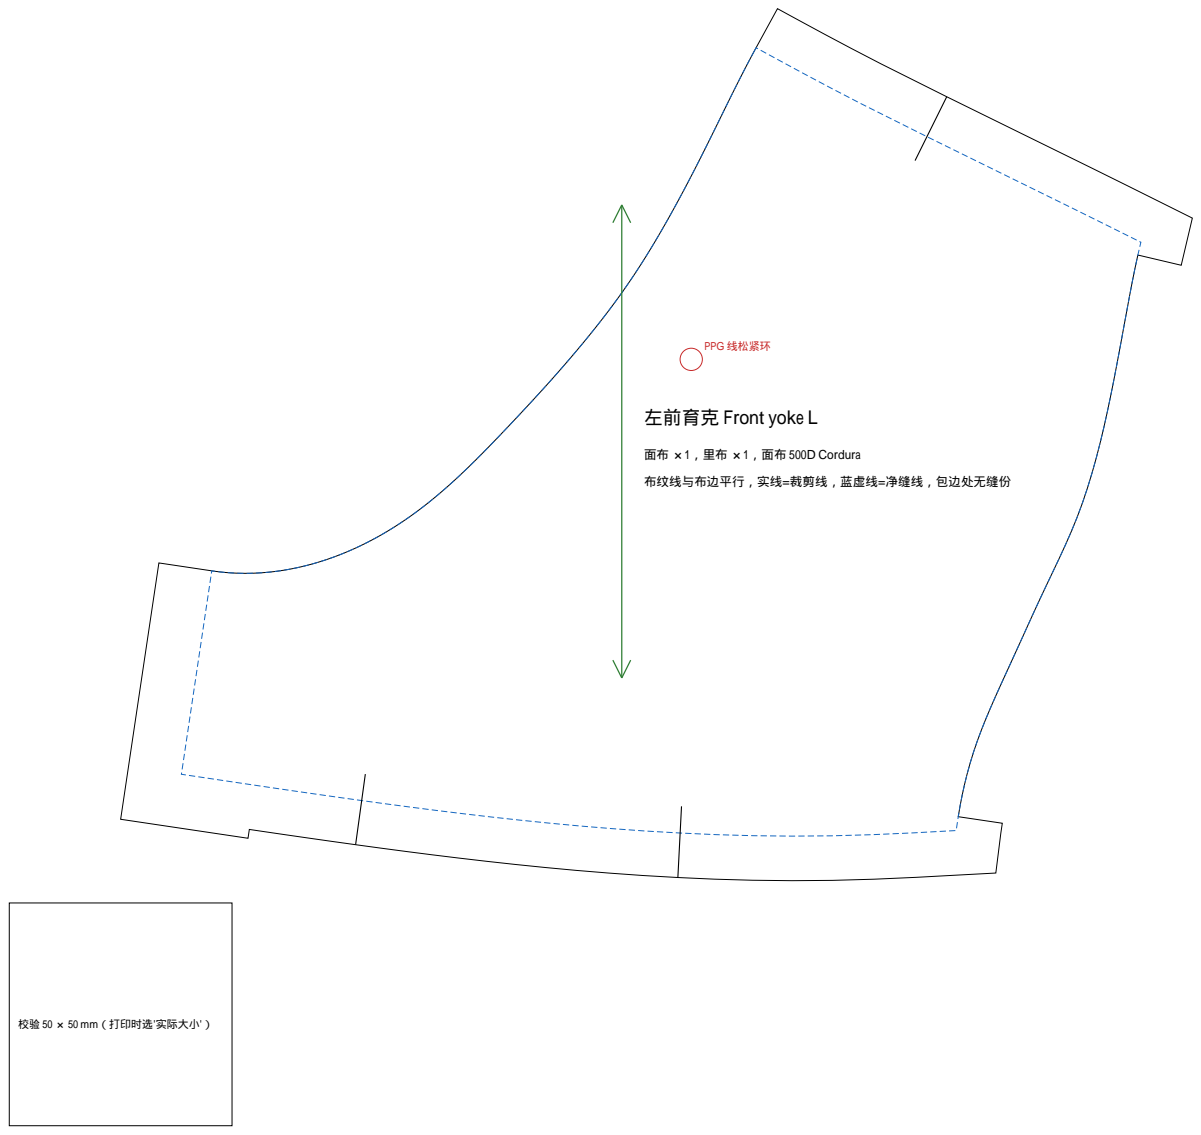
[picture p124: page 5]
PPG 线松紧环

左前育克 Front yoke L

面布 ×1，里布 ×1，面布 500D Cordura

布纹线与布边平行，实线=裁剪线，蓝虚线=净缝线，包边处无缝份

校验 50 × 50 mm（打印时选'实际大小'）

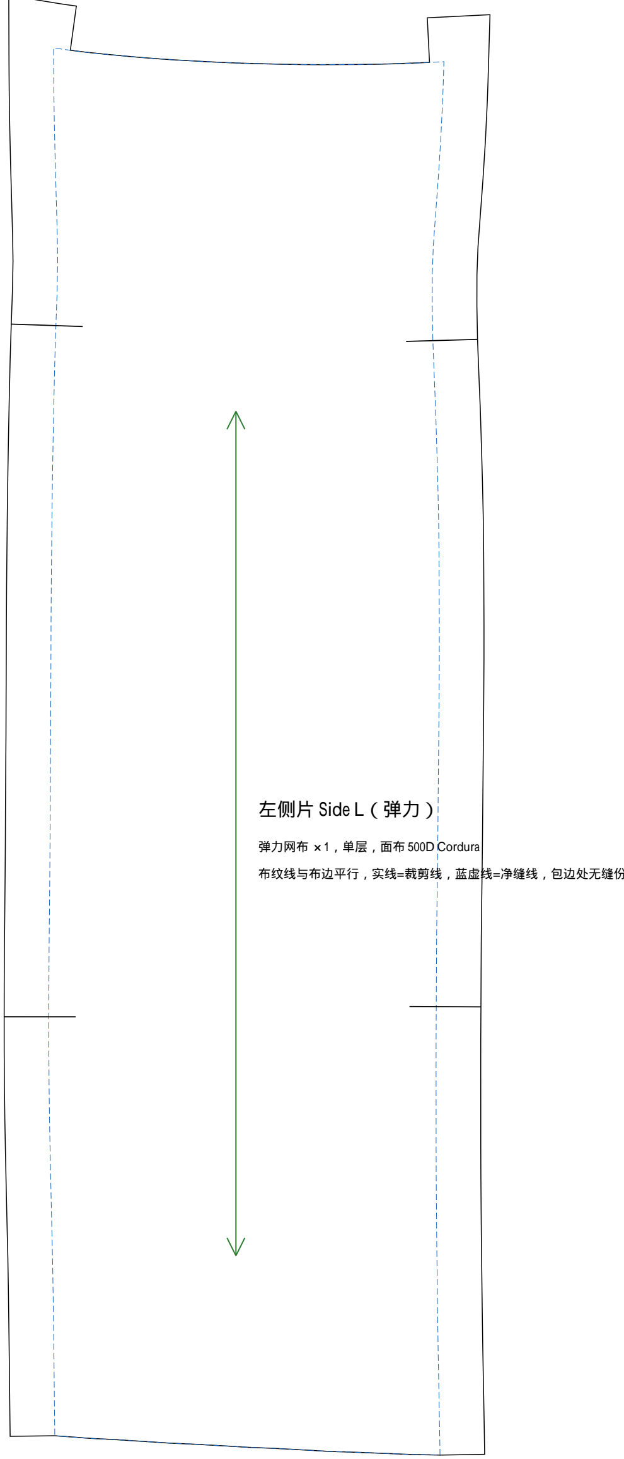
[picture p125: figure]
左侧片 Side L（弹力）; 弹力网布 ×1，单层，面布 500D Cordura; 布纹线与布边平行，实线=裁剪线，蓝虚线=净缝线，包边处无缝份
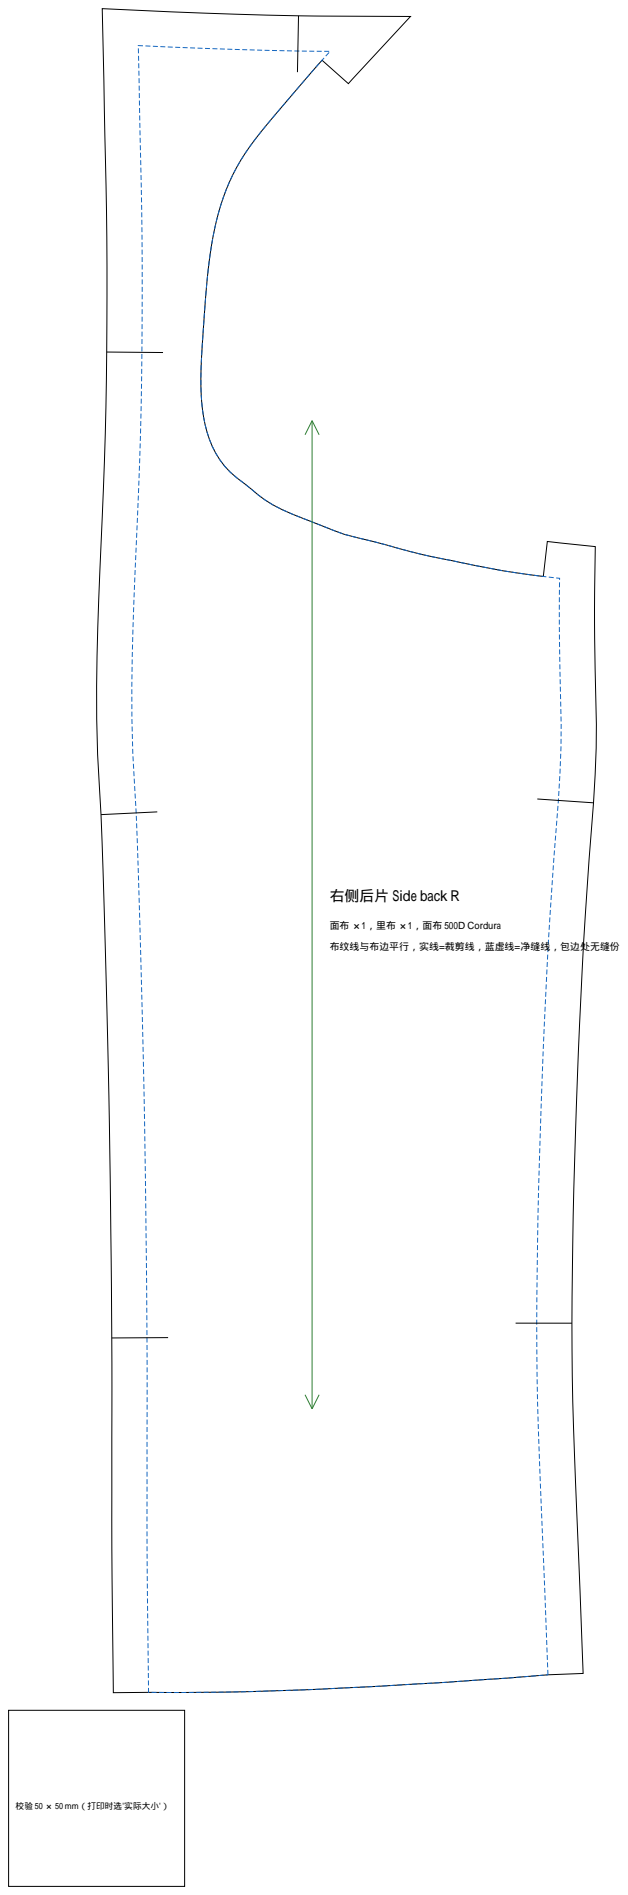
[picture p126: page 7]

右侧后片 Side back R

面布 ×1，里布 ×1，面布 500D Cordura

布纹线与布边平行，实线=裁剪线，蓝虚线=净缝线，包边处无缝份

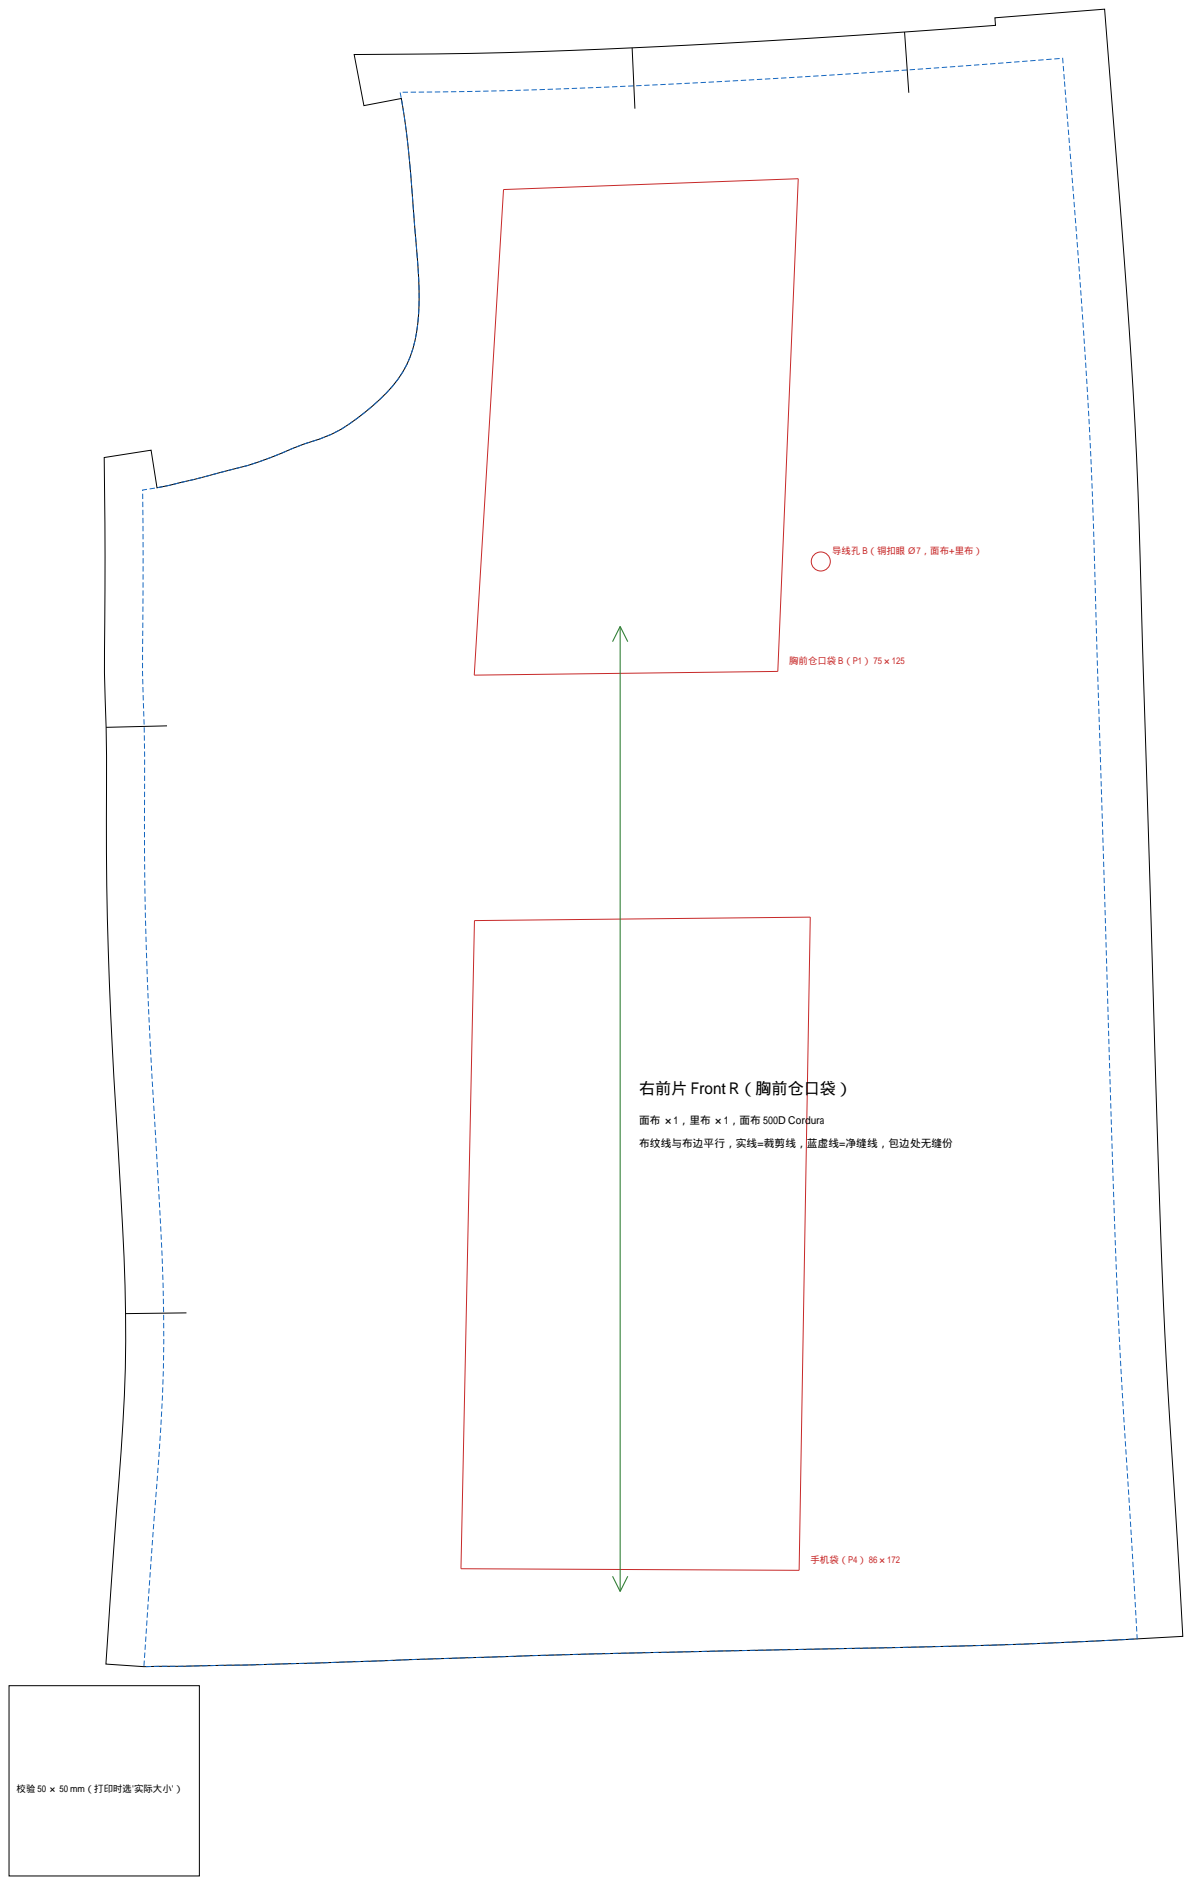
[picture p127: page 8]
胸前仓口袋 B（P1） 75×125; 手机袋（P4） 86×172

导线孔 B（铜扣眼 Ø7，面布+里布）

右前片 Front R（胸前仓口袋）

面布 ×1，里布 ×1，面布 500D Cordura

布纹线与布边平行，实线=裁剪线，蓝虚线=净缝线，包边处无缝份

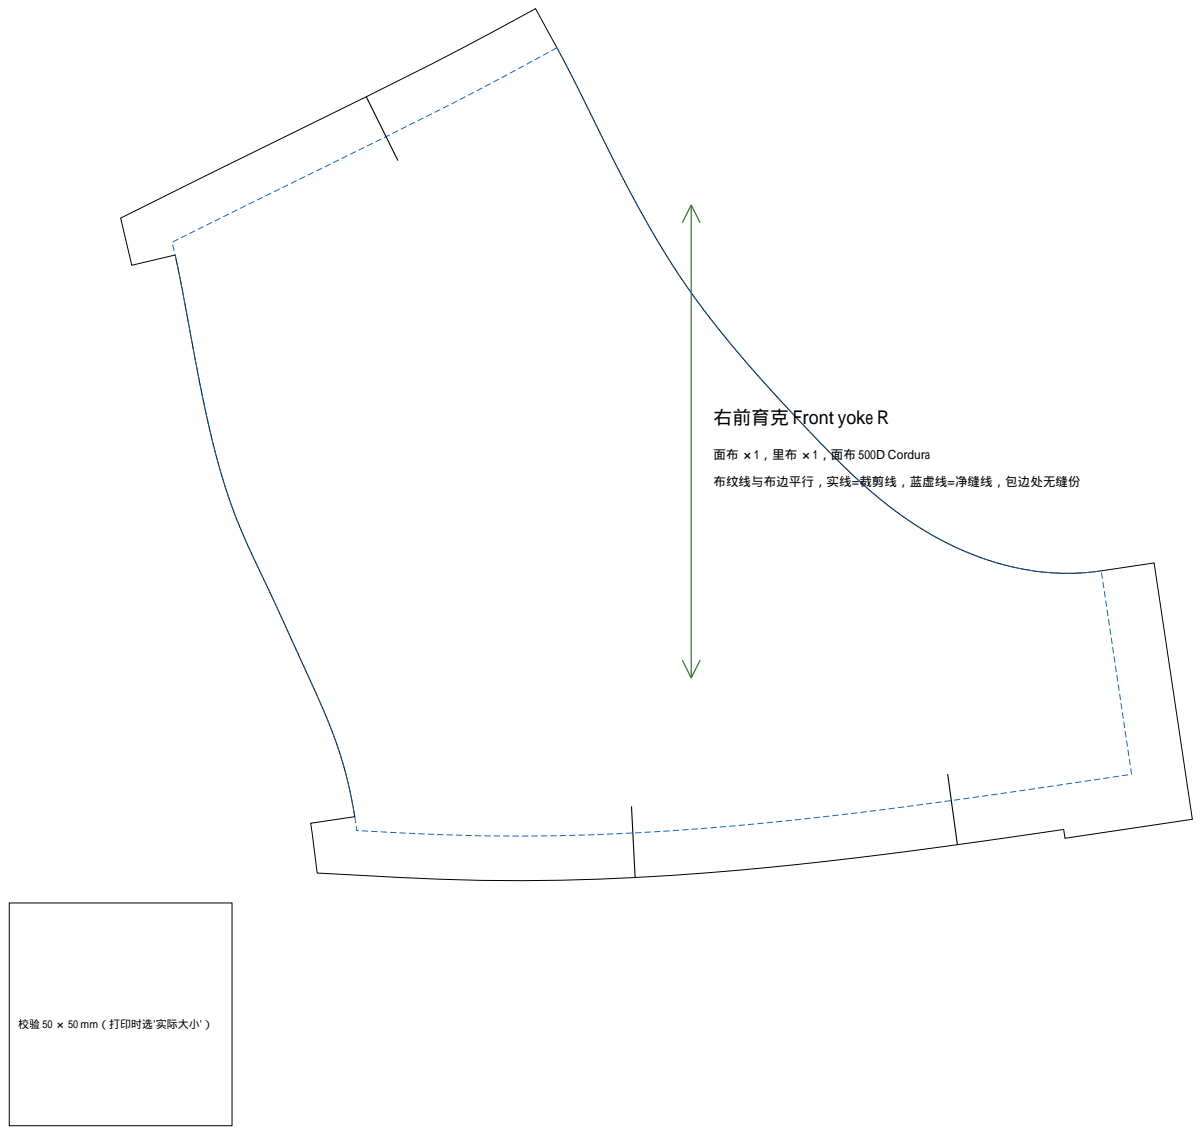
[picture p128: page 9]

右前育克 Front yoke R

面布 ×1，里布 ×1，面布 500D Cordura

布纹线与布边平行，实线=裁剪线，蓝虚线=净缝线，包边处无缝份

校验 50 × 50 mm（打印时选'实际大小'）

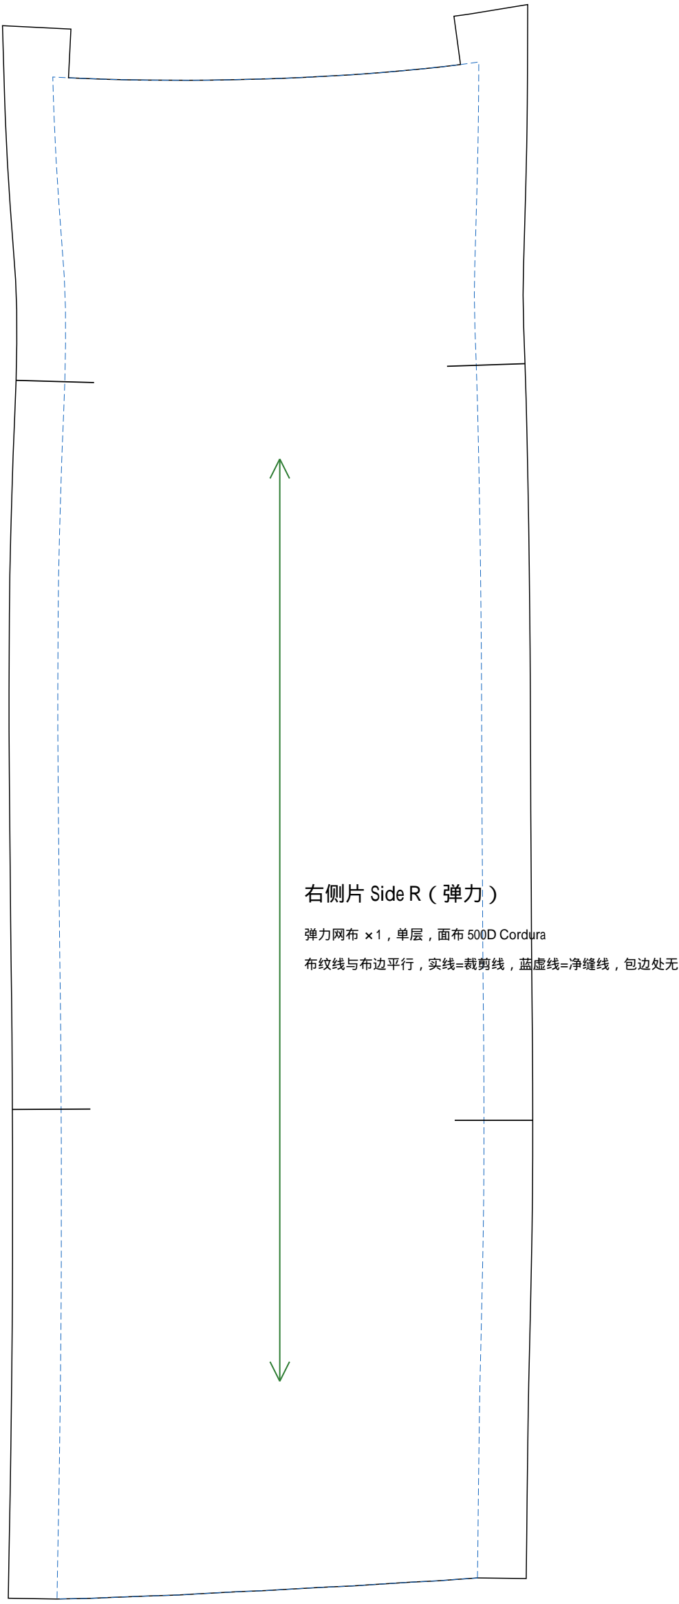
[picture p129: figure]
右侧片 Side R（弹力）; 弹力网布 ×1，单层，面布 500D Cordura; 布纹线与布边平行，实线=裁剪线，蓝虚线=净缝线，包边处无缝份
