3351666087/solar-vest/hardware/pcb/libb/libb_schematic.pdf

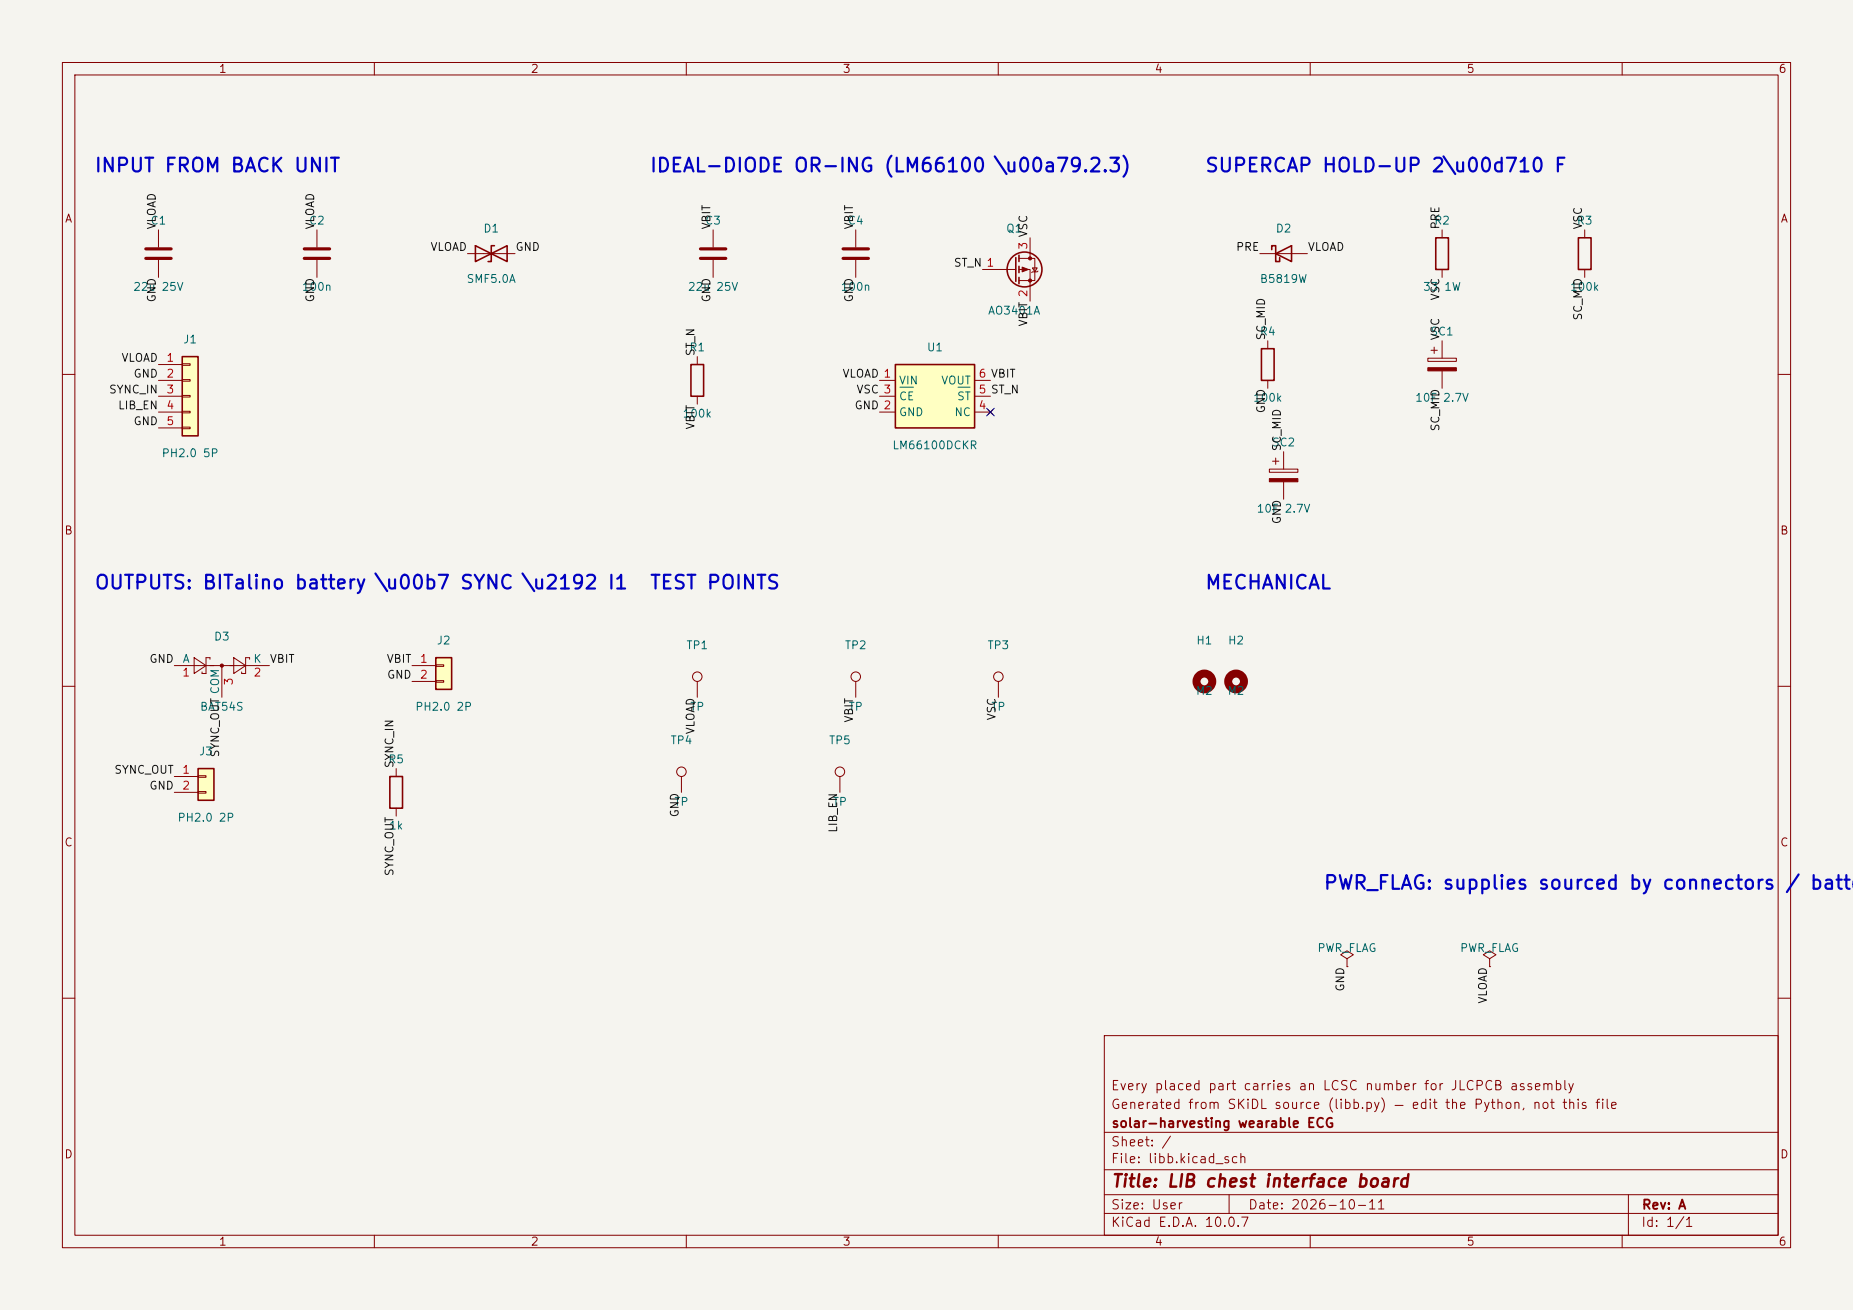
[picture p130: page 1]

INPUT FROM BACK UNIT

PWR_FLAG: supplies sourced by connectors / battery

Every placed part carries an LCSC number for JLCPCB assembly
Generated from SKiDL source (libb.py) — edit the Python, not this file
solar-harvesting wearable ECG
Sheet: /
File: libb.kicad_sch
Title: LIB chest interface board

Size: User | Rev: A
KiCad E.D.A. 10.0.7 | Id: 1/1
