3351666087/solar-vest/hardware/pcb/pmbh/pmbh_schematic.pdf

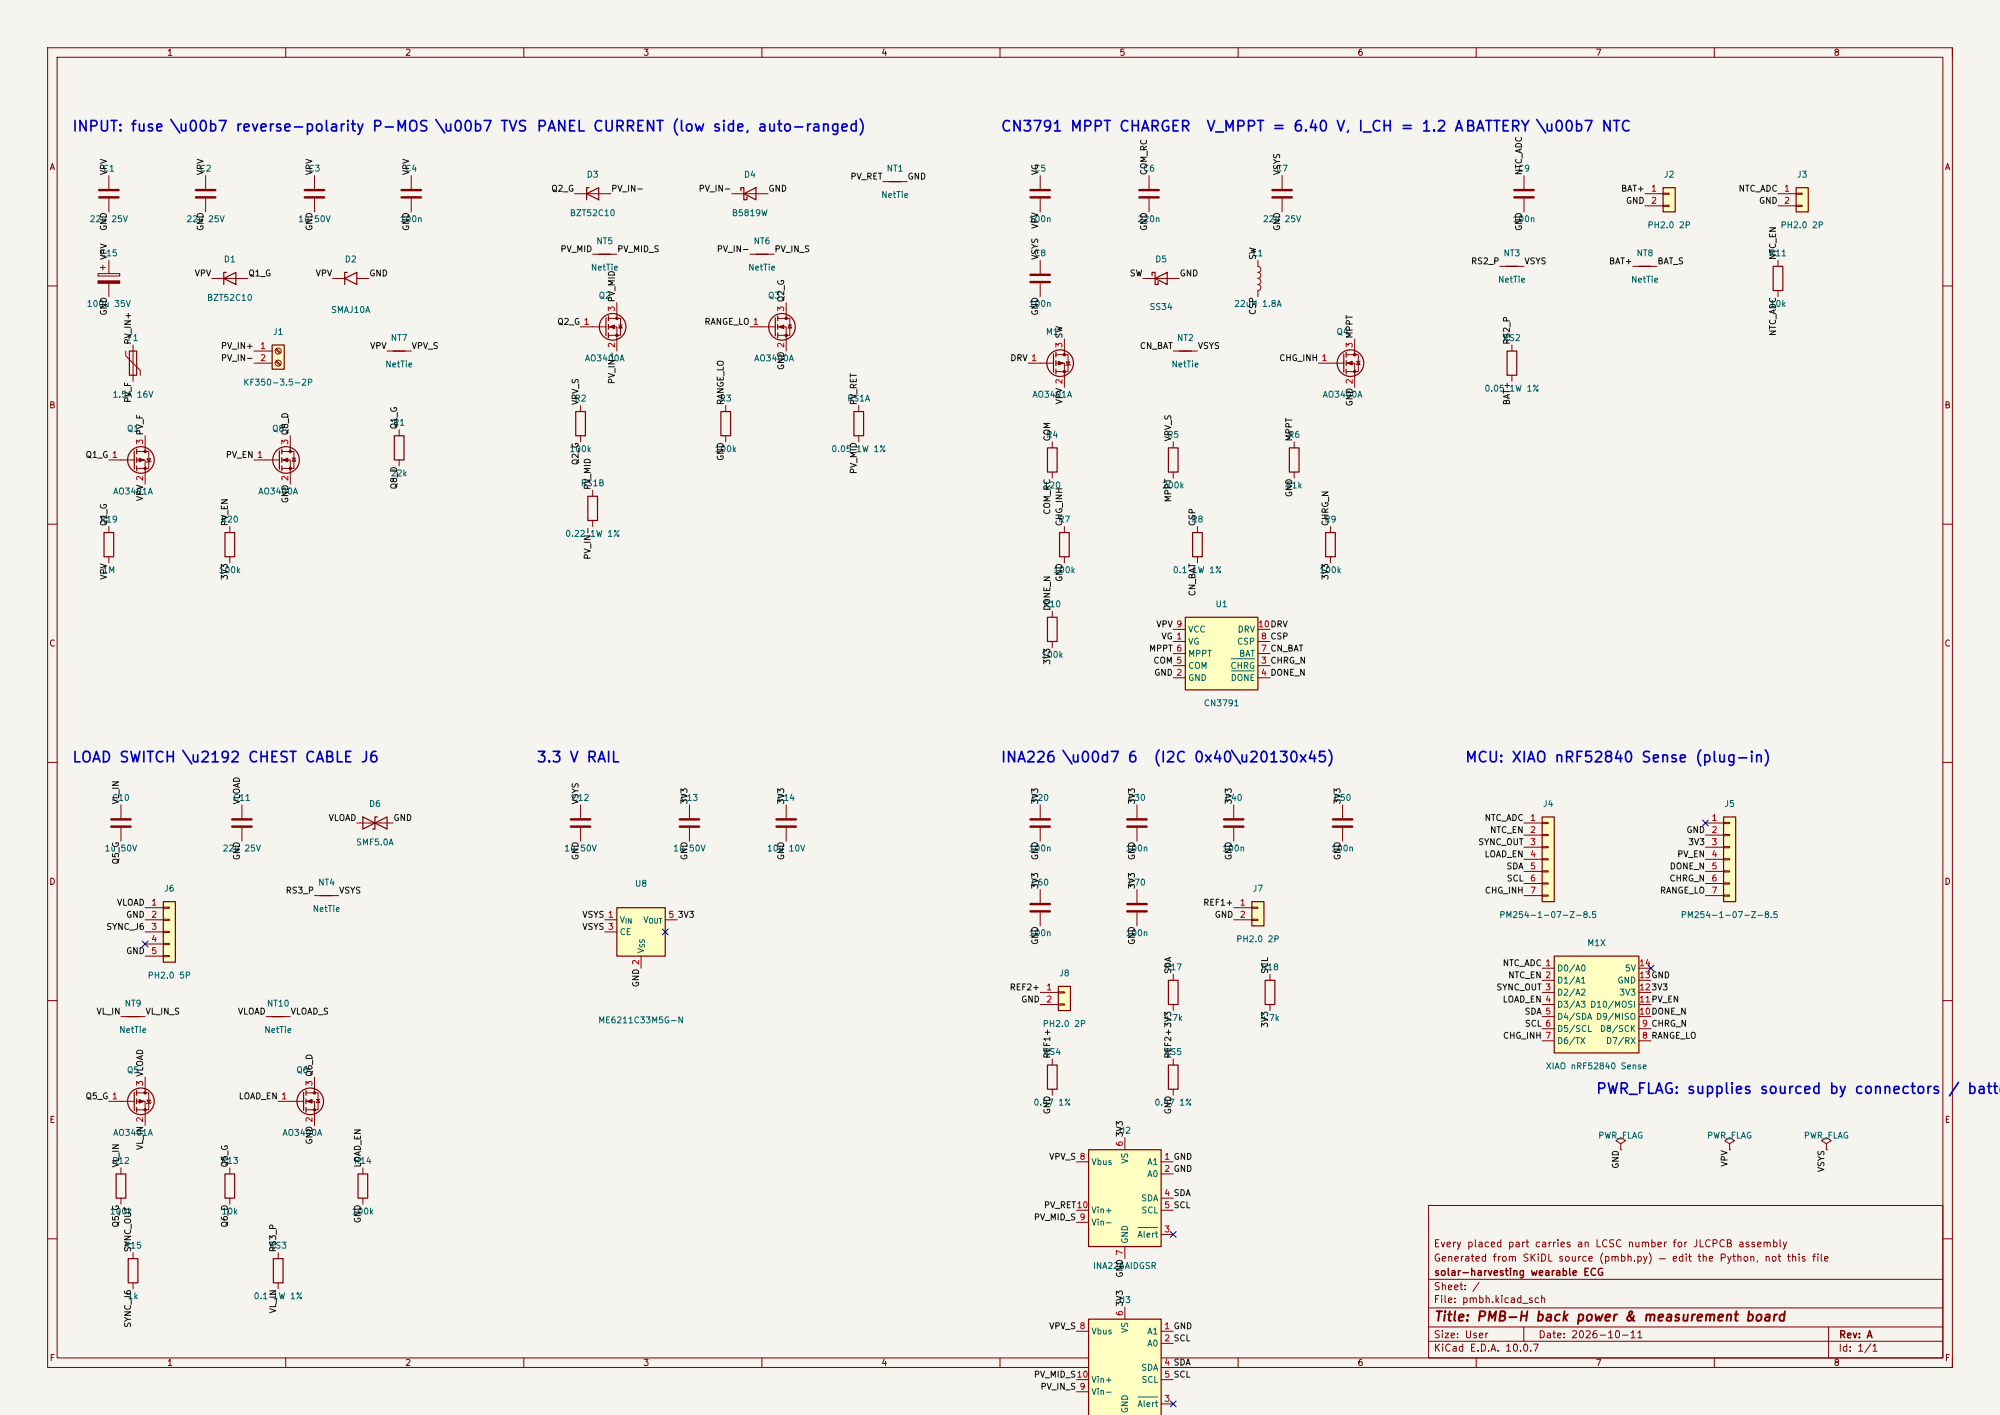
[picture p131: page 1]

PANEL CURRENT (low side, auto-ranged)
D3 BZT52C10 C12

SDA SCL GND 3V3 GND

MCU: XIAO nRF52840 Sense (plug-in)

PWR_FLAG: supplies sourced by connectors / battery

Every placed part carries an LCSC number for JLCPCB assembly
Generated from SKiDL source (pmbh.py) — edit the Python, not this file
solar-harvesting wearable ECG
Sheet: /
File: pmbh.kicad_sch
Title: PMB-H back power & measurement board

Size: User | Rev: A | F Date: 2026-10-11
KiCad E.D.A. 10.0.7 | Id: 1/1
