3351666087/solar-vest/hardware/pcb/libb/libb.kicad_pcb

## KiCad design hardware/pcb/libb/libb.kicad_pcb (2026-10-21)

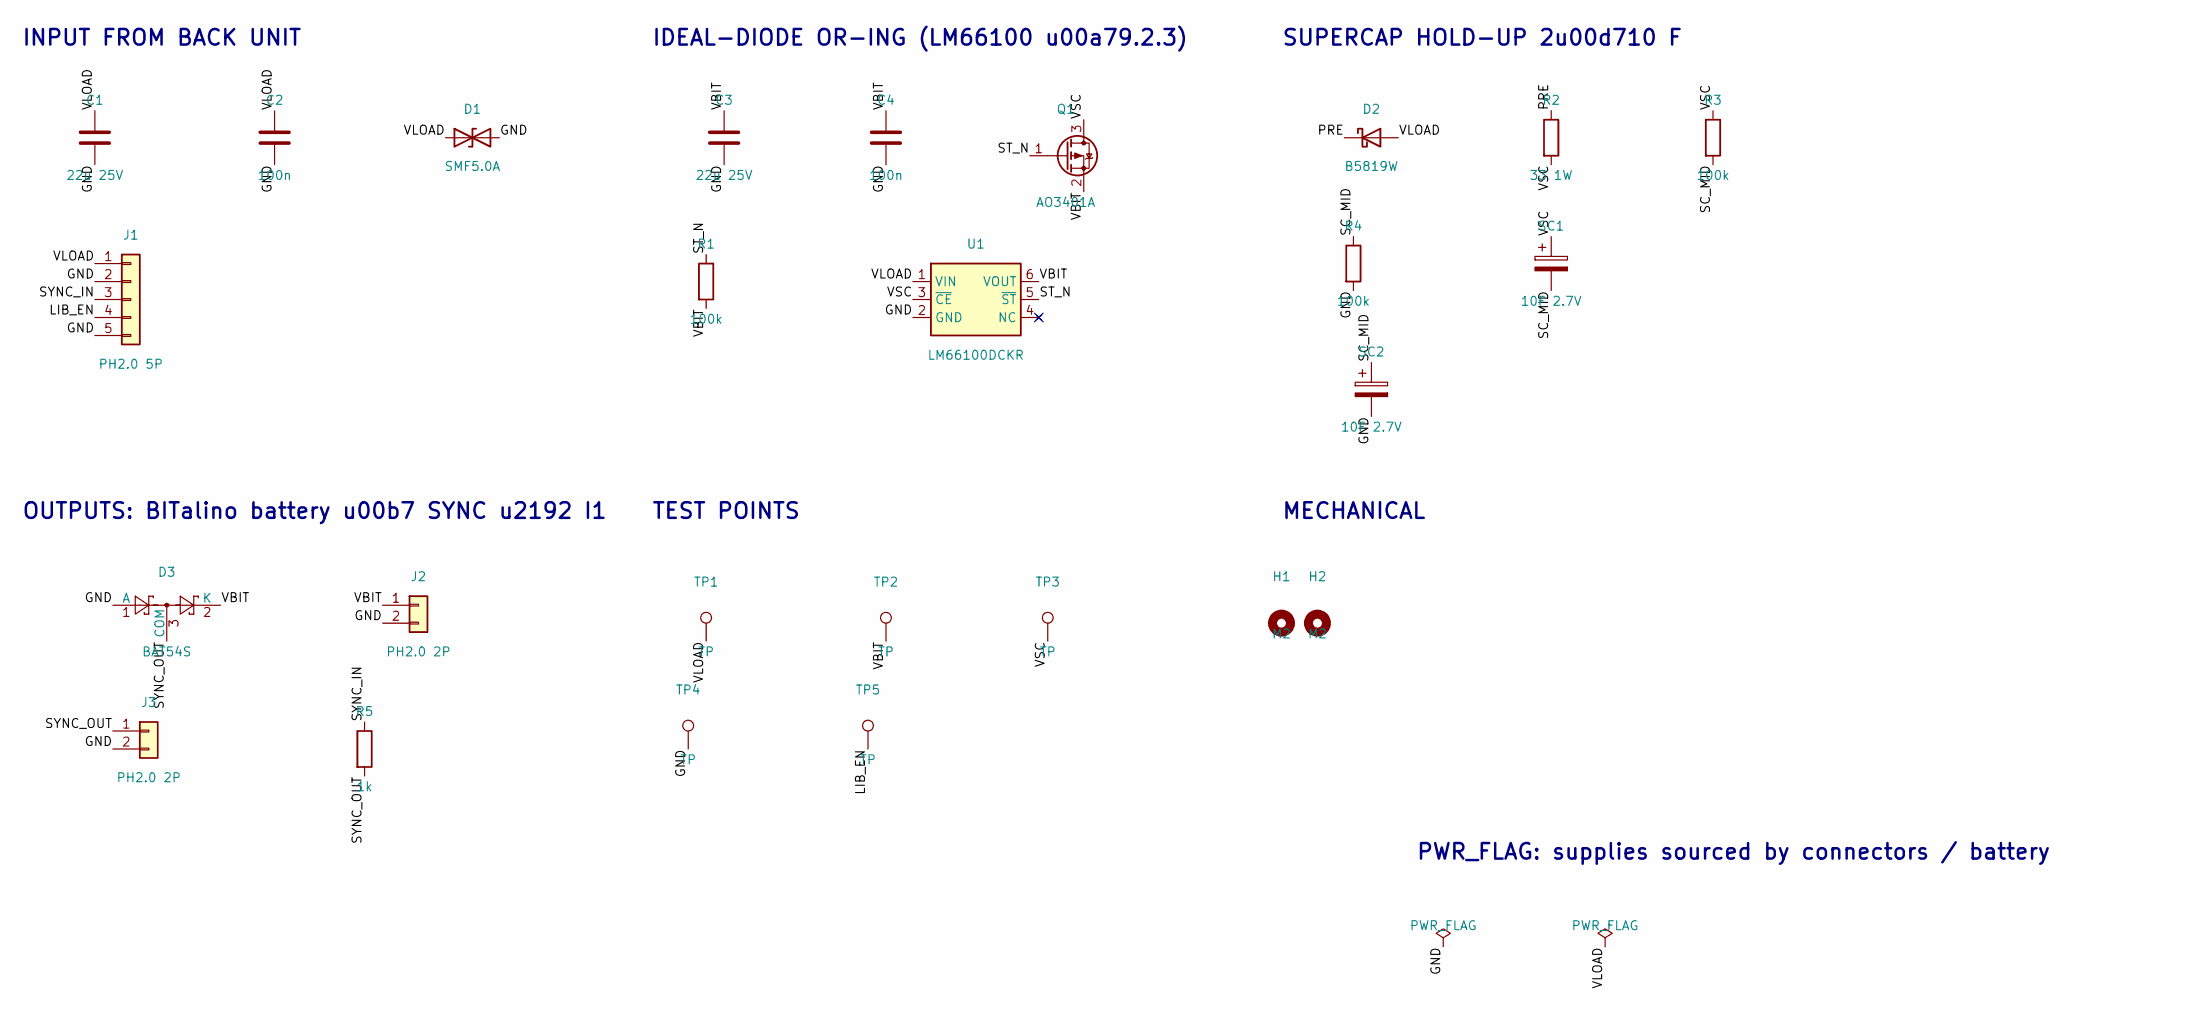
[picture p132: schematic libb.kicad_sch, LIB chest interface board]

Parts:
C1, C3: 22u 25V; C_0805_2012Metric; LCSC C45783
C2, C4: 100n; C_0603_1608Metric; LCSC C14663
D1: SMF5.0A; D_SOD-123F; LCSC C193402
D2: B5819W; D_SOD-123; LCSC C8598
D3: BAT54S; SOT-23; LCSC C47546
H1, H2: M2; MountingHole_2.2mm_M2
J1: PH2.0 5P; JST_PH_S5B-PH-SM4-TB_1x05-1MP_P2.00mm_Horizontal; LCSC C265104
J2, J3: PH2.0 2P; JST_PH_S2B-PH-SM4-TB_1x02-1MP_P2.00mm_Horizontal; LCSC C295747
Q1: AO3401A; SOT-23; LCSC C15127
R1, R3, R4: 100k; R_0603_1608Metric; LCSC C25803
R2: 33 1W; R_2512_6332Metric; LCSC C53728
R5: 1k; R_0603_1608Metric; LCSC C21190
SC1, SC2: 10F 2.7V; SuperCap_D10_L25_Flat_P5.00mm
TP1, TP2, TP3, TP4, TP5: TP; TestPoint_Pad_D1.5mm
U1: LM66100DCKR; SOT-363_SC-70-6; LCSC C2869734

Connections:
GND: C1.2, C2.2, C3.2, C4.2, D1.2 (A2), D3.1 (A), J1.2, J1.5, J2.2, J3.2, R4.2, SC2.2, TP4.1, U1.2 (GND)
LIB_EN: J1.4, TP5.1
PRE: D2.1 (K), R2.1
SC_MID: R3.2, R4.1, SC1.2, SC2.1
ST_N: Q1.1 (G), R1.1, U1.5 (~ST)
SYNC_IN: J1.3, R5.1
SYNC_OUT: D3.3 (COM), J3.1, R5.2
VBIT: C3.1, C4.1, D3.2 (K), J2.1, Q1.2 (S), R1.2, TP2.1, U1.6 (VOUT)
VLOAD: C1.1, C2.1, D1.1 (A1), D2.2 (A), J1.1, TP1.1, U1.1 (VIN)
VSC: Q1.3 (D), R2.2, R3.1, SC1.1, TP3.1, U1.3 (~CE)

Notes on the sheet:
INPUT FROM BACK UNIT
IDEAL-DIODE OR-ING (LM66100 u00a79.2.3)
SUPERCAP HOLD-UP 2u00d710 F
OUTPUTS: BITalino battery u00b7 SYNC u2192 I1
TEST POINTS
MECHANICAL
PWR_FLAG: supplies sourced by connectors / battery

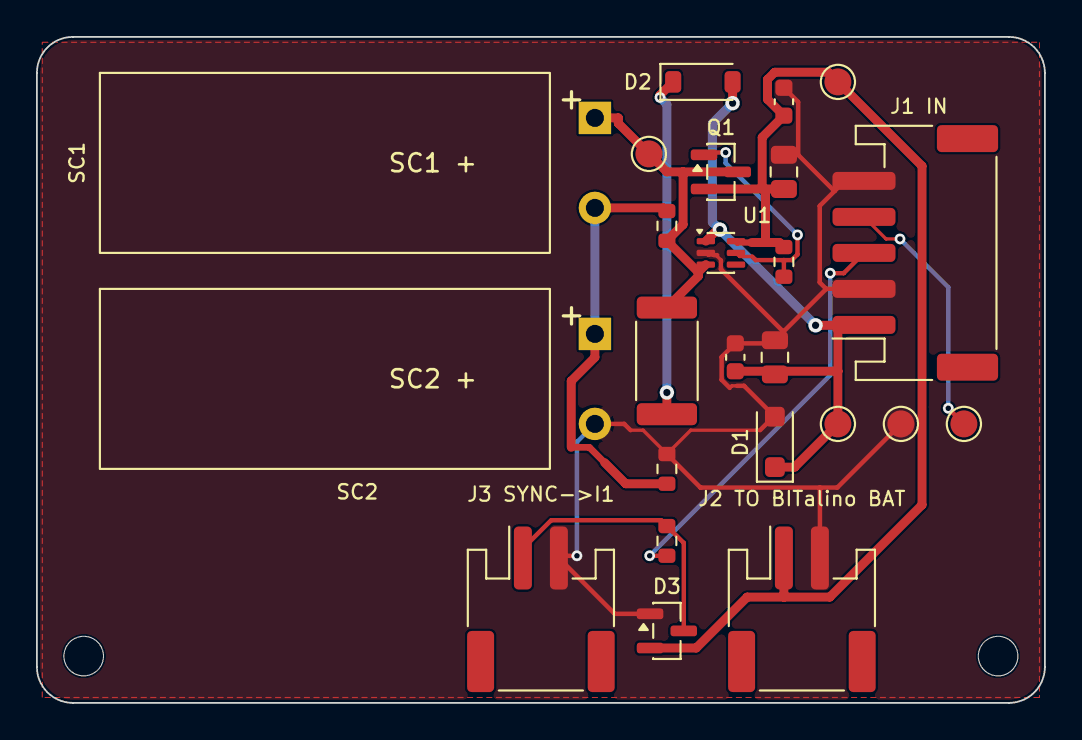
[picture p133: board libb.kicad_pcb from above]

Board: 2 copper layers, 56.0 x 37.0 mm, 26 parts (0 on the bottom side), 10 nets.
