3351666087/solar-vest/hardware/pcb/pmbh/pmbh.kicad_pcb

## KiCad design hardware/pcb/pmbh/pmbh.kicad_pcb (2026-10-21)

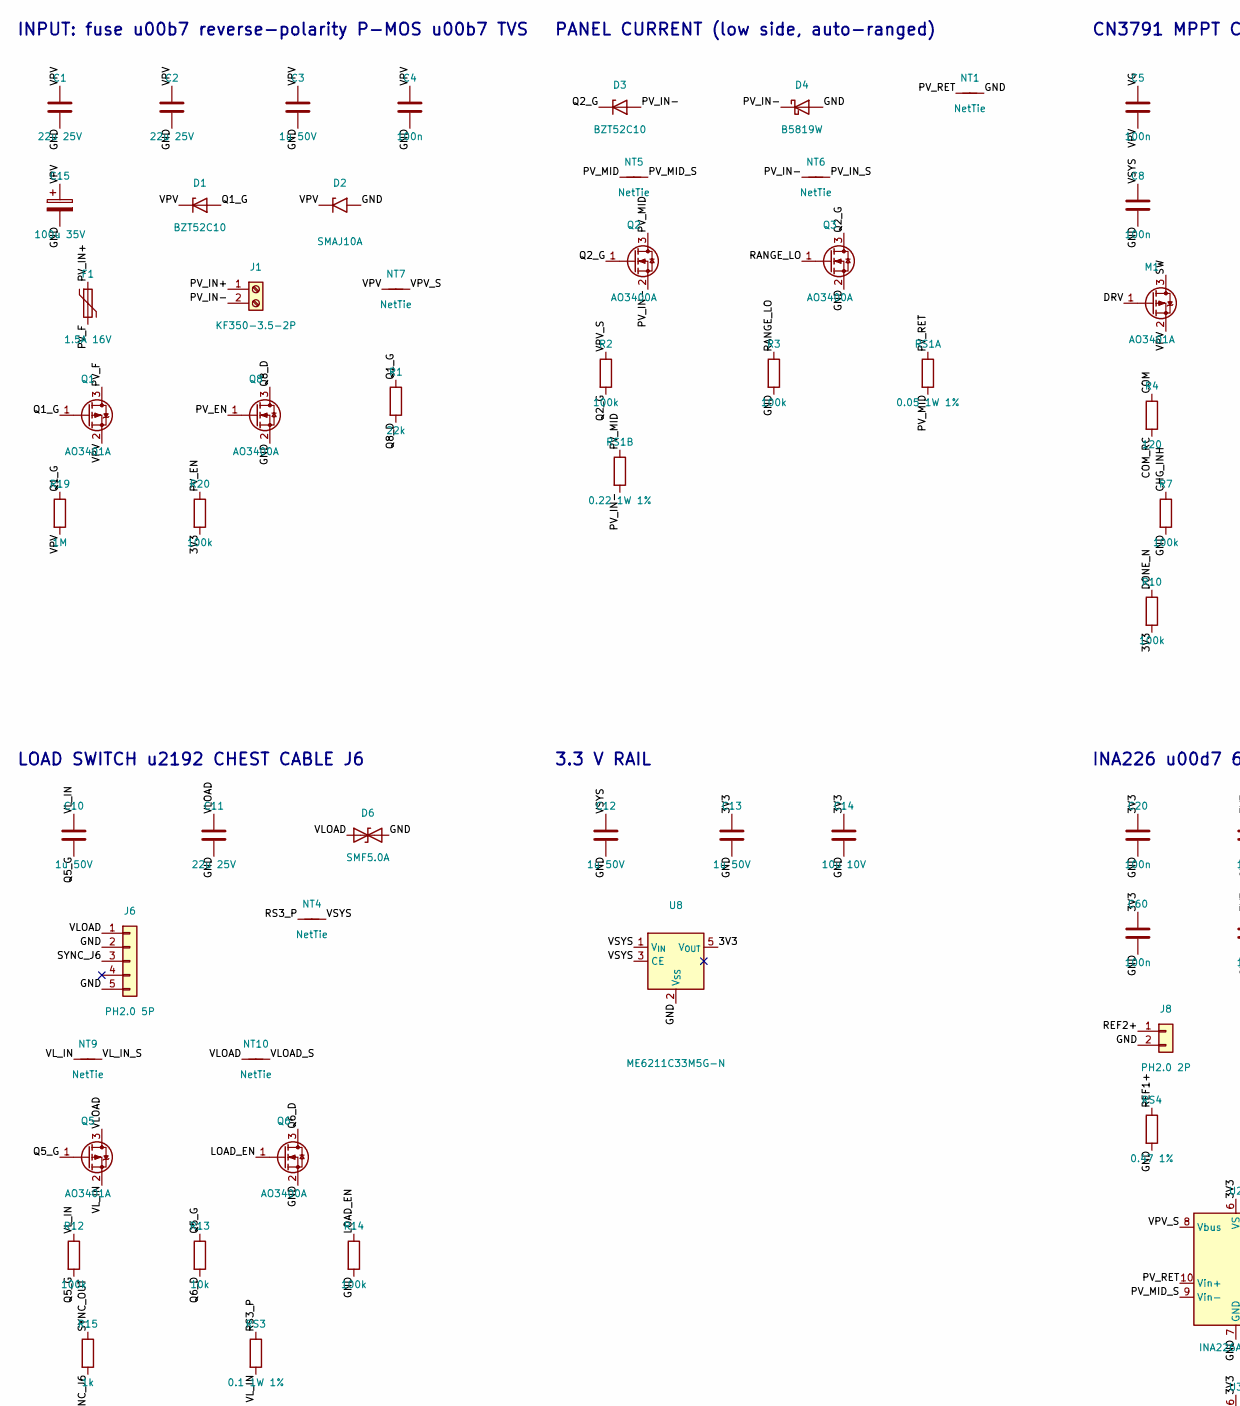
[picture p134: schematic pmbh.kicad_sch, PMB-H back power & measurement board, part in row 1, column 1]

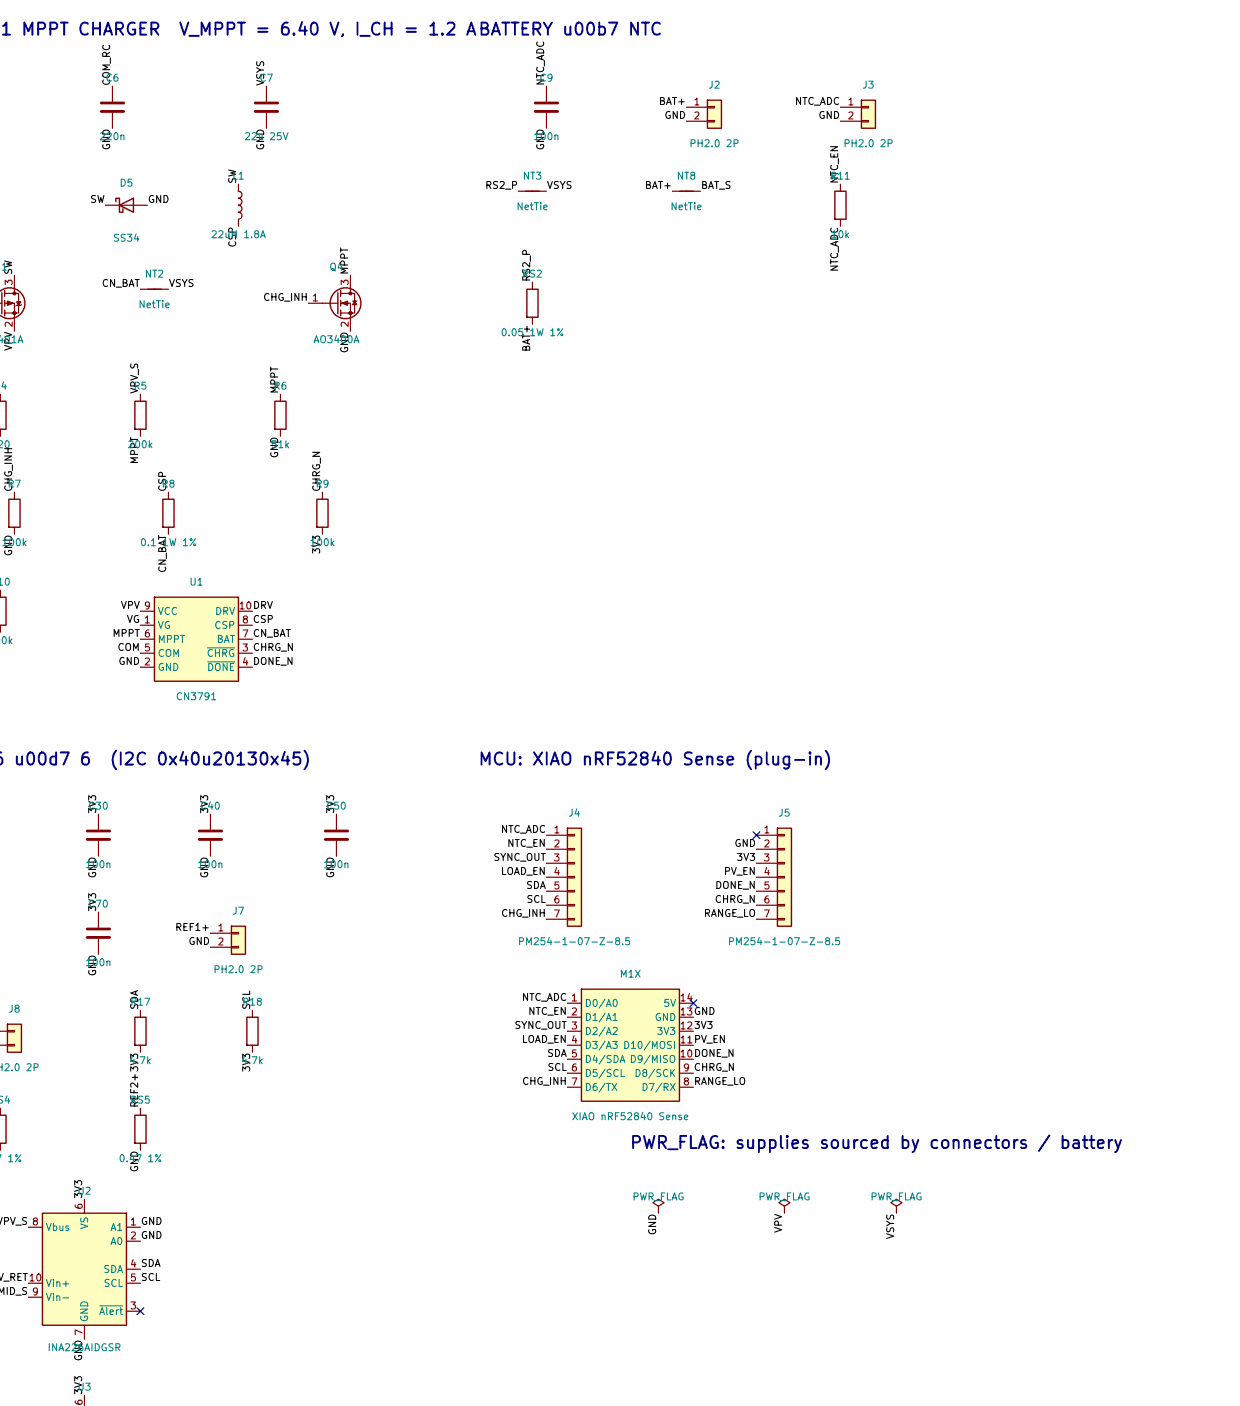
[picture p135: schematic pmbh.kicad_sch, PMB-H back power & measurement board, part in row 1, column 2]

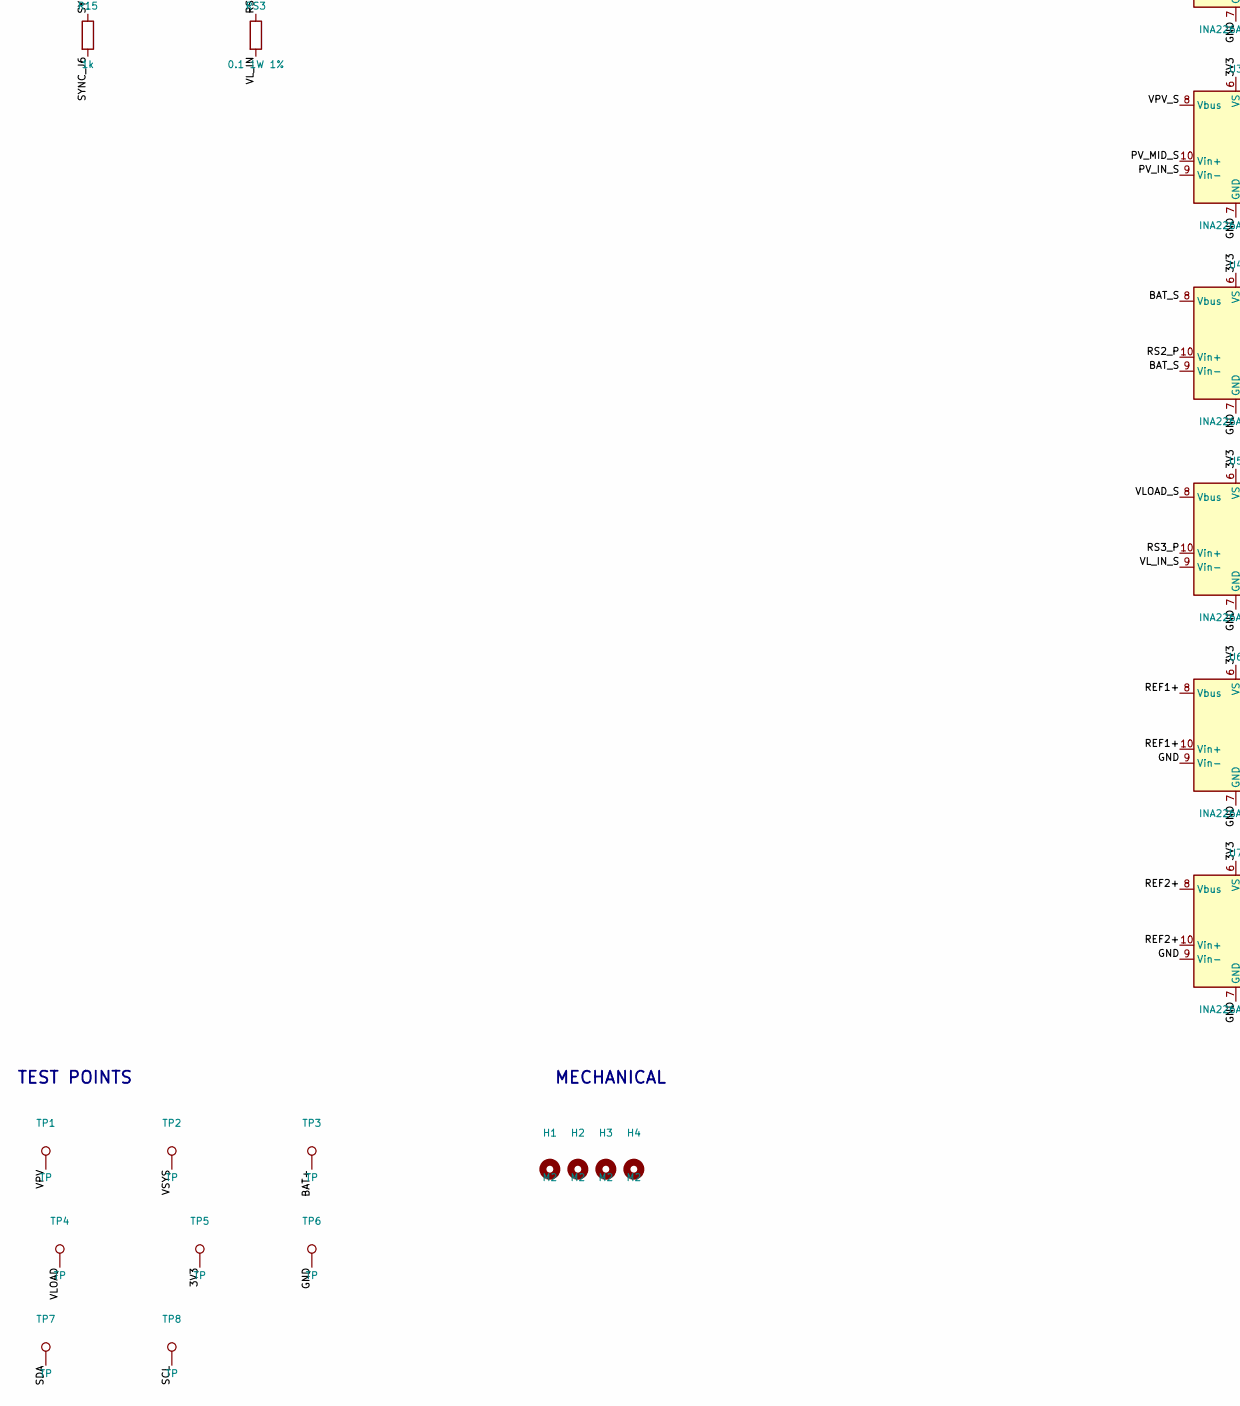
[picture p136: schematic pmbh.kicad_sch, PMB-H back power & measurement board, part in row 2, column 1]

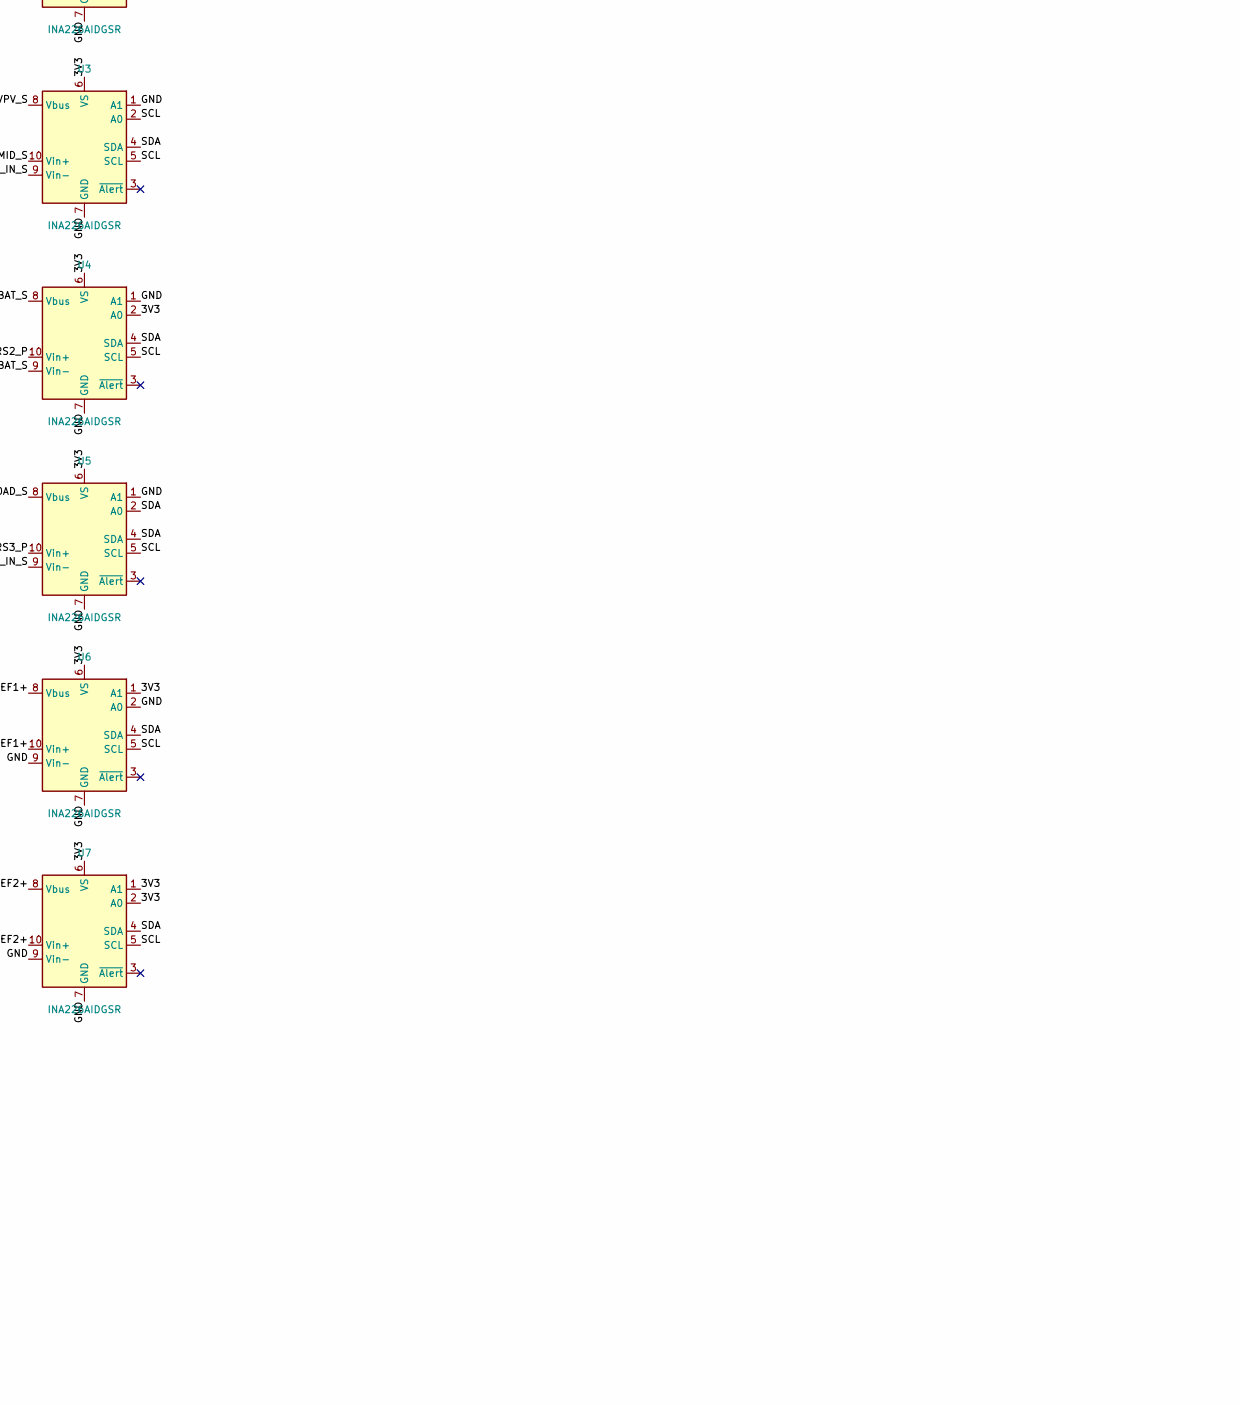
[picture p137: schematic pmbh.kicad_sch, PMB-H back power & measurement board, part in row 2, column 2]

Parts:
C1, C2, C7, C11: 22u 25V; C_0805_2012Metric; LCSC C45783
C3, C10, C12, C13: 1u 50V; C_0603_1608Metric; LCSC C15849
C4, C5, C8, C9, C20, C30, C40, C50, C60, C70: 100n; C_0603_1608Metric; LCSC C14663
C6: 220n; C_0603_1608Metric; LCSC C21120
C14: 10u 10V; C_0603_1608Metric; LCSC C19702
C15: 100u 35V; CP_Elec_6.3x7.7; LCSC C2836437
D1, D3: BZT52C10; D_SOD-123; LCSC C173431
D2: SMAJ10A; D_SMA; LCSC C134939
D4: B5819W; D_SOD-123; LCSC C8598
D5: SS34; D_SMA; LCSC C8678
D6: SMF5.0A; D_SOD-123F; LCSC C193402
F1: 1.5A 16V; Fuse_1812_4532Metric; LCSC C883152
H1, H2, H3, H4: M2; MountingHole_2.2mm_M2
J1: KF350-3.5-2P; TerminalBlock_Phoenix_PT-1,5-2-3.5-H_1x02_P3.50mm_Horizontal; LCSC C474892
J2, J3, J7, J8: PH2.0 2P; JST_PH_S2B-PH-SM4-TB_1x02-1MP_P2.00mm_Horizontal; LCSC C295747
J4, J5: PM254-1-07-Z-8.5; PinSocket_1x07_P2.54mm_Vertical; LCSC C2897370
J6: PH2.0 5P; JST_PH_S5B-PH-SM4-TB_1x05-1MP_P2.00mm_Horizontal; LCSC C265104
L1: 22uH 1.8A; L_Sunlord_SWPA6045S; LCSC C83454
M1: AO3401A; SOT-23; LCSC C15127
M1X: XIAO nRF52840 Sense
NT1, NT2, NT3, NT4, NT5, NT6, NT7, NT8, NT9, NT10: NetTie; NetTie-2_SMD_Pad0.5mm
Q1, Q5: AO3401A; SOT-23; LCSC C15127
Q2, Q3, Q4, Q6, Q8: AO3400A; SOT-23; LCSC C20917
R1: 22k; R_0603_1608Metric; LCSC C31850
R2, R3, R7, R9, R10, R12, R14, R20: 100k; R_0603_1608Metric; LCSC C25803
R4: 120; R_0603_1608Metric; LCSC C22787
R5: 200k; R_0603_1608Metric; LCSC C25811
R6: 51k; R_0603_1608Metric; LCSC C23196
R8: 0.1 1W 1%; R_1206_3216Metric; LCSC C2903496
R11, R13: 10k; R_0603_1608Metric; LCSC C25804
R15: 1k; R_0603_1608Metric; LCSC C21190
R17, R18: 4.7k; R_0603_1608Metric; LCSC C23162
R19: 1M; R_0603_1608Metric; LCSC C22935
RS1A, RS2: 0.05 1W 1%; R_1206_3216Metric; LCSC C2904224
RS1B: 0.22 1W 1%; R_1206_3216Metric; LCSC C6627428
RS3: 0.1 1W 1%; R_1206_3216Metric; LCSC C2903496
RS4, RS5: 0.47 1%; R_1206_3216Metric; LCSC C28320
TP1, TP2, TP3, TP4, TP5, TP6, TP7, TP8: TP; TestPoint_Pad_D1.5mm
U1: CN3791; SSOP-10_3.9x4.9mm_P1.00mm; LCSC C154992
U2, U3, U4, U5, U6, U7: INA226AIDGSR; MSOP-10_3x3mm_P0.5mm; LCSC C49851
U8: ME6211C33M5G-N; SOT-23-5; LCSC C82942

Connections:
3V3: C13.1, C14.1, C20.1, C30.1, C40.1, C50.1, C60.1, C70.1, J5.3, M1X.12 (3V3), R9.2, R10.2, R17.2, R18.2, R20.2, TP5.1, U2.6 (VS), U3.6 (VS), U4.2 (A0), U4.6 (VS), U5.6 (VS), U6.1 (A1), U6.6 (VS), U7.1 (A1), U7.2 (A0), U7.6 (VS), U8.5 (V_{OUT})
BAT+: J2.1, NT8.1, RS2.2, TP3.1
BAT_S: NT8.2, U4.8 (Vbus), U4.9 (Vin-)
CHG_INH: J4.7, M1X.7 (D6/TX), Q4.1 (G), R7.1
CHRG_N: J5.6, M1X.9 (D8/SCK), R9.1, U1.3 (~CHRG)
CN_BAT: NT2.1, R8.2, U1.7 (BAT)
COM: R4.1, U1.5 (COM)
COM_RC: C6.1, R4.2
CSP: L1.2, R8.1, U1.8 (CSP)
DONE_N: J5.5, M1X.10 (D9/MISO), R10.1, U1.4 (~DONE)
DRV: M1.1 (G), U1.10 (DRV)
GND: C1.2, C2.2, C3.2, C4.2, C6.2, C7.2, C8.2, C9.2, C11.2, C12.2, C13.2, C14.2, C15.2, C20.2, C30.2, C40.2, C50.2, C60.2, C70.2, D2.2 (A2), D4.2 (A), D5.2 (A), D6.2 (A2), J2.2, J3.2, J5.2, J6.2, J6.5, J7.2, J8.2, M1X.13 (GND), NT1.2, Q3.2 (S), Q4.2 (S), Q6.2 (S), Q8.2 (S), R3.2, R6.2, R7.2, R14.2, RS4.2, RS5.2, TP6.1, U1.2 (GND), U2.1 (A1), U2.2 (A0), U2.7 (GND), U3.1 (A1), U3.7 (GND), U4.1 (A1), U4.7 (GND), U5.1 (A1), U5.7 (GND), U6.2 (A0), U6.7 (GND), U6.9 (Vin-), U7.7 (GND), U7.9 (Vin-), U8.2 (V_{SS})
LOAD_EN: J4.4, M1X.4 (D3/A3), Q6.1 (G), R14.1
MPPT: Q4.3 (D), R5.2, R6.1, U1.6 (MPPT)
NTC_ADC: C9.1, J3.1, J4.1, M1X.1 (D0/A0), R11.2
NTC_EN: J4.2, M1X.2 (D1/A1), R11.1
PV_EN: J5.4, M1X.11 (D10/MOSI), Q8.1 (G), R20.1
PV_F: F1.2, Q1.3 (D)
PV_IN+: F1.1, J1.1
PV_IN-: D3.2 (A), D4.1 (K), J1.2, NT6.1, Q2.2 (S), RS1B.2
PV_IN_S: NT6.2, U3.9 (Vin-)
PV_MID: NT5.1, Q2.3 (D), RS1A.2, RS1B.1
PV_MID_S: NT5.2, U2.9 (Vin-), U3.10 (Vin+)
PV_RET: NT1.1, RS1A.1, U2.10 (Vin+)
Q1_G: D1.2 (A), Q1.1 (G), R1.1, R19.1
Q2_G: D3.1 (K), Q2.1 (G), Q3.3 (D), R2.2
Q5_G: C10.2, Q5.1 (G), R12.2, R13.1
Q6_D: Q6.3 (D), R13.2
Q8_D: Q8.3 (D), R1.2
RANGE_LO: J5.7, M1X.8 (D7/RX), Q3.1 (G), R3.1
REF1+: J7.1, RS4.1, U6.8 (Vbus), U6.10 (Vin+)
REF2+: J8.1, RS5.1, U7.8 (Vbus), U7.10 (Vin+)
RS2_P: NT3.1, RS2.1, U4.10 (Vin+)
RS3_P: NT4.1, RS3.1, U5.10 (Vin+)
SCL: J4.6, M1X.6 (D5/SCL), R18.1, TP8.1, U2.5 (SCL), U3.2 (A0), U3.5 (SCL), U4.5 (SCL), U5.5 (SCL), U6.5 (SCL), U7.5 (SCL)
SDA: J4.5, M1X.5 (D4/SDA), R17.1, TP7.1, U2.4 (SDA), U3.4 (SDA), U4.4 (SDA), U5.2 (A0), U5.4 (SDA), U6.4 (SDA), U7.4 (SDA)
SW: D5.1 (K), L1.1, M1.3 (D)
SYNC_J6: J6.3, R15.2
SYNC_OUT: J4.3, M1X.3 (D2/A2), R15.1
VG: C5.1, U1.1 (VG)
VLOAD: C11.1, D6.1 (A1), J6.1, NT10.1, Q5.3 (D), TP4.1
VLOAD_S: NT10.2, U5.8 (Vbus)
VL_IN: C10.1, NT9.1, Q5.2 (S), R12.1, RS3.2
VL_IN_S: NT9.2, U5.9 (Vin-)
VPV: C1.1, C2.1, C3.1, C4.1, C5.2, C15.1, D1.1 (K), D2.1 (A1), M1.2 (S), NT7.1, Q1.2 (S), R19.2, TP1.1, U1.9 (VCC)
VPV_S: NT7.2, R2.1, R5.1, U2.8 (Vbus), U3.8 (Vbus)
VSYS: C7.1, C8.1, C12.1, NT2.2, NT3.2, NT4.2, TP2.1, U8.1 (V_{IN}), U8.3 (CE)

Notes on the sheet:
INPUT: fuse u00b7 reverse-polarity P-MOS u00b7 TVS
PANEL CURRENT (low side, auto-ranged)
CN3791 MPPT CHARGER V_MPPT = 6.40 V, I_CH = 1.2 A
BATTERY u00b7 NTC
LOAD SWITCH u2192 CHEST CABLE J6
3.3 V RAIL
INA226 u00d7 6 (I2C 0x40u20130x45)
MCU: XIAO nRF52840 Sense (plug-in)
TEST POINTS
MECHANICAL
PWR_FLAG: supplies sourced by connectors / battery

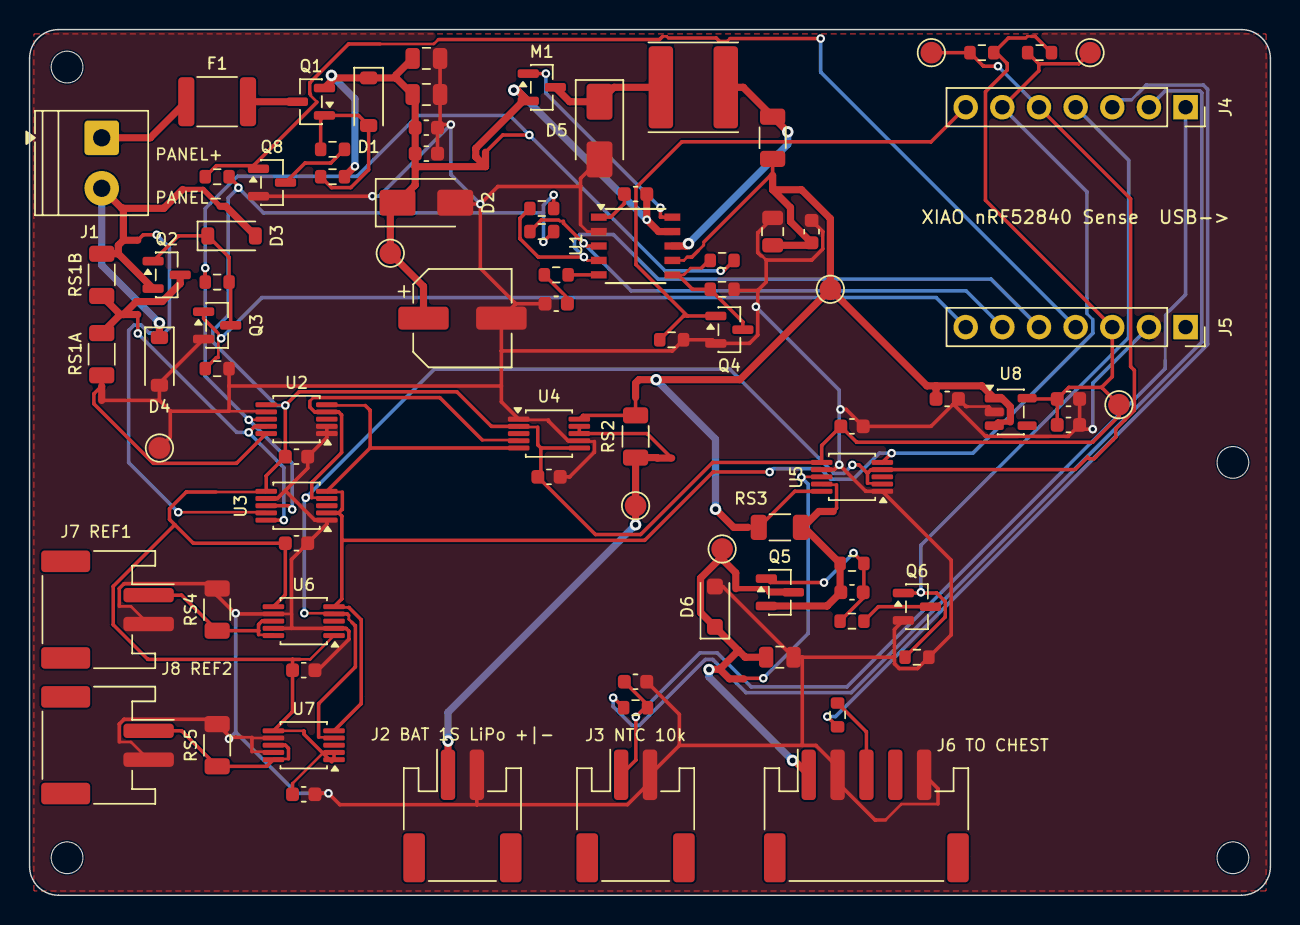
[picture p138: board pmbh.kicad_pcb from above]

Board: 2 copper layers, 86.0 x 60.0 mm, 100 parts (0 on the bottom side), 47 nets.
