3351666087/solar-vest/(commit log)

2026-10-21 Solar Vest: self-powered solar-harvesting wearable ECG, design package
    Architecture documents (v1 to v3.1), toolchain research and component
    models. Manufacturing package: PCBs (KiCad + SKiDL, JLC fab files),
    18 printed parts (v2), vest patterns, harness, ngspice simulation,
    the Solar Vest Explorer 3D web app and all generator/verification code.
    Personal identifiers are removed; body-scan data is published with the
    owner's consent. Third-party notices are in THIRD_PARTY_NOTICES.md.
    [1_Plugged_Bot_4.0.stl, 1_Plugged_Bot_v1.0_offset_0375.stl, 2_Plugged_Top_v1.2.stl, PulseSensor_Housing.scad, PulseSensor_Housing.stl, back_pod_base.3mf, back_pod_base.step, back_pod_base.stl]
2026-10-28 Translate repository to English, add bench bring-up firmware and remote console
    - Rename every Chinese path to an English layout: docs/, hardware/ (pcb,
    enclosures, vest, wiring), simulation/, tools/cad/, viewer/, explorer/,
    modeling/, body/, research/; pdf/ is now English-only.
    - Translate all documents, code comments, UI strings, generator output text
    and SVG labels to English; fix links to the new paths.
    - Add firmware: XIAO nRF52840 PMB-H controller v2 (BLE telemetry/commands,
    battery lockout, temperature inhibit, night PV cut-off, auto range,
    persisted autoload, keepalive) and the bench bring-up sketch.
    - Add software: remote console server + web UI (stdlib Python, SSE, Web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
    [1_Plugged_Bot_4.0.stl, 1_Plugged_Bot_v1.0_offset_0375.stl, 2_Plugged_Top_v1.2.stl, PulseSensor_Housing.scad, PulseSensor_Housing.stl, back_pod_base.3mf, back_pod_base.step, back_pod_base.stl]
